moein98/heimdall/MACH3_SIMPLE/README.md

# MACH3-SIMPLE (revision A1)

A Mach3 parallel-port breakout board: six buffered step/dir axes, six 24 V
sensor inputs, a handwheel switched between jog and THC, six relays driven
over RS232 by an ATmega328P, and an isolated 0-10 V spindle-speed output with
FWD / REV for a VFD. It reproduces a board already in service and matches its
connector positions. It takes one supply, 24 V; the 5 V rail is made on the
board. Apart from the VFD port there is no galvanic isolation.

| Folder | What is in it |
|---|---|
| `fab/` | **What goes to the board house.** `MACH3SIMPLE-gerbers.zip` (2 layers, 1.6 mm FR4, 1 oz, 150.5 x 137.9 mm), BOM, pick-and-place, PDFs |
| `hardware/` | The KiCad 10 project: `MACH3SIMPLE.kicad_pro` |
| `firmware/` | AVR C source; `build/mach3simple.hex` is the built firmware |
| `docs/` | `SPEC.md` - what the board is and why; `COMMISSIONING.md` - bring-up and test, step by step (Persian) |
| `tools/` | The scripts that generate, check and route the design |
| `review/` | ERC/DRC reports, netlist, schematic PDF, board renders |

## What changed from A0

| | A0 | A1 |
|---|---|---|
| Supplies | 5 V and 24 V, each on its own terminal | **24 V only.** An LM2596S-5.0 buck (`U4`) makes +5V, in the top-right corner beside the 24 V input |
| Relay drivers | 2N7002 drain and source swapped - every relay **stuck on** | Fixed. `check_design.py` now checks every MOSFET's source is on ground |
| Top-edge terminal legends | Printed in reverse: `+24` over 0V, `+5` over the handwheel's B, `EMG` over X home | Fixed: the signals follow the legends, which follow the board in service |
| Input optocouplers | PC847 on a SOIC-16 footprint, which no PC847 fits | SMD DIP-16 (2.54 mm), the package PC847 comes in |
| Opto LED protection | Promised in the notes, missing from the circuit | A reverse diode across every input LED (`D20`-`D25`) |
| Spindle | - | **New:** isolated 0-10 V (`AVI`/`ACM`) and FWD/REV/AUX (`FWD`/`REV`/`AUX`/`DCM`) on `J5`, from port 2 pins 7, 8, 9, 6 |

A1 then had a design review of its own, which added:

| | |
|---|---|
| Relay terminals | legends printed on the back (`RELAY A`, `NO COM NC` under each screw) and `RELAY A`-`F` on the front; A0/A1 had them on F.Fab only, which is not printed |
| Relay LED resistors | 10k instead of 4k7 - 4k7 on 24 V was 103 mW in a 100 mW 0603 |
| Axis buffers | 74AC245 (same pads): 24 mA per output for opto-input drivers |
| Sensor supply | `J4` is four screws: `+24 0V` for the sensors (fused) and `+24 0V` in |
| C2 | 47 uF 50 V - a 100 uF 50 V part does not come in a 6.3 x 7.7 can |
| Labels | `5V`, `24V`, `SERIAL`, relay letters, `10V ADJ` instead of bare designators; a dashed line round the isolated VFD side |
| Test points | `GND` `5V` `24V`, and on the VFD side `ACM` `12V` `AVI` |
| Buck switch node | drawn by hand on the top layer, 14 mm and no vias (was 17 mm with two) |
| Handwheel +5 V | through a 200 mA resettable fuse (`F3`) |
| MCU reset | 10 nF against relay noise |
| VFD `AUX` | the spare optocoupler channel as a fourth VFD contact, port 2 pin 6 |

## Regenerating

The schematic and board are generated by scripts, not drawn by hand. To change
the design, edit `tools/build_project.py` or `tools/build_pcb.py` and
regenerate; an edit made in KiCad is lost at the next regeneration.

    python tools/build_project.py                  # schematic
    D:/KiCad/bin/python.exe tools/build_pcb.py --force   # placement (discards routing)
    D:/KiCad/bin/python.exe tools/autoroute.py export    # then Freerouting, then:
    D:/KiCad/bin/python.exe tools/autoroute.py import
    D:/KiCad/bin/python.exe tools/autoroute.py vfd-export  # then Freerouting on the _vfd DSN
    D:/KiCad/bin/python.exe tools/autoroute.py vfd-import
    D:/KiCad/bin/python.exe tools/autoroute.py stitch
    KICAD_CLI=D:/KiCad/bin/kicad-cli.exe sh tools/validate.sh
    KICAD_CLI=D:/KiCad/bin/kicad-cli.exe sh tools/fab.sh

`build_pcb.py` needs the netlist that `validate.sh` exports (`review/net.net`),
so after a schematic change run `validate.sh` once before placing. It prints
which signal lands under each word of every top-edge legend - read those lines.

## Firmware

`sh firmware/build.sh` runs the tests and builds the hex;
`sh firmware/build.sh flash` also sets the fuses and programs the chip through
the ICSP header `J60` with a USBasp. Serial is 9600 8N1. Commands, sent with
Mach3's `SendSerial`: `A`-`F` relay on, `a`-`f` off, `T` handwheel to THC,
`t` handwheel to jog, `?` status. A1 needs no firmware change.

## Spindle, in Mach3

Port 2 pin 7 is the spindle PWM pin (PWMBase Freq 100 Hz), pin 8 is Output #1
(M3, FWD) and pin 9 Output #2 (M4, REV), all active high. Trim `RV1` for
10.0 V at full PWM. Pin 6 can be Output #3, for `AUX`. `docs/COMMISSIONING.md`,
steps 6 to 8, has the settings.

`mach3 rs232 inputs 6 outputs 6 - pulse 5v - pnp sens.pdf` is the assembly
drawing of the board in service that the layout was copied from.
