moein98/heimdall/MACH3_SIMPLE_ETH/docs/SPEC.md

# MACH3-SIMPLE-ETH - specification (draft 0)

MACH3-SIMPLE with the parallel ports replaced by Ethernet. The PC no longer
makes step pulses: an RP2350B on the board runs grblHAL, plans the motion and
makes the pulses itself, and the PC (or a tablet, or nothing, from SD card)
only sends G-code and shows status.

This draft fixes the architecture and the pin map, proves the pin map with a
real grblHAL build (`firmware/grblHAL/build.sh`), and has a schematic
(`hardware/`, generated by `tools/build_project.py`) that passes ERC and is
checked against the board map GPIO by GPIO. There is no board layout yet.

## What it keeps from A1

- 24 V single supply, 5 V made on board (LM2596S-5.0), same input terminal.
- Opto-isolated 24 V sensor inputs (PC847, reverse diode across each LED).
- Buffered 5 V step/dir outputs on 3-way terminals, PUL / 0V / DIR.
- Six relays with their terminal legends.
- The isolated VFD port: 0-10 V (`AVI`/`ACM`), `FWD`, `REV`, `AUX`, `DCM`,
  B2412S isolated supply, PC847 across the barrier, LM358 output, `RV1` trim.
- Handwheel, switchable between jog and THC.

## What changes

| | A1 | ETH |
|---|---|---|
| Link to the PC | two LPT ports + RS232 | **Ethernet** (W5500, 10/100), plus USB-C for setup |
| Motion | Mach3 on the PC | **grblHAL on the board**; PC runs any sender, or none |
| Axes | 6 | **8 independent, coordinated**: X Y Z A B C U V |
| Relays | ATmega328P over RS232, `SendSerial` | MCP23017 over I2C, G-code `M62`-`M65` |
| Spindle | 0-10 V from LPT PWM | same 0-10 V, **plus RS485 Modbus** for VFDs that take it |
| THC | handwheel lines to Mach3 | grblHAL plasma plugin: Arc OK, THC up, THC down |
| Handwheel | A/B lines to Mach3 | a small MCU reads it and jogs grblHAL over UART (MPG mode 2) |
| Stand-alone | no | SD card: run a job with no PC |
| UI | Mach3 | any grblHAL sender, the built-in web UI, or our own |

The ATmega328P and MAX232 go. So do the LPT connectors and the pull-ups on
their lines.

## Firmware

grblHAL, RP2040/RP2350 driver, board map `firmware/grblHAL/boards/my_machine_map.h`.
Built with `N_AXIS=8` and:

| Option | Setting | For |
|---|---|---|
| `ADD_ETHERNET` + `_WIZCHIP_ 5500` | on | Telnet (23), WebSocket, FTP |
| `WEBUI_ENABLE 3` | on | ESP3D-WebUI served from the board's flash |
| `SDCARD_ENABLE 1` | on | jobs from SD |
| `SPINDLE0` / `SPINDLE1` | `PWM0` / `MODVFD` | 0-10 V spindle, Modbus spindle; picked with `$395` |
| `MODBUS_ENABLE 2` | stream 0, DE/RE on aux out 0 | RS485 |
| `MPG_ENABLE 2`, `MPG_STREAM 1` | UART1 | handwheel MCU; `0x8B` toggles MPG mode |
| `PLASMA_ENABLE 1` | on | THC |
| `MCP23017_ENABLE 1` | port A out, port B in | relays, spare inputs |

Checked in the build, not only in the source: `N_MOTORS == 8`,
`MPG_STREAM == 1`, `MODBUS_RTU_STREAM == 0`, V axis on GP9 / GP17 / GP33, and
the plasma, MCP23017, WebUI, SD, W5500, Telnet, WebSocket, FTP and Modbus
code all linked in. Flash 527 KB, RAM 110 KB static, of 520 KB.

`N_AXIS` must come from CMake (`-DN_AXIS=8`, `cmake-n-axis.patch`), not from
`my_machine.h`. Some driver files include `grbl.h` before `my_machine.h` and
were built for 3 axes when it was set there - the image was 25 KB smaller and
would have mixed 3-axis and 8-axis structures.

## RP2350B pin map

All 48 GPIO are used. Pins that grblHAL needs consecutive are marked.

| GPIO | Signal | Notes |
|---|---|---|
| 0, 1 | UART0 TX, RX | RS485 transceiver, Modbus VFD |
| 2-9 | STEP X Y Z A B C U V | PIO, **consecutive** |
| 10-17 | DIR X Y Z A B C U V | **consecutive** (`GPIO_SHIFT10`) |
| 18 | ENABLE | all drivers |
| 19 | SD CS | |
| 20-23 | SPI0 MISO, W5500 CS, SCK, MOSI | W5500 and SD share SPI0 |
| 24 | W5500 INT | |
| 25 | RS485 DE/RE | aux output 0 |
| 26-33 | LIMIT X Y Z A B C U V | |
| 34 | E-STOP | grblHAL reset input |
| 35 | FEED HOLD | |
| 36 | CYCLE START | |
| 37 | PROBE | |
| 38 | ARC OK | plasma plugin |
| 39 | THC UP | plasma plugin |
| 40 | THC DOWN | plasma plugin |
| 41 | SPINDLE PWM | to the isolated 0-10 V stage |
| 42, 43 | UART1 TX, RX | handwheel MCU |
| 44 | SPINDLE ENABLE | VFD `FWD` |
| 45 | SPINDLE DIR | VFD `REV` |
| 46, 47 | I2C1 SDA, SCL | MCP23017, optional FRAM |

W5500 reset is on the board reset, so it needs no GPIO. Every alternate
function above was checked against the SDK's pin-function table
(`io_bank0.h`): UART0 on 0/1, UART1 on 42/43, SPI0 on 20-23, I2C1 on 46/47.
GP44/45 look like UART1 by the RP2040 pattern but are UART0 on the
RP2350B - the first draft had that wrong.

MCP23017 port A: relays A-F, spindle `AUX`, status LED. Port B: 8 spare
inputs (door, tool setter, ...).

## Circuit notes for the schematic

- **3.3 V logic.** The RP2350 is a 3.3 V part. A1's 74AC245 and 74HC14 see
  3.3 V as low-ish (V<sub>IH</sub> 3.5 V at 5 V supply). Use **74ACT245**
  (TTL thresholds, 24 mA) for step/dir, three of them for 17 lines, and
  **74HCT14** in the spindle channel.
- **Inputs.** 15 opto inputs (8 limits, E-stop, hold, start, probe, Arc OK,
  THC up, THC down) = four PC847, one channel spare. Pull-ups to **3.3 V**,
  not 5 V.
- **Relays.** MCP23017 on 3.3 V gives a 3.3 V gate: use a logic-level FET
  (AO3400A class) instead of 2N7002.
- **Power.** 24 V -> LM2596S-5.0 (as A1) -> 3.3 V LDO, 800 mA class. W5500
  alone is about 130 mA. The RP2350's core supply is its internal switcher:
  3.3 uH inductor and the layout from the RP2350 hardware design guide.
- **Clock and flash.** 12 MHz crystal, W25Q128 (16 MB) QSPI flash, matching
  the `pimoroni_pga2350` board file the firmware is built with.
- **Ethernet.** W5500, 25 MHz crystal, a magjack with integrated magnetics
  (HR911105A class), the W5500 reference layout for the differential pairs.
- **Handwheel.** A small MCU (an RP2040, or an ATmega328P as on A1) reads the
  quadrature wheel and axis/step switches and sends jog commands on UART1.
  grblHAL's RP driver has no quadrature input of its own for this.
- **ESD / EMC.** TVS on the Ethernet and RS485 lines; the RS485 port gets a
  termination jumper.

## LinuxCNC

Remora (LinuxCNC firmware for microcontrollers) has no RP2350 port. Its
RP2040 + W5500 port builds for RP2350A and RP2350B after renaming three
interrupt constants (`firmware/remora/remora-rp2350.patch`). It is untested on
hardware, its pins would need remapping to this board, and its step
generator tops out near 20 kHz per axis (40 kHz base thread) against grblHAL's
hundreds of kHz from PIO. It is an option for later, not a design goal.

## Licences

grblHAL is GPLv3: firmware shipped on a board must come with its source. A
UI that talks to the board over the network is a separate program and is not
bound by that. Reference designs looked at: PicoCNC (MIT), PicoBOB-DLX and
Flexi-HAL (CERN-OHL-S, copying circuits from them makes this board
CERN-OHL-S too). Nothing has been copied from them. The RP2350 and W5500
circuits follow WIZnet's published W5500-EVB-Pico2 reference schematic and
Raspberry Pi's minimal design - vendor reference circuits, drawn anew here.
RP23CNC (licence unstated) was read for approach only.

## Schematic (ETH-0)

Eight sheets, 337 parts, 291 nets, generated by `tools/build_project.py` in the
style of A1 (every pin to a global label; symbols from KiCad's own library).

| Sheet | Contents | Reference |
|---|---|---|
| 1 Power | 24 V in, fuse, reverse diode, TVS (A1); LM2596S-5.0 (A1); AP7361C 3.3 V LDO; USB VBUS into +5V through a Schottky; rail LEDs; chassis 1 nF 2 kV | A1, W5500-EVB-Pico2 |
| 2 MCU | RP2350B, internal core regulator (3.3 uH), 12 MHz crystal, W25Q128 16 MB flash, RESET/BOOTSEL, USB-C with USBLC6, SWD, microSD | Raspberry Pi minimal design as W5500-EVB-Pico2 applies it |
| 3 Ethernet | W5500, 25 MHz crystal, ferrite-fed +3V3A, 49.9R/3.3R terminations, HR911105A magjack | W5500-EVB-Pico2 |
| 4 Outputs | three 74ACT245 on 5 V, 8 x STEP/GND/DIR terminals, ENABLE terminal, 10k pull-downs | A1; RP23CNC for 3.3 V into ACT/AHCT |
| 5 Inputs | 15 PC847 channels (4k7, anti-parallel diode, 4k7 to +3V3, 10 nF); LIMITS 8-way, EST HLD RUN PRB, THC AOK UP DN | A1 |
| 6 Relays | MCP23017 (0x20): relays A-F, spindle AUX, status LED, 8 spare inputs on a 2x5 header; AO3400A drivers; six A1 relay channels | A1 |
| 7 Spindle | the A1 isolated VFD block, 74HCT14 in front | A1 |
| 8 Comms | MAX3485 RS485 with 120R solder jumper and NUP2105L; ATmega328P at 3.3 V / 8 MHz for the MPG pendant (A/B, 8 axis selects, x1/x10/x100) on a 2x8 IDC | - |

`tools/validate.sh` (in the KiCad 10 container) runs:

- **ERC:** 0 errors. "Multiple net names" is treated as an error: it is KiCad's
  only report of two labelled nets joined by a stray wire. The first draft had
  two - power flags drawn with a bare wire had joined +1V1 to +3V3 and +3V3A to
  GND - and they are why the flags now go through the same collision-checked
  stub as every other pin. One accepted warning: MAX3485 is a derived symbol
  (`extends LTC2850xS8`) and is embedded flattened.
- **`check_pinmap.py`:** reads the netlist and the grblHAL board map and
  compares all 48 GPIO. It then follows 62 signals to the pins they must reach
  (SPI to the W5500 and the SD card, UART1 to the handwheel MCU's RXD/TXD, each
  STEP/DIR through a buffer to its terminal, each input to its opto, pull-up
  and filter, the relays to GPA0-5, ...) and fails on any net with one node.
  Tested by breaking it: swapping GP42/43 in the netlist and moving
  `AUXINPUT4_PIN` in the board map both fail it.

Every power pin of the RP2350B, W5500, MCP23017, flash and ATmega was also
checked in the netlist to land on its own rail.

### Open points for the layout and the first build

- **W5500 RSVD pins** (23, 38-42) go to GND. KiCad types them as inputs and
  the datasheet asks for GND; WIZnet's own W5500-EVB-Pico2 leaves them open.
  Safe either way for an input - worth a look at the datasheet before layout.
- **USB-only power** back-feeds the LM2596's output at about 4.7 V. Fine for
  flashing; the buck's datasheet should be checked for reverse current into
  VIN, or a second Schottky added in the buck output.
- **Probe input** is a 24 V opto channel like the others. A 5 V touch plate
  needs its own supply or a separate low-voltage input.
- **RP2350 layout** goes by the hardware design guide: the regulator loop
  (pins 62-65, L201, C201, C202) and the crystal are the parts that bite.

## Next

1. Board layout: same 24 V corner and VFD corner as A1; Ethernet and USB
   where the LPT ports were.
2. Handwheel MCU firmware (ATmega328P, UART1 to grblHAL, MPG mode 2).
3. Our own UI: can start now against the grblHAL simulator, before hardware.
