moein98/heimdall/MACH3_SIMPLE/review/layout_bottom.png

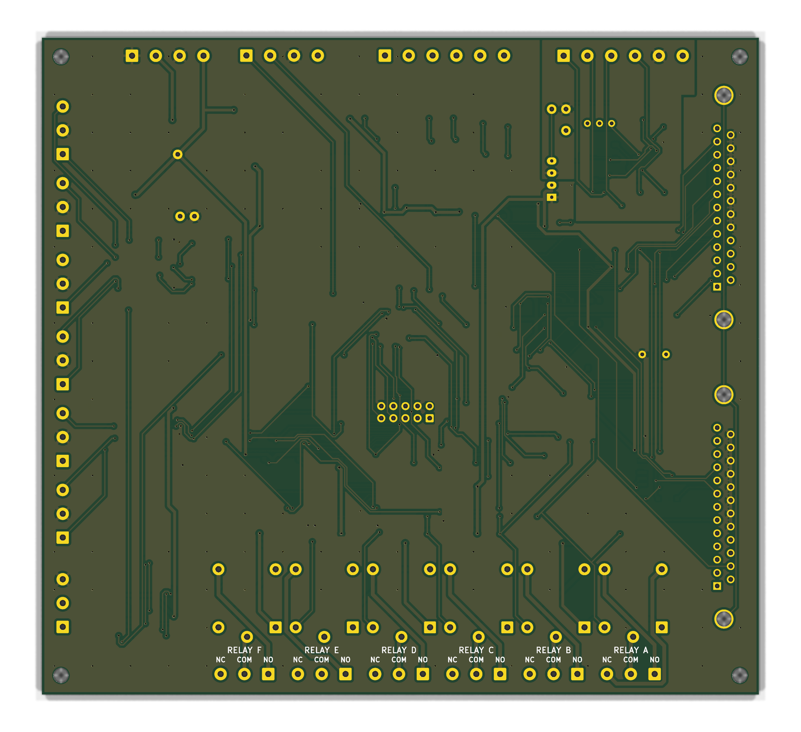
MACH3_SIMPLE/review/layout_bottom.png
