moein98/heimdall/MACH3_SIMPLE/review/layout_top.png

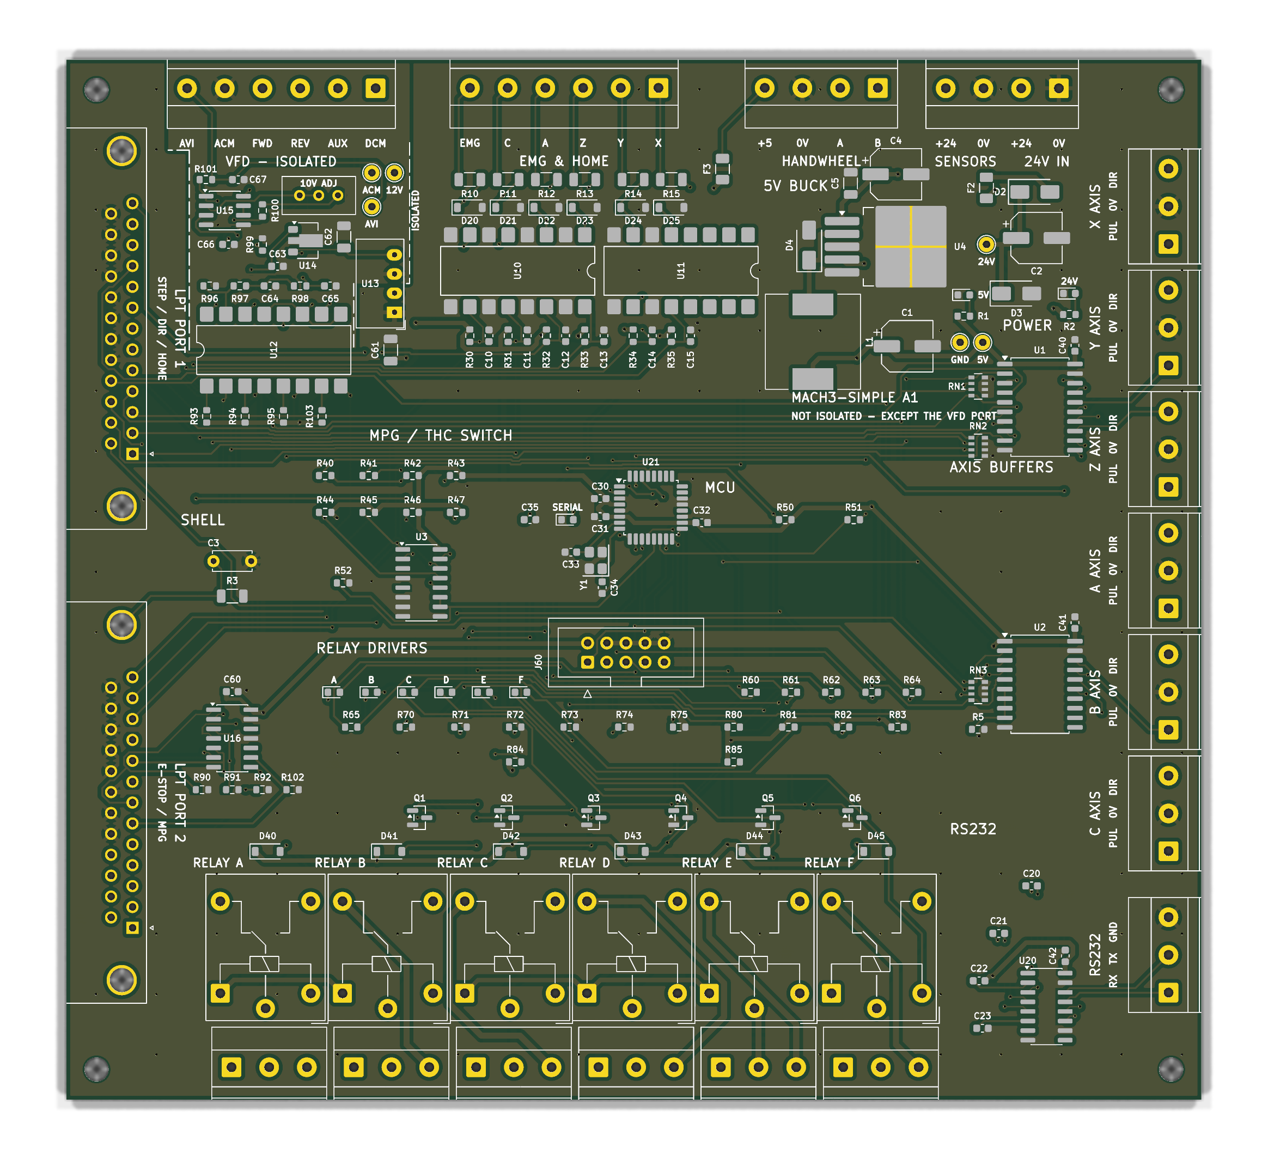
MACH3_SIMPLE/review/layout_top.png
