moein98/heimdall/MACH3_SIMPLE/docs/COMMISSIONING.md

# MACH3-SIMPLE A1 — راه‌اندازی و تست

این برد هنوز ساخته نشده. ترتیب زیر برای این است که اگر چیزی خراب بود، **در هر مرحله فقط یک چیز بتواند خراب باشد**. همه را با هم وصل و روشن نکنید.

برد دو نیمه دارد که جدا تست می‌شوند:

- **نیمهٔ الف — بدون فرم‌ور.** تغذیه (۲۴ ولت و باک ۵ ولت)، شش ورودی، شش خروجی محور، مسیر دسته‌فرمان، لایهٔ فیزیکی RS232، و خروجی اسپیندل (۰ تا ۱۰ ولت و FWD/REV). همهٔ این‌ها مدار خالص‌اند و **به محض مونتاژ قابل تست‌اند**، حتی با MCU خالی.
- **نیمهٔ ب — با فرم‌ور.** شش رله و سوییچ دسته‌فرمان بین jog و THC. فرم‌ور در `firmware/` است و از هدر `J60` با USBasp روی MCU ریخته می‌شود.

> **در این سند ترمینال‌ها با نوشتهٔ روی برد (سیلک) نام برده می‌شوند، نه با شمارهٔ پین.** روی ترمینال‌های لبهٔ بالا شمارهٔ پین از راست به چپ است؛ نوشتهٔ زیر هر پیچ ملاک است.

---

## وسایل لازم

| | |
|---|---|
| مولتی‌متر | ولت DC، اهم، تست دیود، و بوق اتصال |
| منبع تغذیه با محدودکنندهٔ جریان | **فقط ۲۴ ولت**. **محدودکننده ضروری است** |
| یک سیم جامپر و یک مقاومت 1k | برای شبیه‌سازی سیگنال‌ها بدون PC |
| PC با پورت موازی و Mach3 | برای مرحلهٔ ۸ |
| مبدل USB به RS232 | برای نیمهٔ ب |
| USBasp و کابل ۱۰ پایه | برای ریختن فرم‌ور، مرحلهٔ ۹ |
| اسیلوسکوپ | اختیاری؛ برای دیدن پالس‌های PUL و گره SW باک |

---

## یک نکته دربارهٔ ولتاژها

برد فقط **یک** تغذیه می‌گیرد: ۲۴ ولت روی ترمینال `J4`. ترمینال ۵ ولت نسخهٔ قبل حذف شده؛ ۵ ولت را باک `U4` (LM2596S-5.0) روی خود برد می‌سازد.

`J4` چهار پیچ دارد، چپ به راست: `+24` `0V` زیر نوشتهٔ **SENSORS**، و `+24` `0V` زیر نوشتهٔ **24V IN**.
- **24V IN** (دو پیچ راست): سیم منبع تغذیه. همان جای ترمینال ۲۴ ولت برد قبلی.
- **SENSORS** (دو پیچ چپ): تغذیهٔ سنسورهای PNP. این ۲۴ ولت از فیوز `F2` و دیود `D2` رد شده، پس اتصال کوتاه در کابل سنسور فیوز را می‌سوزاند، نه منبع را.

**نقطه‌های تست** (حلقه‌های مسی با نوشته): `GND`، `5V` و `24V` در گوشهٔ تغذیه؛ `ACM`، `12V` و `AVI` در بخش ایزولهٔ VFD.

| ریل | روی برد | کجا اندازه بگیرید |
|---|---|---|
| ۲۴.۰ V روی `24V IN` | **حدود ۲۳.۶ V** (افت دیود سری `D2`) | نقطهٔ تست `24V` نسبت به `GND` |
| +5V | **۴.۸ تا ۵.۲ V** | نقطهٔ تست `5V` نسبت به `GND` |
| سمت VFD (ایزوله) | **۱۲ تا ۱۴ V** | نقطهٔ تست `12V` نسبت به نقطهٔ تست `ACM` — **نه** GND برد |

> بخش اسپیندل از بقیهٔ برد **ایزوله** است. زمین آن (`ACM` و `DCM` روی `J5`) به GND برد وصل نیست. برای اندازه‌گیری در این بخش، سیم منفی مولتی‌متر را روی `ACM` بگذارید.

---

## مرحلهٔ ۰ — بدون برق

**بازرسی چشمی:**
- جهت خازن‌های الکترولیتی `C1`، `C2` و `C4` (علامت + روی سیلک)
- جهت دیودهای `D2`، `D3` و **`D4`** (نوار روی بدنه). `D4` دیود باک است؛ اگر برعکس باشد، با اولین روشن شدن ۲۴ ولت را اتصال کوتاه می‌کند
- پین ۱ همهٔ آی‌سی‌ها: `U1`، `U2`، `U3`، `U10`، `U11`، `U12`، `U14`، `U15`، `U16`، `U20`، `U21`
- `U13` (ماژول ایزوله B2412S): پین ۱ روی پد مربعی
- لحیم پین‌های ریز `U21` (MCU، گام ۰.۸ میلی‌متر) — زیر ذره‌بین، دنبال پل لحیم

**اهم‌متر:**

| بین | باید | اگر نبود |
|---|---|---|
| دو سر `C2` (V24 و GND) | اول کم، بعد بالا می‌رود (خازن شارژ می‌شود)؛ آخرش بالای ۱ کیلواهم | اتصال کوتاه روی ۲۴ ولت |
| دو سر `C1` (+5V و GND) | همان | اتصال کوتاه روی +5V — معمولاً پل لحیم روی یک آی‌سی |
| +5V و V24 | اتصال کوتاه نباشد | خیلی جدی — روشن نکنید |
| نقطهٔ تست `ACM` و نقطهٔ تست `GND` | **باز** (چند مگااهم یا بیشتر) | ایزولاسیون بخش اسپیندل شکسته؛ دنبال پل لحیم دور `U12`/`U13` بگردید |
| پیچ `DCM` روی `J5` و نقطهٔ تست `GND` | **باز** | همان |

---

## مرحلهٔ ۱ — روشن کردن با ۲۴ ولت

منبع را روی **۲۴ V با محدودیت ۲۰۰ mA** بگذارید و به دو پیچ راست `J4` (زیر **24V IN**) وصل کنید.

| انتظار | اگر نبود |
|---|---|
| جریان **۲۰ تا ۶۰ mA** | اگر بلافاصله به سقف ۲۰۰ رسید: فوراً قطع کنید. اول جهت `D4`، بعد `C1`/`C4`، بعد پل لحیم |
| LED با نوشتهٔ `24V` و LED با نوشتهٔ `5V` روشن | `D11` خاموش: `F2`/`D2`. `D10` خاموش: باک — `U4`، `L1`، `D4` |
| دو سر `C2`: حدود **۲۳.۶ V** | خیلی کمتر: `D2` برعکس |
| نقطهٔ تست `5V`: **۴.۸ تا ۵.۲ V** | صفر: `U4` کار نمی‌کند (پین ۵ باید به زمین لحیم باشد) یا `L1` لحیم نیست |
| **هیچ رله‌ای صدا نمی‌دهد**، `D50` تا `D55` خاموش | با MCU خالی، `R70` تا `R75` گیت ماسفت‌ها را پایین نگه می‌دارند. اگر رله‌ای روشن شد، جهت `Q` یا مقاومت گیتِ همان کانال را ببینید |
| سمت VFD: نقطهٔ تست `12V` نسبت به `ACM` حدود **۱۲ تا ۱۴ V**؛ دو سر `C63` **۵.۰ V** | صفر: `U13` (ماژول ایزوله) یا `U14` |
| نقطهٔ تست `AVI` نسبت به `ACM`: **۰ V** | اگر ولتاژ دارد: کانال PWM بی‌جهت روشن است — `R90`، `U16` |

> در نسخهٔ A0 روی این مرحله هر شش رله روشن می‌شدند و خاموش نمی‌شدند (ماسفت‌ها برعکس بودند). در A1 اصلاح شده و `tools/check_design.py` جلوی تکرارش را می‌گیرد.

---

## مرحلهٔ ۲ — ورودی‌ها، بدون PC

هر ورودی وقتی ۲۴ ولت رویش باشد، پینِ متناظر روی پورت موازی را **پایین** می‌کشد.

مولتی‌متر را بین پینِ DB25 و GND بگذارید (منفی روی نقطهٔ تست `GND`). در حالت عادی باید حدود **۵.۰ V** ببینید. حالا با سیم جامپر، ۲۴ ولت (پیچ `+24` زیر **SENSORS**) را به پیچ مربوط روی `EMG & HOME` وصل کنید — ولتاژ باید به **زیر ۰.۳ V** بیفتد.

| پیچ روی `EMG & HOME` (چپ به راست) | پورت | پین DB25 |
|---|---|---|
| `EMG` | پورت ۲ (`J2`) | 15 |
| `C` | پورت ۱ (`J1`) | 15 |
| `A` | پورت ۱ (`J1`) | 13 |
| `Z` | پورت ۱ (`J1`) | 12 |
| `Y` | پورت ۱ (`J1`) | 11 |
| `X` | پورت ۱ (`J1`) | 10 |

هر ورودی فعال حدود **۴.۸ mA** از ۲۴ ولت می‌کشد. سنسور PNP شما باید این جریان را بدهد.

> **این برد برای ورودی‌ها LED ندارد.** وضعیت ورودی‌ها را با مولتی‌متر یا صفحهٔ Diagnostics در Mach3 ببینید.

---

## مرحلهٔ ۳ — خروجی محورها، بدون PC

**اول، بدون هیچ چیزی روی پورت ۱:** همهٔ پیچ‌های PUL و DIR روی ترمینال‌های محور باید **۰ V** باشند. این مقاومت‌های pull-down (`RN1` تا `RN3`) را تست می‌کند — همان‌هایی که جلوی پالس ساختگی را وقتی PC خاموش است می‌گیرند.

**بعد، هر کانال:** یک سیم با **مقاومت ۱ کیلواهم سری** از نقطهٔ تست `5V` به پینِ DB25 بزنید. پیچ متناظر روی ترمینال محور باید به **حدود ۵.۰ V** برود.

| محور | ترمینال | DB25 (`J1`) پین PUL | DB25 پین DIR |
|---|---|---|---|
| X | `J10` | 1 | 2 |
| Y | `J11` | 3 | 4 |
| Z | `J12` | 5 | 6 |
| A | `J13` | 7 | 8 |
| B | `J14` | 9 | 14 |
| C | `J15` | 17 | 16 |

روی هر ترمینال محور، نوشتهٔ کنار پیچ‌ها: `PUL`، `0V`، `DIR`.

> **بافرها `74AC245` هستند، نه `74HC245`.** ورودی اپتوی درایورهای استپر ۱۰ تا ۱۵ mA می‌کشد و 74HC245 برای هر خروجی حدود ۶ mA و برای کل تراشه ۷۰ mA طراحی شده؛ هشت خروجی از آن بیشتر است. 74AC245 همان پایه‌ها را دارد و هر خروجی ۲۴ mA می‌دهد. اگر فقط 74HC245 پیدا کردید، درایورهایی را که کمتر از ۶ mA می‌کشند می‌توانید با آن راه بیندازید.

---

## مرحلهٔ ۴ — دسته‌فرمان، بدون فرم‌ور

با MCU خالی، `R52` خط انتخاب (`MPG_SEL`) را پایین نگه می‌دارد، پس دسته‌فرمان در **حالت jog** است: A به پورت ۲ پین ۱۲ می‌رود و B به پین ۱۳.

- `J2` پین ۱۲ و ۱۳ در حالت عادی: **۵.۰ V**
- پیچ `A` روی `HANDWHEEL` را به زمین وصل کنید → `J2` پین ۱۲ به **حدود ۰.۲ V** می‌افتد
- پیچ `B` را به زمین وصل کنید → `J2` پین ۱۳ همین‌طور
- `J2` پین ۱۰ و ۱۱ (THC) باید در تمام این مدت **۵.۰ V بمانند**

اگر به‌جای ۱۲/۱۳، پین‌های ۱۰/۱۱ تکان خوردند، خط انتخاب بالاست: `R52` لحیم نشده، یا `MPG_SEL` به +5V اتصال دارد.

> در A0 نوشته‌های این ترمینال برعکس چاپ شده بود (`+5` روی پیچ B). اگر انکودر را از روی یک بورد A0 سیم‌کشی کرده‌اید، دوباره نگاه کنید.

---

## مرحلهٔ ۵ — RS232، فقط لایهٔ فیزیکی

بدون فرم‌ور هم می‌شود دید که MAX3232 زنده است:

| کجا | انتظار | معنی |
|---|---|---|
| `U20` پین ۲ (V+) | حدود **+۵.۵ V** | پمپ بار کار می‌کند |
| `U20` پین ۶ (V−) | حدود **−۵.۵ V** | همان |
| پیچ `TX` روی `J50` نسبت به `GND` | حدود **−۵.۵ V** | خط در حالت بیکار (mark) است |

اگر V+ یا V− صفر بود، یکی از خازن‌های پمپ (`C20` تا `C23`) لحیم نشده یا برعکس است.

---

## مرحلهٔ ۶ — خروجی اسپیندل، بدون PC

ترمینال `J5` با نوشتهٔ `VFD - ISOLATED`، چپ به راست: `AVI`، `ACM`، `FWD`، `REV`، `AUX`، `DCM`. روی برد، یک خط‌چین با نوشتهٔ `ISOLATED` دور این بخش کشیده شده.

| پیچ | به کجای VFD | چیست |
|---|---|---|
| `AVI` | ورودی آنالوگ ولتاژ (AVI / VI / AI1) | ۰ تا ۱۰ ولت، سرعت |
| `ACM` | زمین آنالوگ VFD (ACM / GND) | زمینِ بخش ایزوله |
| `FWD` | ورودی FWD | کنتاکت به `DCM` = چرخش مستقیم |
| `REV` | ورودی REV | کنتاکت به `DCM` = چرخش معکوس |
| `AUX` | یک ورودی چندکاره (X1، MI1، …) | کنتاکت به `DCM`؛ مثلاً ریست خطا یا سرعت ثابت — در VFD تعریفش کنید |
| `DCM` | زمین دیجیتال VFD (DCM / COM) | |

**همهٔ اندازه‌گیری‌ها با منفی مولتی‌متر روی `ACM` (برای ولتاژ) یا `DCM` (برای FWD/REV).**

1. **بدون هیچ چیز روی پورت ۲:** `AVI` = **۰ V**. بین `FWD` و `DCM` با تست دیود (قرمز روی `FWD`): **OL** (باز). همین برای `REV`.
2. **کالیبره کردن ۱۰ ولت:** یک سیم با **مقاومت ۱ کیلواهم** از +5V به **`J2` پین ۷** بزنید (یعنی PWM صددرصد). در کمتر از یک ثانیه `AVI` بالا می‌رود و بین **۸.۹ و ۱۱.۴ V** می‌ایستد. حالا `RV1` را بچرخانید تا **دقیقاً ۱۰.۰ V** شود. سیم را بردارید؛ `AVI` به صفر برمی‌گردد.
3. **جهت:** همان سیم را به **`J2` پین ۸** بزنید → بین `FWD` و `DCM` در حالت تست دیود حدود **۰.۱ تا ۰.۳ V** (بسته). به **پین ۹** → همین برای `REV`. به **پین ۶** → همین برای `AUX`.

---

## مرحلهٔ ۷ — تنظیم VFD

هر VFD پارامترهای خودش را دارد؛ از دفترچهٔ آن این سه را پیدا کنید:

- **منبع فرکانس** = ورودی آنالوگ ولتاژ (۰ تا ۱۰ ولت روی AVI/VI)
- **منبع فرمان چرخش** = ترمینال‌های خارجی (FWD/REV، دوسیمه)
- **ورودی‌های دیجیتال** در حالت **NPN / sink** (تنظیم کارخانه در بیشتر VFDها). خروجی‌های `FWD`/`REV` این برد اپتوکوپلرند که ورودی را به `DCM` وصل می‌کنند، مثل یک کلید.

> **هرگز `ACM` یا `DCM` را به GND برد یا به زمین PC وصل نکنید.** کل فایدهٔ ایزولاسیون همین است که نویز VFD از این مسیر به پورت موازی نرسد.

---

## مرحلهٔ ۸ — با PC و Mach3

حالا کابل پورت‌های موازی را وصل کنید.

اگر پروفایل Mach3 شما با برد قبلی کار می‌کند، **دست نزنید** — پین‌های محورها، ورودی‌ها و دسته‌فرمان همان‌اند. فقط اسپیندل اضافه می‌شود.

- **ورودی‌ها:** ۲۴ ولت روی ترمینال → پین پورت **پایین**.
  - سوییچ home از نوع PNP که عادی باز است: وقتی فعال می‌شود پین پایین می‌رود → در Mach3 تیک **Active Low** بخورد.
  - دکمهٔ E-stop که عادی بسته است: در حالت عادی ۲۴ ولت هست و پین پایین است؛ فشرده که شود پین بالا می‌رود → برای EStop تیک Active Low **نخورد**.
- **خروجی‌ها:** مستقیم و بدون معکوس — هر چه Mach3 روی پین پورت بگذارد، روی ترمینال محور می‌آید.

### تنظیمات اسپیندل در Mach3

| کجا | چه |
|---|---|
| Config → Ports and Pins → **Motor Outputs** → Spindle | Enabled ✓، Step Port = **2**، Step Pin = **7**، Dir Pin = 0 |
| Ports and Pins → **Spindle Setup** → Relay Control | Disable Spindle Relays ✗، M3 → Output # **1**، M4 → Output # **2** |
| Spindle Setup → Motor Control | Use Spindle Motor Output ✓، **PWM Control** ✓، PWMBase Freq = **100**، Minimum PWM = 0 % |
| Ports and Pins → **Output Signals** | Output #1: Enabled، Port **2**، Pin **8**، Active Low ✗. Output #2: Port **2**، Pin **9**، Active Low ✗. (اختیاری) Output #3: Port **2**، Pin **6** برای `AUX` |
| Config → **Spindle Pulleys** | Max Speed = دور اسپیندل در ۱۰ ولت (حداکثر فرکانس VFD) |

**PWMBase Freq را بالای حدود ۵۰۰ نبرید.** فیلتر روی برد برای ۱۰۰ هرتز طراحی شده؛ اپتوکوپلر در فرکانس بالا لبه‌ها را گرد می‌کند و سرعت در دورهای خیلی کم و خیلی زیاد دقیق نمی‌ماند.

آزمایش: `M3 S` (نصف حداکثر) → `FWD` بسته، `AVI` حدود ۵ ولت. `M4` → `REV`. `M5` → هر دو باز و `AVI` صفر. E-stop هم همه را خاموش می‌کند.

در صفحهٔ **Diagnostics** مرحلهٔ ۲ را تکرار کنید؛ این بار LED ورودی باید در Mach3 روشن شود. بعد هر محور را jog کنید:
- **DIR:** با عوض شدن جهت، بین ۰ و ۵ ولت عوض می‌شود و ثابت می‌ماند
- **PUL:** موقع حرکت، مولتی‌متر DC عددی بین ۰ و ۵ نشان می‌دهد (میانگین پالس‌ها)؛ موقع توقف ۰.

---

## نیمهٔ ب — رله‌ها و سوییچ دسته‌فرمان: با فرم‌ور

این‌ها را MCU (`U21`، ATmega328P) انجام می‌دهد، با یک حرف که Mach3 از طریق `SendSerial` روی RS232 می‌فرستد. سرعت پورت: **`9600 8N1`**.

| فرمان | کار |
|---|---|
| `A` تا `F` | رلهٔ A تا F روشن |
| `a` تا `f` | رلهٔ A تا F خاموش |
| `T` | دسته‌فرمان به پین‌های THC (پورت ۲، پین ۱۰ و ۱۱) |
| `t` | دسته‌فرمان به پین‌های jog (پورت ۲، پین ۱۲ و ۱۳) |
| `?` | فقط گزارش وضعیت |

جواب هر فرمان یک خط وضعیت است، مثلاً `R:AbcdEf M:thc` — حرف بزرگ یعنی رلهٔ روشن. هر فرمان `D30` را یک لحظه خاموش می‌کند. هر حرف دیگری نادیده گرفته می‌شود و جوابی ندارد.

### مرحلهٔ ۹ — ریختن فرم‌ور

وسیله: **USBasp** با کابل ۱۰ پایه، روی `J60` (هدر استاندارد AVR ISP؛ فلش کابل روی پین ۱).

1. برد را با **۲۴ ولت** روشن کنید (USBasp را روی حالت «بدون تغذیه» بگذارید، یا جامپر تغذیه‌اش را بردارید).
2. روی PC:

       sh firmware/build.sh flash

   اسکریپت اول سه تست روی خود PC اجرا می‌کند؛ اگر یکی رد شود، چیزی روی تراشه نمی‌رود.
3. همین دستور فیوزها را هم برای کریستال ۱۶ مگاهرتز (`Y1`) می‌نویسد: low `FF`، high `D9`، extended `FD`.

> **قبل از برنامه‌ریزی، `Y1` و `C33`/`C34` باید لحیم و سالم باشند.** وقتی فیوز low روی کریستال رفت، تراشه بدون کریستال اصلاً کار نمی‌کند — حتی ICSP هم دیگر جواب نمی‌دهد.

| ببینید | انتظار |
|---|---|
| LED با نوشتهٔ `SERIAL` (`D30`) | بلافاصله بعد از برنامه‌ریزی **روشن و ثابت** |
| `avrdude` | `flash verified` |

اگر `avrdude` تراشه را نمی‌شناسد (`target doesn't answer`): جهت کابل و ۵ ولت برد را ببینید. اسکریپت خودش با سرعت کند (`-B 32`) کار می‌کند.

### مرحلهٔ ۱۰ — تست رله‌ها و سوییچ

برنامهٔ ترمینال (PuTTY یا RealTerm) روی مبدل USB-RS232، `9600 8N1`، به `J50`. برد را خاموش و روشن کنید:

| بفرستید | انتظار |
|---|---|
| — (روشن شدن) | ترمینال می‌نویسد `R:abcdef M:jog` |
| `A` | رلهٔ A صدا می‌دهد، LED با نوشتهٔ `A` روشن، روی ترمینال زیر `RELAY A` پیچ‌های `NO`–`COM` **اتصال**، `NC`–`COM` **قطع** (نوشته‌های NO/COM/NC پشت برد چاپ شده‌اند). جواب `R:Abcdef M:jog` |
| `a` | برعکس |
| `B`…`F` / `b`…`f` | همین برای `J41` تا `J45` و `D51` تا `D55` |
| `T` | در مرحلهٔ ۴، حالا پین‌های ۱۰/۱۱ تکان می‌خورند به‌جای ۱۲/۱۳. جواب `M:thc` |
| `t` | برمی‌گردد. جواب `M:jog` |
| `ABCDEF` یک‌جا | هر شش رله روشن، شش خط جواب |
| `x` | هیچ اتفاقی، هیچ جوابی |

آخر سر در Mach3 یک ماکرو با `SendSerial "A"` اجرا کنید؛ پورت سریال Mach3 هم باید `9600` باشد.

اگر برد جواب نمی‌دهد یا جوابش حروف درهم است: اول سرعت پورت (`9600`)، بعد فیوزها (`avrdude -c usbasp -p m328p -U lfuse:r:-:h` باید `0xff` بدهد)، بعد کریستال `Y1`.

### نقشهٔ پین MCU

| سیگنال | پین MCU | پورت |
|---|---|---|
| رلهٔ A | 1 | PD3 |
| رلهٔ B | 2 | PD4 |
| رلهٔ C | 9 | PD5 |
| رلهٔ D | 10 | PD6 |
| رلهٔ E | 11 | PD7 |
| رلهٔ F | 12 | PB0 |
| `MPG_SEL` (بالا = THC) | 13 | PB1 |
| LED سریال (`D30`) | 14 | PB2 |
| ICSP MOSI / MISO / SCK | 15 / 16 / 17 | PB3 / PB4 / PB5 |
| RESET | 29 | PC6 |
| کریستال (`Y1`) | 7 / 8 | XTAL1 / XTAL2 |
| UART RX | 30 | PD0 |
| UART TX | 31 | PD1 |

رله با **بالا** بردن پین روشن می‌شود. اگر برنامه گیر کند، watchdog بعد از ۱ ثانیه تراشه را ریست می‌کند؛ همهٔ رله‌ها خاموش و دسته‌فرمان روی jog.

هر رلهٔ روشن حدود **۱۷ mA** از ۲۴ ولت می‌کشد (سیم‌پیچ حدود ۱۵، LED حدود ۲). شش تا با هم: حدود ۱۰۰ mA.

> **جریان کنتاکت‌ها:** خود رله ۱۰ آمپر است، ولی تراک‌های برد حدود **۲.۴ آمپر**. باری که بیش از دو سه آمپر می‌کشد باید سیمش مستقیم به پایهٔ رله برود.

---

## عیب‌یابی

| نشانه | علت محتمل | کجا را ببینید |
|---|---|---|
| جریان ۲۴ ولت بلافاصله به سقف می‌رسد | دیود باک برعکس، خازن برعکس، اتصال کوتاه | `D4`، `C1`، `C4`، پل لحیم روی `U21` |
| `D11` خاموش | فیوز یا دیود سری | `F2`، `D2` |
| `D11` روشن، `D10` خاموش | باک ۵ ولت | `U4` (پین ۵ به زمین)، `L1`، `D4`، `C1` |
| +5V پایین‌تر از ۴.۷ ولت زیر بار | سلف اشباع شده یا خازن خروجی ضعیف | `L1` (جریان اشباع ≥ ۱.۵ A)، `C1` (low ESR) |
| یک ورودی اصلاً عوض نمی‌شود | مقاومت سری یا اپتو | `R10`–`R15`، `U10`/`U11` |
| یک ورودی همیشه پایین است | اپتو اتصال کوتاه، یا ۲۴ ولت همیشه رویش است | همان کانال |
| خروجی محور بدون PC شناور است | آرایهٔ pull-down | `RN1`–`RN3` |
| خروجی محور همیشه صفر | بافر یا پین DB25 | `U1`/`U2` |
| دسته‌فرمان روی پین‌های THC می‌آید | خط انتخاب بالاست | `R52`، `MPG_SEL` |
| TX روی RS232 صفر ولت | پمپ بار | `C20`–`C23` |
| رله با MCU خالی صدا می‌دهد | جهت ماسفت یا مقاومت گیت | `Q1`–`Q6`، `R70`–`R75` |
| `AVI` همیشه صفر | منبع ایزوله یا کانال PWM | `U13`، `U14`، `U12` کانال ۱، `R93`، `U16` |
| `AVI` با `RV1` به ۱۰ ولت نمی‌رسد | SP_12V پایین است | `U13`، `C62` |
| سرعت اسپیندل می‌لرزد | PWMBase Freq خیلی پایین | Mach3 → Spindle Setup، حدود ۱۰۰ |
| VFD به FWD/REV جواب نمی‌دهد | VFD در حالت PNP، یا منبع فرمان روی کی‌پد | پارامترهای VFD، سیم `DCM` |
| `avrdude`: `target doesn't answer` | کابل برعکس، برد بی‌برق، USBasp تند | `J60`، مرحلهٔ ۹ |
| دسته‌فرمان کار نمی‌کند و +5 روی `HANDWHEEL` صفر است | فیوز PTC `F3` قطع کرده (اتصال کوتاه در کابل دسته‌فرمان) | کابل را جدا کنید؛ `F3` بعد از چند ثانیه خودش وصل می‌شود |
| سنسورها برق ندارند ولی بقیهٔ برد کار می‌کند | سیم‌کشی سنسورها به پیچ‌های اشتباه | سنسورها به دو پیچ **SENSORS**، منبع به دو پیچ **24V IN** |
| `D30` بعد از برنامه‌ریزی خاموش | فرم‌ور اجرا نمی‌شود، یا LED برعکس | `D30`، مقاومت ریست `R50` |
| بدون جواب یا حروف درهم در ترمینال | سرعت پورت ≠ ۹۶۰۰، فیوز low ≠ `FF`، یا کریستال | `Y1`، `C33`، `C34`، مرحلهٔ ۱۰ |
| بعد از برنامه‌ریزی، ISP دیگر جواب نمی‌دهد | فیوز روی کریستال رفته، ولی کریستال کار نمی‌کند | لحیم `Y1` و `C33`/`C34` |
| رله صدا می‌دهد ولی `D5x` روشن نمی‌شود | LED یا مقاومتش | `D50`–`D55`، `R80`–`R85` |
| رله روشن است ولی کنتاکت وصل نمی‌کند | سیم‌کشی ترمینال رله | نوشته‌های `NO`/`COM`/`NC` |
