moein98/heimdall/MACH3_SIMPLE_ETH/review/MACH3SIMPLEETH_schematic.pdf

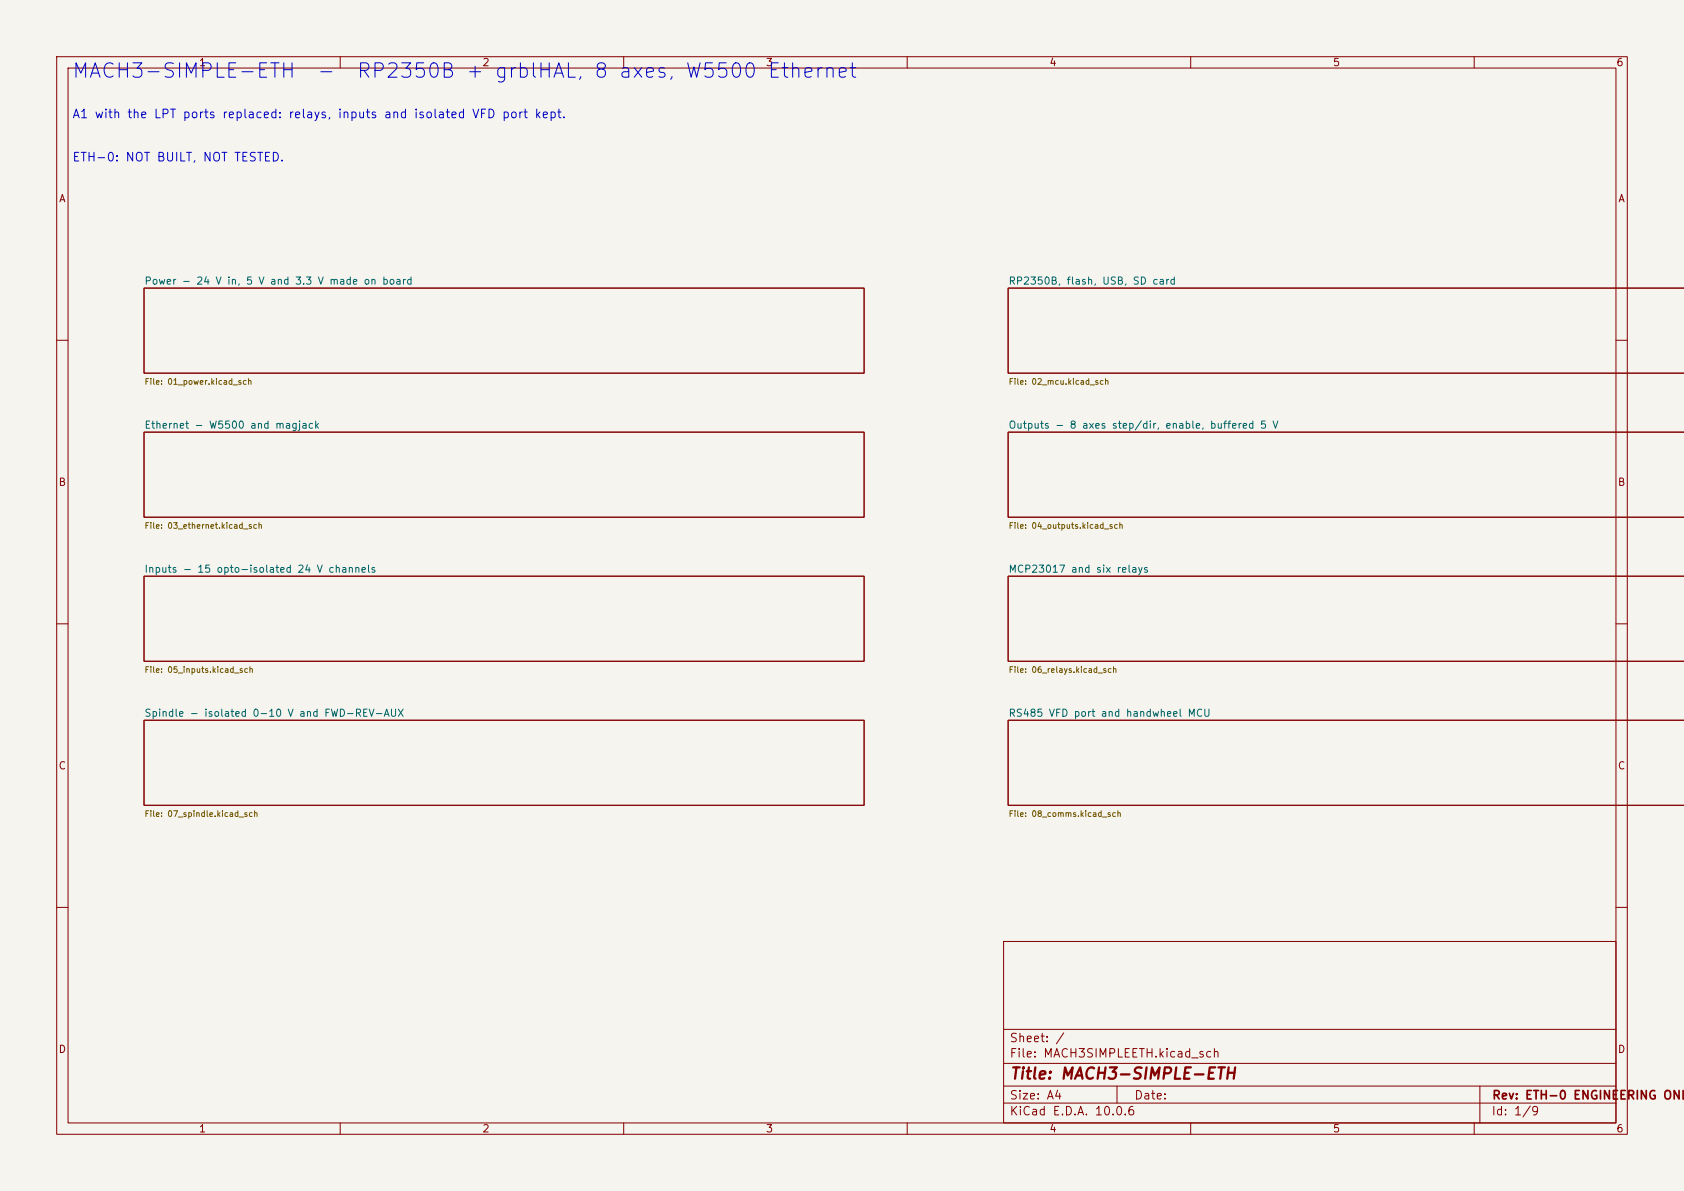
[picture p3: page 1]

File: 08_comms.kicad_sch MACH3-SIMPLE-ETH - RP2350B + grblHAL, 8 axes, W5500 Ethernet

A1 with the LPT ports replaced: relays, inputs and isolated VFD port kept.

ETH-0: NOT BUILT, NOT TESTED.

Power - 24 V in, 5 V and 3.3 V made on board

File: 01_power.kicad_sch Ethernet - W5500 and magjack

File: 02_mcu.kicad_sch Outputs - 8 axes step/dir, enable, buffered 5 V

Inputs - 15 opto-isolated 24 V channels

File: 06_relays.kicad_sch Spindle - isolated 0-10 V and FWD-REV-AUX

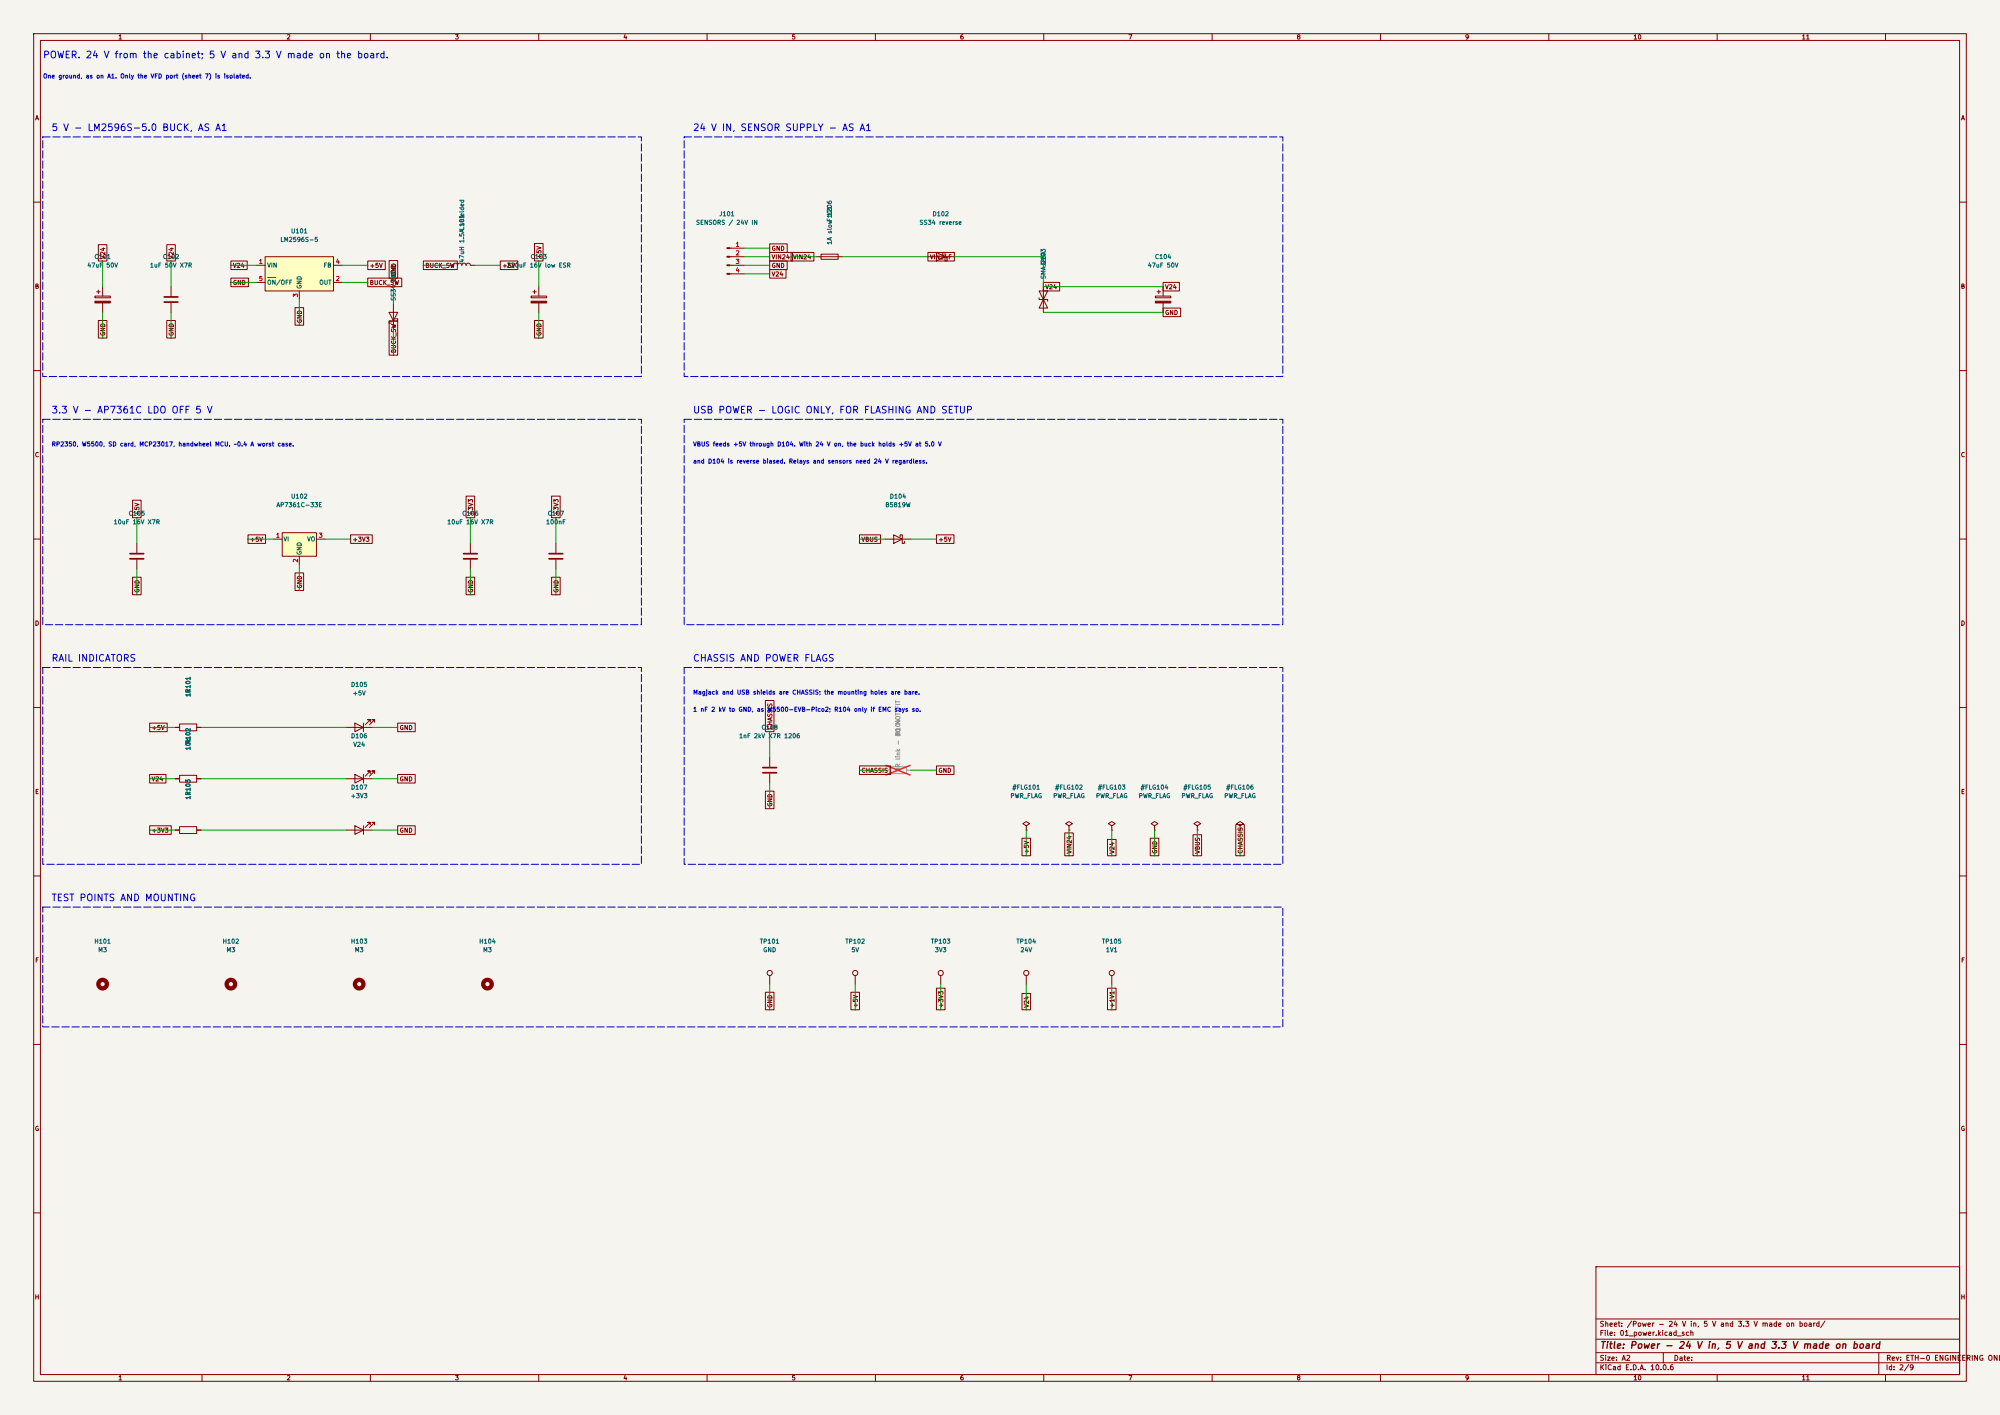
[picture p4: page 2]

POWER. 24 V from the cabinet; 5 V and 3.3 V made on the board.

One ground, as on A1. Only the VFD port (sheet 7) is isolated. 3.3 V - AP7361C LDO OFF 5 V

24 V IN, SENSOR SUPPLY - AS A1

and D104 is reverse biased. Relays and sensors need 24 V regardless. VBUS feeds +5V through D104. With 24 V on, the buck holds +5V at 5.0 V USB POWER - LOGIC ONLY, FOR FLASHING AND SETUP R102 10k R103 1k R101 1k

TEST POINTS AND MOUNTING

Sheet: /Power - 24 V in, 5 V and 3.3 V made on board/
File: 01_power.kicad_sch
Title: Power - 24 V in, 5 V and 3.3 V made on board

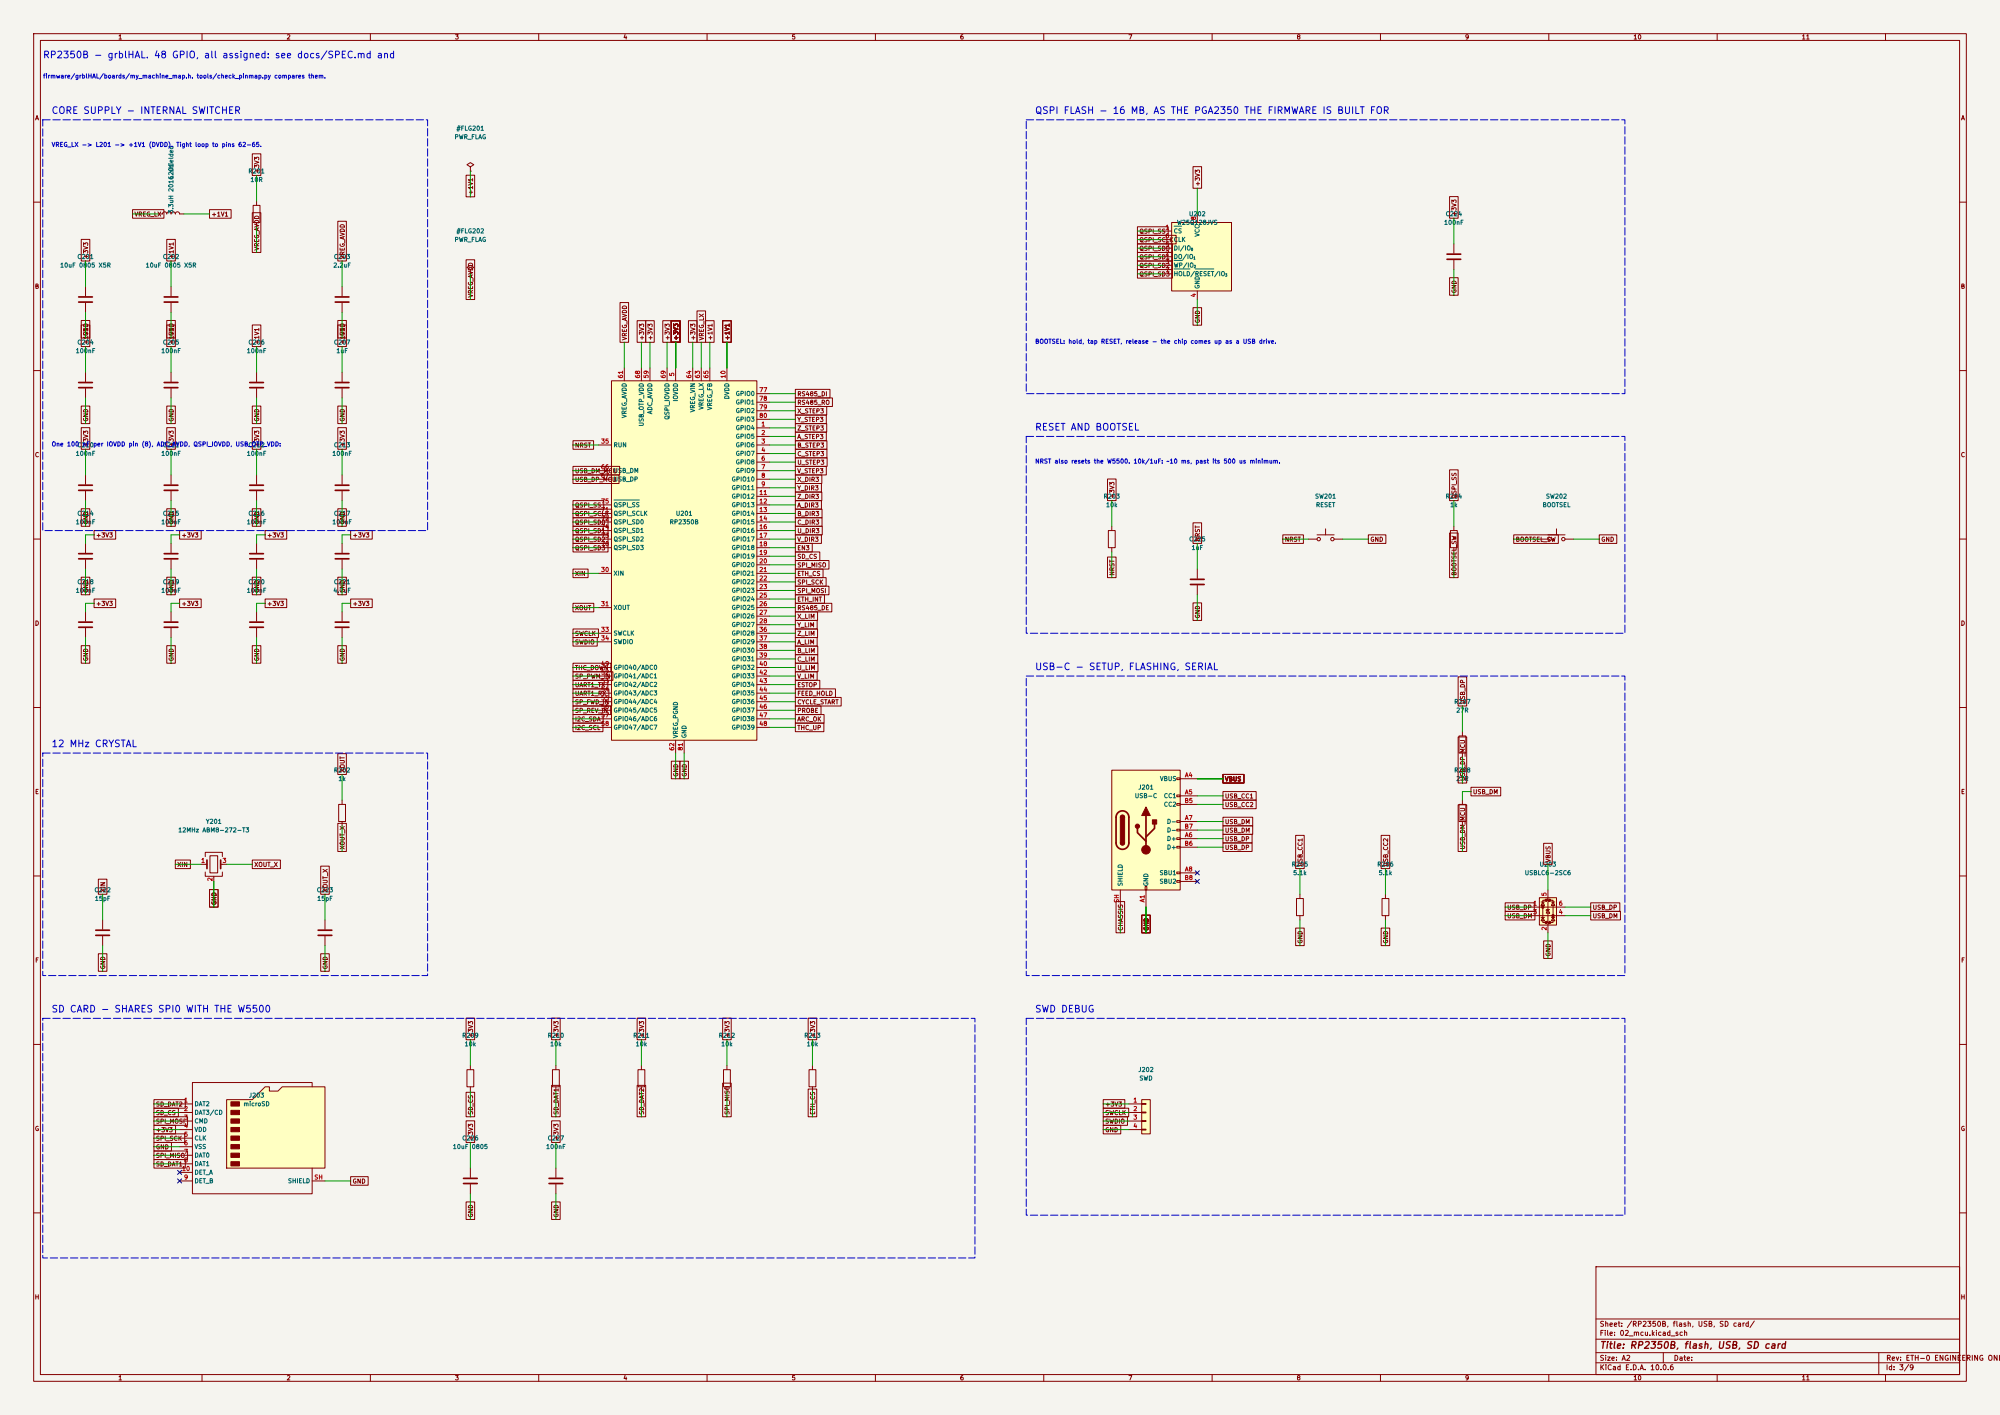
[picture p5: page 3]

firmware/grblHAL/boards/my_machine_map.h. tools/check_pinmap.py compares them. RP2350B - grblHAL. 48 GPIO, all assigned: see docs/SPEC.md and

CORE SUPPLY - INTERNAL SWITCHER

BOOTSEL: hold, tap RESET, release - the chip comes up as a USB drive. QSPI FLASH - 16 MB, AS THE PGA2350 THE FIRMWARE IS BUILT FOR

NRST also resets the W5500. 10k/1uF: ~10 ms, past its 500 us minimum. RESET AND BOOTSEL

USB-C - SETUP, FLASHING, SERIAL

SD CARD - SHARES SPI0 WITH THE W5500

Sheet: /RP2350B, flash, USB, SD card/
File: 02_mcu.kicad_sch
Title: RP2350B, flash, USB, SD card

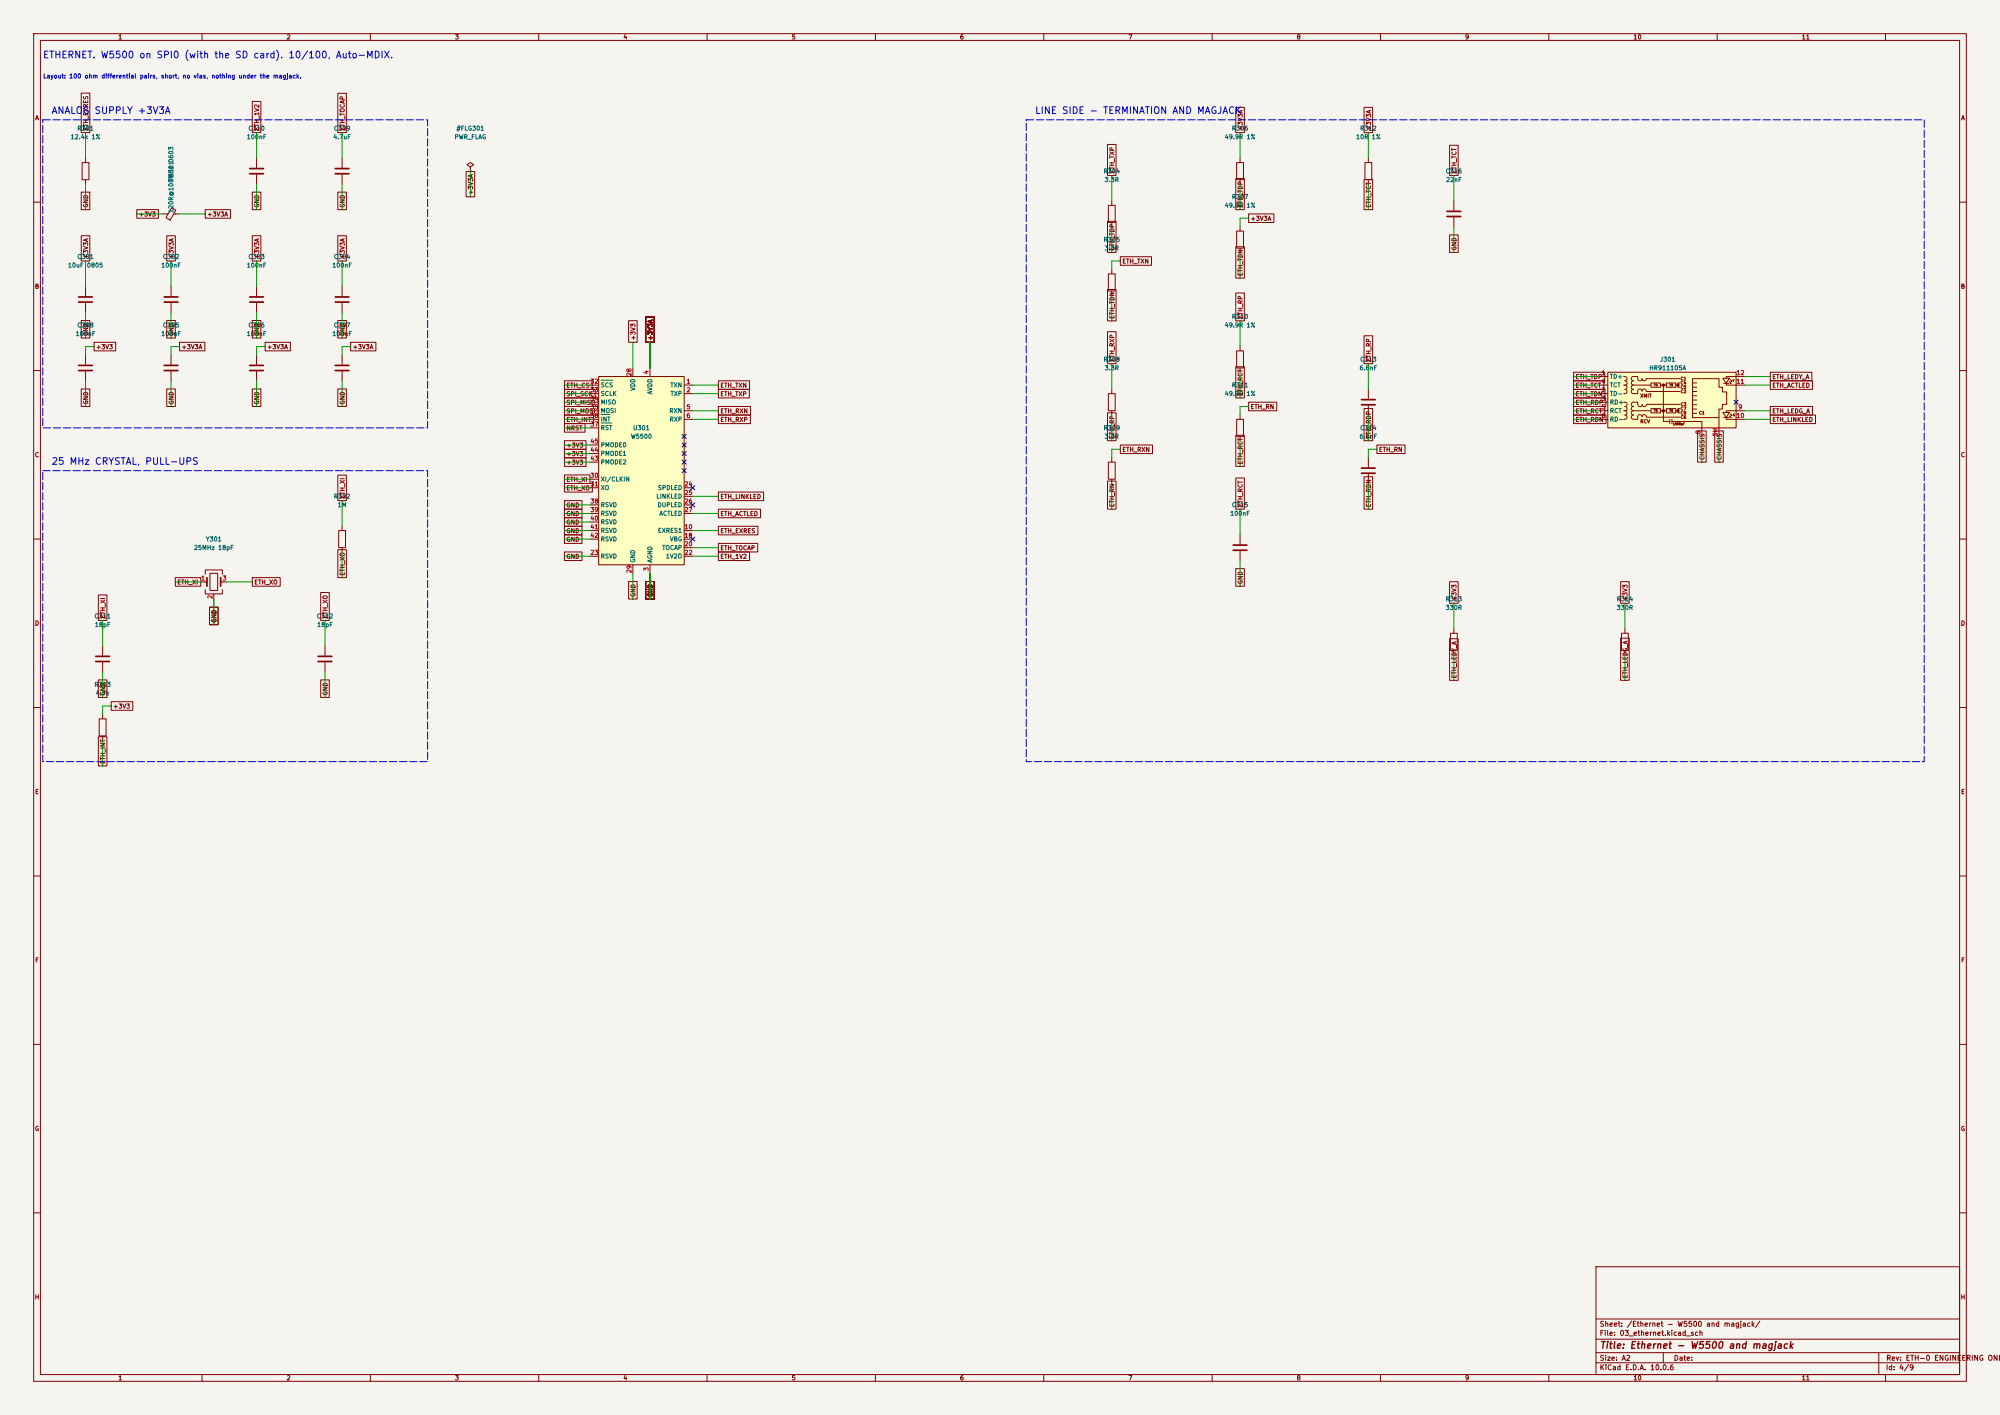
[picture p6: page 4]

ETHERNET. W5500 on SPI0 (with the SD card). 10/100, Auto-MDIX.

Layout: 100 ohm differential pairs, short, no vias, nothing under the magjack.

LINE SIDE - TERMINATION AND MAGJACK

Sheet: /Ethernet - W5500 and magjack/
File: 03_ethernet.kicad_sch
Title: Ethernet - W5500 and magjack

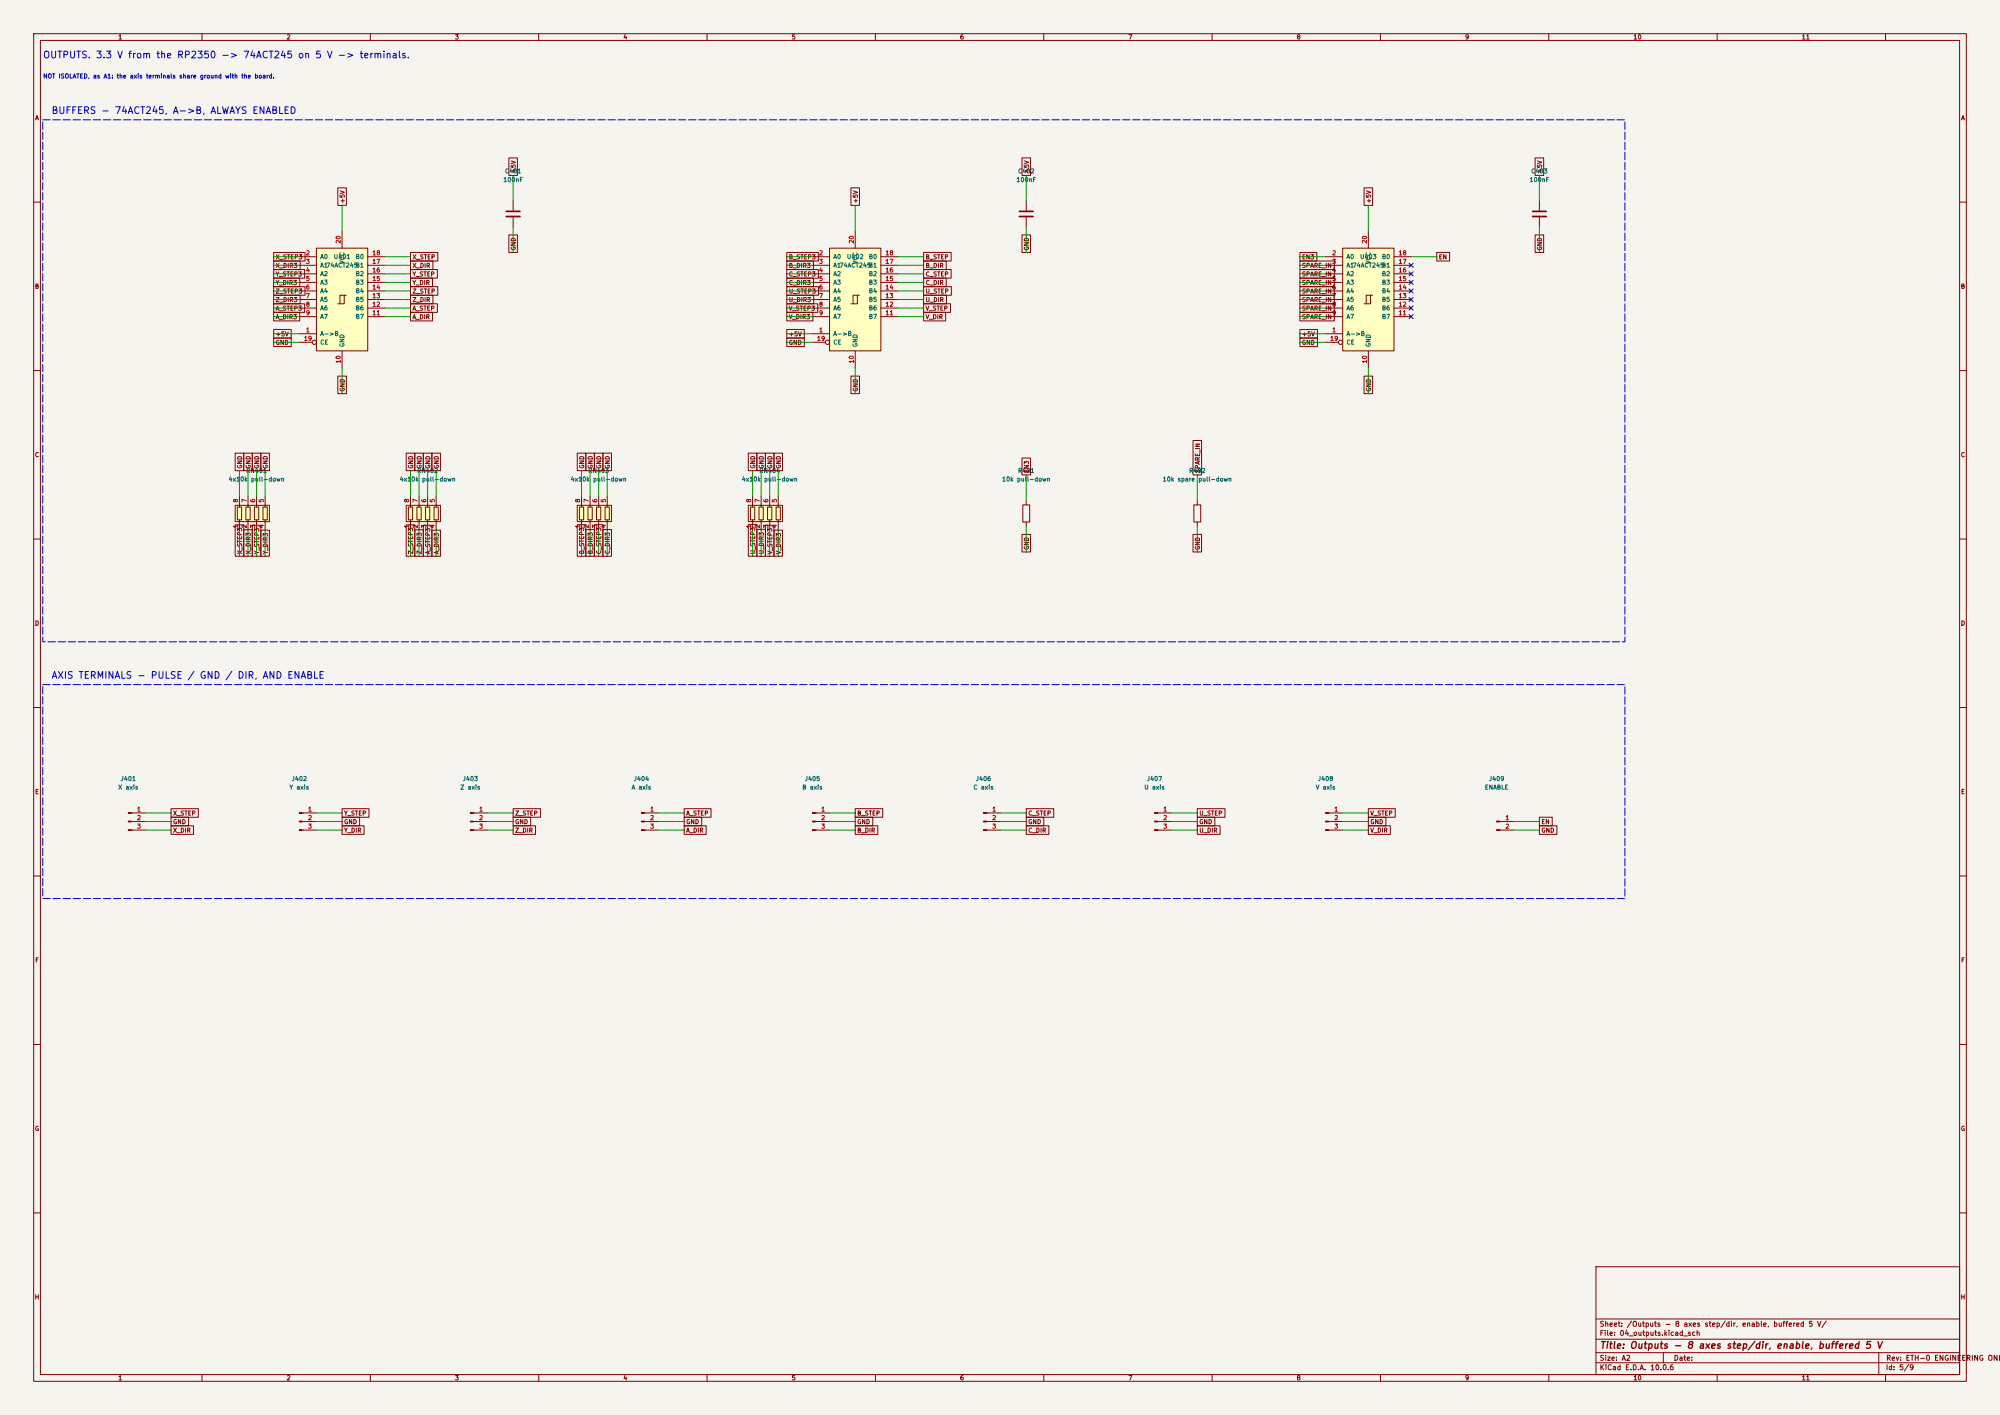
[picture p7: page 5]

NOT ISOLATED, as A1: the axis terminals share ground with the board. OUTPUTS. 3.3 V from the RP2350 -> 74ACT245 on 5 V -> terminals.

AXIS TERMINALS - PULSE / GND / DIR, AND ENABLE

Sheet: /Outputs - 8 axes step/dir, enable, buffered 5 V/
File: 04_outputs.kicad_sch
Title: Outputs - 8 axes step/dir, enable, buffered 5 V

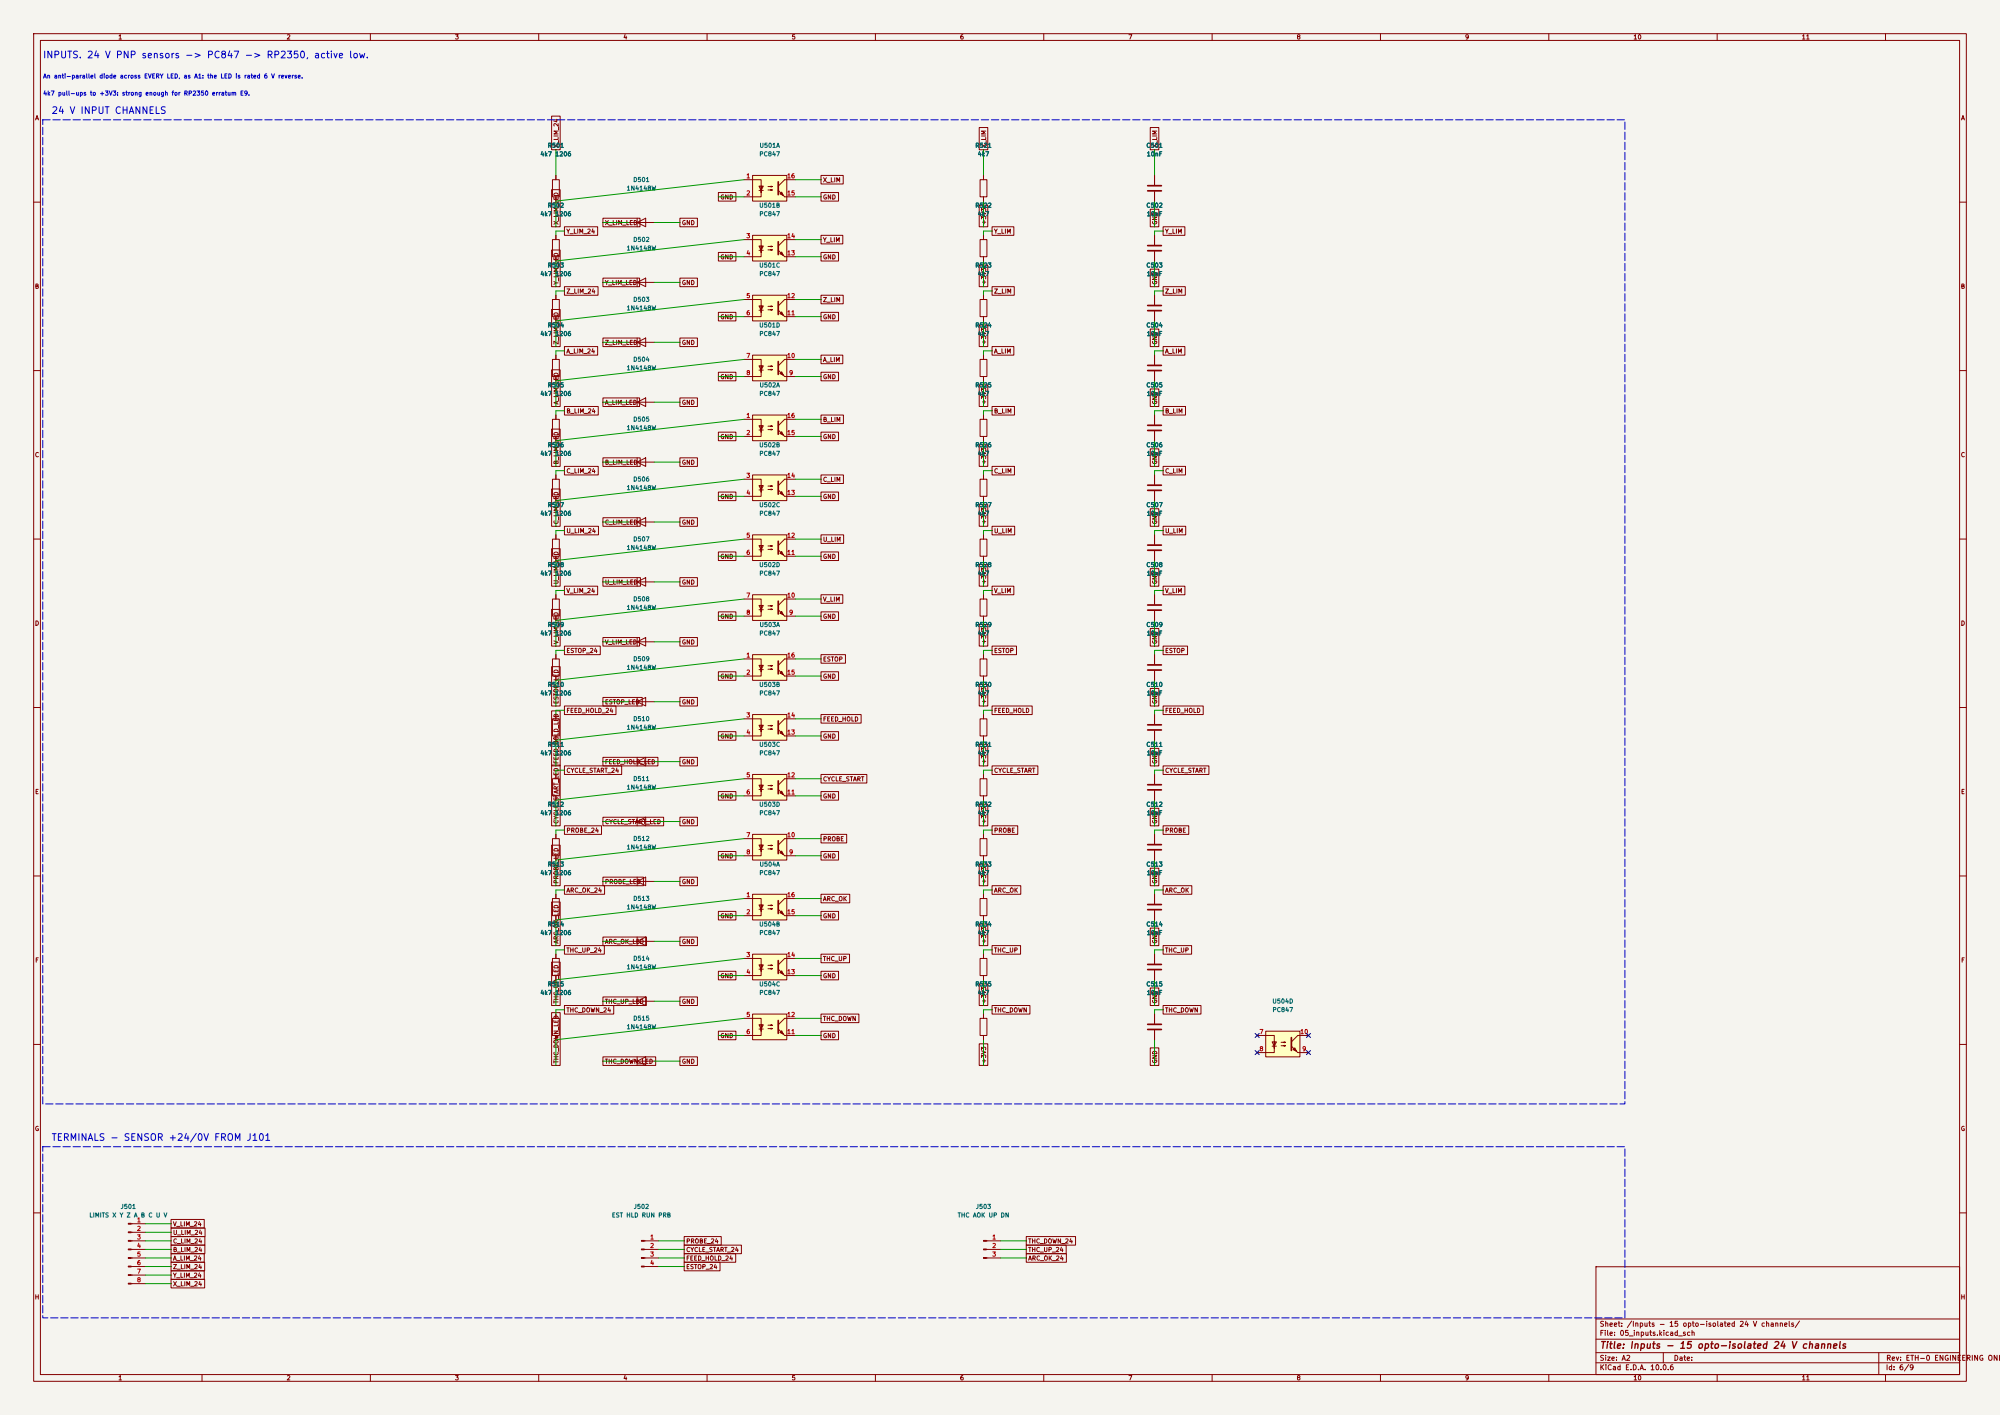
[picture p8: page 6]

INPUTS. 24 V PNP sensors -> PC847 -> RP2350, active low.

THC AOK UP DN

Sheet: /Inputs - 15 opto-isolated 24 V channels/
File: 05_inputs.kicad_sch
Title: Inputs - 15 opto-isolated 24 V channels

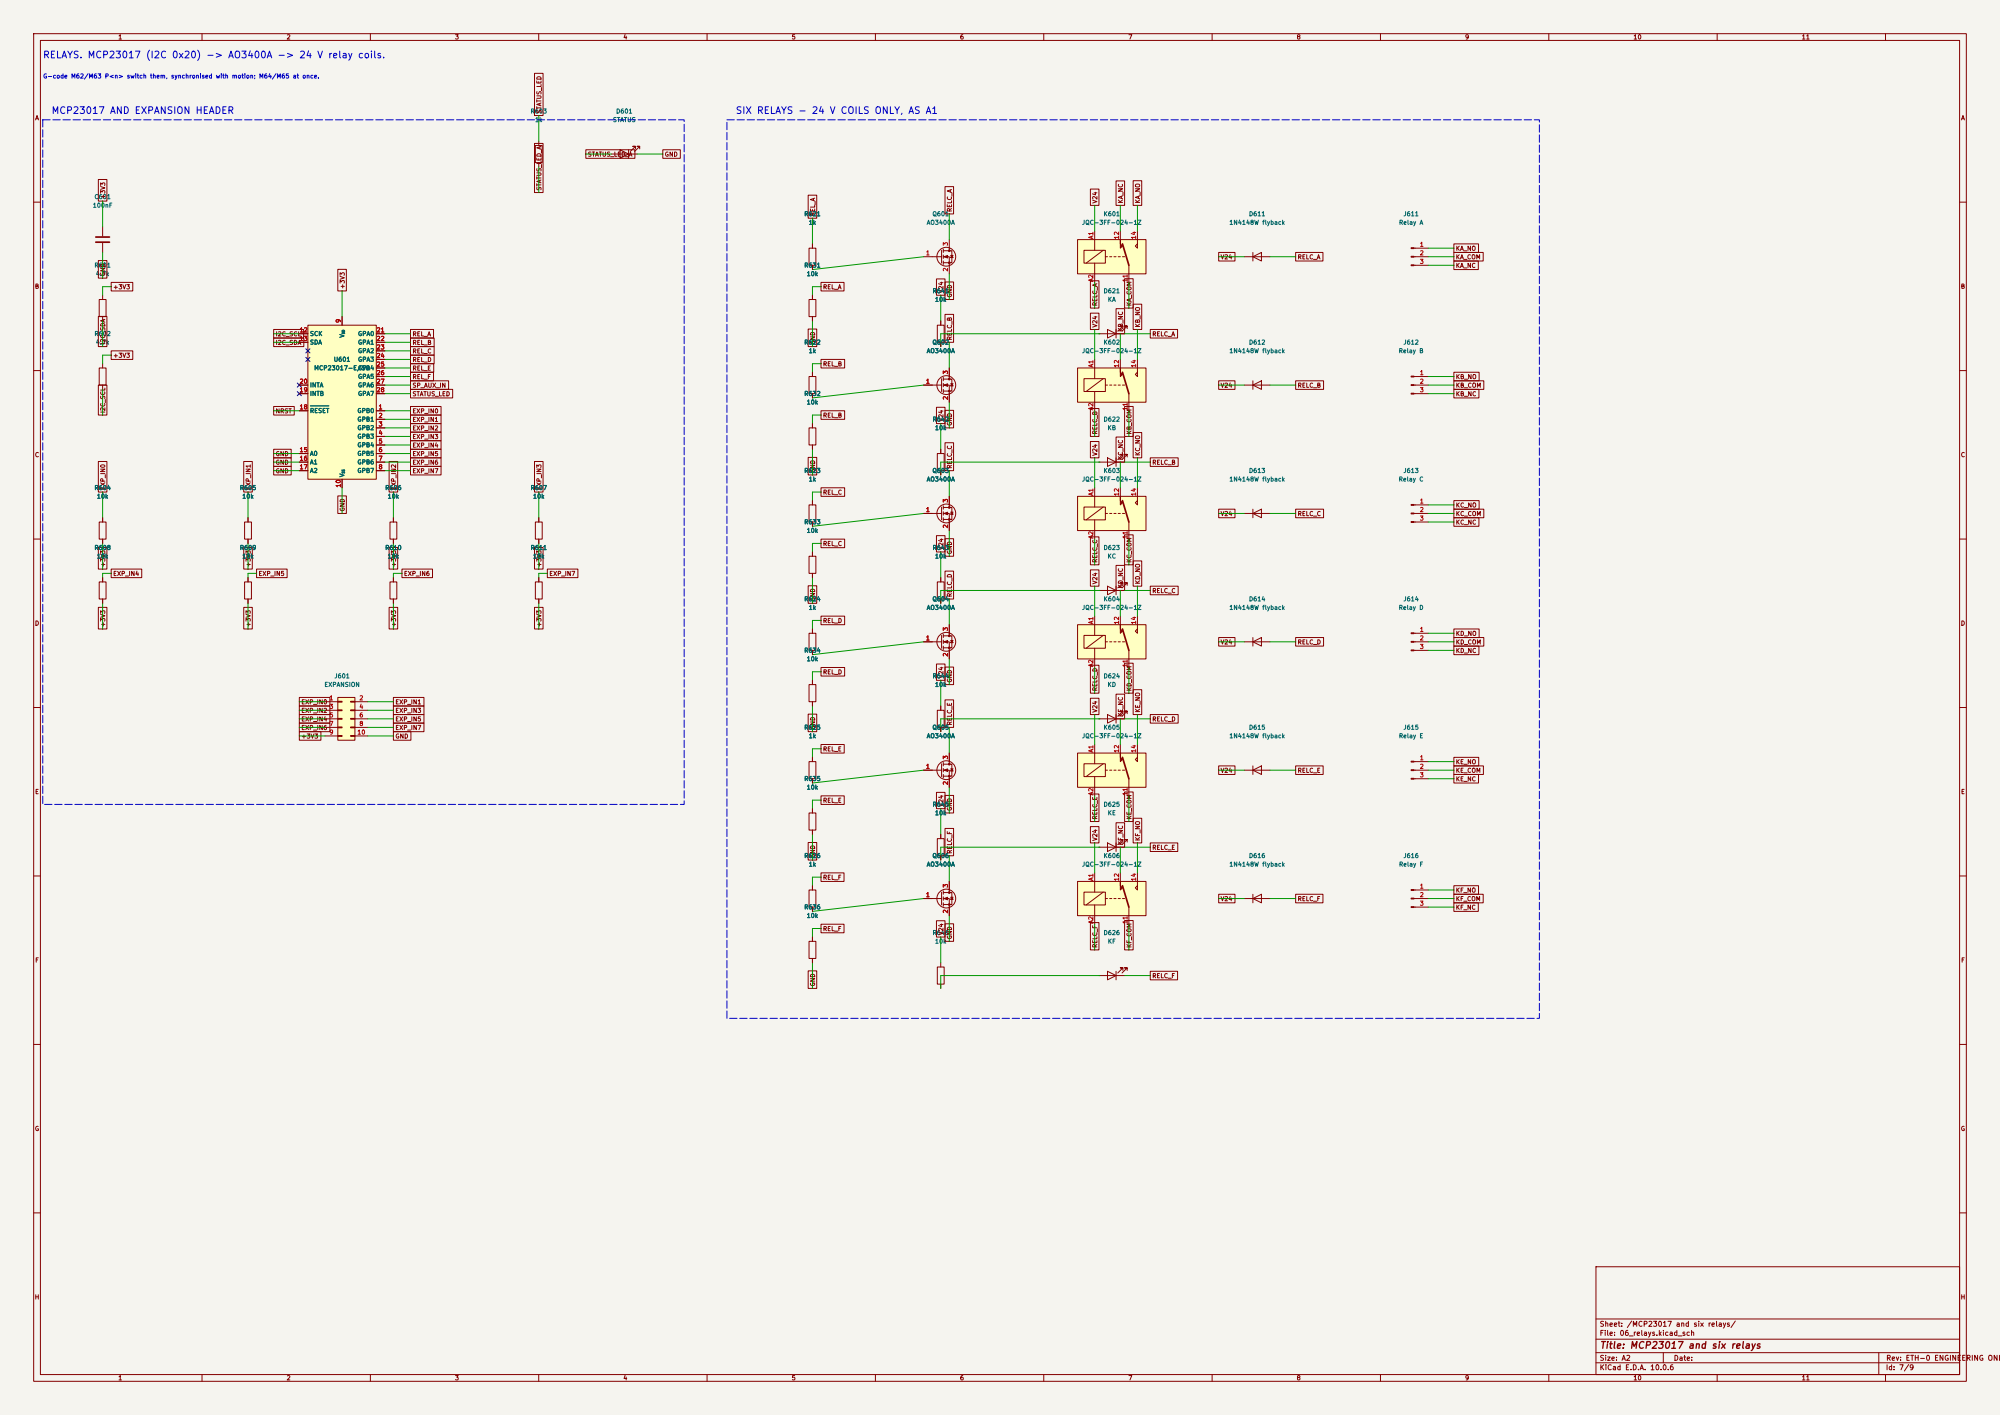
[picture p9: page 7]

G-code M62/M63 P<n> switch them, synchronised with motion; M64/M65 at once. RELAYS. MCP23017 (I2C 0x20) -> AO3400A -> 24 V relay coils.

SIX RELAYS - 24 V COILS ONLY, AS A1

Sheet: /MCP23017 and six relays/
File: 06_relays.kicad_sch
Title: MCP23017 and six relays

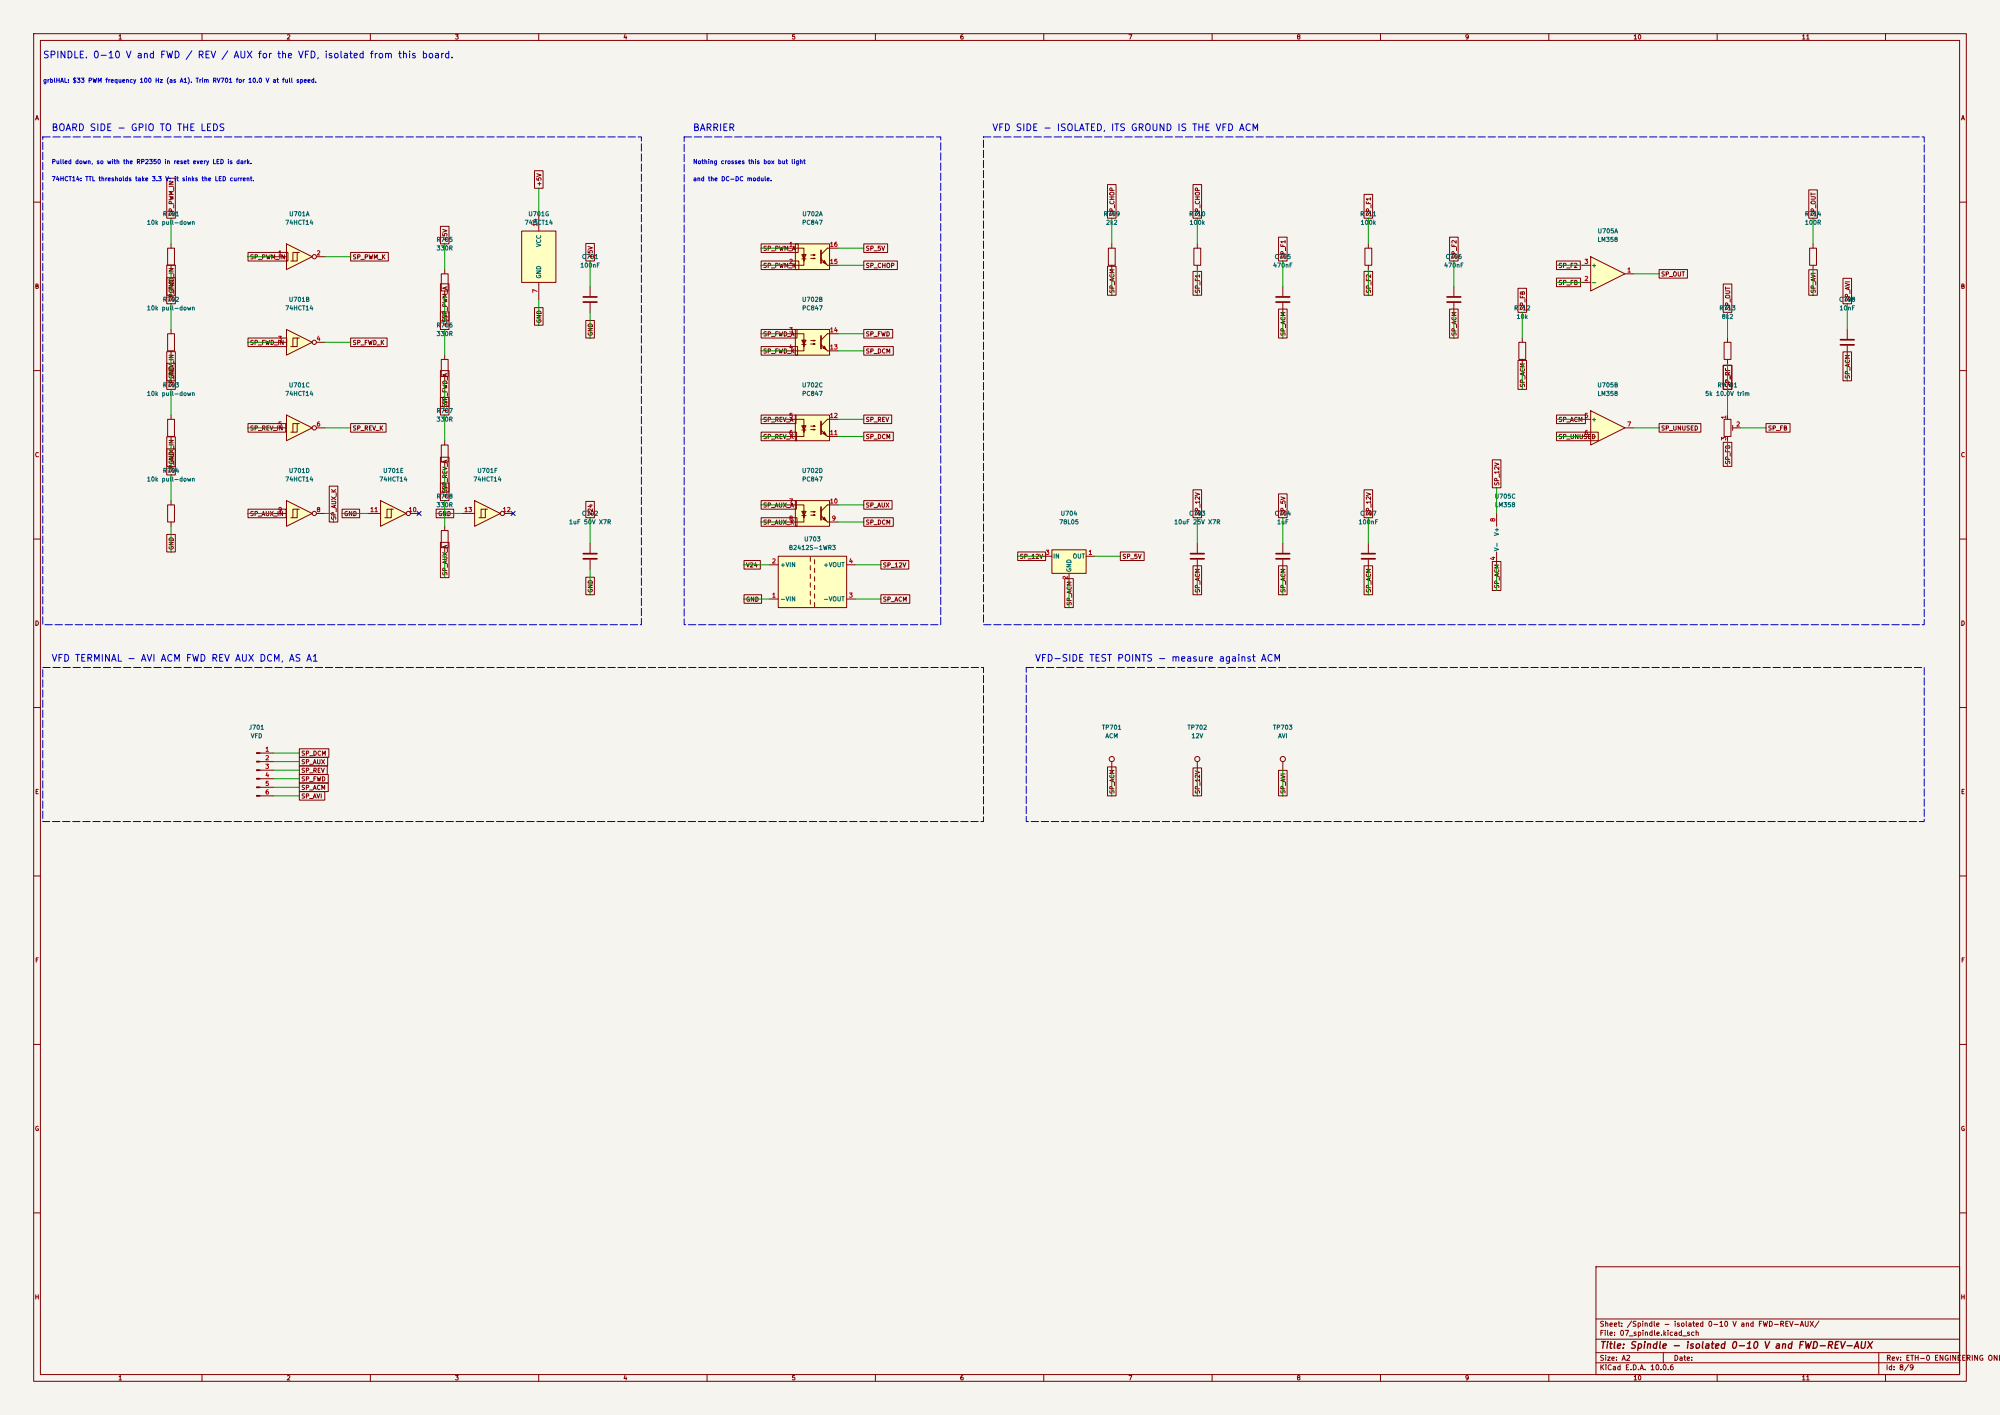
[picture p10: page 8]

grblHAL: $33 PWM frequency 100 Hz (as A1). Trim RV701 for 10.0 V at full speed.

BOARD SIDE - GPIO TO THE LEDS

VFD TERMINAL - AVI ACM FWD REV AUX DCM, AS A1

VFD-SIDE TEST POINTS - measure against ACM

Sheet: /Spindle - isolated 0-10 V and FWD-REV-AUX/
File: 07_spindle.kicad_sch
Title: Spindle - isolated 0-10 V and FWD-REV-AUX

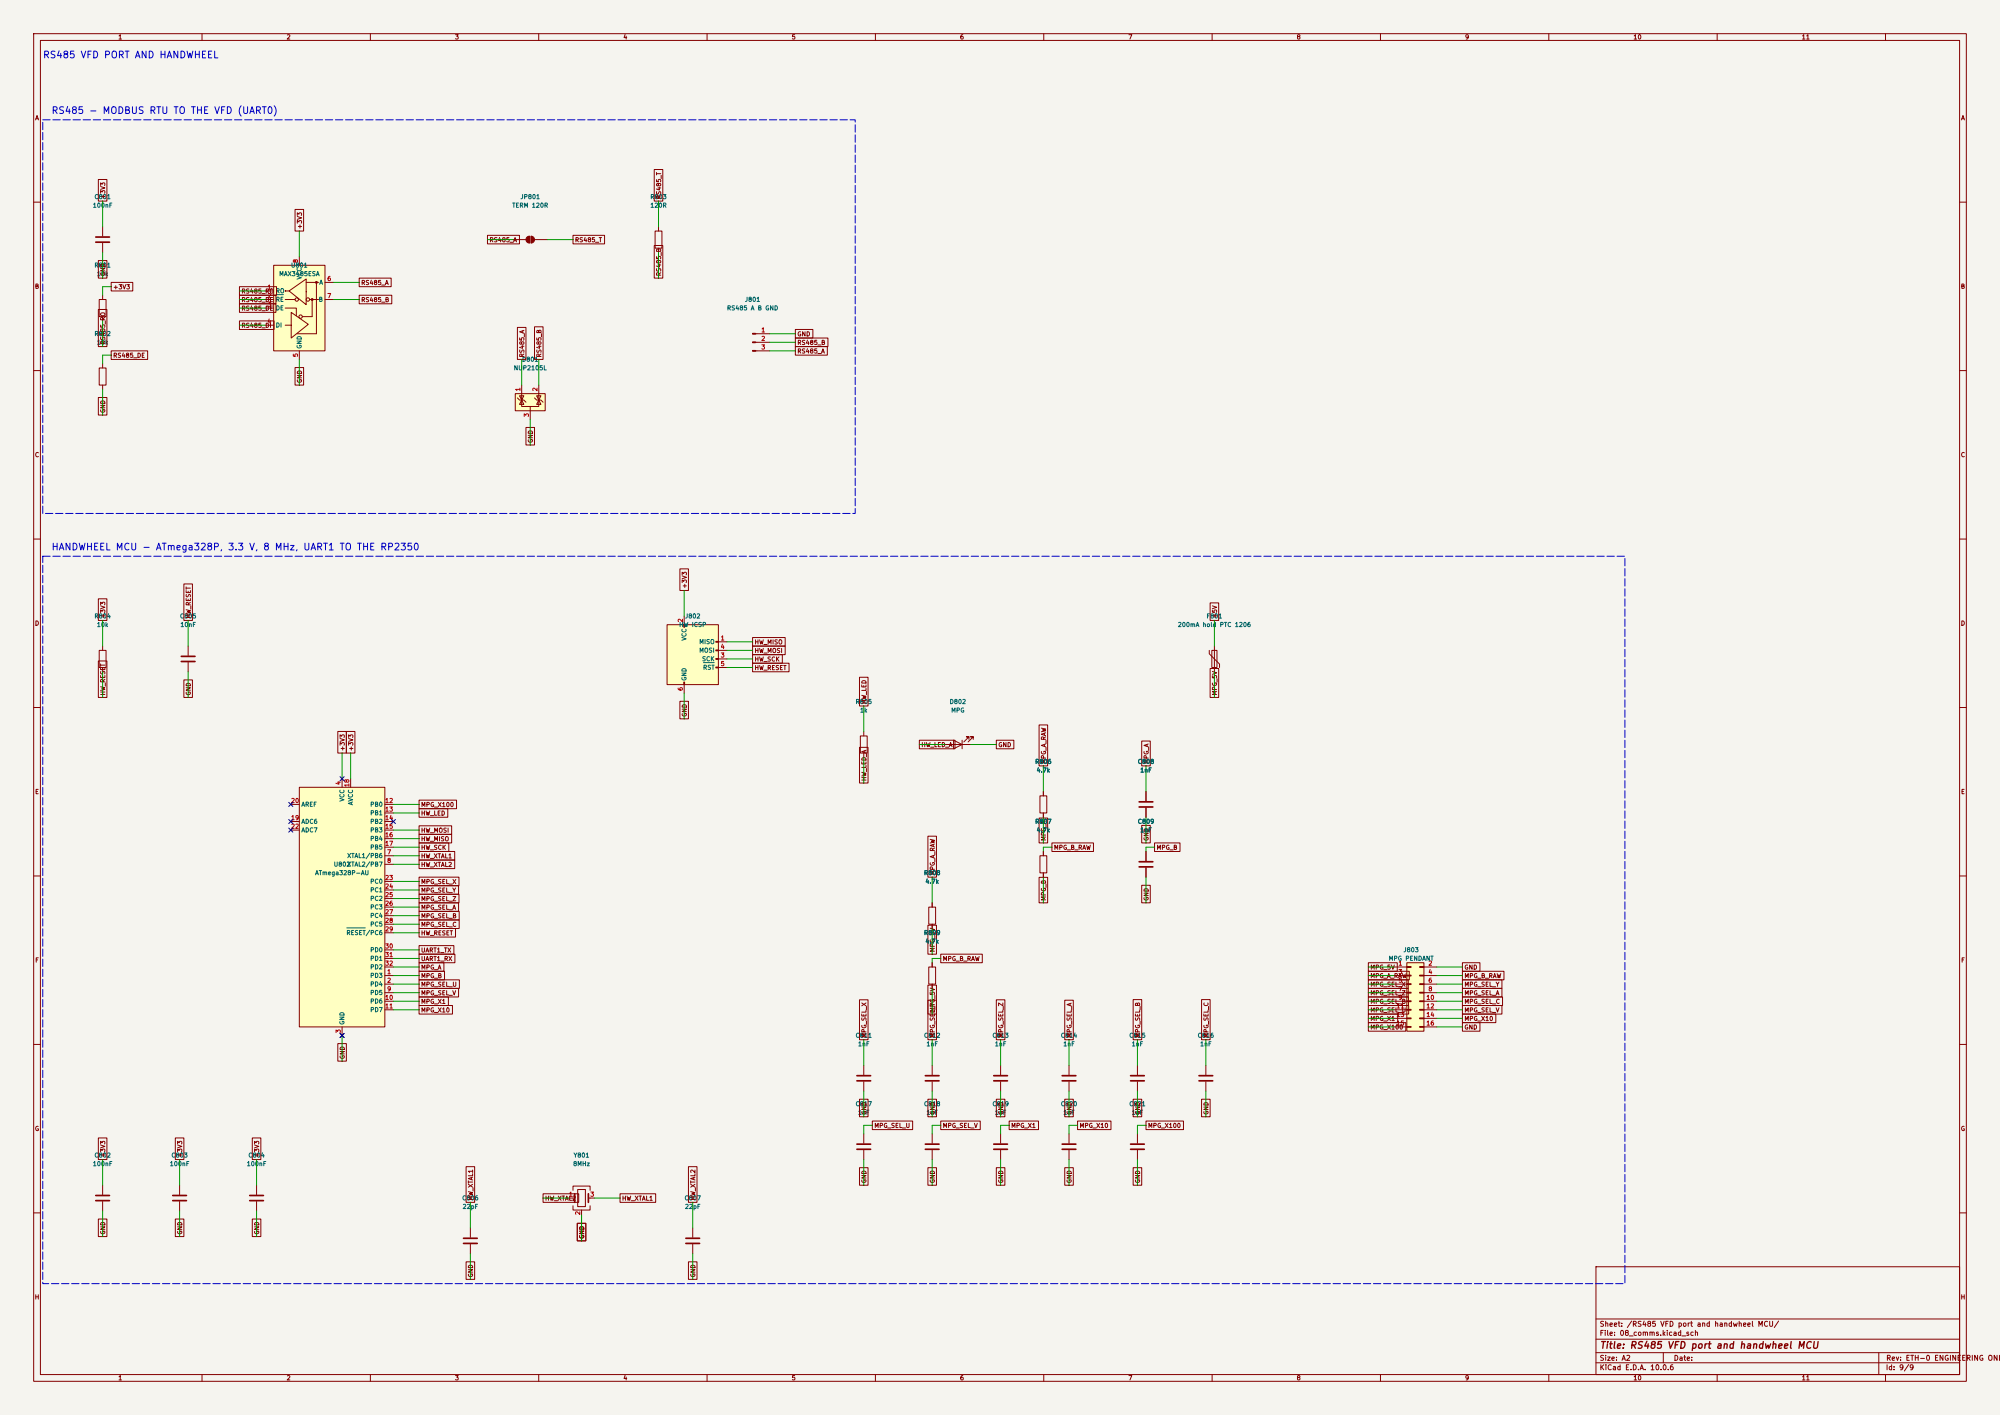
[picture p11: page 9]

RS485 VFD PORT AND HANDWHEEL

RS485 - MODBUS RTU TO THE VFD (UART0)

MPG_X100 HANDWHEEL MCU - ATmega328P, 3.3 V, 8 MHz, UART1 TO THE RP2350

Sheet: /RS485 VFD port and handwheel MCU/
File: 08_comms.kicad_sch
Title: RS485 VFD port and handwheel MCU
