moein98/heimdall/MACH3_SIMPLE/review/MACH3SIMPLE_schematic.pdf

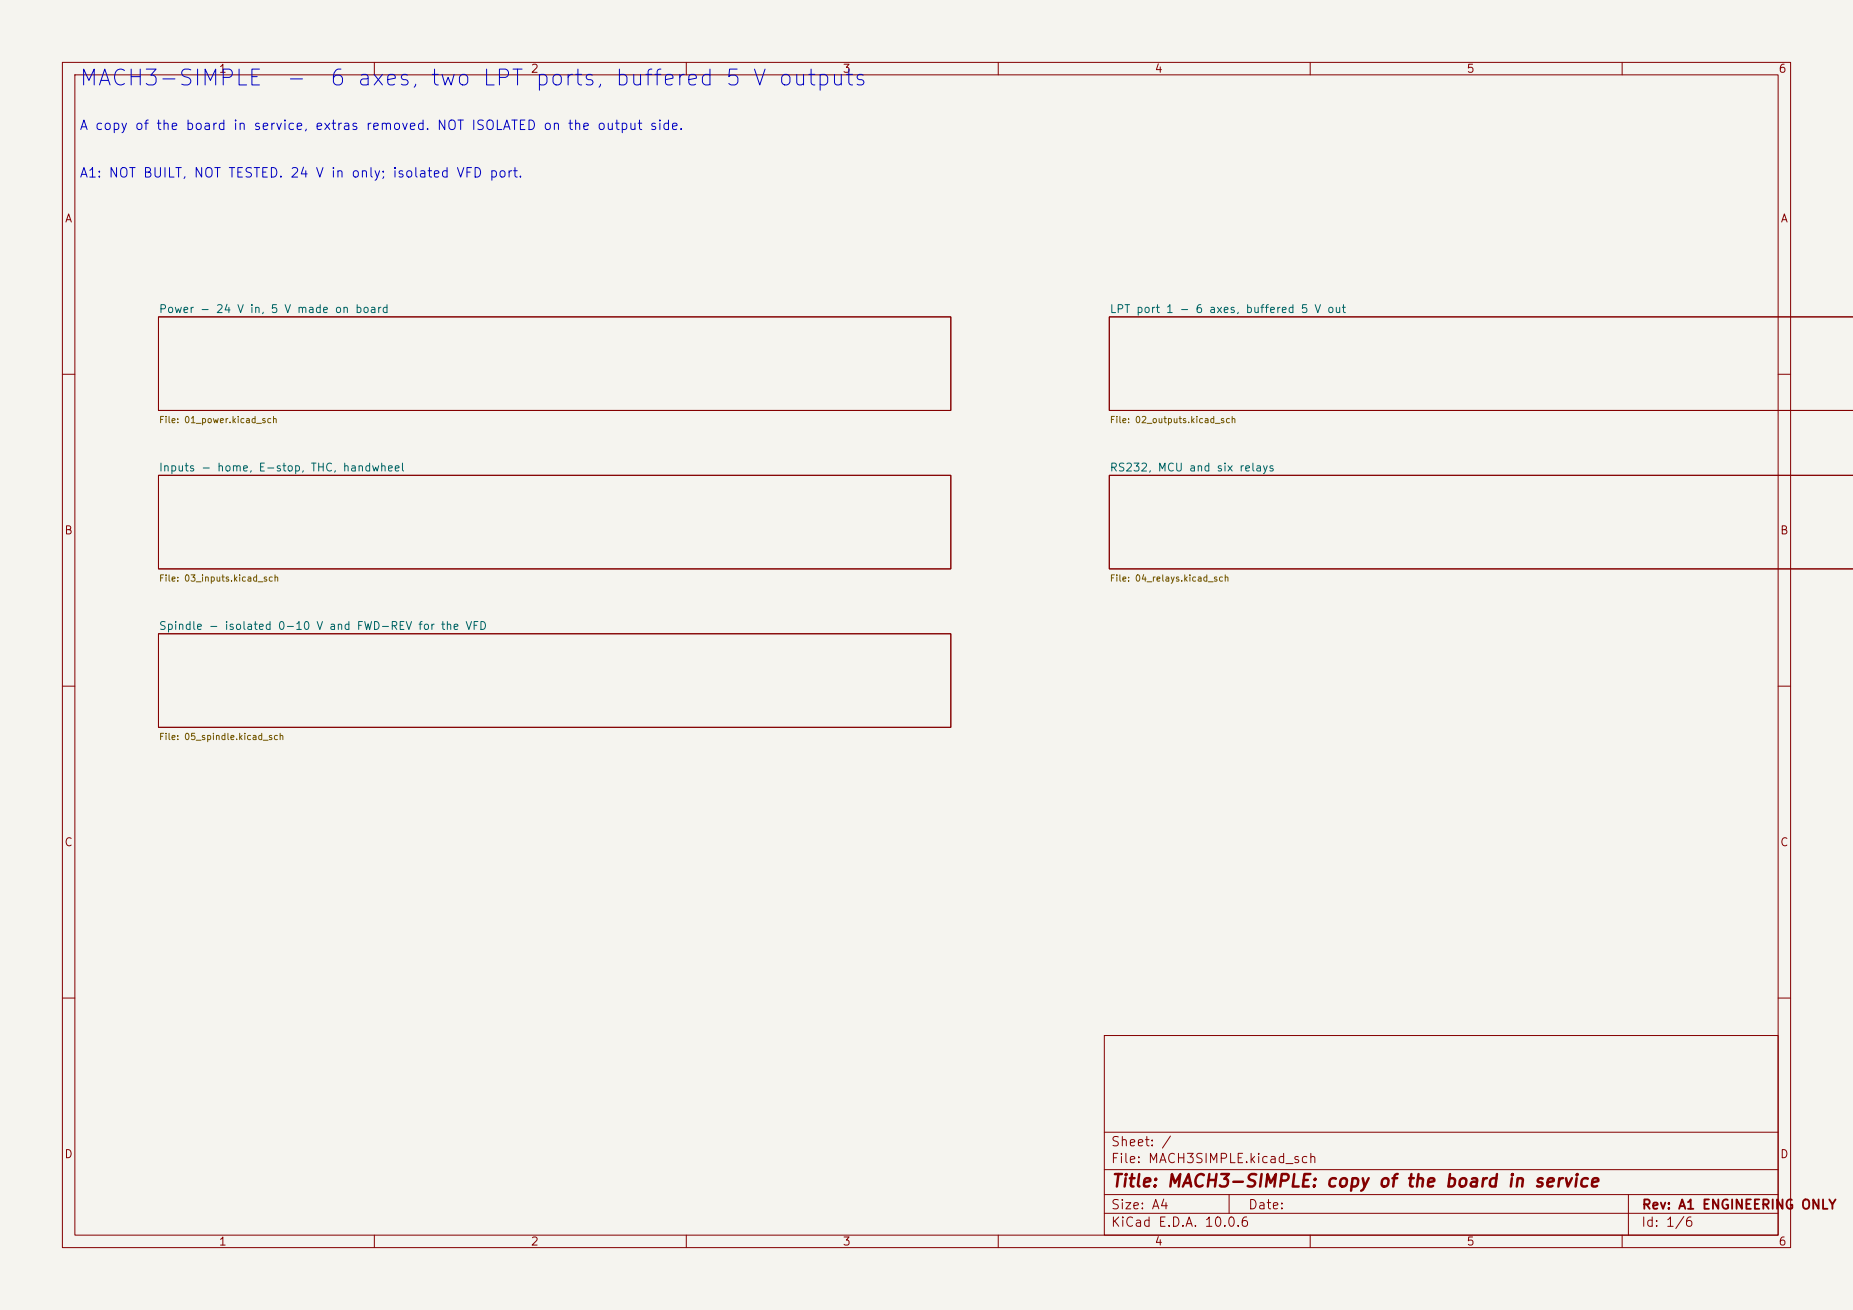
[picture p12: page 1]

File: 05_spindle.kicad_sch MACH3-SIMPLE - 6 axes, two LPT ports, buffered 5 V outputs

A copy of the board in service, extras removed. NOT ISOLATED on the output side.

A1: NOT BUILT, NOT TESTED. 24 V in only; isolated VFD port.

Power - 24 V in, 5 V made on board

File: 04_relays.kicad_sch Spindle - isolated 0-10 V and FWD-REV for the VFD

Sheet: /
File: MACH3SIMPLE.kicad_sch
Title: MACH3-SIMPLE: copy of the board in service

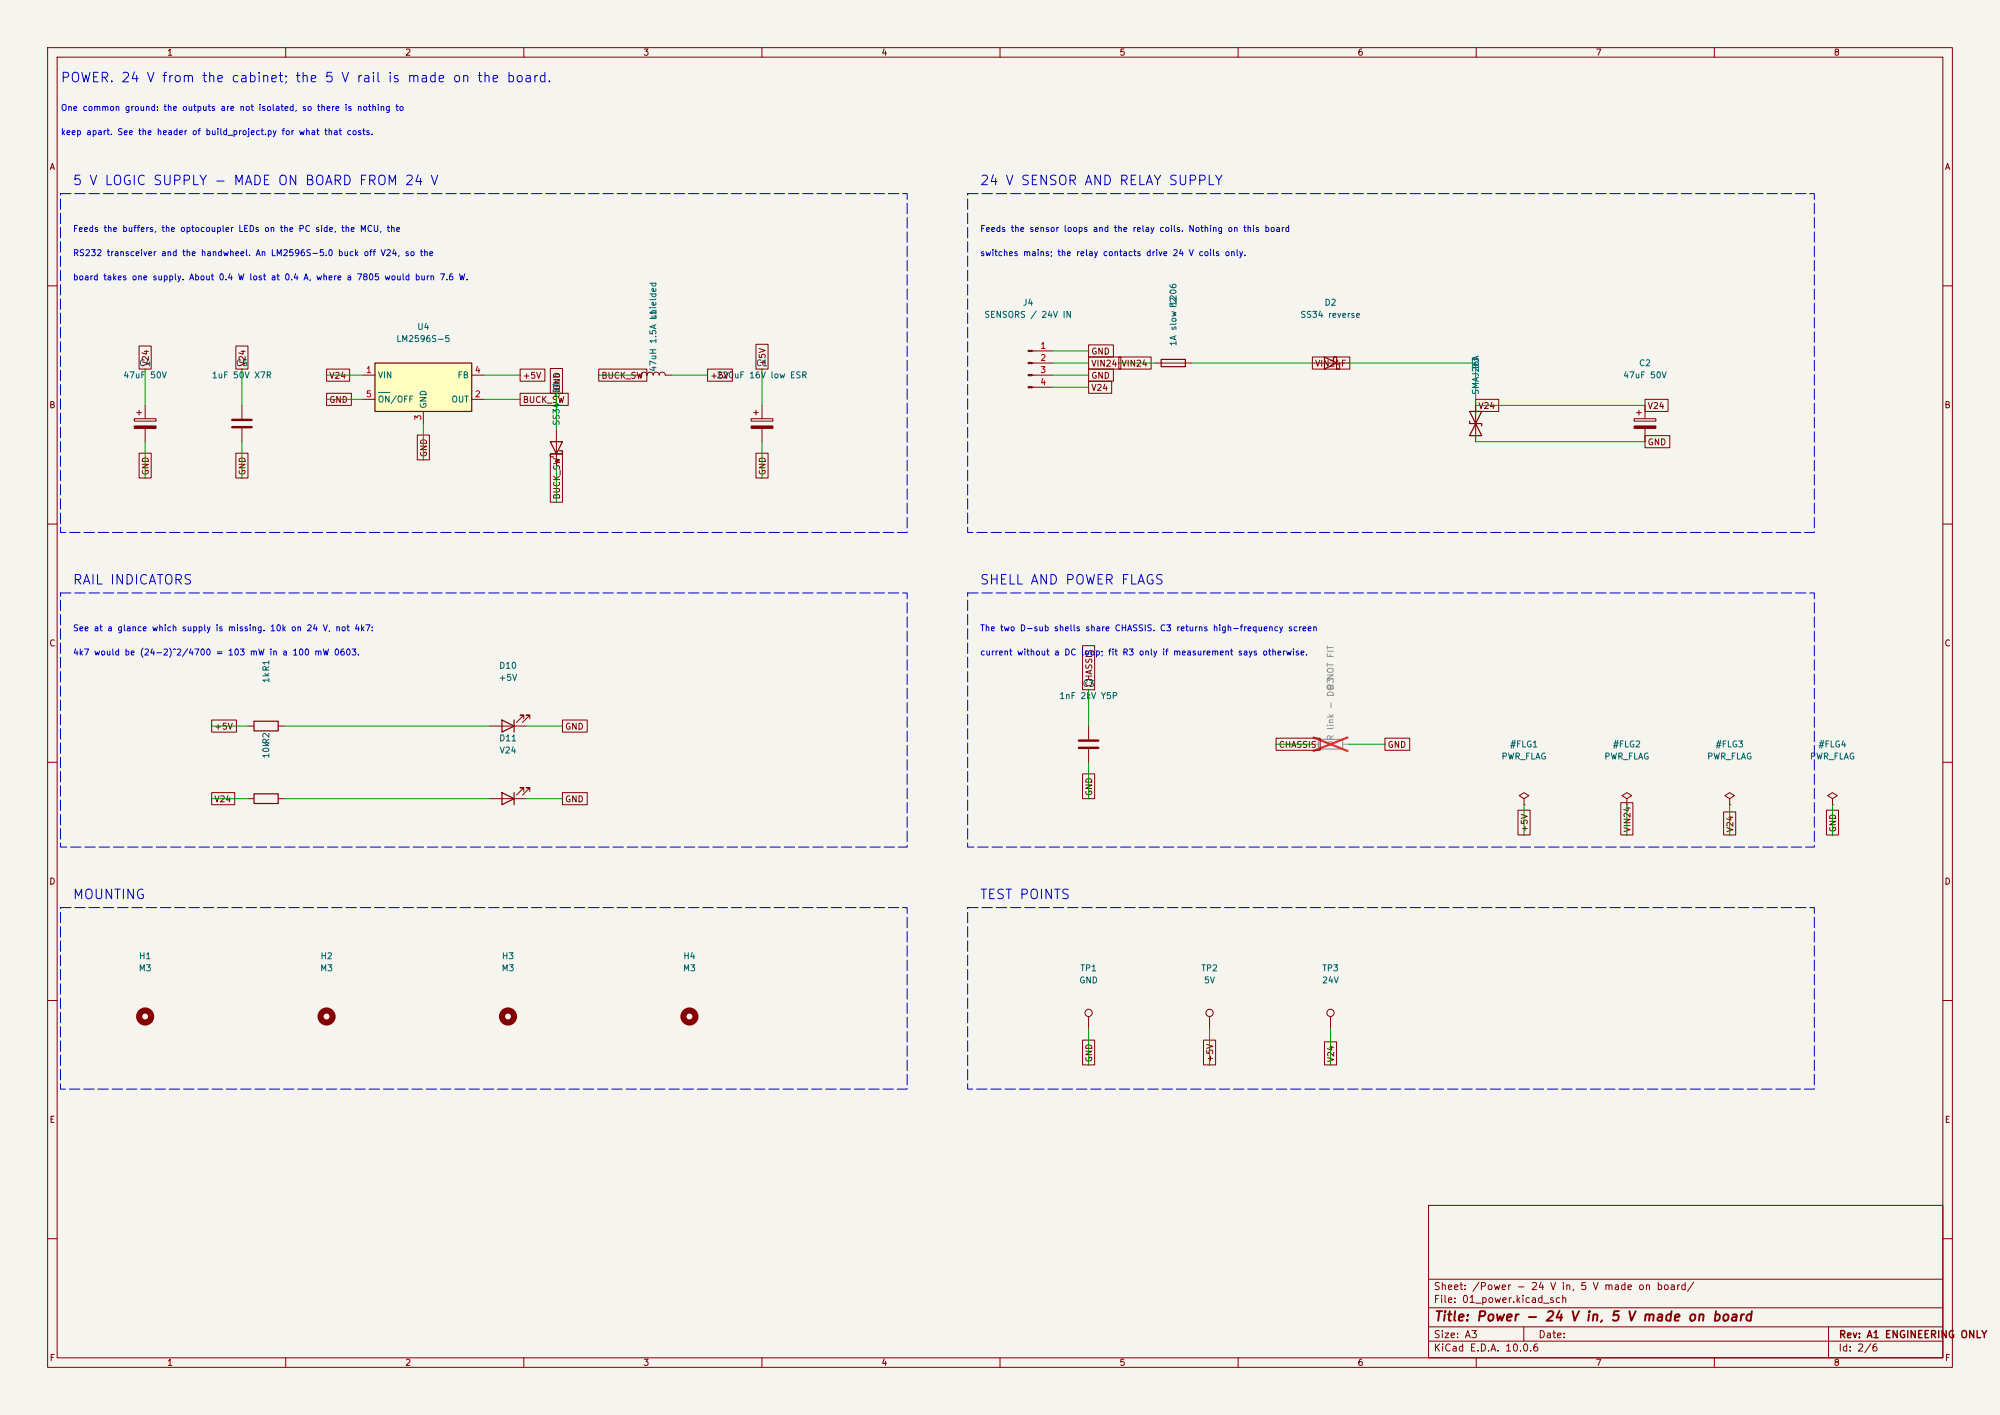
[picture p13: page 2]

keep apart. See the header of build_project.py for what that costs. MOUNTING
GND V24

VIN24 GND GND One common ground: the outputs are not isolated, so there is nothing to RAIL INDICATORS

5 V LOGIC SUPPLY - MADE ON BOARD FROM 24 V

Feeds the sensor loops and the relay coils. Nothing on this board

switches mains; the relay contacts drive 24 V coils only.

SHELL AND POWER FLAGS

The two D-sub shells share CHASSIS. C3 returns high-frequency screen

#FLG3 PWR_FLAG R3 0R link - DO NOT FIT

Sheet: /Power - 24 V in, 5 V made on board/
File: 01_power.kicad_sch
Title: Power - 24 V in, 5 V made on board

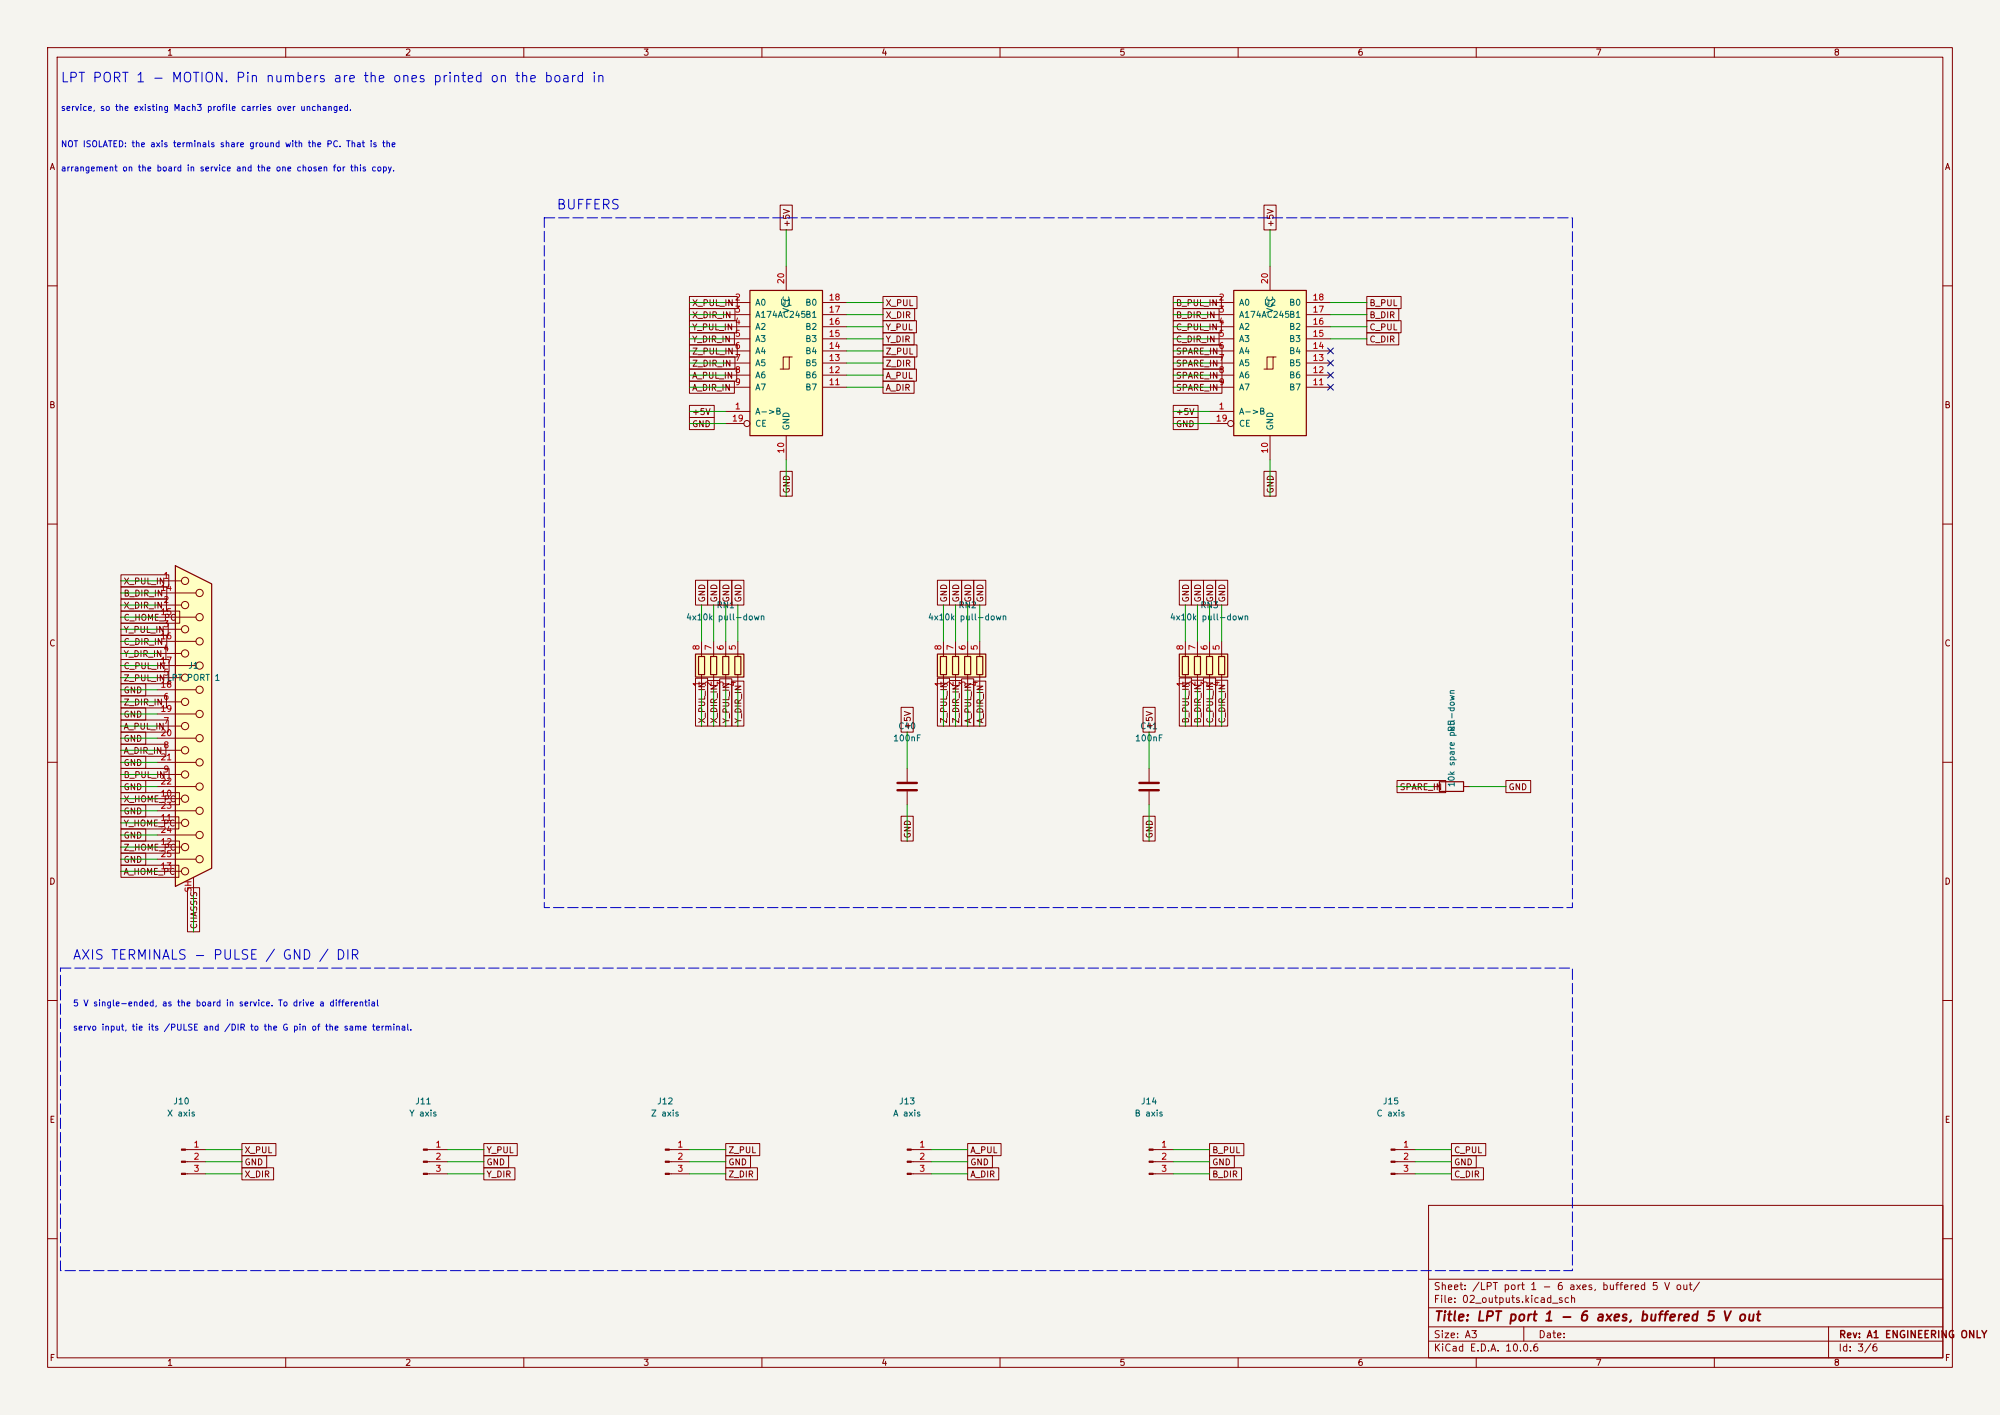
[picture p14: page 3]

LPT PORT 1 - MOTION. Pin numbers are the ones printed on the board in

service, so the existing Mach3 profile carries over unchanged.

arrangement on the board in service and the one chosen for this copy. NOT ISOLATED: the axis terminals share ground with the PC. That is the

A_PUL AXIS TERMINALS - PULSE / GND / DIR

servo input, tie its /PULSE and /DIR to the G pin of the same terminal. 5 V single-ended, as the board in service. To drive a differential

Sheet: /LPT port 1 - 6 axes, buffered 5 V out/
File: 02_outputs.kicad_sch
Title: LPT port 1 - 6 axes, buffered 5 V out

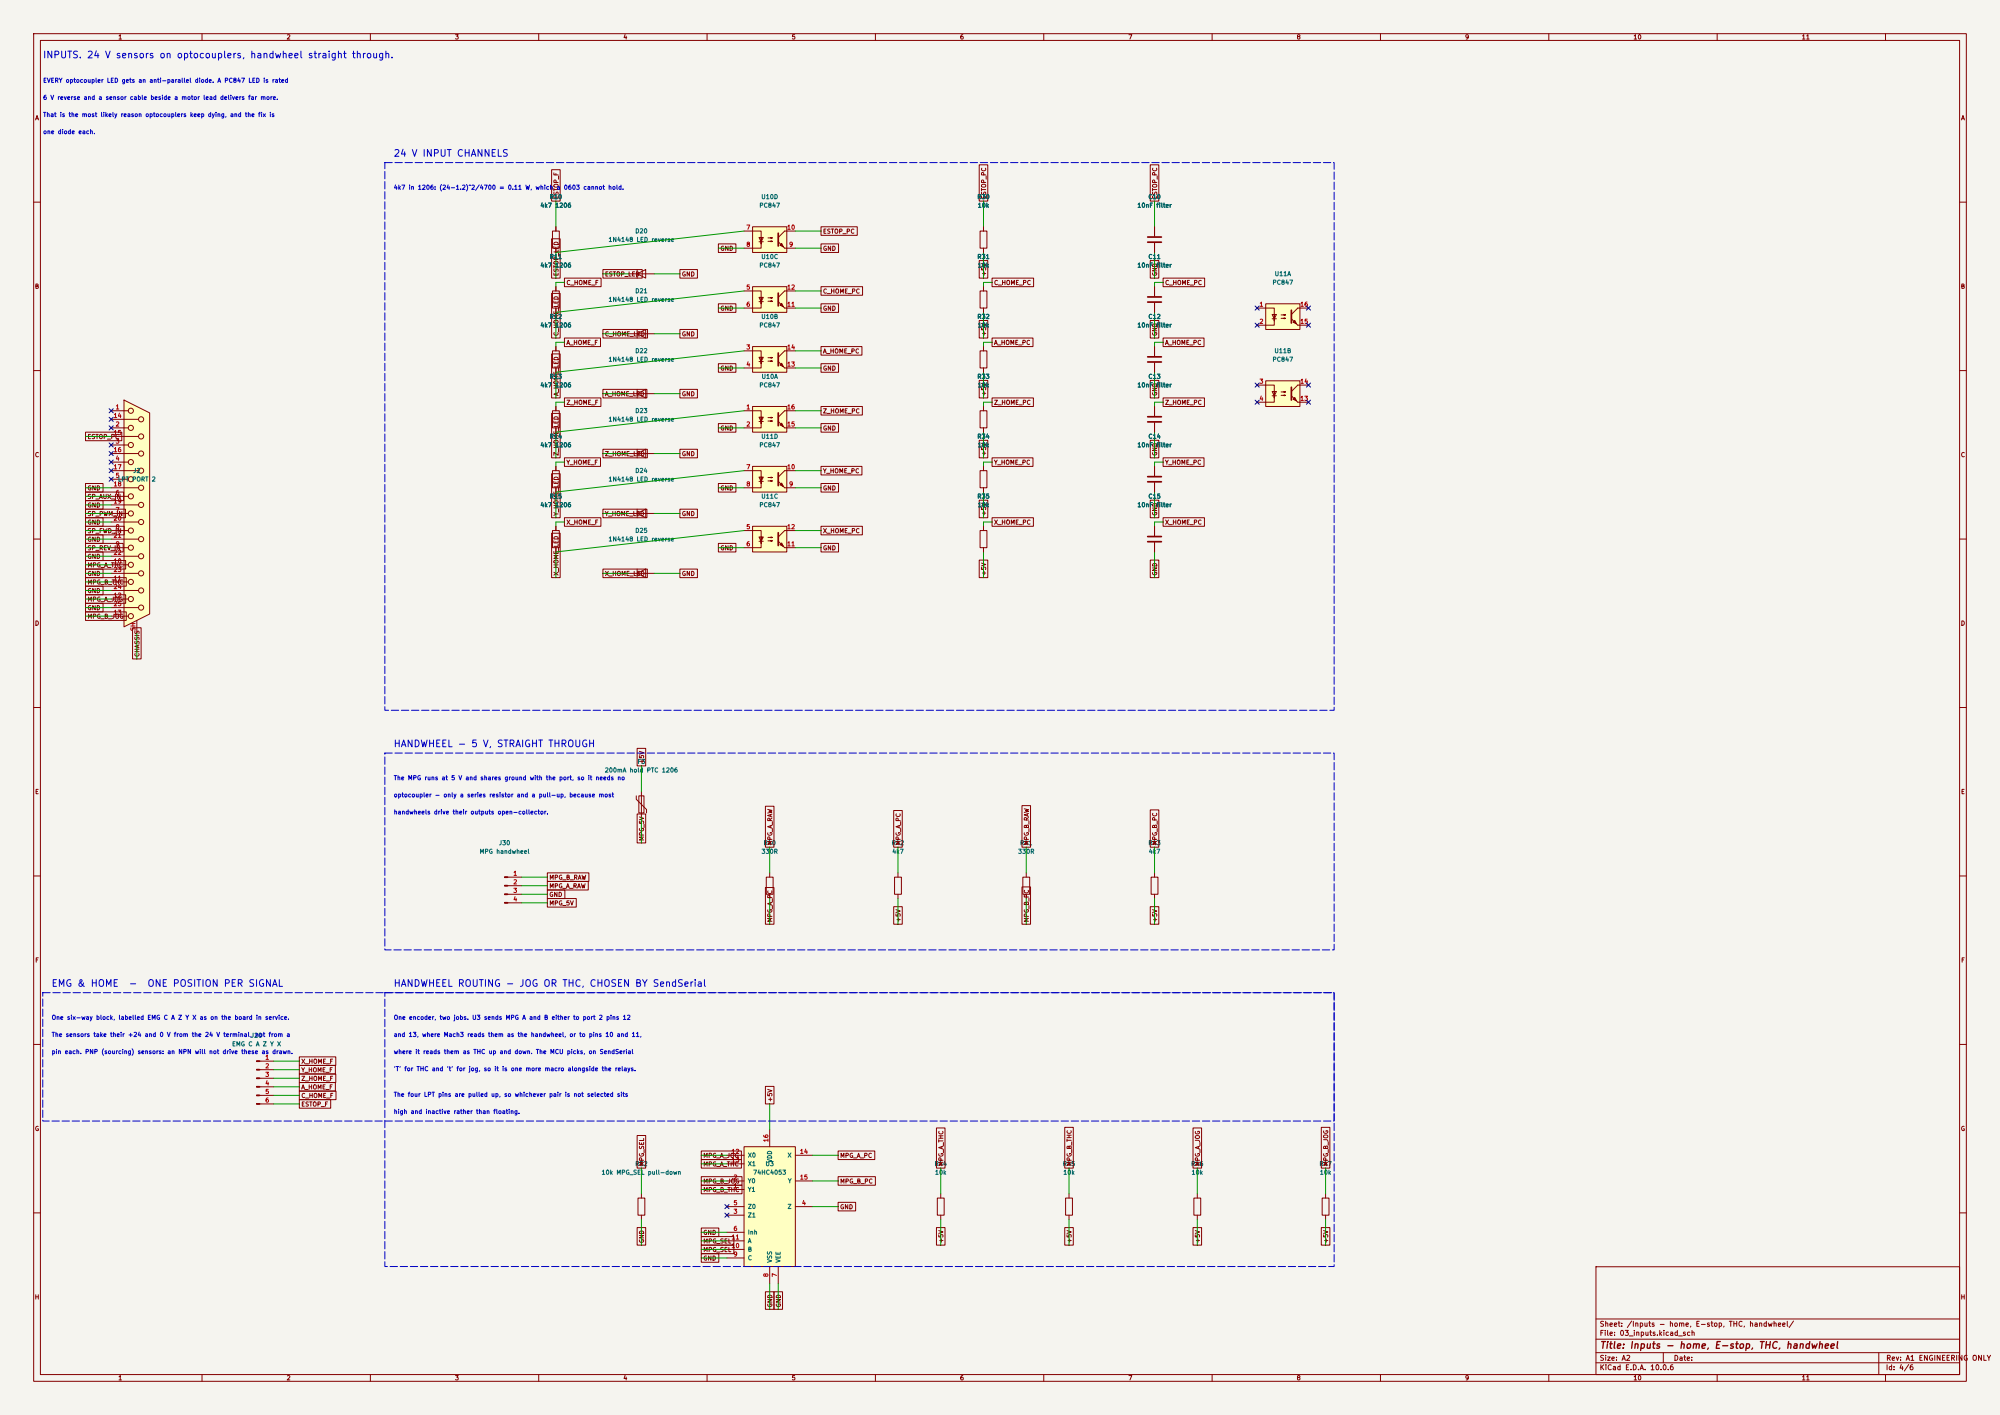
[picture p15: page 4]

one diode each. That is the most likely reason optocouplers keep dying, and the fix is 6 V reverse and a sensor cable beside a motor lead delivers far more. EVERY optocoupler LED gets an anti-parallel diode. A PC847 LED is rated

where it reads them as THC up and down. The MCU picks, on SendSerial HANDWHEEL - 5 V, STRAIGHT THROUGH

handwheels drive their outputs open-collector.

EMG & HOME - ONE POSITION PER SIGNAL

HANDWHEEL ROUTING - JOG OR THC, CHOSEN BY SendSerial and 13, where Mach3 reads them as the handwheel, or to pins 10 and 11,

One encoder, two jobs. U3 sends MPG A and B either to port 2 pins 12

'T' for THC and 't' for jog, so it is one more macro alongside the relays.

The four LPT pins are pulled up, so whichever pair is not selected sits

Sheet: /Inputs - home, E-stop, THC, handwheel/
File: 03_inputs.kicad_sch
Title: Inputs - home, E-stop, THC, handwheel

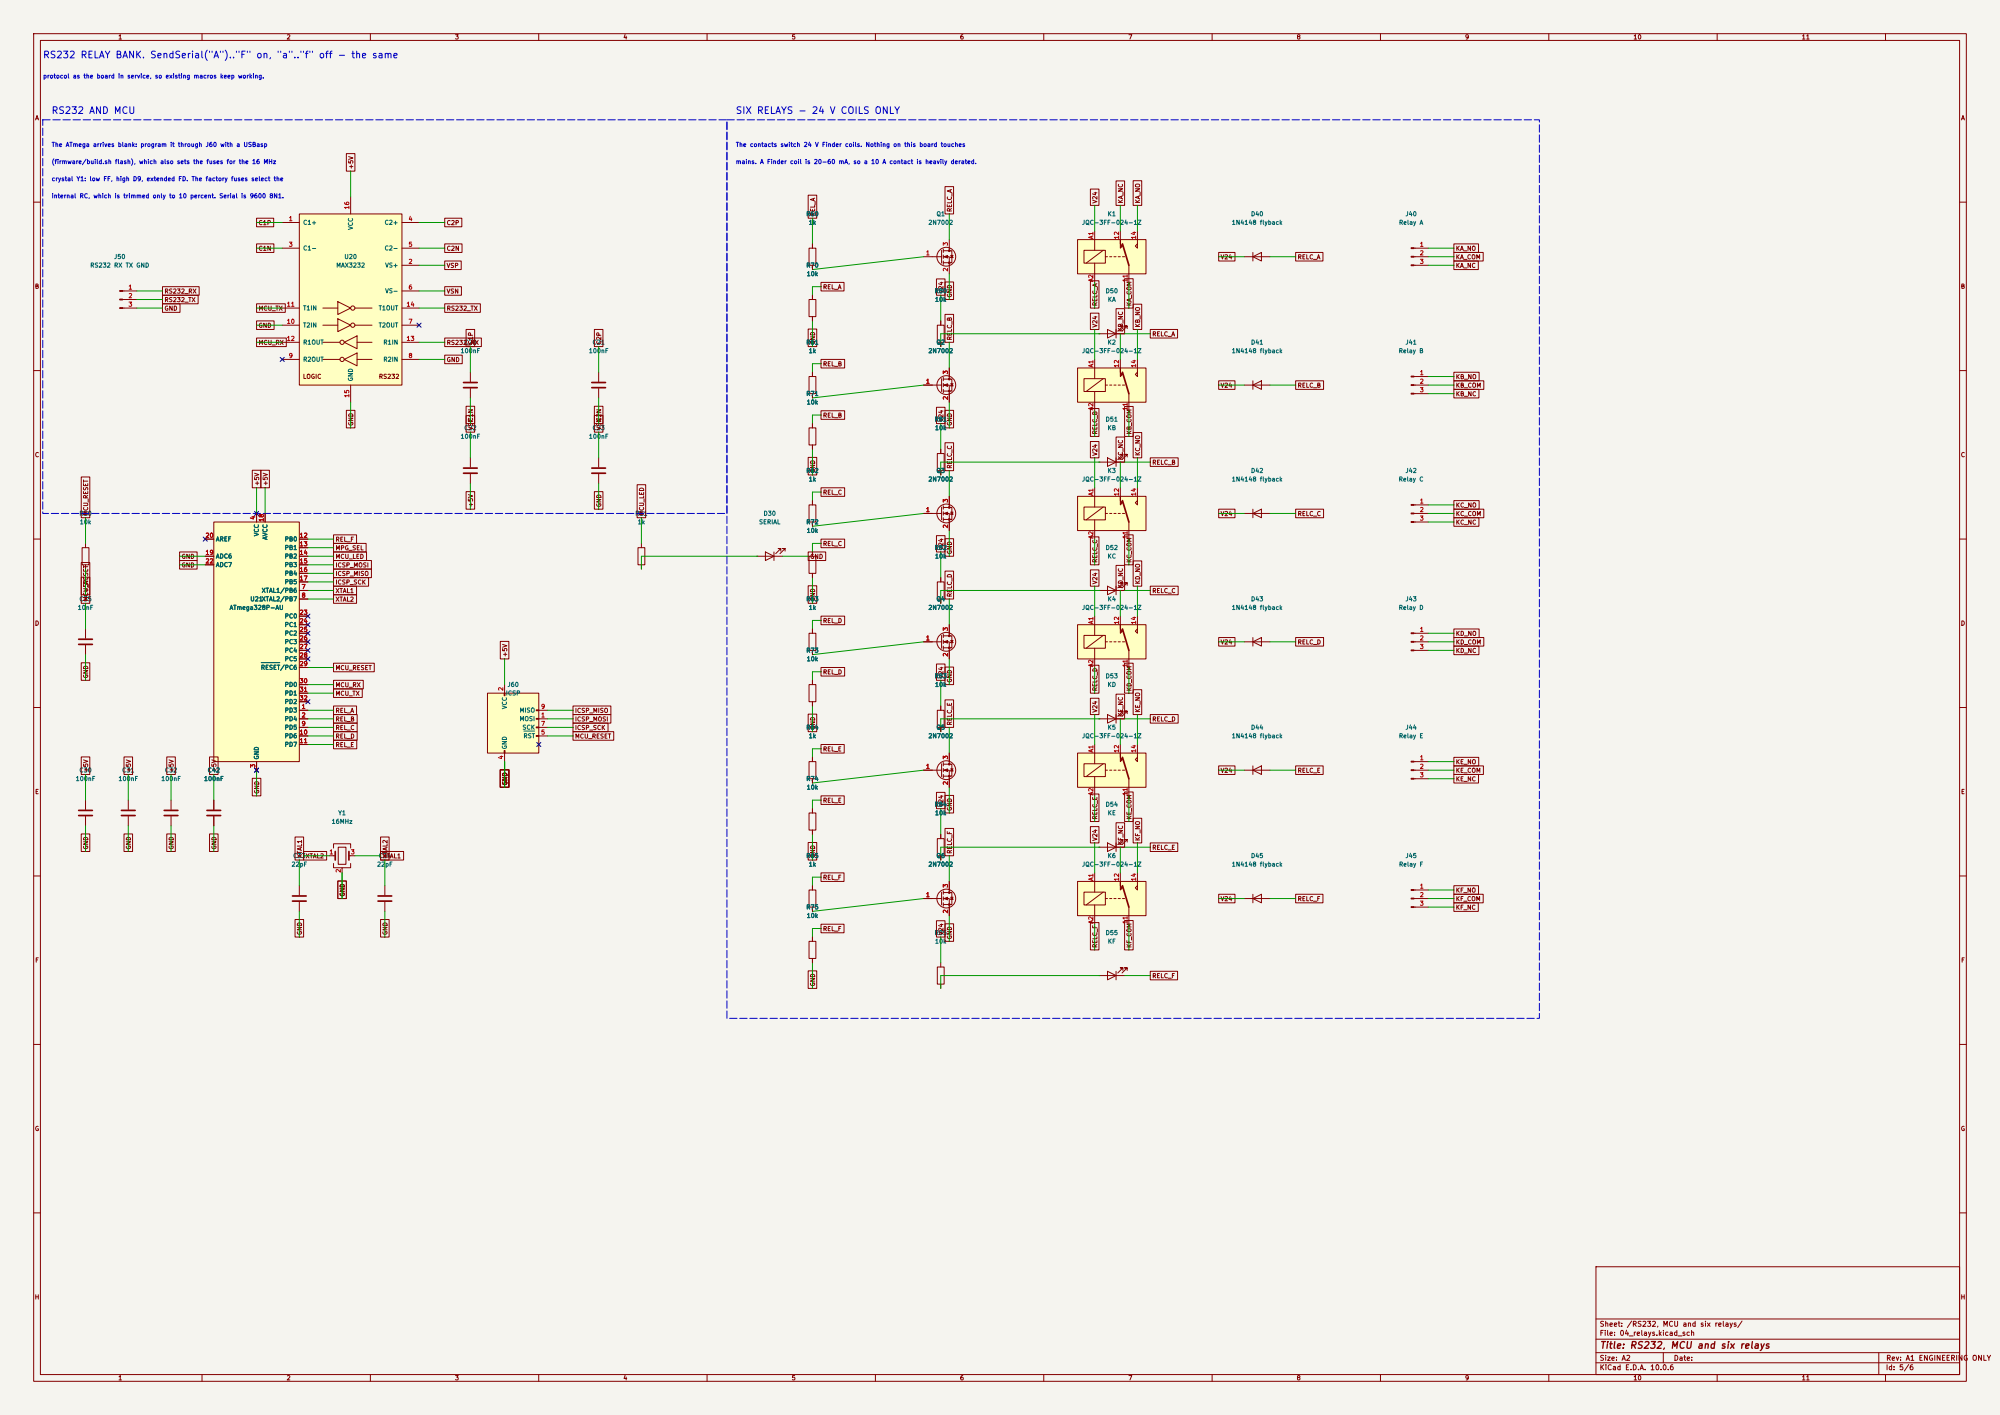
[picture p16: page 5]

The contacts switch 24 V Finder coils. Nothing on this board touches mains. A Finder coil is 20-60 mA, so a 10 A contact is heavily derated. RS232 RELAY BANK. SendSerial("A").."F" on, "a".."f" off - the same

protocol as the board in service, so existing macros keep working.

The ATmega arrives blank: program it through J60 with a USBasp

(firmware/build.sh flash), which also sets the fuses for the 16 MHz crystal Y1: low FF, high D9, extended FD. The factory fuses select the

Sheet: /RS232, MCU and six relays/
File: 04_relays.kicad_sch
Title: RS232, MCU and six relays

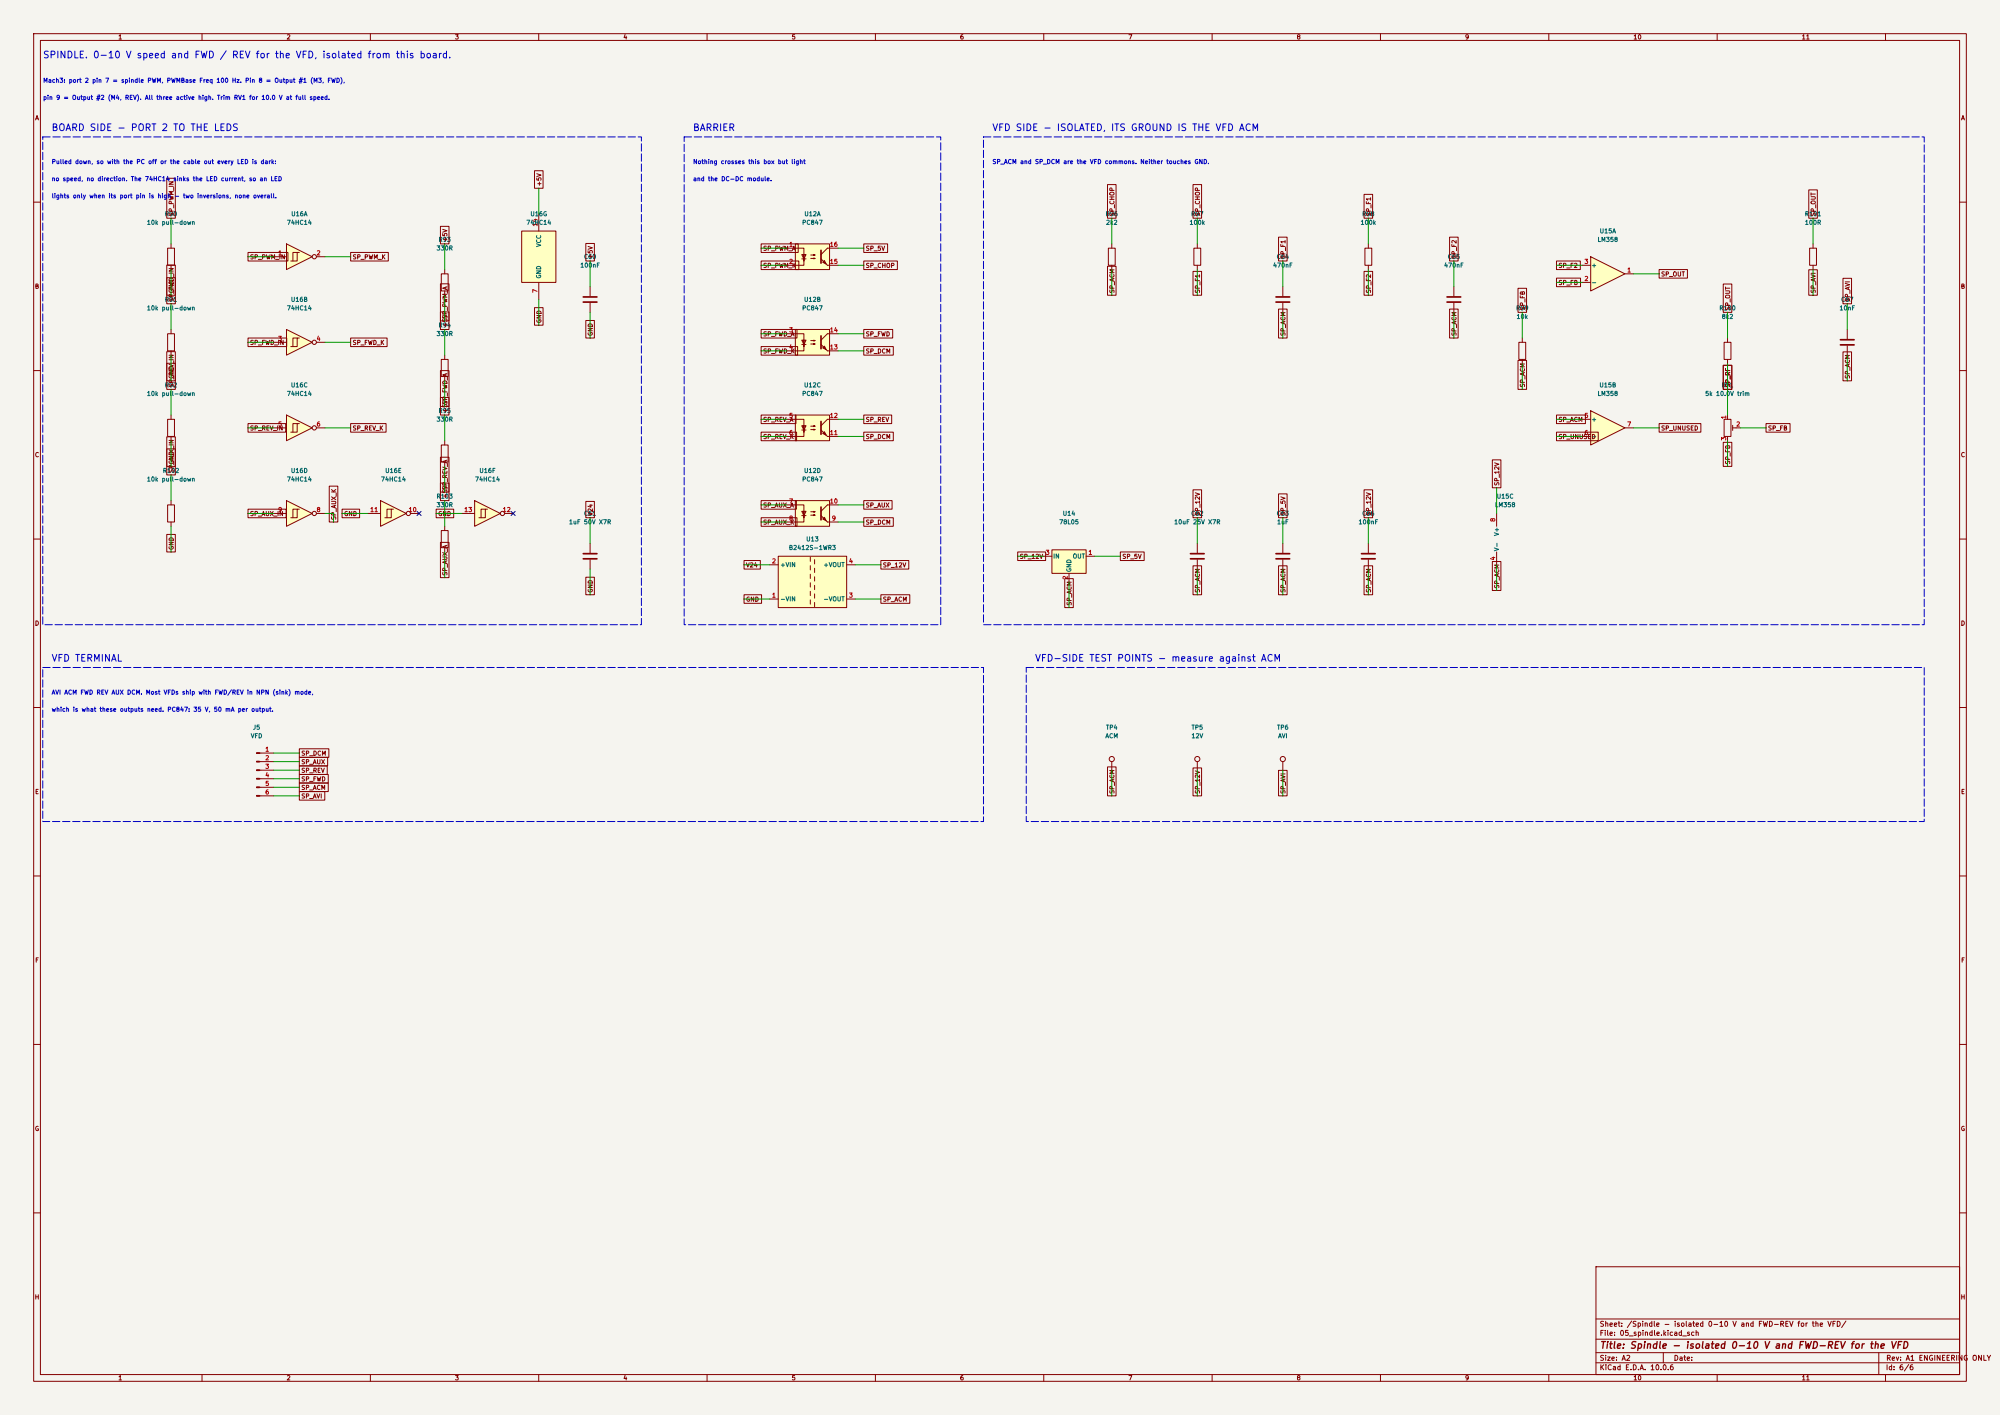
[picture p17: page 6]

lights only when its port pin is high - two inversions, none overall. SPINDLE. 0-10 V speed and FWD / REV for the VFD, isolated from this board. no speed, no direction. The 74HC14 sinks the LED current, so an LED

Nothing crosses this box but light and the DC-DC module. Mach3: port 2 pin 7 = spindle PWM, PWMBase Freq 100 Hz. Pin 8 = Output #1 (M3, FWD),

Pulled down, so with the PC off or the cable out every LED is dark: pin 9 = Output #2 (M4, REV). All three active high. Trim RV1 for 10.0 V at full speed.

BOARD SIDE - PORT 2 TO THE LEDS
10k pull-down R90

SP_ACM and SP_DCM are the VFD commons. Neither touches GND. VFD SIDE - ISOLATED, ITS GROUND IS THE VFD ACM

AVI ACM FWD REV AUX DCM. Most VFDs ship with FWD/REV in NPN (sink) mode, which is what these outputs need. PC847: 35 V, 50 mA per output.

Sheet: /Spindle - isolated 0-10 V and FWD-REV for the VFD/
File: 05_spindle.kicad_sch
Title: Spindle - isolated 0-10 V and FWD-REV for the VFD
