moein98/heimdall/MACH3_SIMPLE/fab/MACH3SIMPLE-assembly.pdf

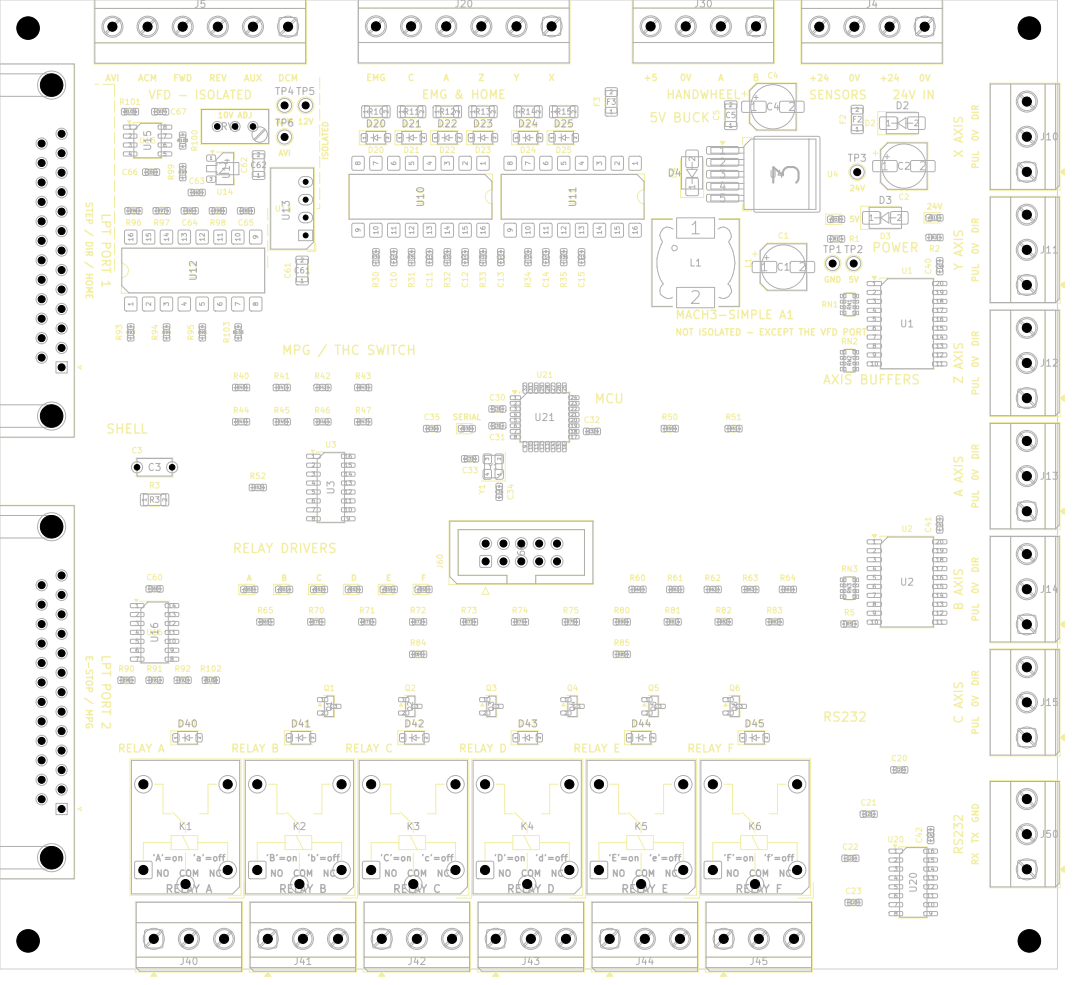
[picture p18: page 1]
