moein98/heimdall/MACH3_SIMPLE/mach3 rs232 inputs 6 outputs 6 - pulse 5v - pnp sens.pdf

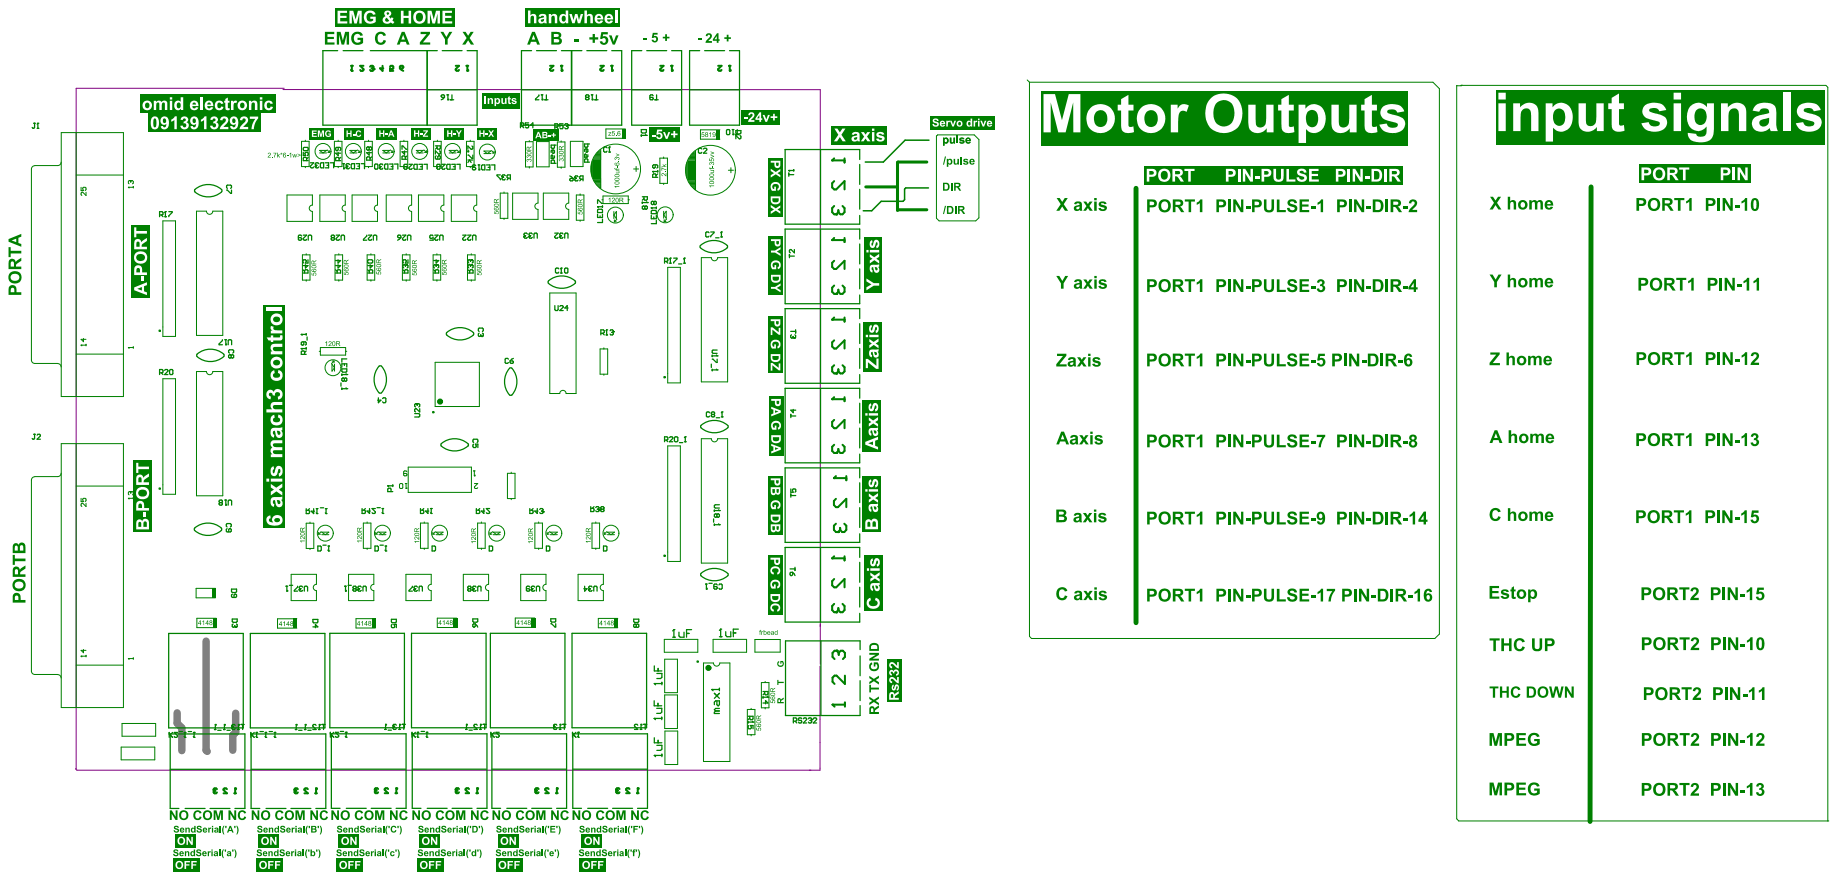
[picture p19: page 1]
