moein98/heimdall/MACH3_SIMPLE/fab/MACH3SIMPLE-copper.pdf

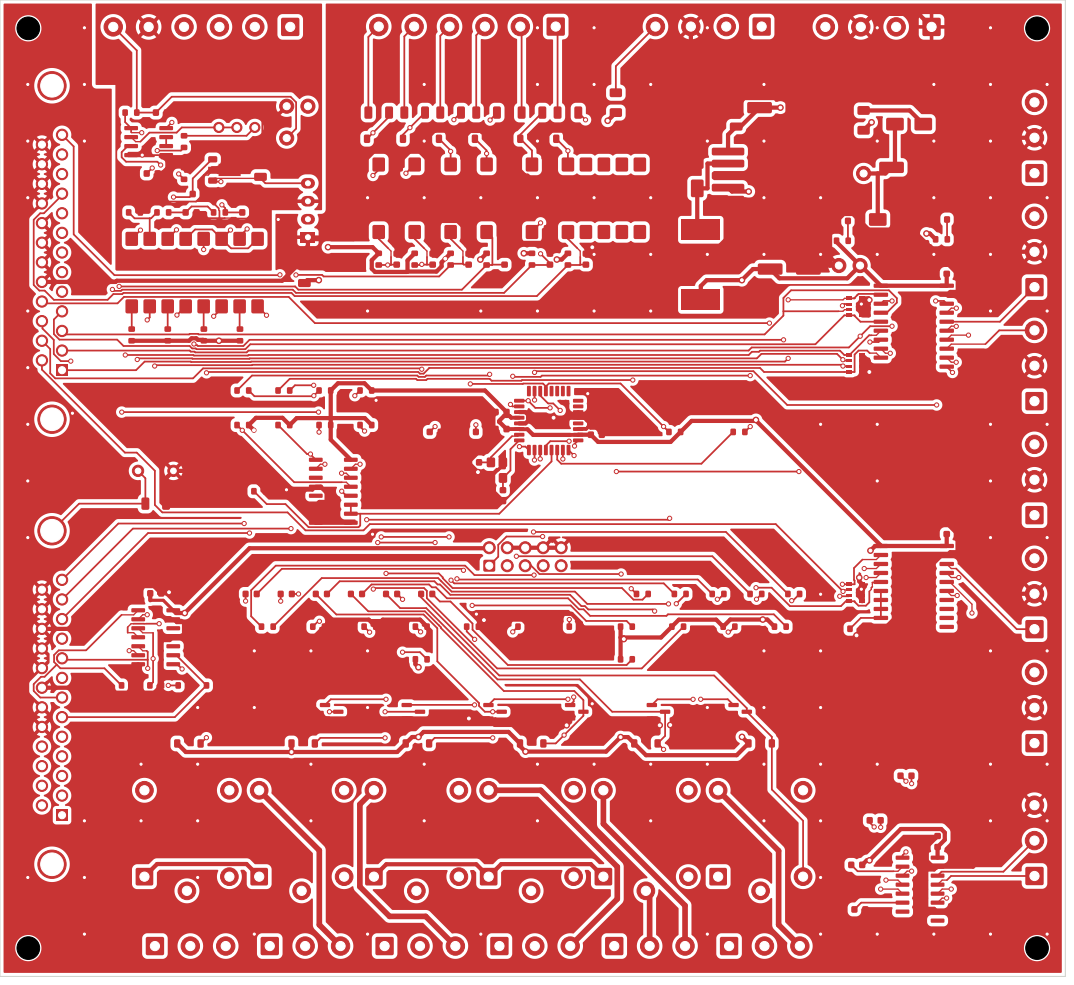
[picture p20: page 1]

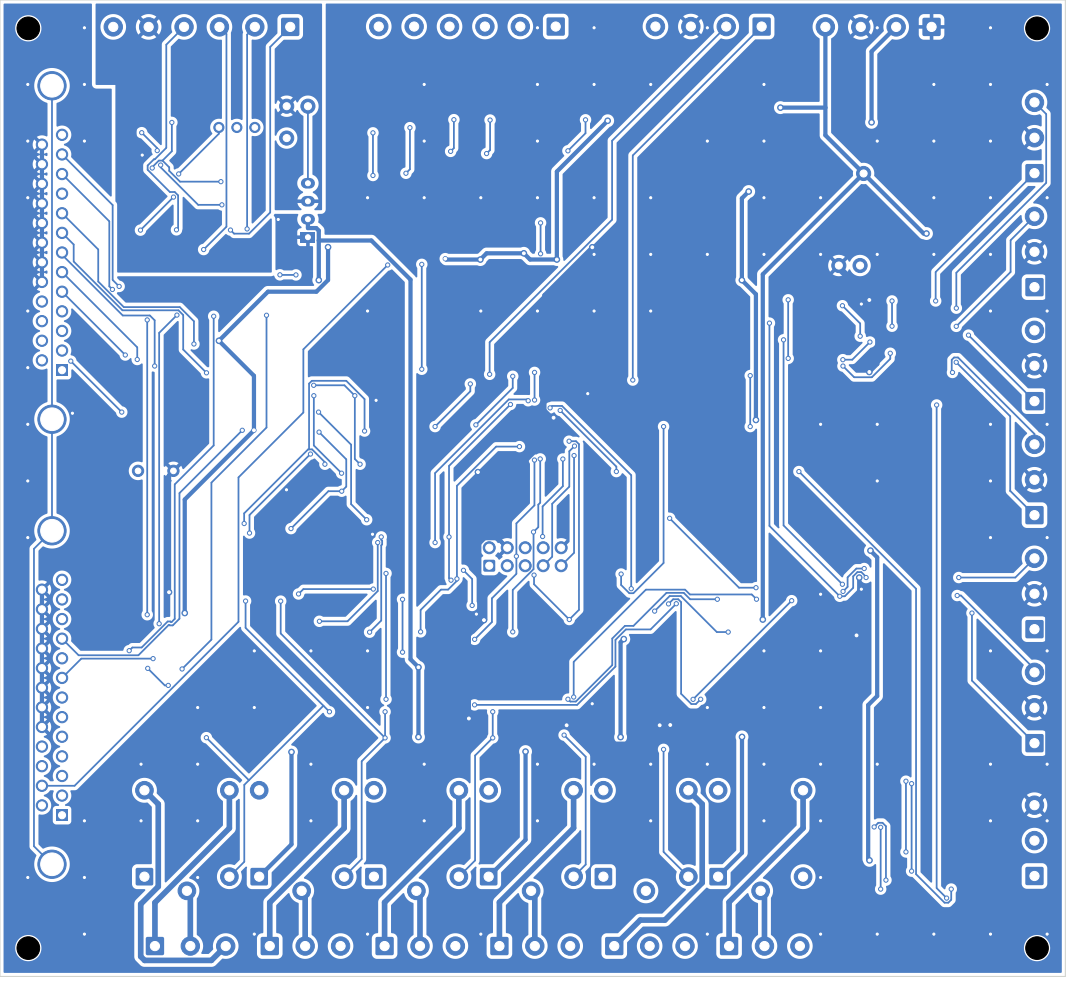
[picture p21: page 2]
