moein98/heimdall/MACH3_SIMPLE_ETH/hardware/MACH3SIMPLEETH.kicad_pcb

## KiCad design MACH3_SIMPLE_ETH/hardware/MACH3SIMPLEETH.kicad_pcb (2026-09-25)

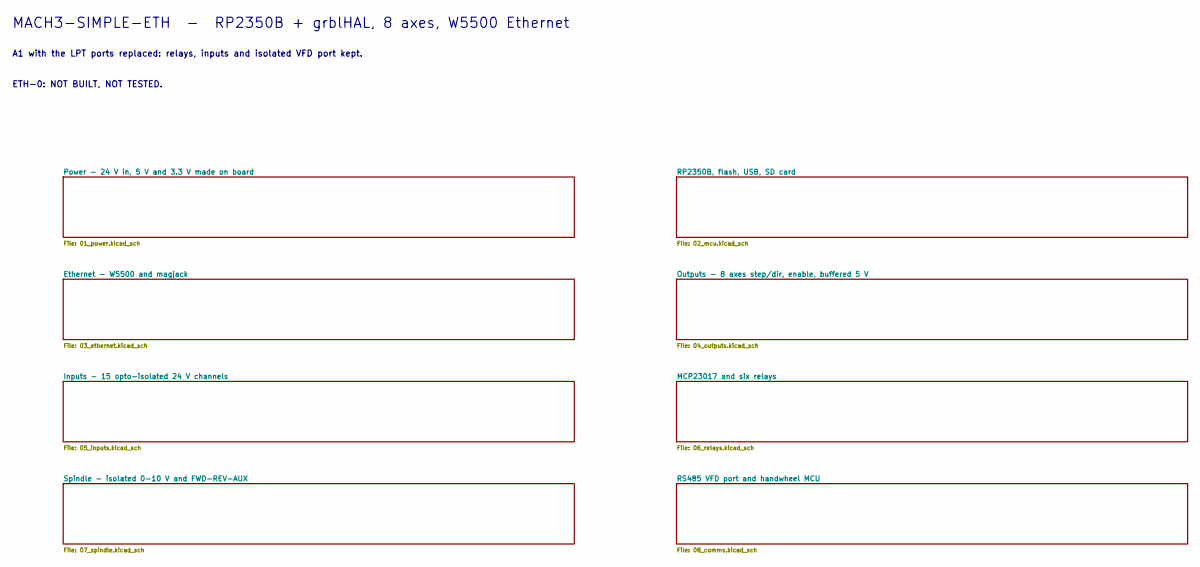
[picture p22: schematic MACH3SIMPLEETH.kicad_sch, MACH3-SIMPLE-ETH]

Notes on the sheet:
MACH3-SIMPLE-ETH - RP2350B + grblHAL, 8 axes, W5500 Ethernet
A1 with the LPT ports replaced: relays, inputs and isolated VFD port kept.
ETH-0: NOT BUILT, NOT TESTED.

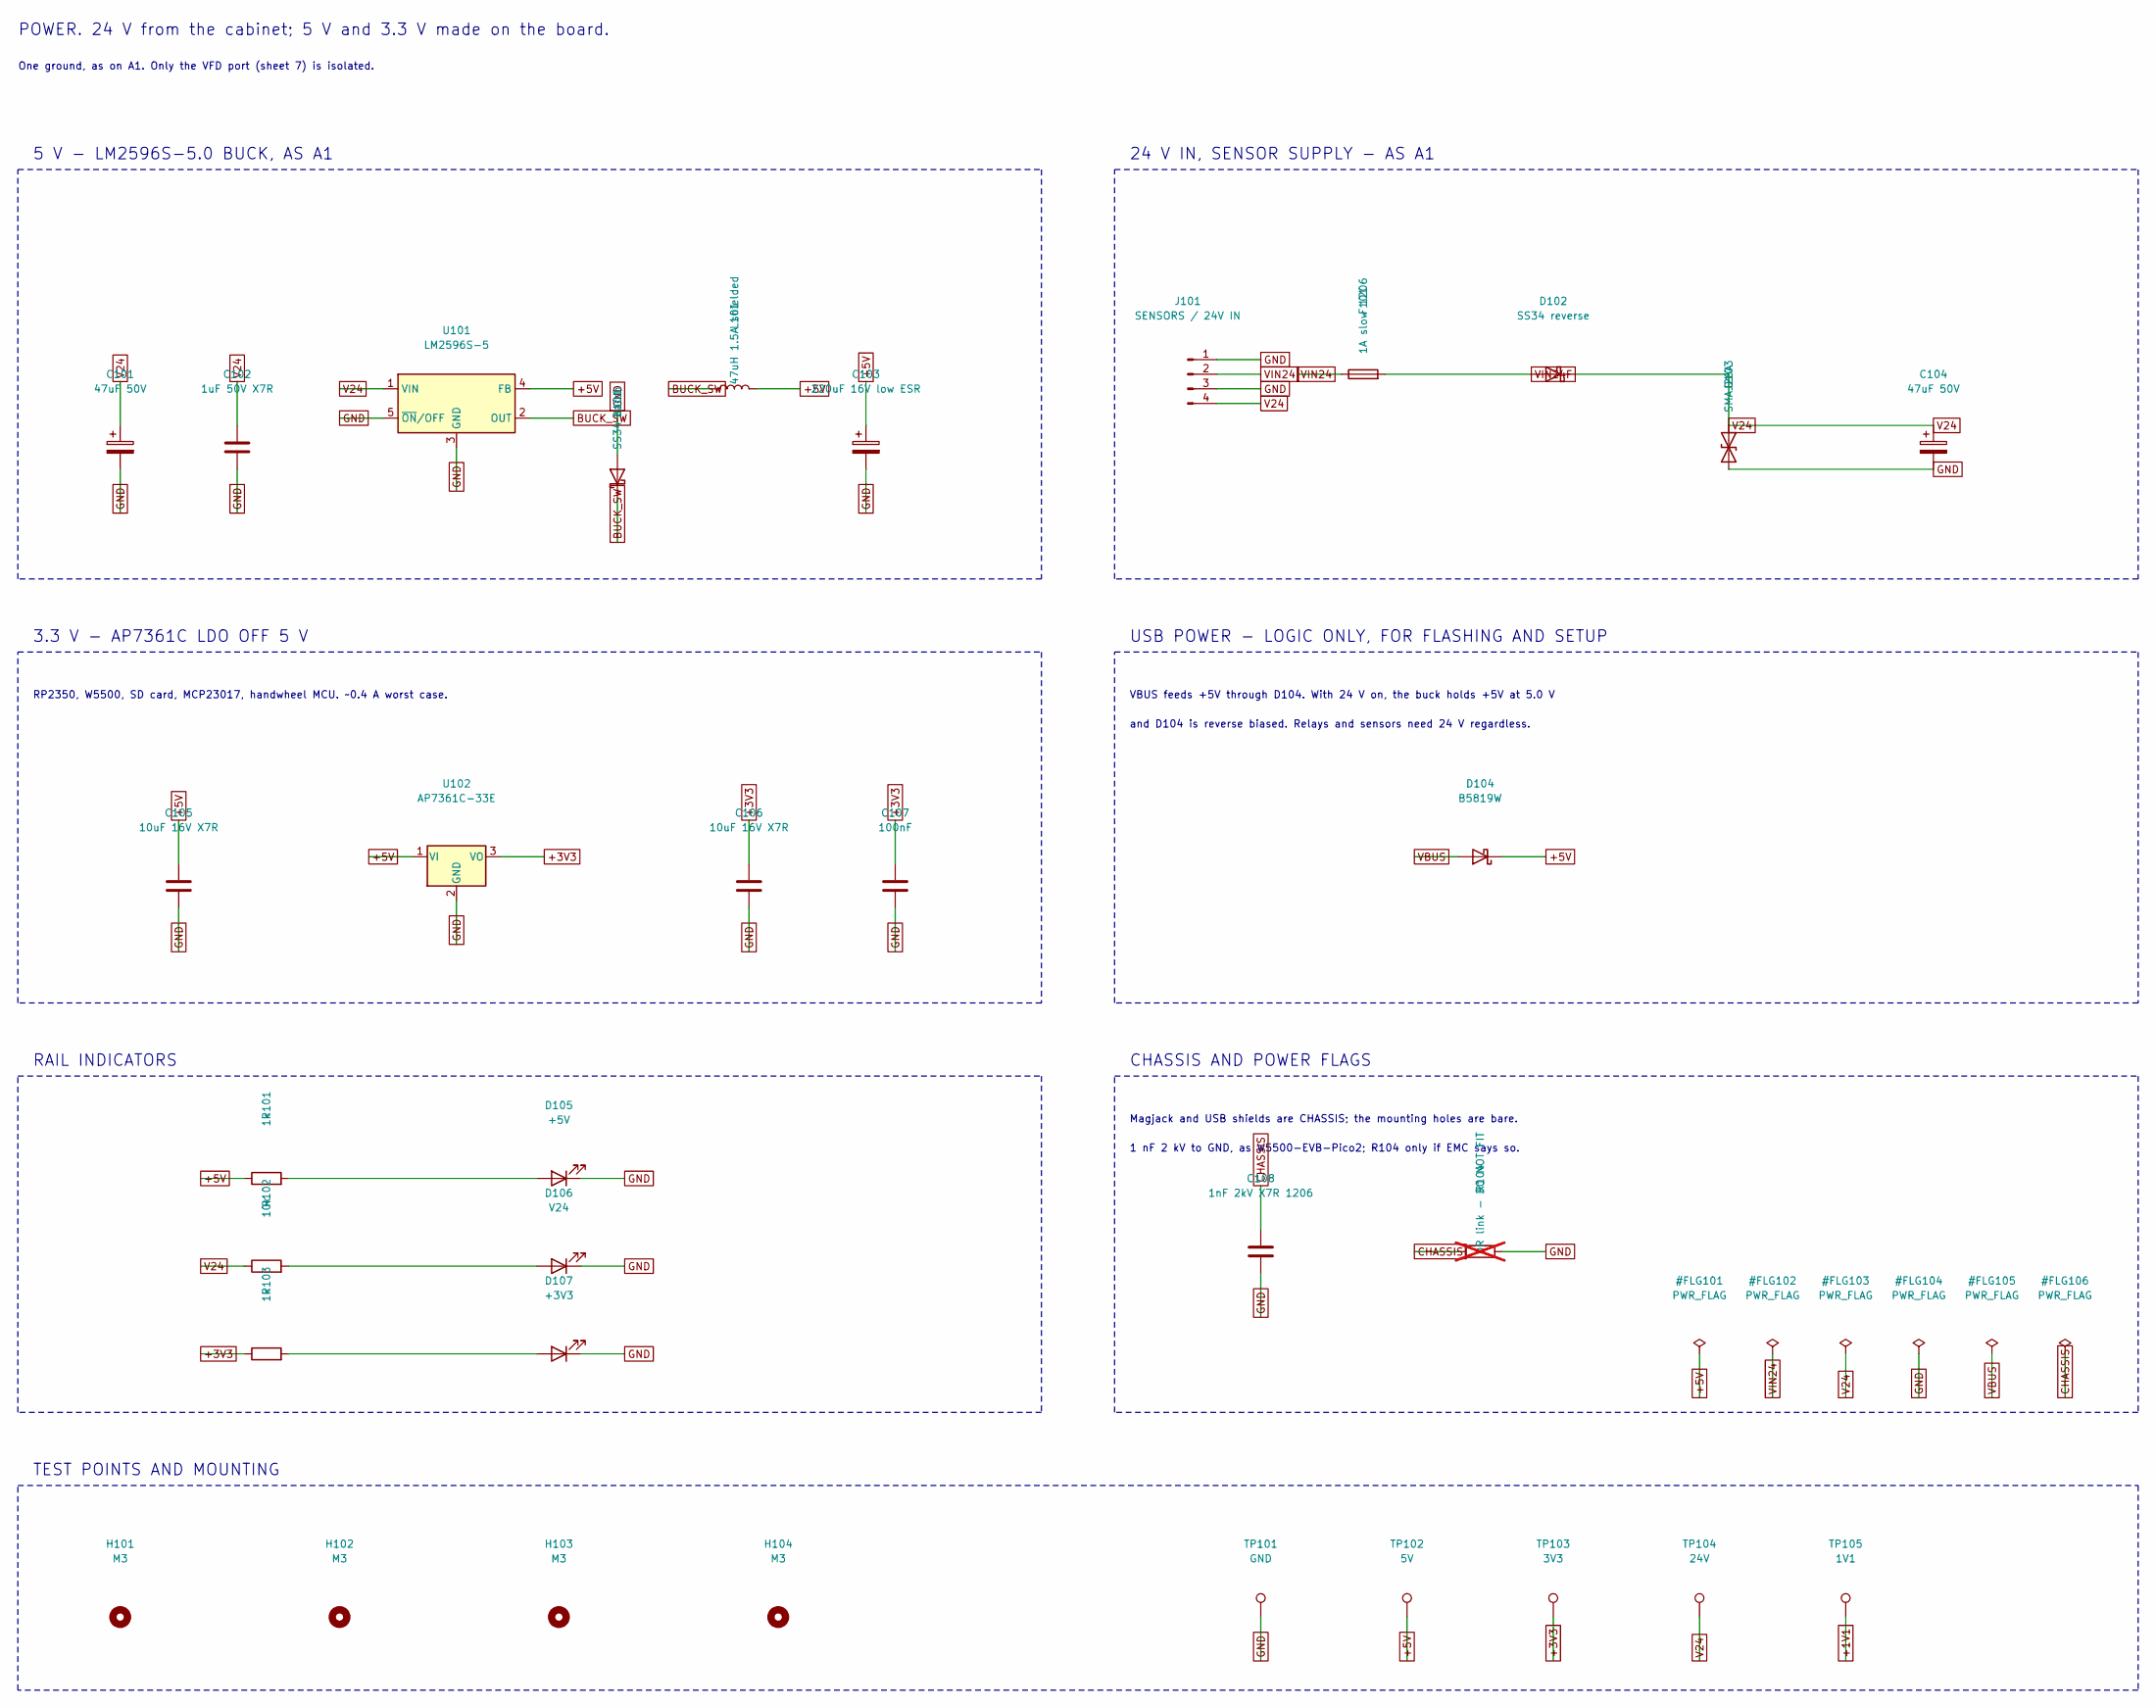
[picture p23: schematic 01_power.kicad_sch, Power - 24 V in, 5 V and 3.3 V made on board]

Parts:
C101, C104: 47uF 50V; CP_Elec_6.3x7.7
C102: 1uF 50V X7R; C_1206_3216Metric
C103: 220uF 16V low ESR; CP_Elec_6.3x7.7
C105, C106: 10uF 16V X7R; C_0805_2012Metric
C107: 100nF; C_0603_1608Metric
C108: 1nF 2kV X7R 1206; C_1206_3216Metric
D101: SS34 catch; D_SMA
D102: SS34 reverse; D_SMA
D103: SMAJ26A; D_SMA
D104: B5819W; D_SOD-123
D105: +5V; LED_0603_1608Metric
D106: V24; LED_0603_1608Metric
D107: +3V3; LED_0603_1608Metric
F101: 1A slow 1206; Fuse_1206_3216Metric
H101, H102, H103, H104: M3; MountingHole_3.2mm_M3
J101: SENSORS / 24V IN; TerminalBlock_Phoenix_MKDS-1,5-4_1x04_P5.00mm_Horizontal
L101: 47uH 1.5A shielded; L_12x12mm_H8mm
R101, R103: 1k; R_0603_1608Metric
R102: 10k; R_0603_1608Metric
R104: 0R link - DO NOT FIT; R_1206_3216Metric; not fitted
TP101: GND; TestPoint_THTPad_D2.0mm_Drill1.0mm
TP102: 5V; TestPoint_THTPad_D2.0mm_Drill1.0mm
TP103: 3V3; TestPoint_THTPad_D2.0mm_Drill1.0mm
TP104: 24V; TestPoint_THTPad_D2.0mm_Drill1.0mm
TP105: 1V1; TestPoint_THTPad_D2.0mm_Drill1.0mm
U101: LM2596S-5; TO-263-5_TabPin3
U102: AP7361C-33E; SOT-223-3_TabPin2

Connections:
+1V1: TP105.1; also elsewhere on the board
+3V3: C106.1, C107.1, R103.1, TP103.1, U102.3 (VO); also elsewhere on the board
+5V: C103.1, C105.1, D104.1 (K), L101.2, R101.1, TP102.1, U101.4 (FB), U102.1 (VI); also elsewhere on the board
BUCK_SW: D101.1 (K), L101.1, U101.2 (OUT)
CHASSIS: C108.1, R104.1; also elsewhere on the board
GND: C101.2, C102.2, C103.2, C104.2, C105.2, C106.2, C107.2, C108.2, D101.2 (A), D103.2 (A2), D105.1 (K), D106.1 (K), D107.1 (K), J101.1, J101.3, R104.2, TP101.1, U101.3 (GND), U101.5 (~ON/OFF), U102.2 (GND); also elsewhere on the board
unnamed: D105.2 (A), R101.2
unnamed: D106.2 (A), R102.2
unnamed: D107.2 (A), R103.2
V24: C101.1, C102.1, C104.1, D102.1 (K), D103.1 (A1), J101.4, R102.1, TP104.1, U101.1 (VIN); also elsewhere on the board
VBUS: D104.2 (A); also elsewhere on the board
VIN24: F101.1, J101.2
VIN24F: D102.2 (A), F101.2

Notes on the sheet:
POWER. 24 V from the cabinet; 5 V and 3.3 V made on the board.
One ground, as on A1. Only the VFD port (sheet 7) is isolated.
5 V - LM2596S-5.0 BUCK, AS A1
24 V IN, SENSOR SUPPLY - AS A1
3.3 V - AP7361C LDO OFF 5 V
RP2350, W5500, SD card, MCP23017, handwheel MCU. ~0.4 A worst case.
USB POWER - LOGIC ONLY, FOR FLASHING AND SETUP
VBUS feeds +5V through D104. With 24 V on, the buck holds +5V at 5.0 V
and D104 is reverse biased. Relays and sensors need 24 V regardless.
RAIL INDICATORS
CHASSIS AND POWER FLAGS
Magjack and USB shields are CHASSIS; the mounting holes are bare.
1 nF 2 kV to GND, as W5500-EVB-Pico2; R104 only if EMC says so.
TEST POINTS AND MOUNTING

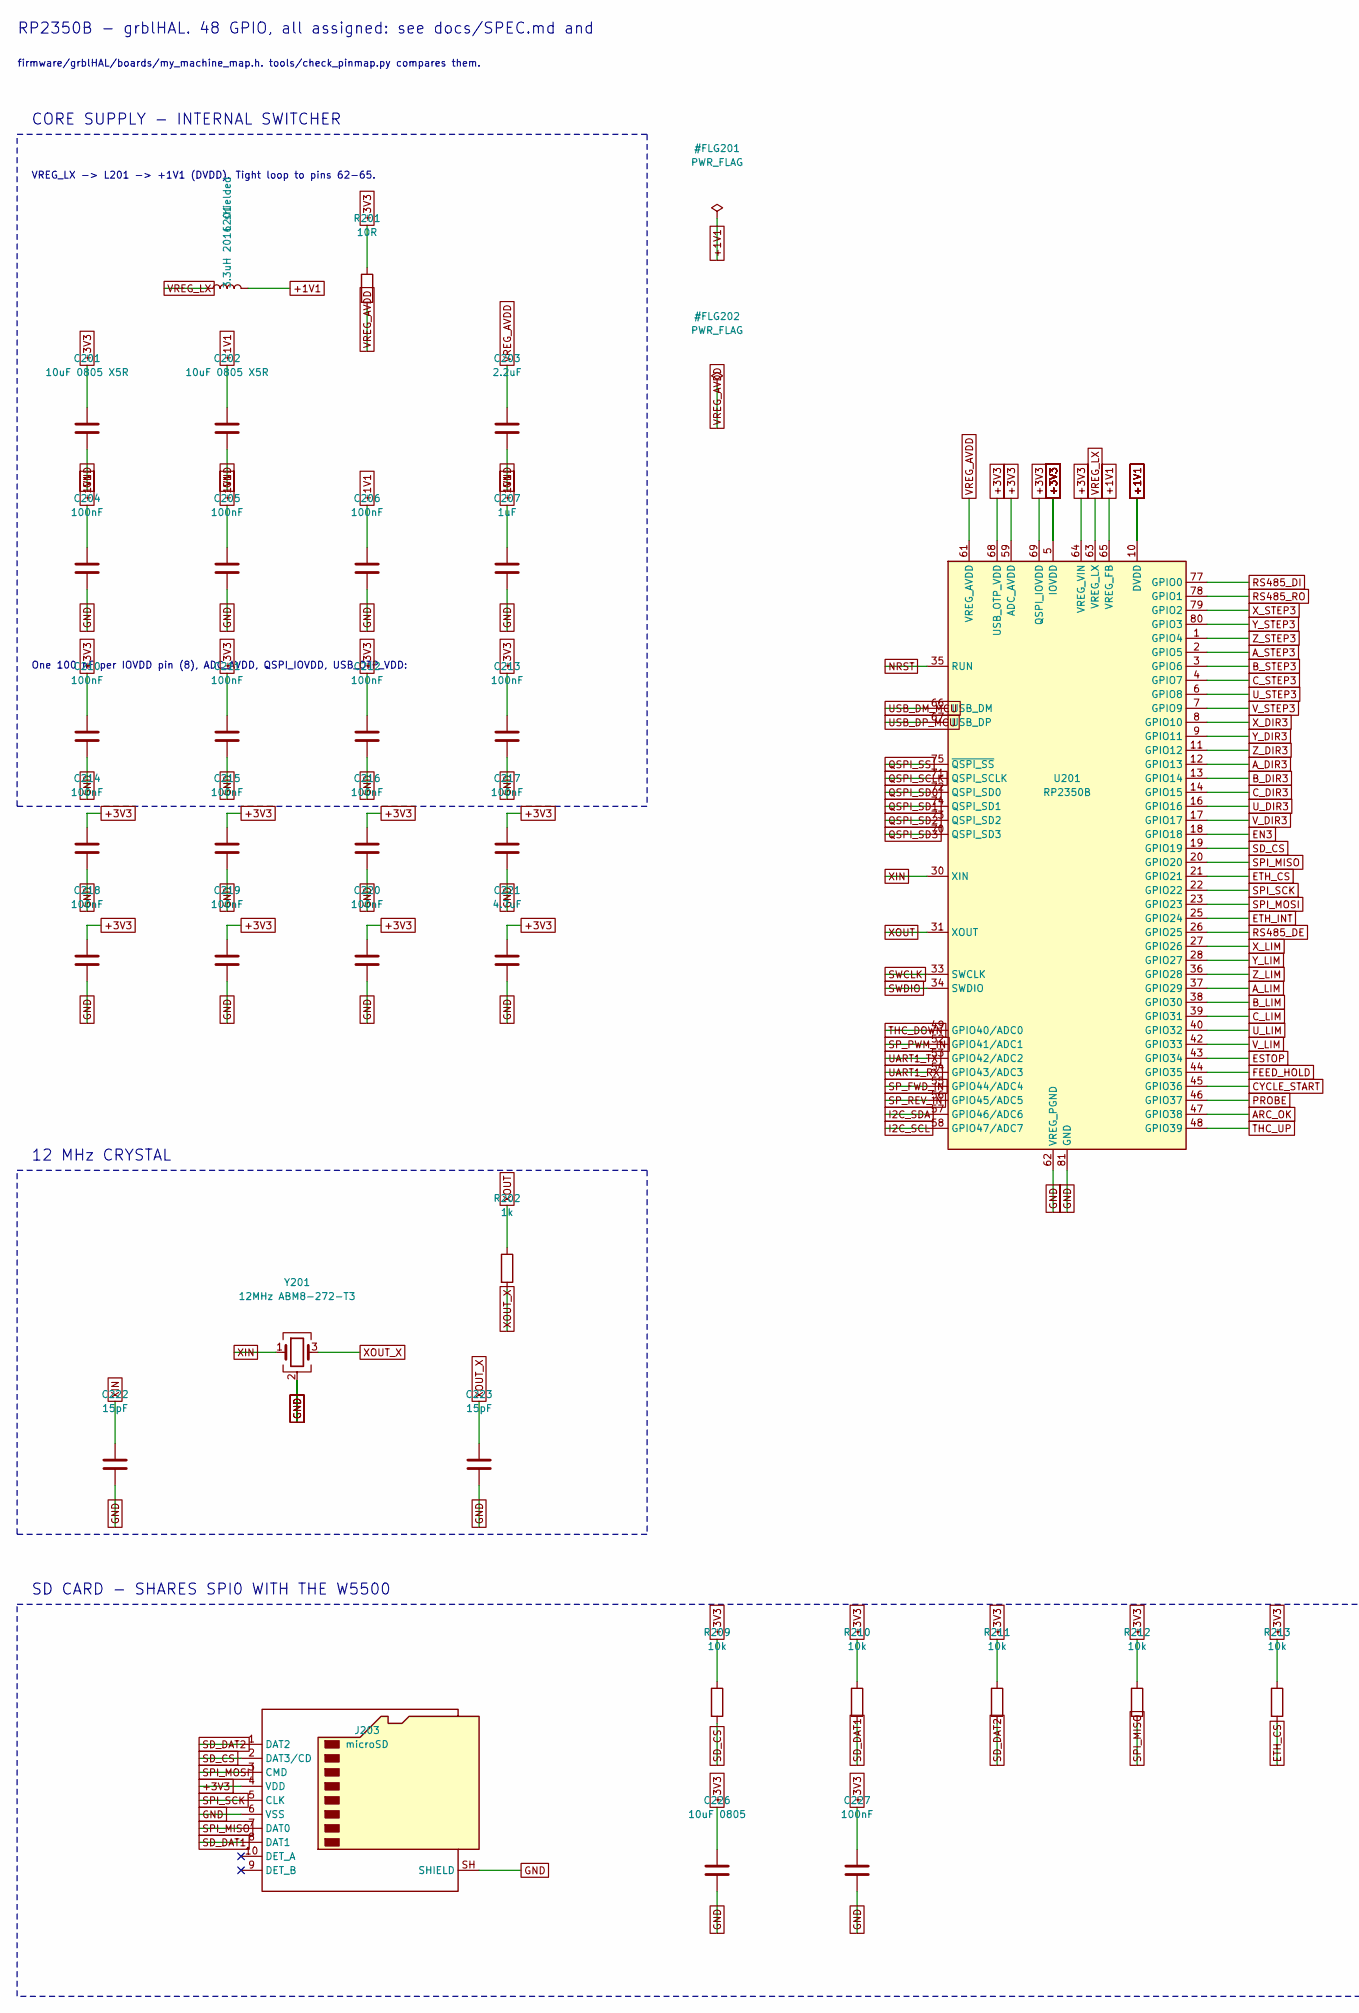
[picture p24: schematic 02_mcu.kicad_sch, RP2350B, flash, USB, SD card, part in row 1, column 1]

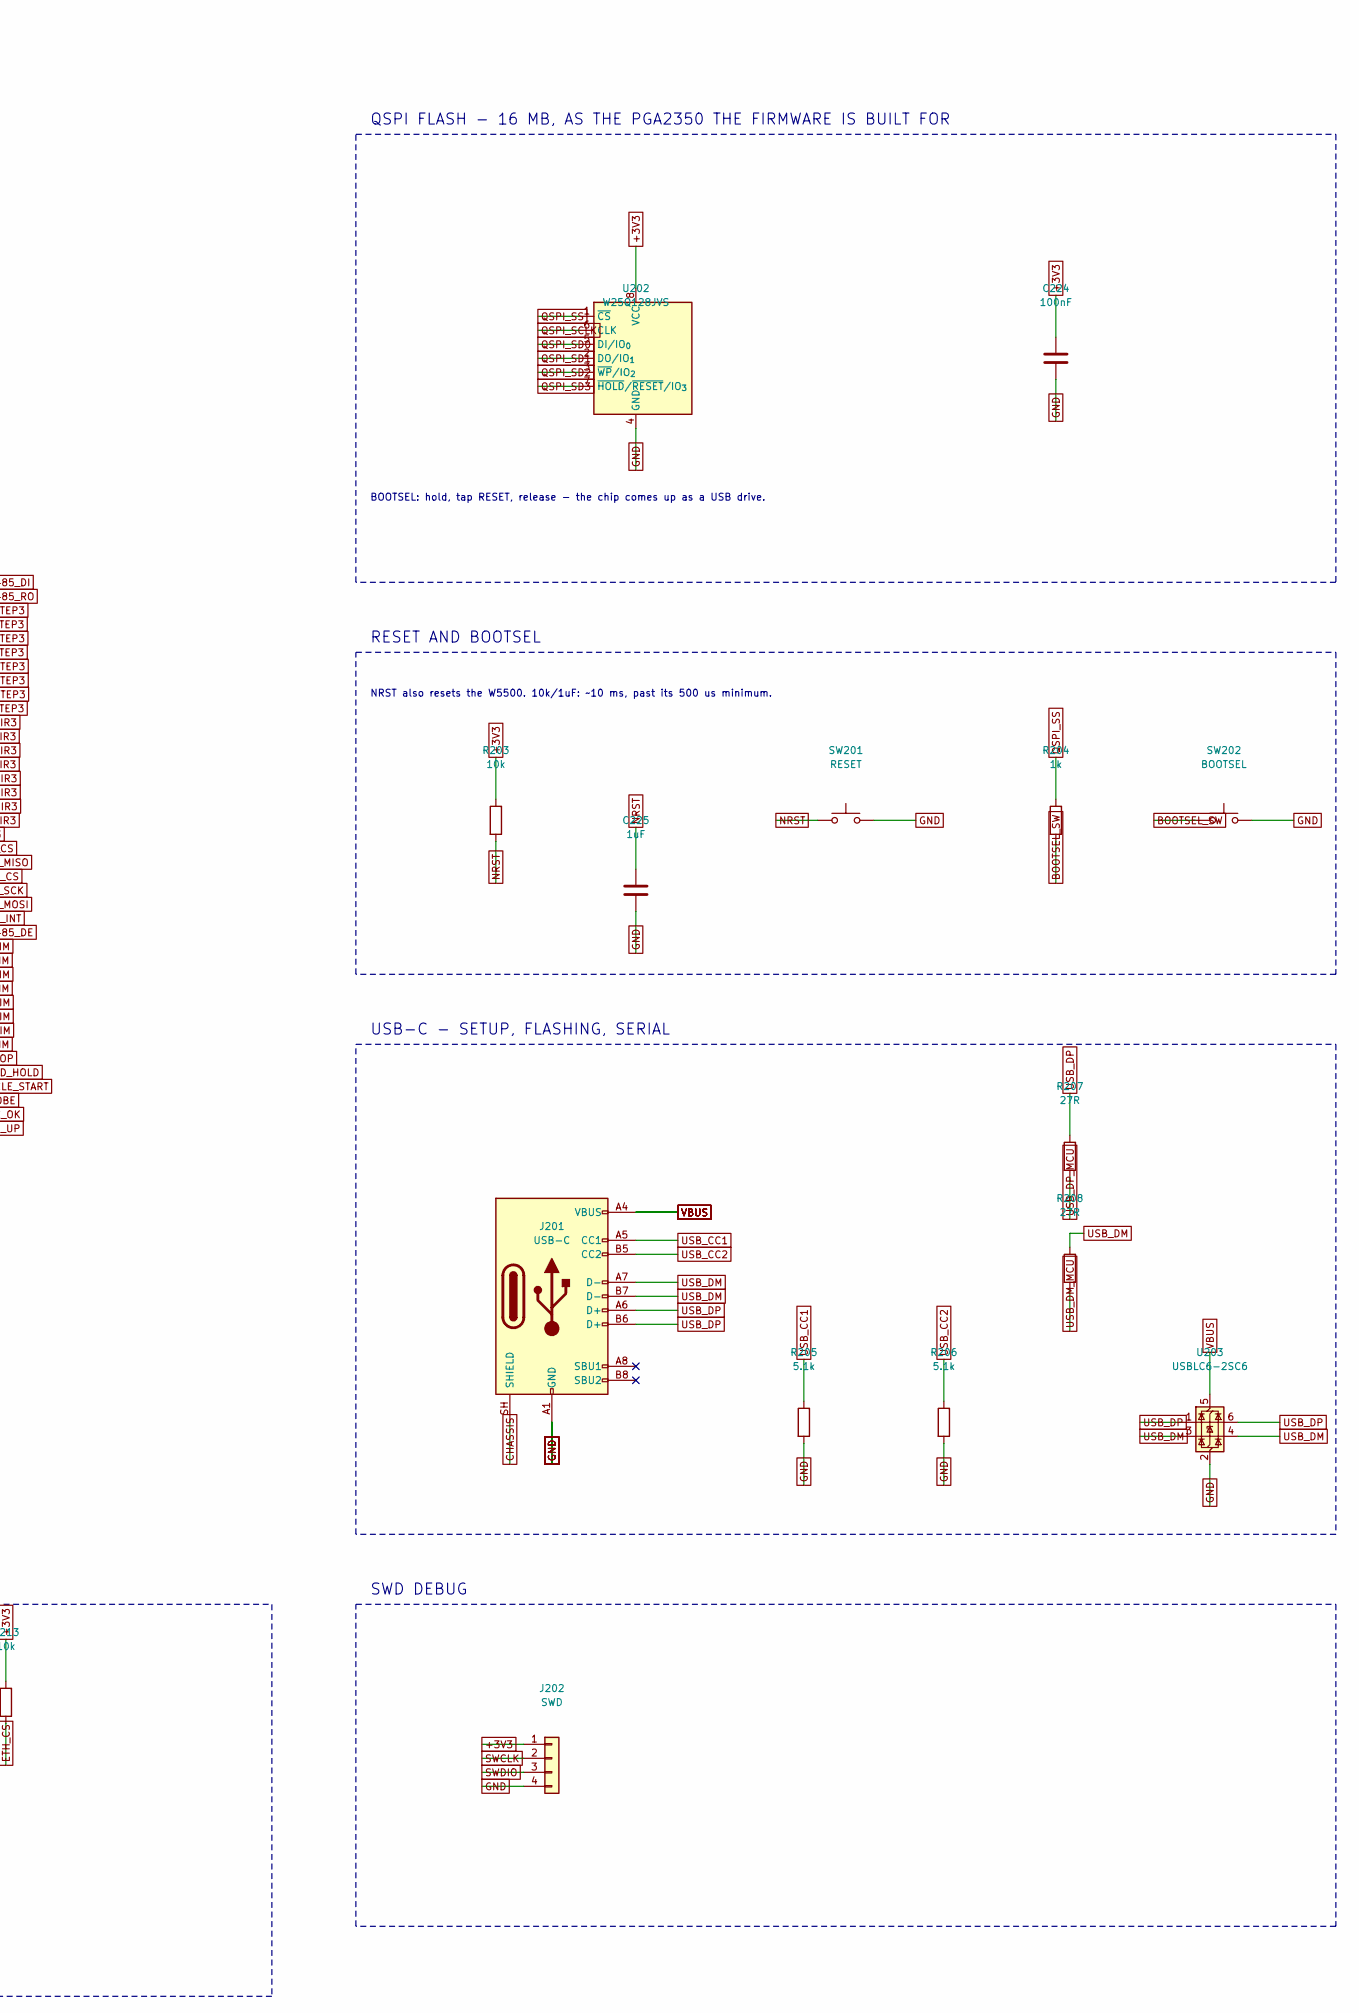
[picture p25: schematic 02_mcu.kicad_sch, RP2350B, flash, USB, SD card, part in row 1, column 2]

Parts:
C201, C202: 10uF 0805 X5R; C_0805_2012Metric
C203: 2.2uF; C_0603_1608Metric
C204, C205, C206, C210, C211, C212, C213, C214, C215, C216, C217, C218, C219, C220, C224, C227: 100nF; C_0603_1608Metric
C207, C225: 1uF; C_0603_1608Metric
C221: 4.7uF; C_0603_1608Metric
C222, C223: 15pF; C_0603_1608Metric
C226: 10uF 0805; C_0805_2012Metric
J201: USB-C; USB_C_Receptacle_HRO_TYPE-C-31-M-12
J202: SWD; PinHeader_1x04_P2.54mm_Vertical
J203: microSD; microSD_HC_Hirose_DM3AT-SF-PEJM5
L201: 3.3uH 2016 shielded; L_Murata_DFE201610P
R201: 10R; R_0603_1608Metric
R202, R204: 1k; R_0603_1608Metric
R203, R209, R210, R211, R212, R213: 10k; R_0603_1608Metric
R205, R206: 5.1k; R_0603_1608Metric
R207, R208: 27R; R_0603_1608Metric
SW201: RESET; SW_SPST_PTS810
SW202: BOOTSEL; SW_SPST_PTS810
U201: RP2350B; QFN-80-1EP_10x10mm_P0.4mm_EP3.4x3.4mm
U202: W25Q128JVS; SOIC-8_5.3x5.3mm_P1.27mm
U203: USBLC6-2SC6; SOT-23-6
Y201: 12MHz ABM8-272-T3; Crystal_SMD_3225-4Pin_3.2x2.5mm

Connections:
+1V1: C202.1, C204.1, C205.1, C206.1, C207.1, L201.2, U201.10 (DVDD), U201.32 (DVDD), U201.51 (DVDD), U201.65 (VREG_FB); also elsewhere on the board
+3V3: C201.1, C210.1, C211.1, C212.1, C213.1, C214.1, C215.1, C216.1, C217.1, C218.1, C219.1, C220.1, C221.1, C224.1, C226.1, C227.1, J202.1, J203.4 (VDD), R201.1, R203.1, R209.1, R210.1, R211.1, R212.1, R213.1, U201.5 (IOVDD), U201.15 (IOVDD), U201.24 (IOVDD), U201.29 (IOVDD), U201.41 (IOVDD), U201.50 (IOVDD), U201.59 (ADC_AVDD), U201.60 (IOVDD), U201.64 (VREG_VIN), U201.68 (USB_OTP_VDD), U201.69 (QSPI_IOVDD), U201.76 (IOVDD), U202.8 (VCC); also elsewhere on the board
ARC_OK: U201.47 (GPIO38); also elsewhere on the board
A_DIR3: U201.12 (GPIO13); also elsewhere on the board
A_LIM: U201.37 (GPIO29); also elsewhere on the board
A_STEP3: U201.2 (GPIO5); also elsewhere on the board
BOOTSEL_SW: R204.2, SW202.1
B_DIR3: U201.13 (GPIO14); also elsewhere on the board
B_LIM: U201.38 (GPIO30); also elsewhere on the board
B_STEP3: U201.3 (GPIO6); also elsewhere on the board
CHASSIS: J201.SH (SHIELD); also elsewhere on the board
CYCLE_START: U201.45 (GPIO36); also elsewhere on the board
C_DIR3: U201.14 (GPIO15); also elsewhere on the board
C_LIM: U201.39 (GPIO31); also elsewhere on the board
C_STEP3: U201.4 (GPIO7); also elsewhere on the board
EN3: U201.18 (GPIO18); also elsewhere on the board
ESTOP: U201.43 (GPIO34); also elsewhere on the board
ETH_CS: R213.2, U201.21 (GPIO21); also elsewhere on the board
ETH_INT: U201.25 (GPIO24); also elsewhere on the board
FEED_HOLD: U201.44 (GPIO35); also elsewhere on the board
GND: C201.2, C202.2, C203.2, C204.2, C205.2, C206.2, C207.2, C210.2, C211.2, C212.2, C213.2, C214.2, C215.2, C216.2, C217.2, C218.2, C219.2, C220.2, C221.2, C222.2, C223.2, C224.2, C225.2, C226.2, C227.2, J201.A1 (GND), J201.A12 (GND), J201.B1 (GND), J201.B12 (GND), J202.4, J203.6 (VSS), J203.SH (SHIELD), R205.2, R206.2, SW201.2, SW202.2, U201.62 (VREG_PGND), U201.81 (GND), U202.4 (GND), U203.2 (GND), Y201.2 (G), Y201.4 (G); also elsewhere on the board
I2C_SCL: U201.58 (GPIO47/ADC7); also elsewhere on the board
I2C_SDA: U201.57 (GPIO46/ADC6); also elsewhere on the board
NRST: C225.1, R203.2, SW201.1, U201.35 (RUN); also elsewhere on the board
PROBE: U201.46 (GPIO37); also elsewhere on the board
QSPI_SCLK: U201.71 (QSPI_SCLK), U202.6 (CLK)
QSPI_SD0: U201.72 (QSPI_SD0), U202.5 (DI/IO_{0})
QSPI_SD1: U201.74 (QSPI_SD1), U202.2 (DO/IO_{1})
QSPI_SD2: U201.73 (QSPI_SD2), U202.3 (~WP/IO_{2})
QSPI_SD3: U201.70 (QSPI_SD3), U202.7 (~HOLD/~RESET/IO_{3})
QSPI_SS: R204.1, U201.75 (~QSPI_SS), U202.1 (~CS)
RS485_DE: U201.26 (GPIO25); also elsewhere on the board
RS485_DI: U201.77 (GPIO0); also elsewhere on the board
RS485_RO: U201.78 (GPIO1); also elsewhere on the board
SD_CS: J203.2 (DAT3/CD), R209.2, U201.19 (GPIO19)
SD_DAT1: J203.8 (DAT1), R210.2
SD_DAT2: J203.1 (DAT2), R211.2
SPI_MISO: J203.7 (DAT0), R212.2, U201.20 (GPIO20); also elsewhere on the board
SPI_MOSI: J203.3 (CMD), U201.23 (GPIO23); also elsewhere on the board
SPI_SCK: J203.5 (CLK), U201.22 (GPIO22); also elsewhere on the board
SP_FWD_IN: U201.55 (GPIO44/ADC4); also elsewhere on the board
SP_PWM_IN: U201.52 (GPIO41/ADC1); also elsewhere on the board
SP_REV_IN: U201.56 (GPIO45/ADC5); also elsewhere on the board
SWCLK: J202.2, U201.33 (SWCLK)
SWDIO: J202.3, U201.34 (SWDIO)
THC_DOWN: U201.49 (GPIO40/ADC0); also elsewhere on the board
THC_UP: U201.48 (GPIO39); also elsewhere on the board
UART1_RX: U201.54 (GPIO43/ADC3); also elsewhere on the board
UART1_TX: U201.53 (GPIO42/ADC2); also elsewhere on the board
USB_CC1: J201.A5 (CC1), R205.1
USB_CC2: J201.B5 (CC2), R206.1
USB_DM: J201.A7 (D-), J201.B7 (D-), R208.1, U203.3 (I/O2), U203.4 (I/O2)
USB_DM_MCU: R208.2, U201.66 (USB_DM)
USB_DP: J201.A6 (D+), J201.B6 (D+), R207.1, U203.1 (I/O1), U203.6 (I/O1)
USB_DP_MCU: R207.2, U201.67 (USB_DP)
U_DIR3: U201.16 (GPIO16); also elsewhere on the board
U_LIM: U201.40 (GPIO32); also elsewhere on the board
U_STEP3: U201.6 (GPIO8); also elsewhere on the board
VBUS: J201.A4 (VBUS), J201.A9 (VBUS), J201.B4 (VBUS), J201.B9 (VBUS), U203.5 (VBUS); also elsewhere on the board
VREG_AVDD: C203.1, R201.2, U201.61 (VREG_AVDD)
VREG_LX: L201.1, U201.63 (VREG_LX)
V_DIR3: U201.17 (GPIO17); also elsewhere on the board
V_LIM: U201.42 (GPIO33); also elsewhere on the board
V_STEP3: U201.7 (GPIO9); also elsewhere on the board
XIN: C222.1, U201.30 (XIN), Y201.1
XOUT: R202.1, U201.31 (XOUT)
XOUT_X: C223.1, R202.2, Y201.3
X_DIR3: U201.8 (GPIO10); also elsewhere on the board
X_LIM: U201.27 (GPIO26); also elsewhere on the board
X_STEP3: U201.79 (GPIO2); also elsewhere on the board
Y_DIR3: U201.9 (GPIO11); also elsewhere on the board
Y_LIM: U201.28 (GPIO27); also elsewhere on the board
Y_STEP3: U201.80 (GPIO3); also elsewhere on the board
Z_DIR3: U201.11 (GPIO12); also elsewhere on the board
Z_LIM: U201.36 (GPIO28); also elsewhere on the board
Z_STEP3: U201.1 (GPIO4); also elsewhere on the board

Notes on the sheet:
RP2350B - grblHAL. 48 GPIO, all assigned: see docs/SPEC.md and
firmware/grblHAL/boards/my_machine_map.h. tools/check_pinmap.py compares them.
CORE SUPPLY - INTERNAL SWITCHER
VREG_LX -> L201 -> +1V1 (DVDD). Tight loop to pins 62-65.
One 100 nF per IOVDD pin (8), ADC_AVDD, QSPI_IOVDD, USB_OTP_VDD:
12 MHz CRYSTAL
QSPI FLASH - 16 MB, AS THE PGA2350 THE FIRMWARE IS BUILT FOR
BOOTSEL: hold, tap RESET, release - the chip comes up as a USB drive.
RESET AND BOOTSEL
NRST also resets the W5500. 10k/1uF: ~10 ms, past its 500 us minimum.
USB-C - SETUP, FLASHING, SERIAL
SWD DEBUG
SD CARD - SHARES SPI0 WITH THE W5500

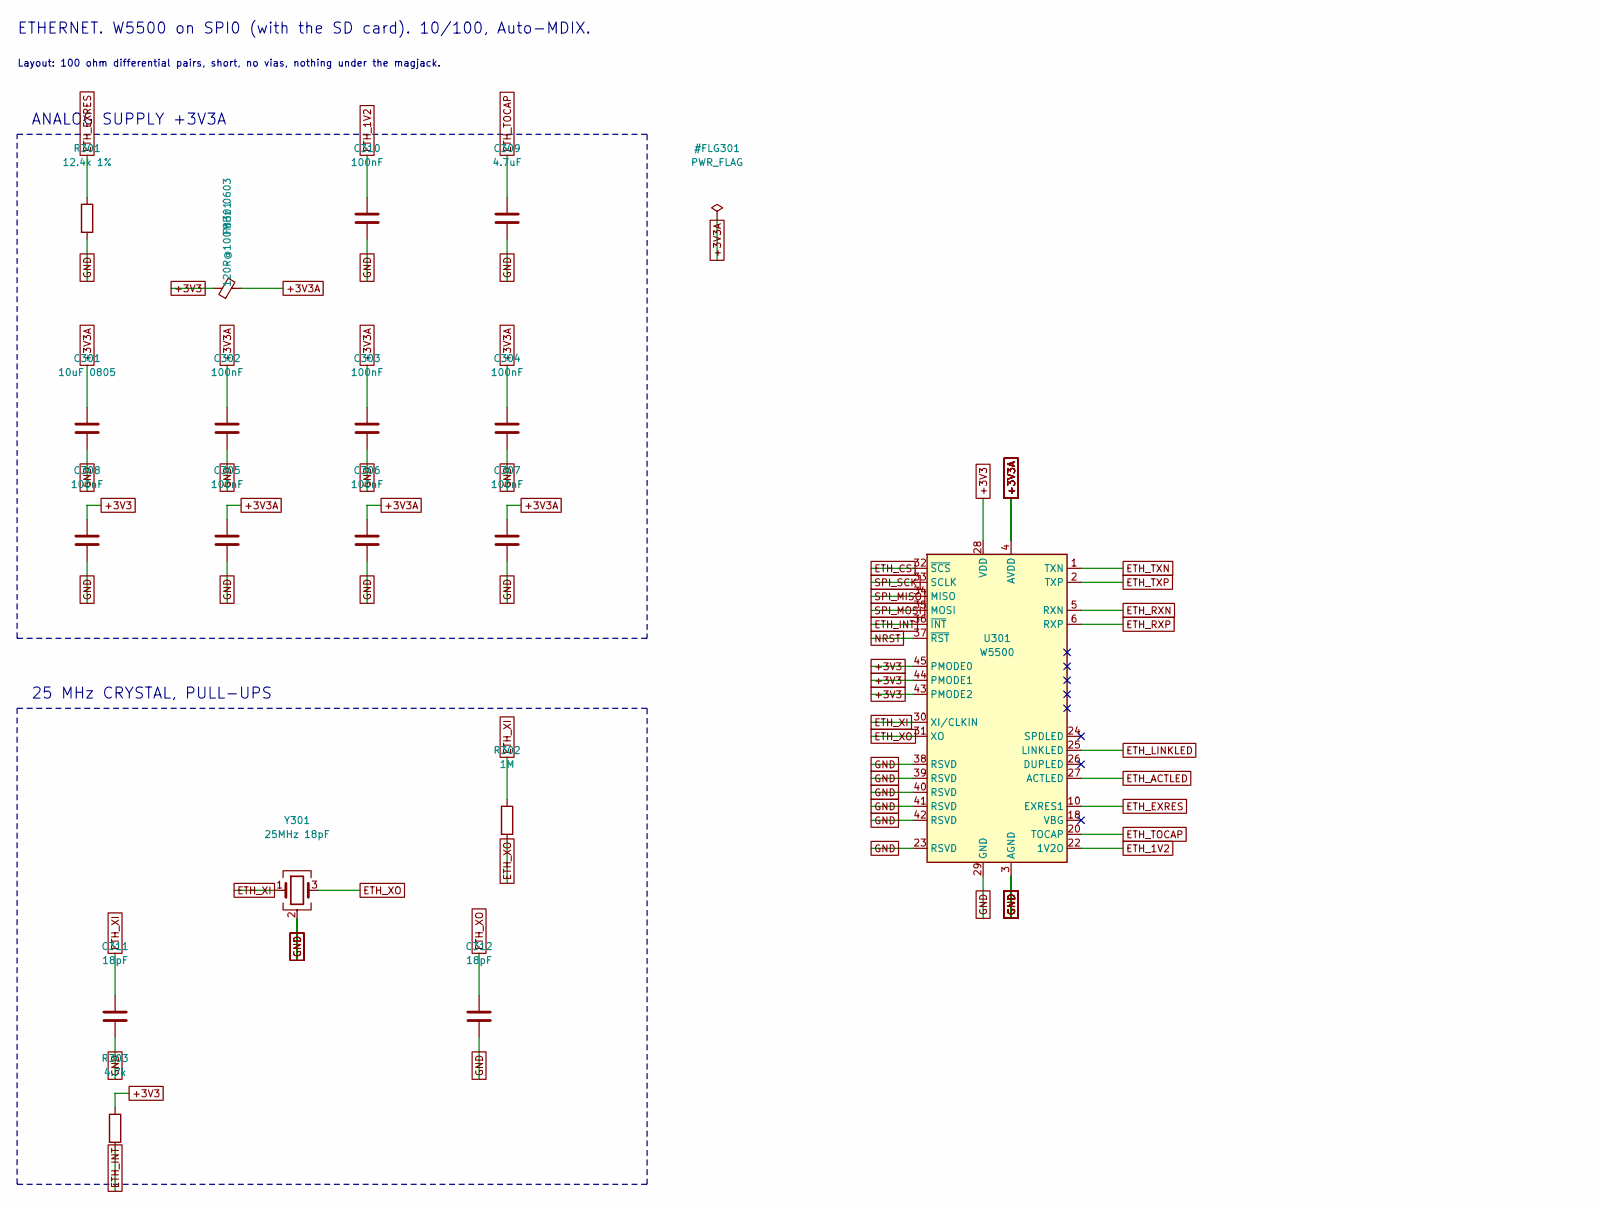
[picture p26: schematic 03_ethernet.kicad_sch, Ethernet - W5500 and magjack, part in row 1, column 1]

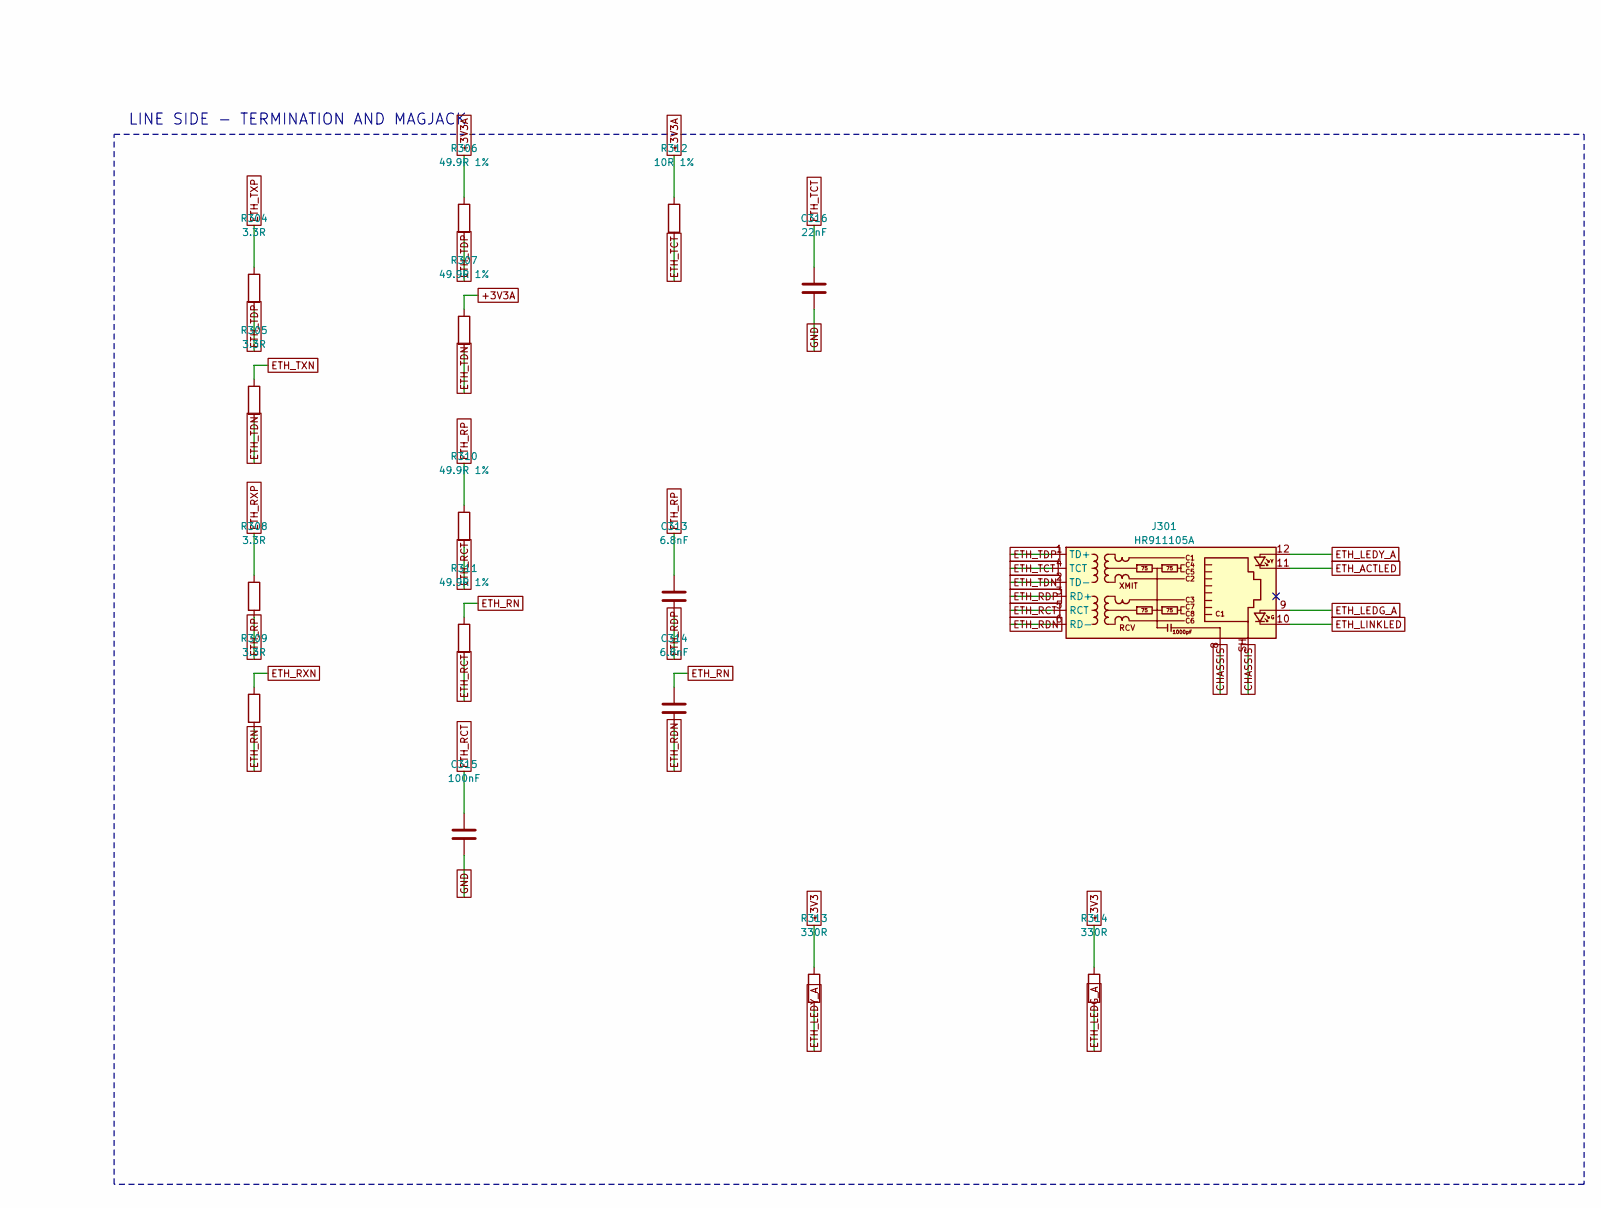
[picture p27: schematic 03_ethernet.kicad_sch, Ethernet - W5500 and magjack, part in row 1, column 2]

Parts:
C301: 10uF 0805; C_0805_2012Metric
C302, C303, C304, C305, C306, C307, C308, C310, C315: 100nF; C_0603_1608Metric
C309: 4.7uF; C_0603_1608Metric
C311, C312: 18pF; C_0603_1608Metric
C313, C314: 6.8nF; C_0603_1608Metric
C316: 22nF; C_0603_1608Metric
FB301: 120R@100MHz 0603; L_0603_1608Metric
J301: HR911105A; RJ45_Hanrun_HR911105A_Horizontal
R301: 12.4k 1%; R_0603_1608Metric
R302: 1M; R_0603_1608Metric
R303: 4.7k; R_0603_1608Metric
R304, R305, R308, R309: 3.3R; R_0603_1608Metric
R306, R307, R310, R311: 49.9R 1%; R_0603_1608Metric
R312: 10R 1%; R_0603_1608Metric
R313, R314: 330R; R_0603_1608Metric
U301: W5500; LQFP-48_7x7mm_P0.5mm
Y301: 25MHz 18pF; Crystal_SMD_3225-4Pin_3.2x2.5mm

Connections:
+3V3: C308.1, FB301.1, R303.1, R313.1, R314.1, U301.28 (VDD), U301.43 (PMODE2), U301.44 (PMODE1), U301.45 (PMODE0); also elsewhere on the board
+3V3A: C301.1, C302.1, C303.1, C304.1, C305.1, C306.1, C307.1, FB301.2, R306.1, R307.1, R312.1, U301.4 (AVDD), U301.8 (AVDD), U301.11 (AVDD), U301.15 (AVDD), U301.17 (AVDD), U301.21 (AVDD)
CHASSIS: J301.8, J301.SH; also elsewhere on the board
ETH_1V2: C310.1, U301.22 (1V2O)
ETH_ACTLED: J301.11, U301.27 (ACTLED)
ETH_CS: U301.32 (~SCS); also elsewhere on the board
ETH_EXRES: R301.1, U301.10 (EXRES1)
ETH_INT: R303.2, U301.36 (~INT); also elsewhere on the board
ETH_LEDG_A: J301.9, R314.2
ETH_LEDY_A: J301.12, R313.2
ETH_LINKLED: J301.10, U301.25 (LINKLED)
ETH_RCT: C315.1, J301.5 (RCT), R310.2, R311.2
ETH_RDN: C314.2, J301.6 (RD-)
ETH_RDP: C313.2, J301.3 (RD+)
ETH_RN: C314.1, R309.2, R311.1
ETH_RP: C313.1, R308.2, R310.1
ETH_RXN: R309.1, U301.5 (RXN)
ETH_RXP: R308.1, U301.6 (RXP)
ETH_TCT: C316.1, J301.4 (TCT), R312.2
ETH_TDN: J301.2 (TD-), R305.2, R307.2
ETH_TDP: J301.1 (TD+), R304.2, R306.2
ETH_TOCAP: C309.1, U301.20 (TOCAP)
ETH_TXN: R305.1, U301.1 (TXN)
ETH_TXP: R304.1, U301.2 (TXP)
ETH_XI: C311.1, R302.1, U301.30 (XI/CLKIN), Y301.1
ETH_XO: C312.1, R302.2, U301.31 (XO), Y301.3
GND: C301.2, C302.2, C303.2, C304.2, C305.2, C306.2, C307.2, C308.2, C309.2, C310.2, C311.2, C312.2, C315.2, C316.2, R301.2, U301.3 (AGND), U301.9 (AGND), U301.14 (AGND), U301.16 (AGND), U301.19 (AGND), U301.23 (RSVD), U301.29 (GND), U301.38 (RSVD), U301.39 (RSVD), U301.40 (RSVD), U301.41 (RSVD), U301.42 (RSVD), U301.48 (AGND), Y301.2 (G), Y301.4 (G); also elsewhere on the board
NRST: U301.37 (~RST); also elsewhere on the board
SPI_MISO: U301.34 (MISO); also elsewhere on the board
SPI_MOSI: U301.35 (MOSI); also elsewhere on the board
SPI_SCK: U301.33 (SCLK); also elsewhere on the board

Notes on the sheet:
ETHERNET. W5500 on SPI0 (with the SD card). 10/100, Auto-MDIX.
Layout: 100 ohm differential pairs, short, no vias, nothing under the magjack.
ANALOG SUPPLY +3V3A
25 MHz CRYSTAL, PULL-UPS
LINE SIDE - TERMINATION AND MAGJACK
