moein98/heimdall/MACH3_SIMPLE_ETH/hardware/MACH3SIMPLEETH.kicad_pcb

## KiCad design MACH3_SIMPLE_ETH/hardware/MACH3SIMPLEETH.kicad_pcb (continued)

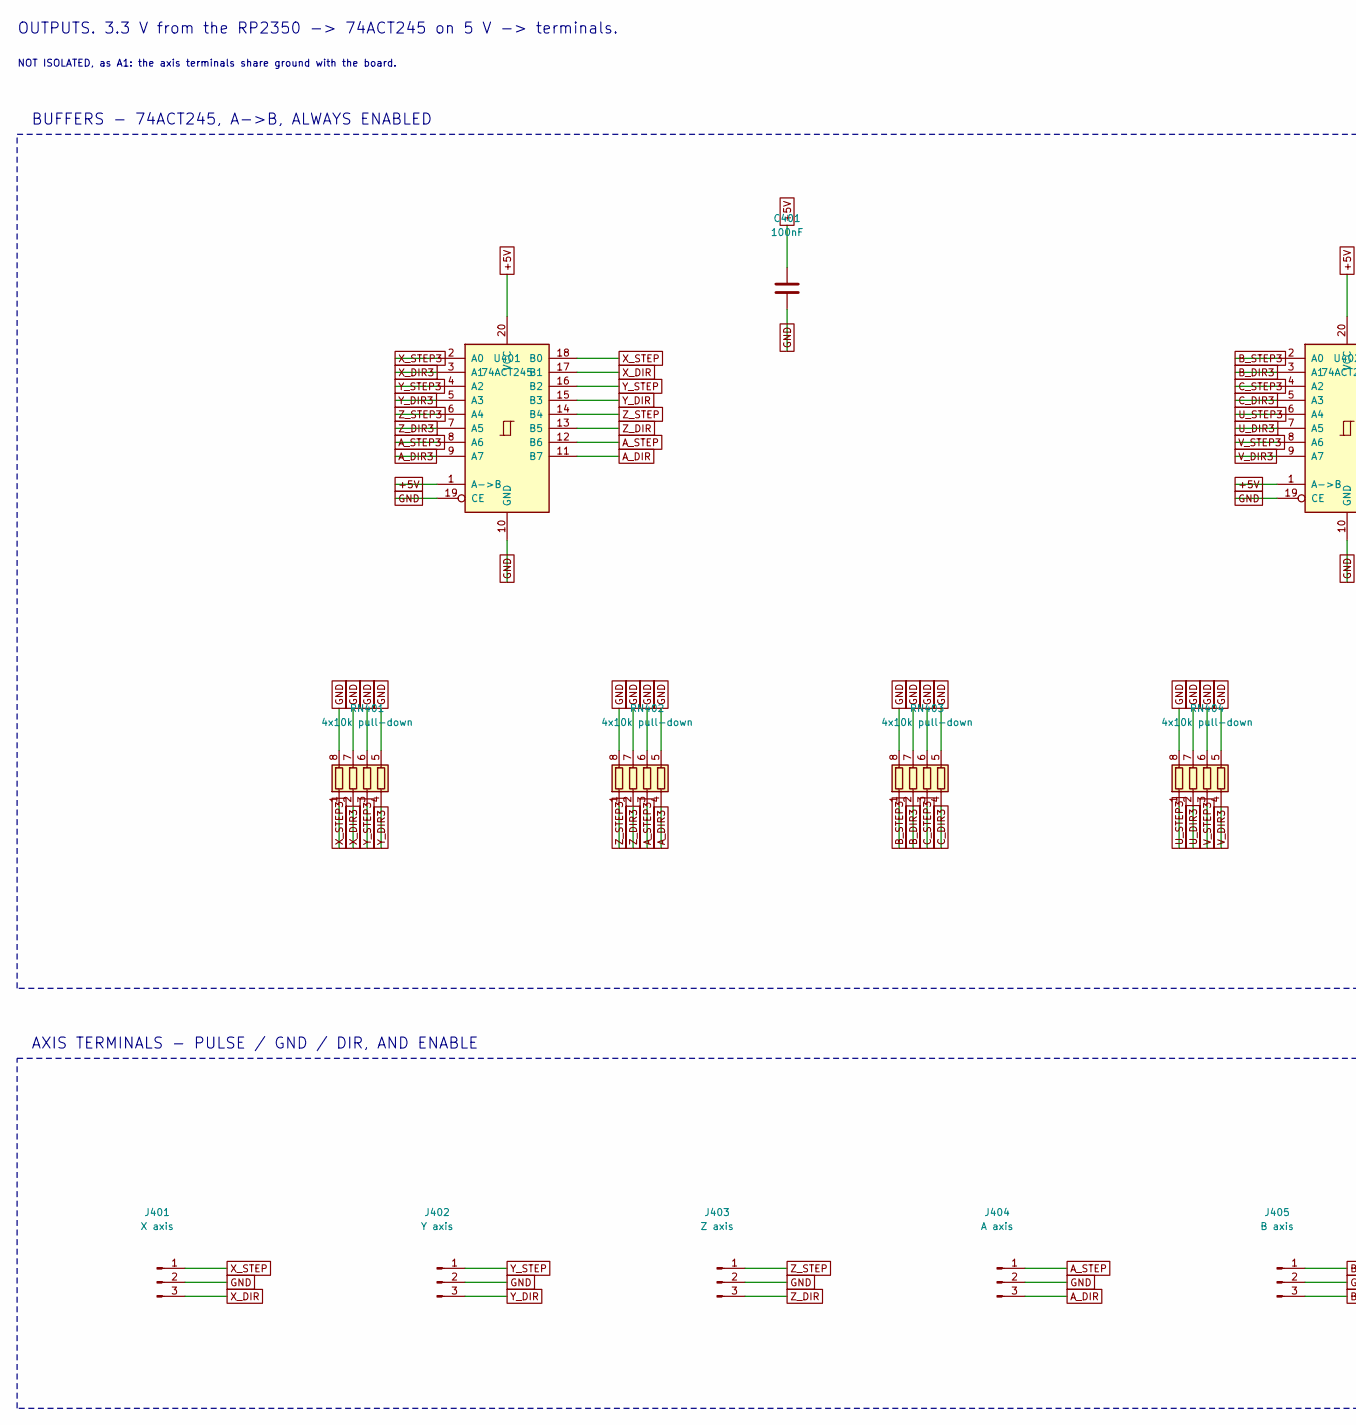
[picture p28: schematic 04_outputs.kicad_sch, Outputs - 8 axes step/dir, enable, buffered 5 V, part in row 1, column 1]

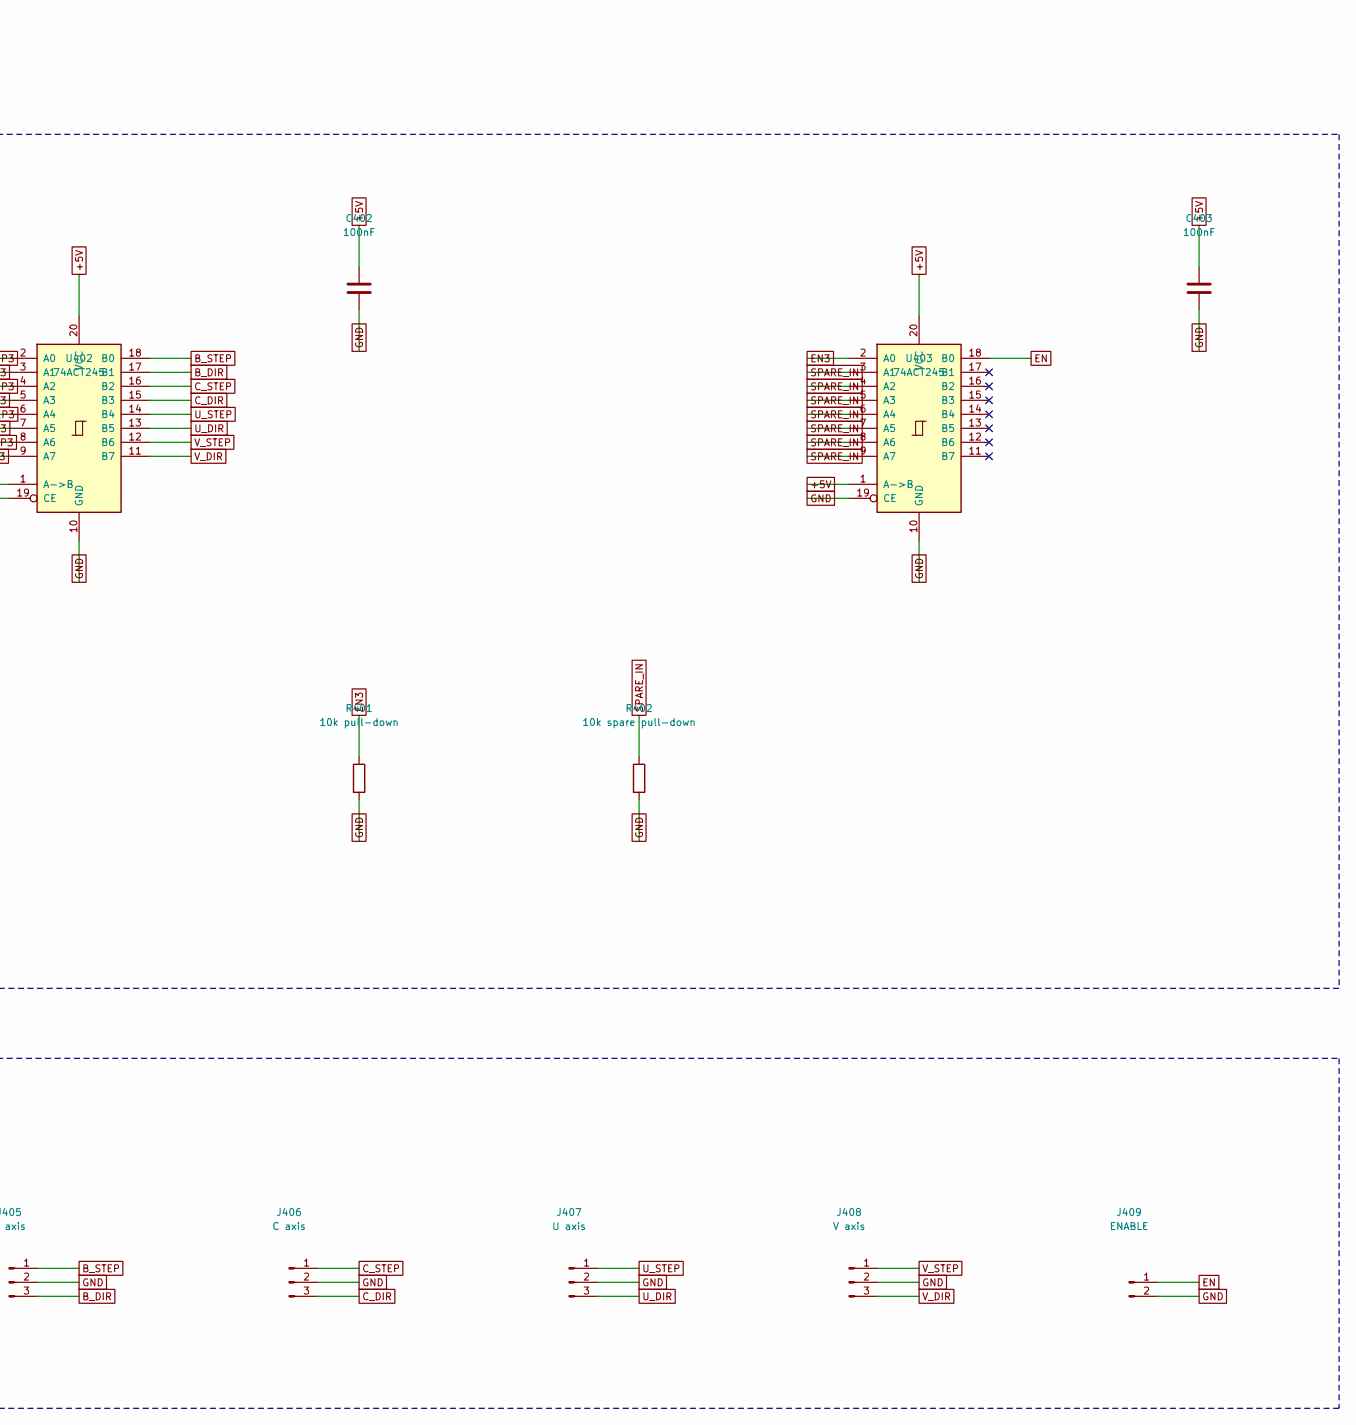
[picture p29: schematic 04_outputs.kicad_sch, Outputs - 8 axes step/dir, enable, buffered 5 V, part in row 1, column 2]

Parts:
C401, C402, C403: 100nF; C_0603_1608Metric
J401: X axis; TerminalBlock_Phoenix_MKDS-1,5-3_1x03_P5.00mm_Horizontal
J402: Y axis; TerminalBlock_Phoenix_MKDS-1,5-3_1x03_P5.00mm_Horizontal
J403: Z axis; TerminalBlock_Phoenix_MKDS-1,5-3_1x03_P5.00mm_Horizontal
J404: A axis; TerminalBlock_Phoenix_MKDS-1,5-3_1x03_P5.00mm_Horizontal
J405: B axis; TerminalBlock_Phoenix_MKDS-1,5-3_1x03_P5.00mm_Horizontal
J406: C axis; TerminalBlock_Phoenix_MKDS-1,5-3_1x03_P5.00mm_Horizontal
J407: U axis; TerminalBlock_Phoenix_MKDS-1,5-3_1x03_P5.00mm_Horizontal
J408: V axis; TerminalBlock_Phoenix_MKDS-1,5-3_1x03_P5.00mm_Horizontal
J409: ENABLE; TerminalBlock_Phoenix_MKDS-1,5-2_1x02_P5.00mm_Horizontal
R401: 10k pull-down; R_0603_1608Metric
R402: 10k spare pull-down; R_0603_1608Metric
RN401, RN402, RN403, RN404: 4x10k pull-down; R_Array_Convex_4x0603
U401, U402, U403: 74ACT245; SOIC-20W_7.5x12.8mm_P1.27mm

Connections:
+5V: C401.1, C402.1, C403.1, U401.1 (A->B), U401.20 (VCC), U402.1 (A->B), U402.20 (VCC), U403.1 (A->B), U403.20 (VCC); also elsewhere on the board
A_DIR: J404.3, U401.11 (B7)
A_DIR3: RN402.4 (R4.1), U401.9 (A7); also elsewhere on the board
A_STEP: J404.1, U401.12 (B6)
A_STEP3: RN402.3 (R3.1), U401.8 (A6); also elsewhere on the board
B_DIR: J405.3, U402.17 (B1)
B_DIR3: RN403.2 (R2.1), U402.3 (A1); also elsewhere on the board
B_STEP: J405.1, U402.18 (B0)
B_STEP3: RN403.1 (R1.1), U402.2 (A0); also elsewhere on the board
C_DIR: J406.3, U402.15 (B3)
C_DIR3: RN403.4 (R4.1), U402.5 (A3); also elsewhere on the board
C_STEP: J406.1, U402.16 (B2)
C_STEP3: RN403.3 (R3.1), U402.4 (A2); also elsewhere on the board
EN: J409.1, U403.18 (B0)
EN3: R401.1, U403.2 (A0); also elsewhere on the board
GND: C401.2, C402.2, C403.2, J401.2, J402.2, J403.2, J404.2, J405.2, J406.2, J407.2, J408.2, J409.2, R401.2, R402.2, RN401.5 (R4.2), RN401.6 (R3.2), RN401.7 (R2.2), RN401.8 (R1.2), RN402.5 (R4.2), RN402.6 (R3.2), RN402.7 (R2.2), RN402.8 (R1.2), RN403.5 (R4.2), RN403.6 (R3.2), RN403.7 (R2.2), RN403.8 (R1.2), RN404.5 (R4.2), RN404.6 (R3.2), RN404.7 (R2.2), RN404.8 (R1.2), U401.10 (GND), U401.19 (CE), U402.10 (GND), U402.19 (CE), U403.10 (GND), U403.19 (CE); also elsewhere on the board
SPARE_IN: R402.1, U403.3 (A1), U403.4 (A2), U403.5 (A3), U403.6 (A4), U403.7 (A5), U403.8 (A6), U403.9 (A7)
U_DIR: J407.3, U402.13 (B5)
U_DIR3: RN404.2 (R2.1), U402.7 (A5); also elsewhere on the board
U_STEP: J407.1, U402.14 (B4)
U_STEP3: RN404.1 (R1.1), U402.6 (A4); also elsewhere on the board
V_DIR: J408.3, U402.11 (B7)
V_DIR3: RN404.4 (R4.1), U402.9 (A7); also elsewhere on the board
V_STEP: J408.1, U402.12 (B6)
V_STEP3: RN404.3 (R3.1), U402.8 (A6); also elsewhere on the board
X_DIR: J401.3, U401.17 (B1)
X_DIR3: RN401.2 (R2.1), U401.3 (A1); also elsewhere on the board
X_STEP: J401.1, U401.18 (B0)
X_STEP3: RN401.1 (R1.1), U401.2 (A0); also elsewhere on the board
Y_DIR: J402.3, U401.15 (B3)
Y_DIR3: RN401.4 (R4.1), U401.5 (A3); also elsewhere on the board
Y_STEP: J402.1, U401.16 (B2)
Y_STEP3: RN401.3 (R3.1), U401.4 (A2); also elsewhere on the board
Z_DIR: J403.3, U401.13 (B5)
Z_DIR3: RN402.2 (R2.1), U401.7 (A5); also elsewhere on the board
Z_STEP: J403.1, U401.14 (B4)
Z_STEP3: RN402.1 (R1.1), U401.6 (A4); also elsewhere on the board

Notes on the sheet:
OUTPUTS. 3.3 V from the RP2350 -> 74ACT245 on 5 V -> terminals.
NOT ISOLATED, as A1: the axis terminals share ground with the board.
BUFFERS - 74ACT245, A->B, ALWAYS ENABLED
AXIS TERMINALS - PULSE / GND / DIR, AND ENABLE

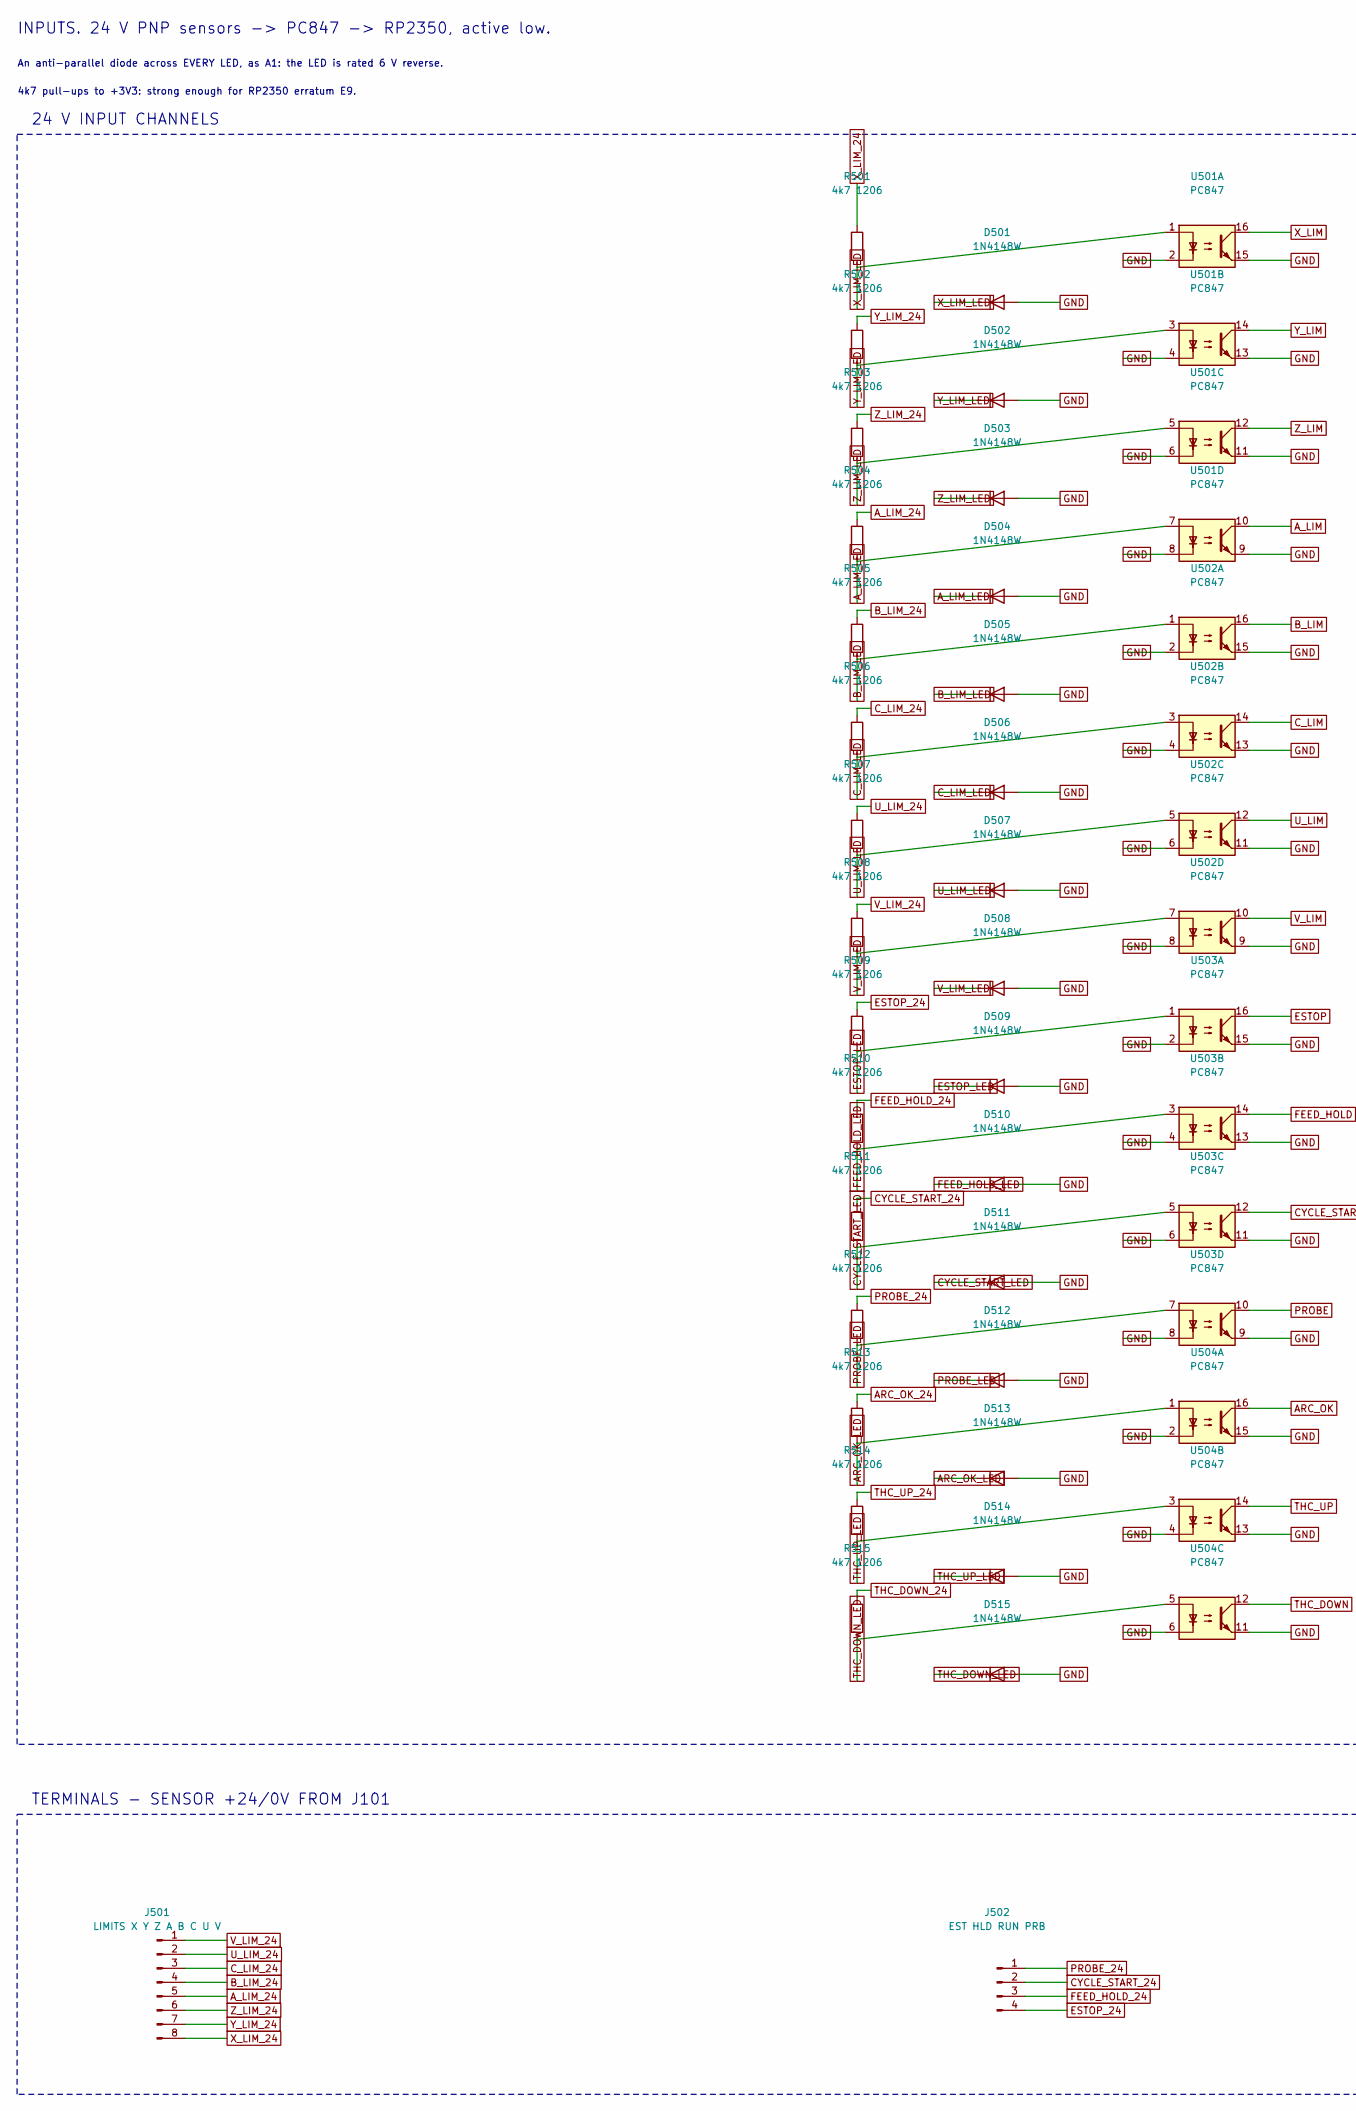
[picture p30: schematic 05_inputs.kicad_sch, Inputs - 15 opto-isolated 24 V channels, part in row 1, column 1]

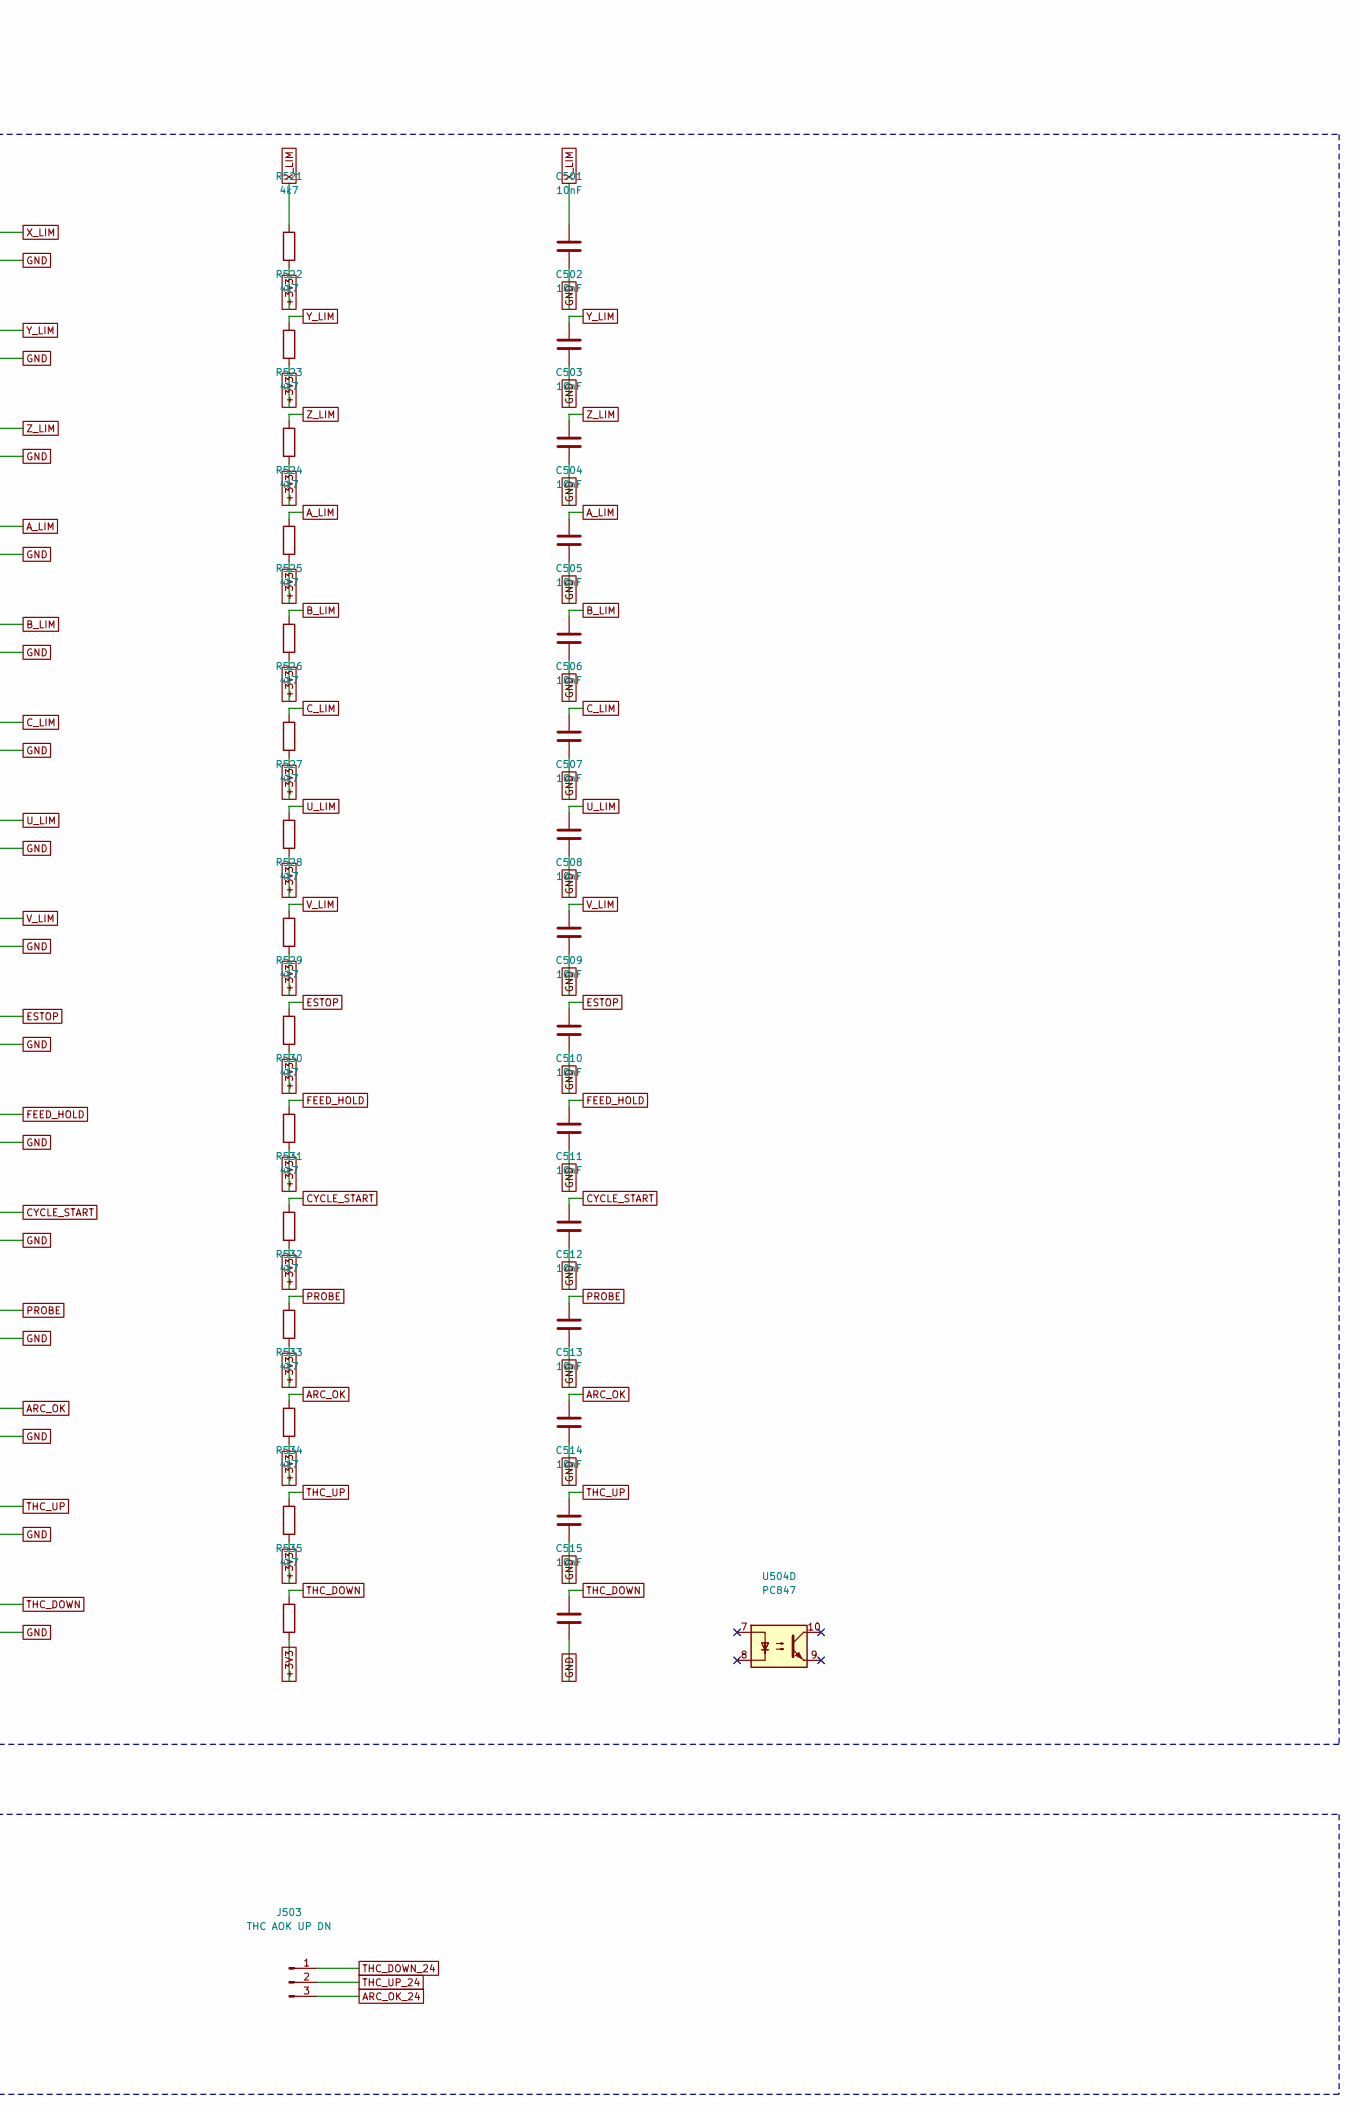
[picture p31: schematic 05_inputs.kicad_sch, Inputs - 15 opto-isolated 24 V channels, part in row 1, column 2]

Parts:
C501, C502, C503, C504, C505, C506, C507, C508, C509, C510, C511, C512, C513, C514, C515: 10nF; C_0603_1608Metric
D501, D502, D503, D504, D505, D506, D507, D508, D509, D510, D511, D512, D513, D514, D515: 1N4148W; D_SOD-123
J501: LIMITS X Y Z A B C U V; TerminalBlock_Phoenix_MKDS-1,5-8_1x08_P5.00mm_Horizontal
J502: EST HLD RUN PRB; TerminalBlock_Phoenix_MKDS-1,5-4_1x04_P5.00mm_Horizontal
J503: THC AOK UP DN; TerminalBlock_Phoenix_MKDS-1,5-3_1x03_P5.00mm_Horizontal
R501, R502, R503, R504, R505, R506, R507, R508, R509, R510, R511, R512, R513, R514, R515: 4k7 1206; R_1206_3216Metric
R521, R522, R523, R524, R525, R526, R527, R528, R529, R530, R531, R532, R533, R534, R535: 4k7; R_0603_1608Metric
U501, U502, U503, U504: PC847; SMDIP-16_W9.53mm

Connections:
+3V3: R521.2, R522.2, R523.2, R524.2, R525.2, R526.2, R527.2, R528.2, R529.2, R530.2, R531.2, R532.2, R533.2, R534.2, R535.2; also elsewhere on the board
ARC_OK: C513.1, R533.1, U504.16; also elsewhere on the board
ARC_OK_24: J503.3, R513.1
ARC_OK_LED: D513.1 (K), R513.2, U504.1
A_LIM: C504.1, R524.1, U501.10; also elsewhere on the board
A_LIM_24: J501.5, R504.1
A_LIM_LED: D504.1 (K), R504.2, U501.7
B_LIM: C505.1, R525.1, U502.16; also elsewhere on the board
B_LIM_24: J501.4, R505.1
B_LIM_LED: D505.1 (K), R505.2, U502.1
CYCLE_START: C511.1, R531.1, U503.12; also elsewhere on the board
CYCLE_START_24: J502.2, R511.1
CYCLE_START_LED: D511.1 (K), R511.2, U503.5
C_LIM: C506.1, R526.1, U502.14; also elsewhere on the board
C_LIM_24: J501.3, R506.1
C_LIM_LED: D506.1 (K), R506.2, U502.3
ESTOP: C509.1, R529.1, U503.16; also elsewhere on the board
ESTOP_24: J502.4, R509.1
ESTOP_LED: D509.1 (K), R509.2, U503.1
FEED_HOLD: C510.1, R530.1, U503.14; also elsewhere on the board
FEED_HOLD_24: J502.3, R510.1
FEED_HOLD_LED: D510.1 (K), R510.2, U503.3
GND: C501.2, C502.2, C503.2, C504.2, C505.2, C506.2, C507.2, C508.2, C509.2, C510.2, C511.2, C512.2, C513.2, C514.2, C515.2, D501.2 (A), D502.2 (A), D503.2 (A), D504.2 (A), D505.2 (A), D506.2 (A), D507.2 (A), D508.2 (A), D509.2 (A), D510.2 (A), D511.2 (A), D512.2 (A), D513.2 (A), D514.2 (A), D515.2 (A), U501.2, U501.4, U501.6, U501.8, U501.9, U501.11, U501.13, U501.15, U502.2, U502.4, U502.6, U502.8, U502.9, U502.11, U502.13, U502.15, U503.2, U503.4, U503.6, U503.8, U503.9, U503.11, U503.13, U503.15, U504.2, U504.4, U504.6, U504.11, U504.13, U504.15; also elsewhere on the board
PROBE: C512.1, R532.1, U503.10; also elsewhere on the board
PROBE_24: J502.1, R512.1
PROBE_LED: D512.1 (K), R512.2, U503.7
THC_DOWN: C515.1, R535.1, U504.12; also elsewhere on the board
THC_DOWN_24: J503.1, R515.1
THC_DOWN_LED: D515.1 (K), R515.2, U504.5
THC_UP: C514.1, R534.1, U504.14; also elsewhere on the board
THC_UP_24: J503.2, R514.1
THC_UP_LED: D514.1 (K), R514.2, U504.3
U_LIM: C507.1, R527.1, U502.12; also elsewhere on the board
U_LIM_24: J501.2, R507.1
U_LIM_LED: D507.1 (K), R507.2, U502.5
V_LIM: C508.1, R528.1, U502.10; also elsewhere on the board
V_LIM_24: J501.1, R508.1
V_LIM_LED: D508.1 (K), R508.2, U502.7
X_LIM: C501.1, R521.1, U501.16; also elsewhere on the board
X_LIM_24: J501.8, R501.1
X_LIM_LED: D501.1 (K), R501.2, U501.1
Y_LIM: C502.1, R522.1, U501.14; also elsewhere on the board
Y_LIM_24: J501.7, R502.1
Y_LIM_LED: D502.1 (K), R502.2, U501.3
Z_LIM: C503.1, R523.1, U501.12; also elsewhere on the board
Z_LIM_24: J501.6, R503.1
Z_LIM_LED: D503.1 (K), R503.2, U501.5

Notes on the sheet:
INPUTS. 24 V PNP sensors -> PC847 -> RP2350, active low.
An anti-parallel diode across EVERY LED, as A1: the LED is rated 6 V reverse.
4k7 pull-ups to +3V3: strong enough for RP2350 erratum E9.
24 V INPUT CHANNELS
TERMINALS - SENSOR +24/0V FROM J101

Schematic: 06_relays.kicad_sch, MCP23017 and six relays

Parts:
C601: 100nF; C_0603_1608Metric
D601: STATUS; LED_0603_1608Metric
D611, D612, D613, D614, D615, D616: 1N4148W flyback; D_SOD-123
D621: KA; LED_0603_1608Metric
D622: KB; LED_0603_1608Metric
D623: KC; LED_0603_1608Metric
D624: KD; LED_0603_1608Metric
D625: KE; LED_0603_1608Metric
D626: KF; LED_0603_1608Metric
J601: EXPANSION; IDC-Header_2x05_P2.54mm_Vertical
J611: Relay A; TerminalBlock_Phoenix_MKDS-1,5-3_1x03_P5.00mm_Horizontal
J612: Relay B; TerminalBlock_Phoenix_MKDS-1,5-3_1x03_P5.00mm_Horizontal
J613: Relay C; TerminalBlock_Phoenix_MKDS-1,5-3_1x03_P5.00mm_Horizontal
J614: Relay D; TerminalBlock_Phoenix_MKDS-1,5-3_1x03_P5.00mm_Horizontal
J615: Relay E; TerminalBlock_Phoenix_MKDS-1,5-3_1x03_P5.00mm_Horizontal
J616: Relay F; TerminalBlock_Phoenix_MKDS-1,5-3_1x03_P5.00mm_Horizontal
K601, K602, K603, K604, K605, K606: JQC-3FF-024-1Z; Relay_SPDT_Hongfa_JQC-3FF_0XX-1Z
Q601, Q602, Q603, Q604, Q605, Q606: AO3400A; SOT-23
R601, R602: 4.7k; R_0603_1608Metric
R603, R621, R622, R623, R624, R625, R626: 1k; R_0603_1608Metric
R604, R605, R606, R607, R608, R609, R610, R611, R631, R632, R633, R634, R635, R636, R641, R642, R643, R644, R645, R646: 10k; R_0603_1608Metric
U601: MCP23017-E/SO; SOIC-28W_7.5x17.9mm_P1.27mm

Connections:
+3V3: C601.1, J601.9, R601.1, R602.1, R604.2, R605.2, R606.2, R607.2, R608.2, R609.2, R610.2, R611.2, U601.9 (V_{DD}); also elsewhere on the board
EXP_IN0: J601.1, R604.1, U601.1 (GPB0)
EXP_IN1: J601.2, R605.1, U601.2 (GPB1)
EXP_IN2: J601.3, R606.1, U601.3 (GPB2)
EXP_IN3: J601.4, R607.1, U601.4 (GPB3)
EXP_IN4: J601.5, R608.1, U601.5 (GPB4)
EXP_IN5: J601.6, R609.1, U601.6 (GPB5)
EXP_IN6: J601.7, R610.1, U601.7 (GPB6)
EXP_IN7: J601.8, R611.1, U601.8 (GPB7)
GND: C601.2, D601.1 (K), J601.10, Q601.2 (S), Q602.2 (S), Q603.2 (S), Q604.2 (S), Q605.2 (S), Q606.2 (S), R631.2, R632.2, R633.2, R634.2, R635.2, R636.2, U601.10 (V_{SS}), U601.15 (A0), U601.16 (A1), U601.17 (A2); also elsewhere on the board
I2C_SCL: R602.2, U601.12 (SCK); also elsewhere on the board
I2C_SDA: R601.2, U601.13 (SDA); also elsewhere on the board
KA_COM: J611.2, K601.11
KA_NC: J611.3, K601.12
KA_NO: J611.1, K601.14
KB_COM: J612.2, K602.11
KB_NC: J612.3, K602.12
KB_NO: J612.1, K602.14
KC_COM: J613.2, K603.11
KC_NC: J613.3, K603.12
KC_NO: J613.1, K603.14
KD_COM: J614.2, K604.11
KD_NC: J614.3, K604.12
KD_NO: J614.1, K604.14
KE_COM: J615.2, K605.11
KE_NC: J615.3, K605.12
KE_NO: J615.1, K605.14
KF_COM: J616.2, K606.11
KF_NC: J616.3, K606.12
KF_NO: J616.1, K606.14
NRST: U601.18 (~RESET); also elsewhere on the board
unnamed: D621.2 (A), R641.2
unnamed: D622.2 (A), R642.2
unnamed: D623.2 (A), R643.2
unnamed: D624.2 (A), R644.2
unnamed: D625.2 (A), R645.2
unnamed: D626.2 (A), R646.2
unnamed: Q601.1 (G), R621.2
unnamed: Q602.1 (G), R622.2
unnamed: Q603.1 (G), R623.2
unnamed: Q604.1 (G), R624.2
unnamed: Q605.1 (G), R625.2
unnamed: Q606.1 (G), R626.2
RELC_A: D611.2 (A), D621.1 (K), K601.A2, Q601.3 (D)
RELC_B: D612.2 (A), D622.1 (K), K602.A2, Q602.3 (D)
RELC_C: D613.2 (A), D623.1 (K), K603.A2, Q603.3 (D)
RELC_D: D614.2 (A), D624.1 (K), K604.A2, Q604.3 (D)
RELC_E: D615.2 (A), D625.1 (K), K605.A2, Q605.3 (D)
RELC_F: D616.2 (A), D626.1 (K), K606.A2, Q606.3 (D)
REL_A: R621.1, R631.1, U601.21 (GPA0)
REL_B: R622.1, R632.1, U601.22 (GPA1)
REL_C: R623.1, R633.1, U601.23 (GPA2)
REL_D: R624.1, R634.1, U601.24 (GPA3)
REL_E: R625.1, R635.1, U601.25 (GPA4)
REL_F: R626.1, R636.1, U601.26 (GPA5)
SP_AUX_IN: U601.27 (GPA6); also elsewhere on the board
STATUS_LED: R603.1, U601.28 (GPA7)
STATUS_LED_A: D601.2 (A), R603.2
V24: D611.1 (K), D612.1 (K), D613.1 (K), D614.1 (K), D615.1 (K), D616.1 (K), K601.A1, K602.A1, K603.A1, K604.A1, K605.A1, K606.A1, R641.1, R642.1, R643.1, R644.1, R645.1, R646.1; also elsewhere on the board

Notes on the sheet:
RELAYS. MCP23017 (I2C 0x20) -> AO3400A -> 24 V relay coils.
G-code M62/M63 P<n> switch them, synchronised with motion; M64/M65 at once.
MCP23017 AND EXPANSION HEADER
SIX RELAYS - 24 V COILS ONLY, AS A1

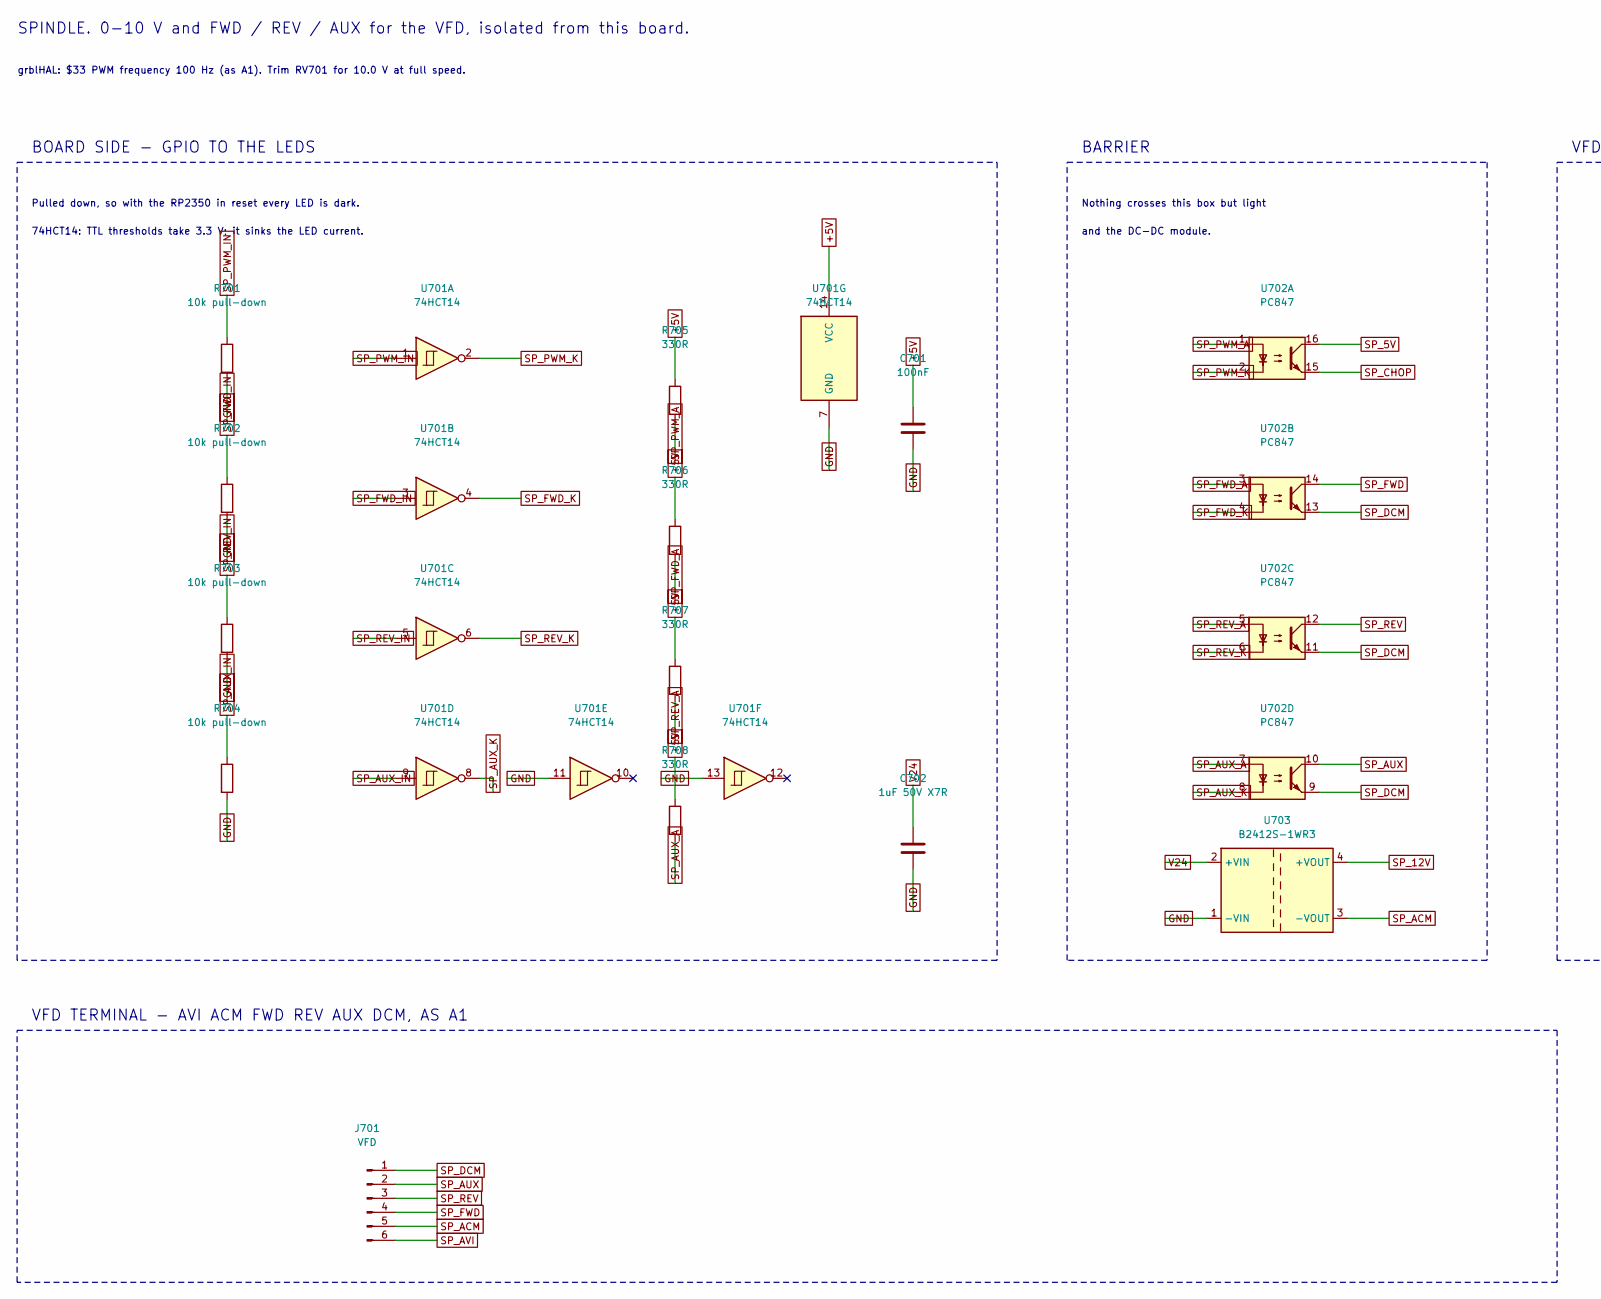
[picture p32: schematic 07_spindle.kicad_sch, Spindle - isolated 0-10 V and FWD-REV-AUX, part in row 1, column 1]

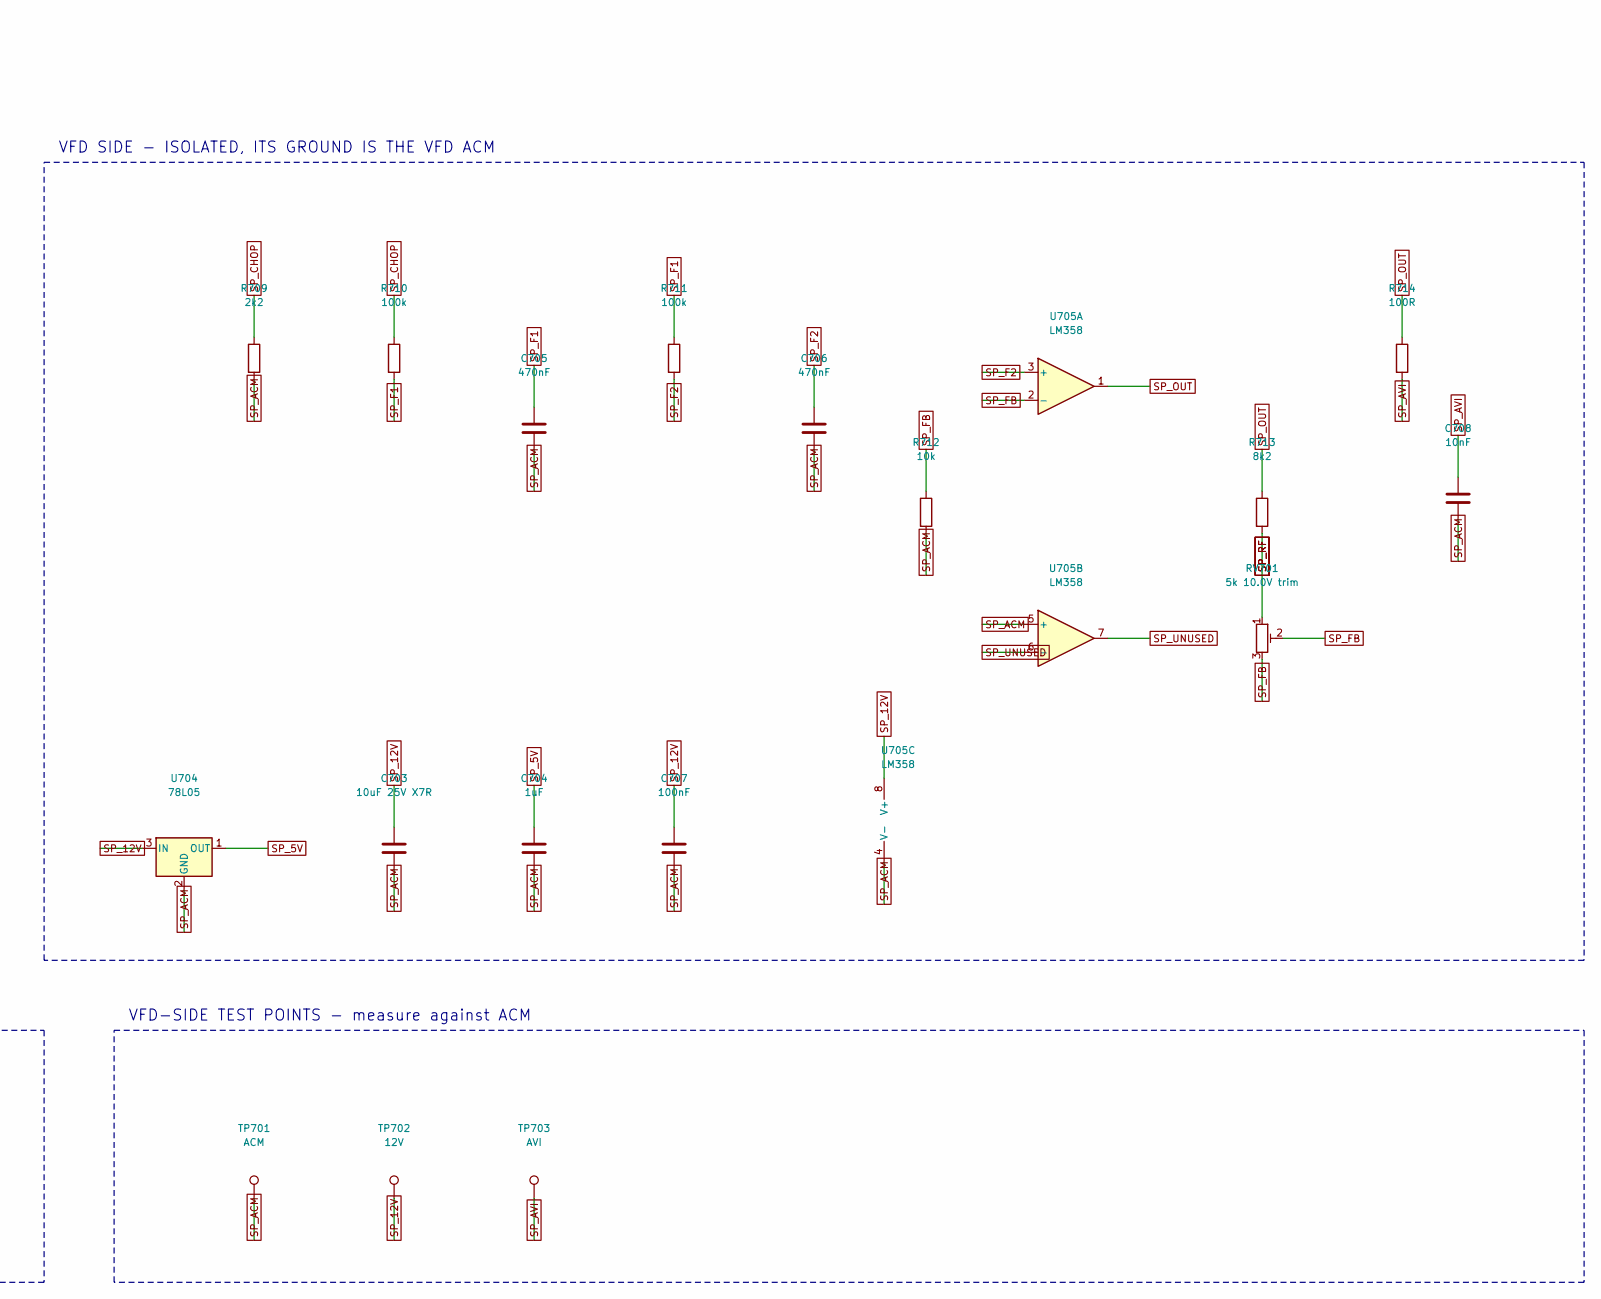
[picture p33: schematic 07_spindle.kicad_sch, Spindle - isolated 0-10 V and FWD-REV-AUX, part in row 1, column 2]

Parts:
C701, C707: 100nF; C_0603_1608Metric
C702: 1uF 50V X7R; C_1206_3216Metric
C703: 10uF 25V X7R; C_1206_3216Metric
C704: 1uF; C_0603_1608Metric
C705, C706: 470nF; C_0603_1608Metric
C708: 10nF; C_0603_1608Metric
J701: VFD; TerminalBlock_Phoenix_MKDS-1,5-6_1x06_P5.00mm_Horizontal
R701, R702, R703, R704: 10k pull-down; R_0603_1608Metric
R705, R706, R707, R708: 330R; R_0603_1608Metric
R709: 2k2; R_0603_1608Metric
R710, R711: 100k; R_0603_1608Metric
R712: 10k; R_0603_1608Metric
R713: 8k2; R_0603_1608Metric
R714: 100R; R_0603_1608Metric
RV701: 5k 10.0V trim; Potentiometer_Bourns_3296W_Vertical
TP701: ACM; TestPoint_THTPad_D2.0mm_Drill1.0mm
TP702: 12V; TestPoint_THTPad_D2.0mm_Drill1.0mm
TP703: AVI; TestPoint_THTPad_D2.0mm_Drill1.0mm
U701: 74HCT14; SOIC-14_3.9x8.7mm_P1.27mm
U702: PC847; SMDIP-16_W9.53mm
U703: B2412S-1WR3; Converter_DCDC_Murata_CRE1xxxxxxSC_THT
U704: 78L05; SOT-89-3
U705: LM358; SOIC-8_3.9x4.9mm_P1.27mm

Connections:
+5V: C701.1, R705.1, R706.1, R707.1, R708.1, U701.14 (VCC); also elsewhere on the board
GND: C701.2, C702.2, R701.2, R702.2, R703.2, R704.2, U701.7 (GND), U701.11, U701.13, U703.1 (-VIN); also elsewhere on the board
SP_5V: C704.1, U702.16, U704.1 (OUT)
SP_12V: C703.1, C707.1, TP702.1, U703.4 (+VOUT), U704.3 (IN), U705.8 (V+)
SP_ACM: C703.2, C704.2, C705.2, C706.2, C707.2, C708.2, J701.5, R709.2, R712.2, TP701.1, U703.3 (-VOUT), U704.2 (GND), U705.4 (V-), U705.5 (+)
SP_AUX: J701.2, U702.10
SP_AUX_A: R708.2, U702.7
SP_AUX_IN: R704.1, U701.9; also elsewhere on the board
SP_AUX_K: U701.8, U702.8
SP_AVI: C708.1, J701.6, R714.2, TP703.1
SP_CHOP: R709.1, R710.1, U702.15
SP_DCM: J701.1, U702.9, U702.11, U702.13
SP_F1: C705.1, R710.2, R711.1
SP_F2: C706.1, R711.2, U705.3 (+)
SP_FB: R712.1, RV701.2, RV701.3, U705.2 (-)
SP_FWD: J701.4, U702.14
SP_FWD_A: R706.2, U702.3
SP_FWD_IN: R702.1, U701.3; also elsewhere on the board
SP_FWD_K: U701.4, U702.4
SP_OUT: R713.1, R714.1, U705.1
SP_PWM_A: R705.2, U702.1
SP_PWM_IN: R701.1, U701.1; also elsewhere on the board
SP_PWM_K: U701.2, U702.2
SP_REV: J701.3, U702.12
SP_REV_A: R707.2, U702.5
SP_REV_IN: R703.1, U701.5; also elsewhere on the board
SP_REV_K: U701.6, U702.6
SP_RF: R713.2, RV701.1
SP_UNUSED: U705.6 (-), U705.7
V24: C702.1, U703.2 (+VIN); also elsewhere on the board

Notes on the sheet:
SPINDLE. 0-10 V and FWD / REV / AUX for the VFD, isolated from this board.
grblHAL: $33 PWM frequency 100 Hz (as A1). Trim RV701 for 10.0 V at full speed.
BOARD SIDE - GPIO TO THE LEDS
Pulled down, so with the RP2350 in reset every LED is dark.
74HCT14: TTL thresholds take 3.3 V; it sinks the LED current.
BARRIER
Nothing crosses this box but light
and the DC-DC module.
VFD SIDE - ISOLATED, ITS GROUND IS THE VFD ACM
VFD-SIDE TEST POINTS - measure against ACM
VFD TERMINAL - AVI ACM FWD REV AUX DCM, AS A1
