moein98/heimdall/MACH3_SIMPLE_ETH/hardware/MACH3SIMPLEETH.kicad_pcb

## KiCad design MACH3_SIMPLE_ETH/hardware/MACH3SIMPLEETH.kicad_pcb (continued)

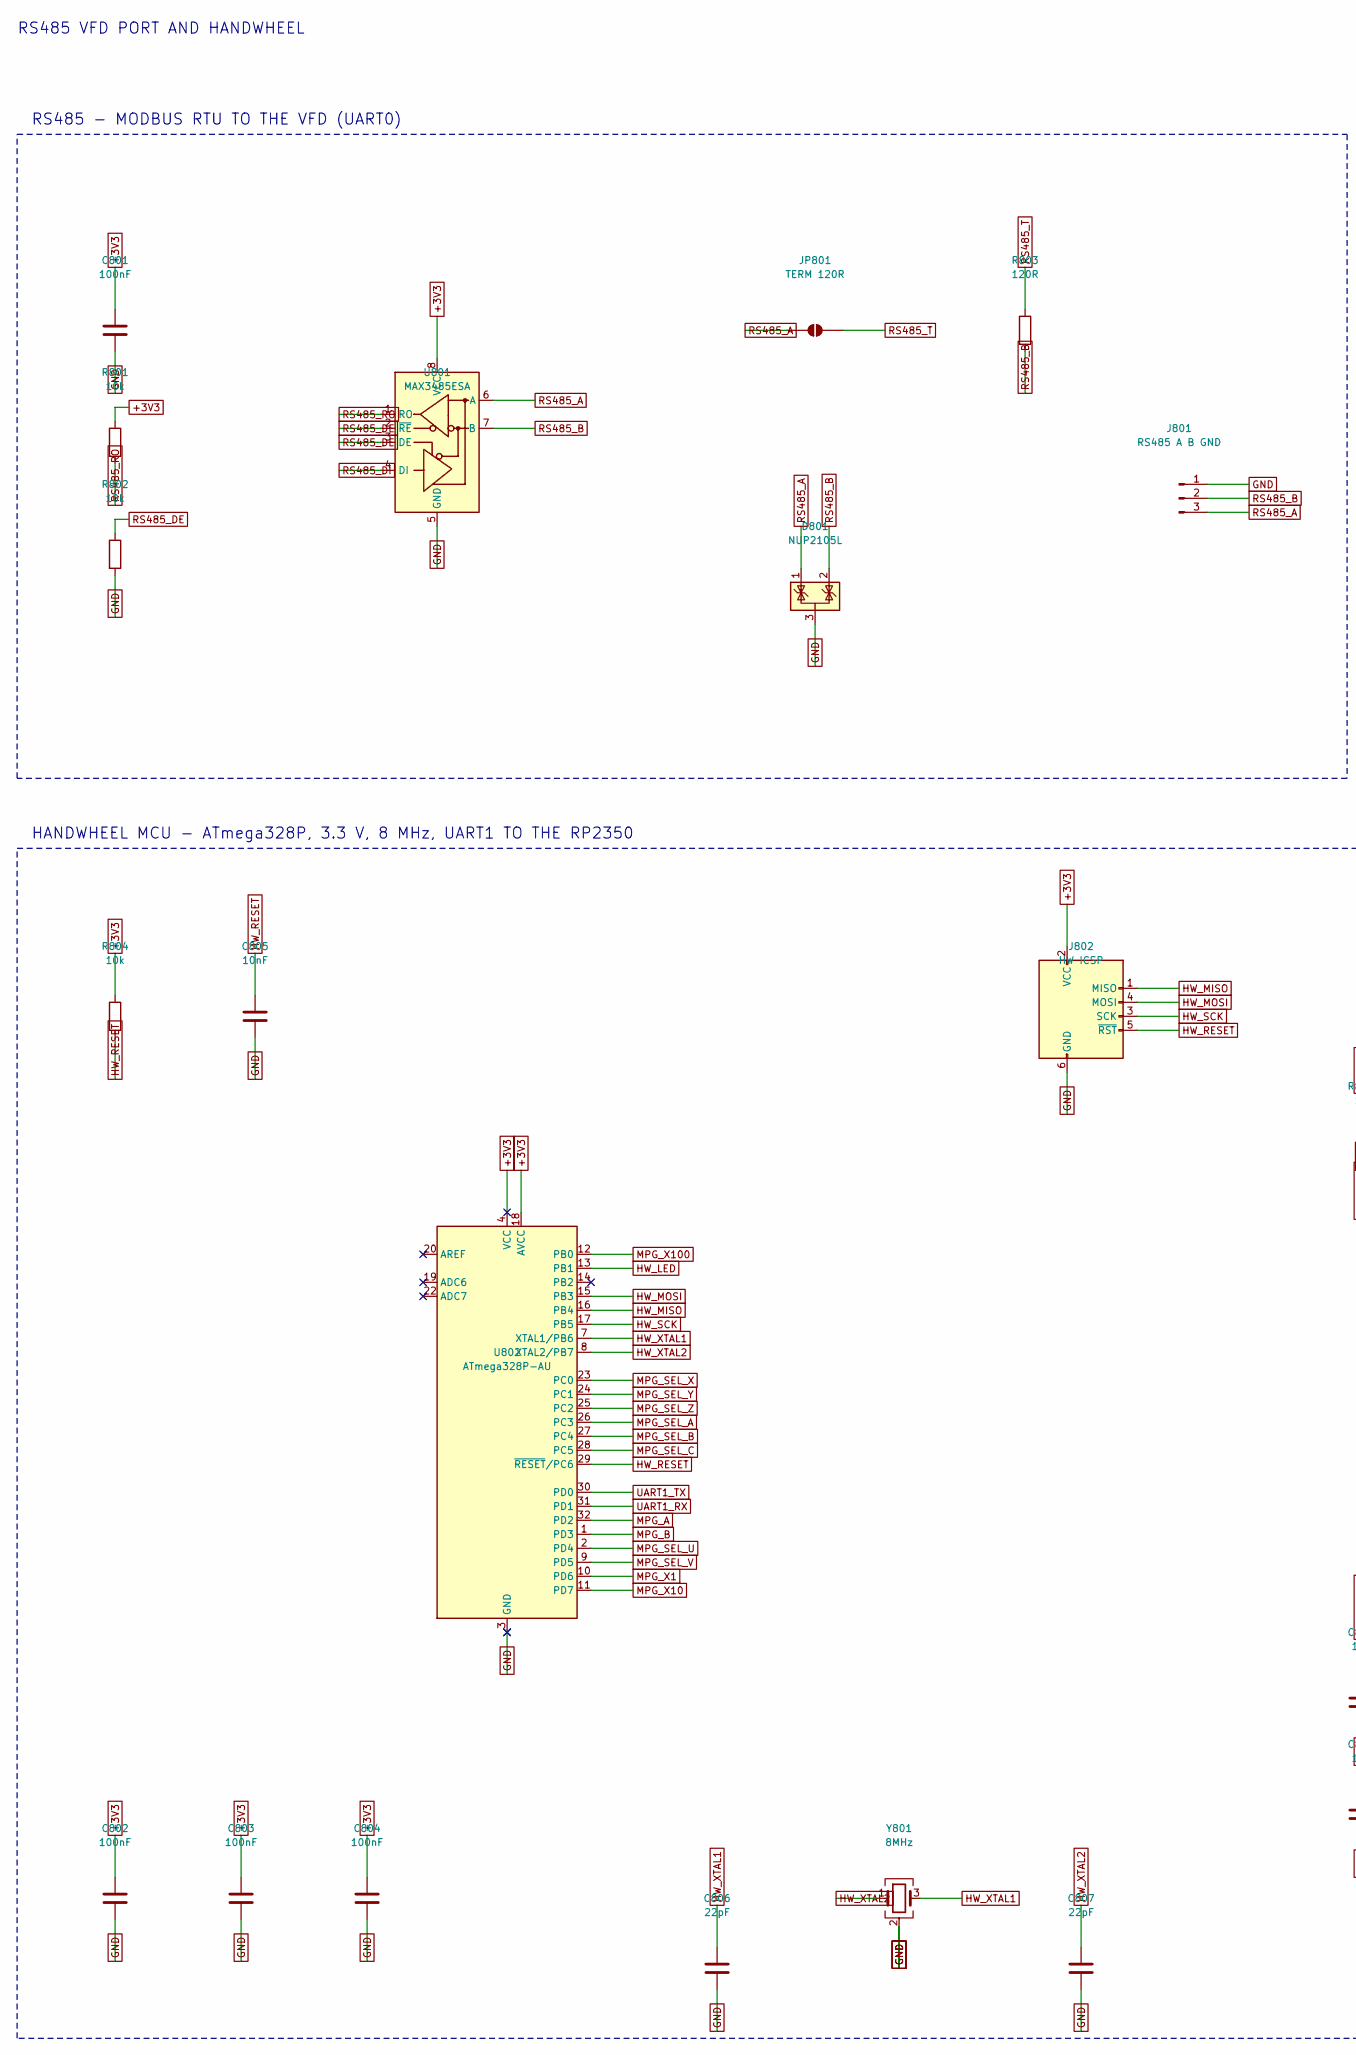
[picture p34: schematic 08_comms.kicad_sch, RS485 VFD port and handwheel MCU, part in row 1, column 1]

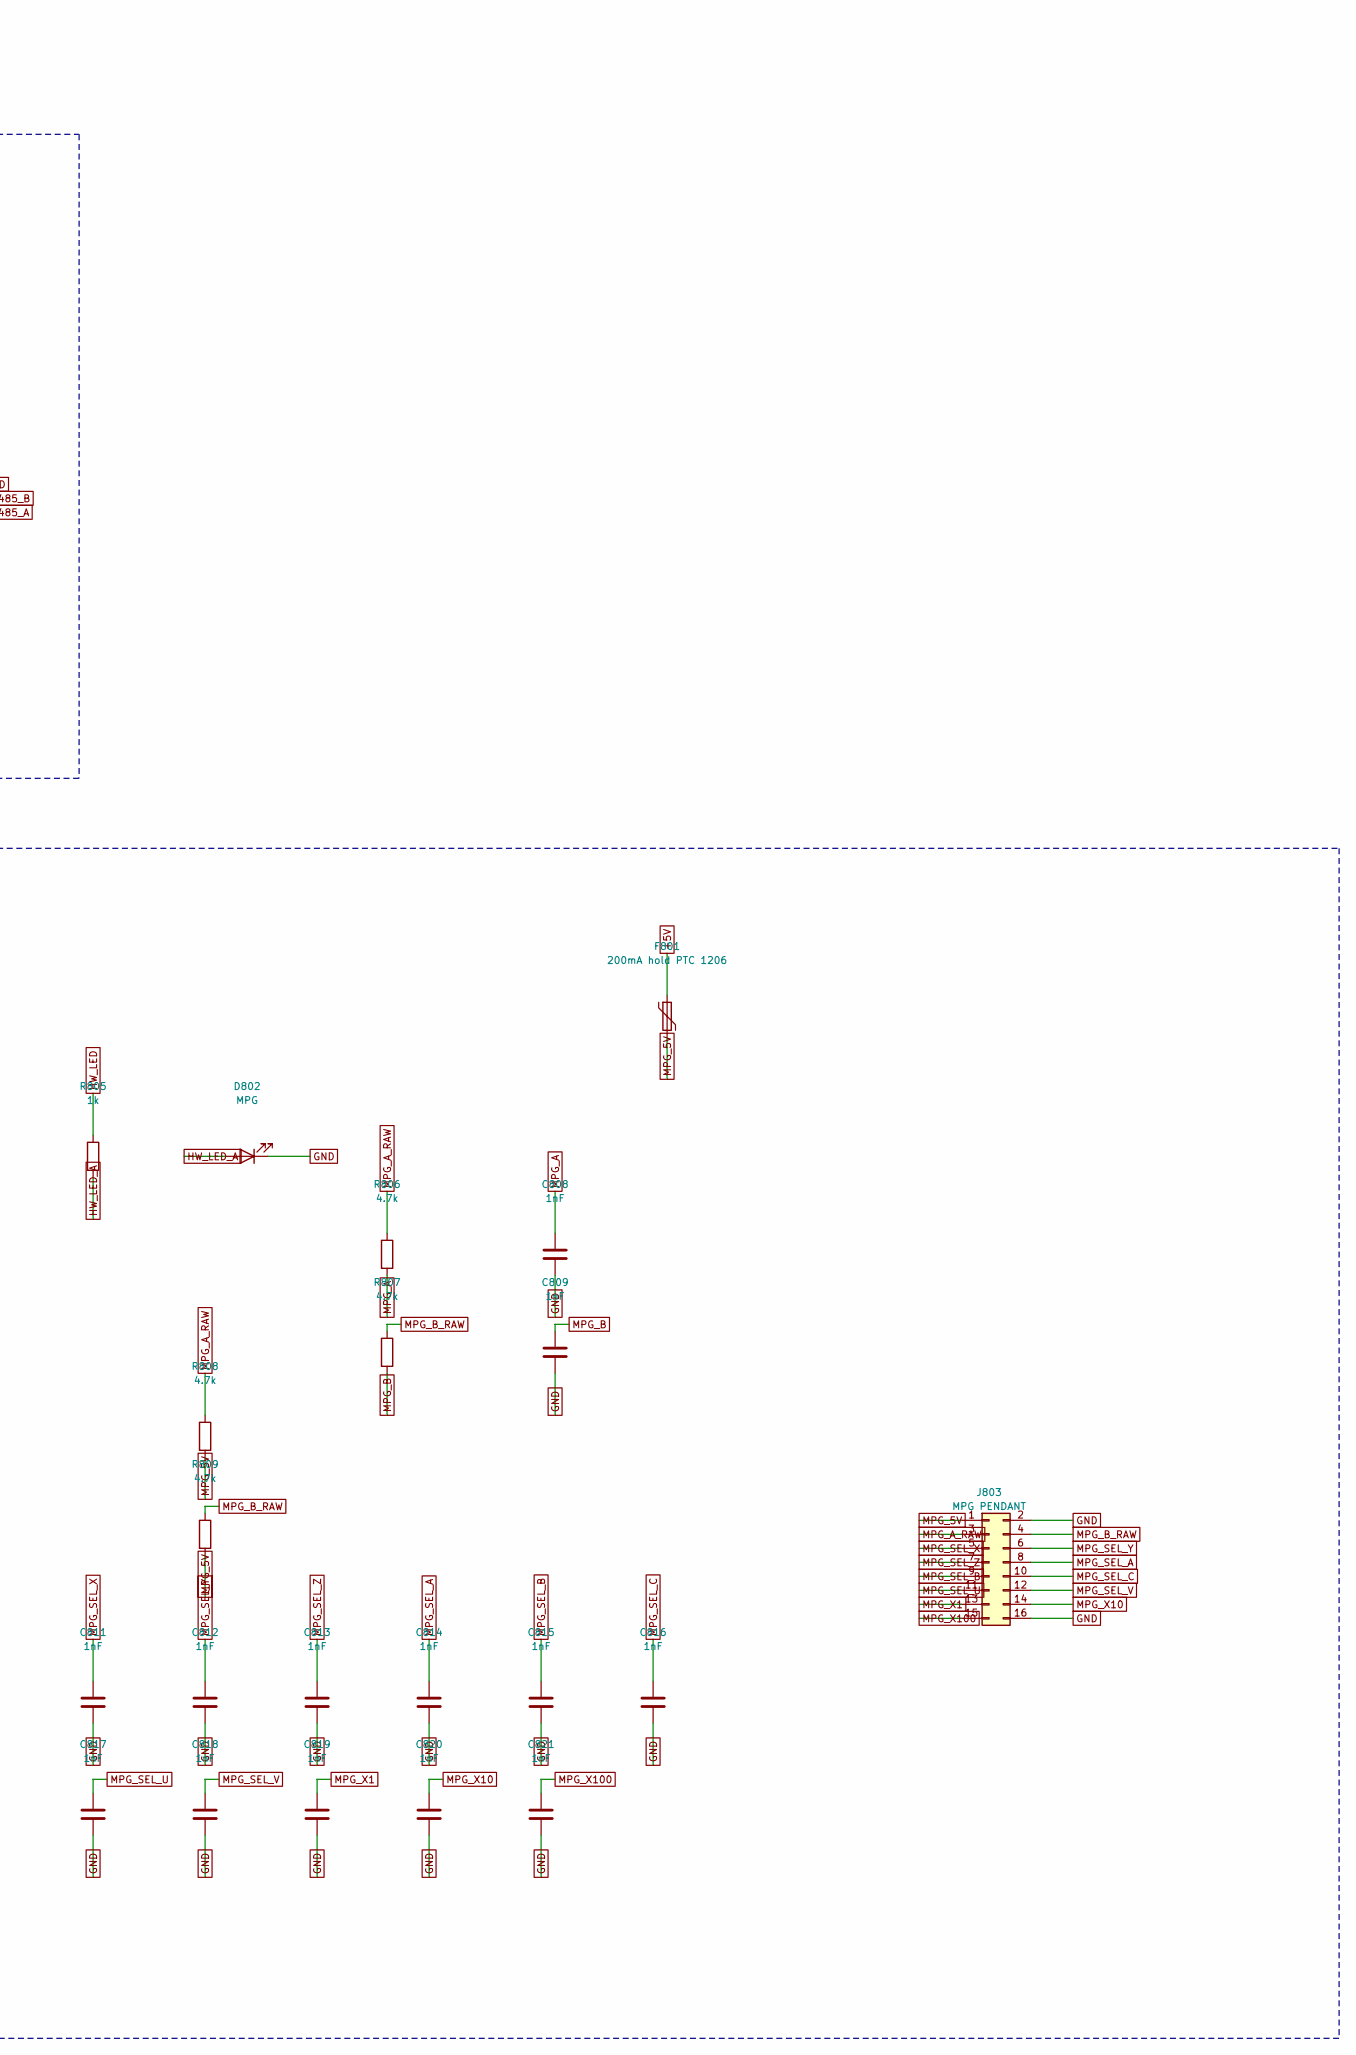
[picture p35: schematic 08_comms.kicad_sch, RS485 VFD port and handwheel MCU, part in row 1, column 2]

Parts:
C801, C802, C803, C804: 100nF; C_0603_1608Metric
C805: 10nF; C_0603_1608Metric
C806, C807: 22pF; C_0603_1608Metric
C808, C809, C811, C812, C813, C814, C815, C816, C817, C818, C819, C820, C821: 1nF; C_0603_1608Metric
D801: NUP2105L; SOT-23
D802: MPG; LED_0603_1608Metric
F801: 200mA hold PTC 1206; Fuse_1206_3216Metric
J801: RS485 A B GND; TerminalBlock_Phoenix_MKDS-1,5-3_1x03_P5.00mm_Horizontal
J802: HW ICSP; PinHeader_2x03_P2.54mm_Vertical
J803: MPG PENDANT; IDC-Header_2x08_P2.54mm_Vertical
JP801: TERM 120R; SolderJumper-2_P1.3mm_Open_RoundedPad1.0x1.5mm
R801, R802, R804: 10k; R_0603_1608Metric
R803: 120R; R_0603_1608Metric
R805: 1k; R_0603_1608Metric
R806, R807, R808, R809: 4.7k; R_0603_1608Metric
U801: MAX3485ESA; SOIC-8_3.9x4.9mm_P1.27mm
U802: ATmega328P-AU; TQFP-32_7x7mm_P0.8mm
Y801: 8MHz; Crystal_SMD_3225-4Pin_3.2x2.5mm

Connections:
+3V3: C801.1, C802.1, C803.1, C804.1, J802.2 (VCC), R801.1, R804.1, U801.8 (VCC), U802.4 (VCC), U802.6 (VCC), U802.18 (AVCC); also elsewhere on the board
+5V: F801.1; also elsewhere on the board
GND: C801.2, C802.2, C803.2, C804.2, C805.2, C806.2, C807.2, C808.2, C809.2, C811.2, C812.2, C813.2, C814.2, C815.2, C816.2, C817.2, C818.2, C819.2, C820.2, C821.2, D801.3 (A), D802.1 (K), J801.1, J802.6 (GND), J803.2, J803.16, R802.2, U801.5 (GND), U802.3 (GND), U802.5 (GND), U802.21 (GND), Y801.2 (G), Y801.4 (G); also elsewhere on the board
HW_LED: R805.1, U802.13 (PB1)
HW_LED_A: D802.2 (A), R805.2
HW_MISO: J802.1 (MISO), U802.16 (PB4)
HW_MOSI: J802.4 (MOSI), U802.15 (PB3)
HW_RESET: C805.1, J802.5 (~RST), R804.2, U802.29 (~RESET/PC6)
HW_SCK: J802.3 (SCK), U802.17 (PB5)
HW_XTAL1: C806.1, U802.7 (XTAL1/PB6), Y801.3
HW_XTAL2: C807.1, U802.8 (XTAL2/PB7), Y801.1
MPG_5V: F801.2, J803.1, R808.2, R809.2
MPG_A: C808.1, R806.2, U802.32 (PD2)
MPG_A_RAW: J803.3, R806.1, R808.1
MPG_B: C809.1, R807.2, U802.1 (PD3)
MPG_B_RAW: J803.4, R807.1, R809.1
MPG_SEL_A: C814.1, J803.8, U802.26 (PC3)
MPG_SEL_B: C815.1, J803.9, U802.27 (PC4)
MPG_SEL_C: C816.1, J803.10, U802.28 (PC5)
MPG_SEL_U: C817.1, J803.11, U802.2 (PD4)
MPG_SEL_V: C818.1, J803.12, U802.9 (PD5)
MPG_SEL_X: C811.1, J803.5, U802.23 (PC0)
MPG_SEL_Y: C812.1, J803.6, U802.24 (PC1)
MPG_SEL_Z: C813.1, J803.7, U802.25 (PC2)
MPG_X1: C819.1, J803.13, U802.10 (PD6)
MPG_X10: C820.1, J803.14, U802.11 (PD7)
MPG_X100: C821.1, J803.15, U802.12 (PB0)
RS485_A: D801.1 (K), J801.3, JP801.1 (A), U801.6 (A)
RS485_B: D801.2 (K), J801.2, R803.2, U801.7 (B)
RS485_DE: R802.1, U801.2 (~RE), U801.3 (DE); also elsewhere on the board
RS485_DI: U801.4 (DI); also elsewhere on the board
RS485_RO: R801.2, U801.1 (RO); also elsewhere on the board
RS485_T: JP801.2 (B), R803.1
UART1_RX: U802.31 (PD1); also elsewhere on the board
UART1_TX: U802.30 (PD0); also elsewhere on the board

Notes on the sheet:
RS485 VFD PORT AND HANDWHEEL
RS485 - MODBUS RTU TO THE VFD (UART0)
HANDWHEEL MCU - ATmega328P, 3.3 V, 8 MHz, UART1 TO THE RP2350

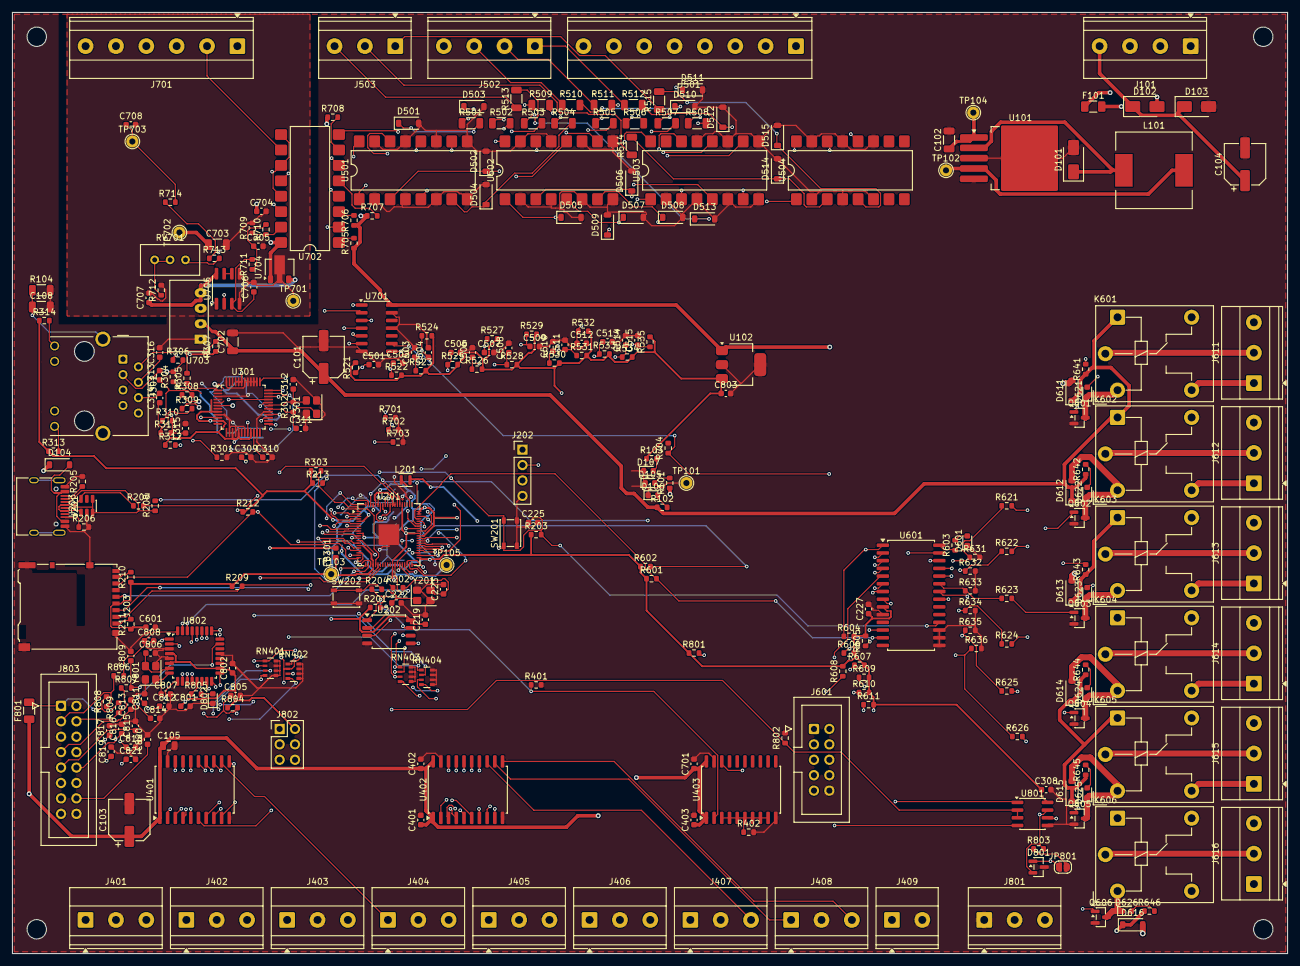
[picture p36: board MACH3SIMPLEETH.kicad_pcb from above]

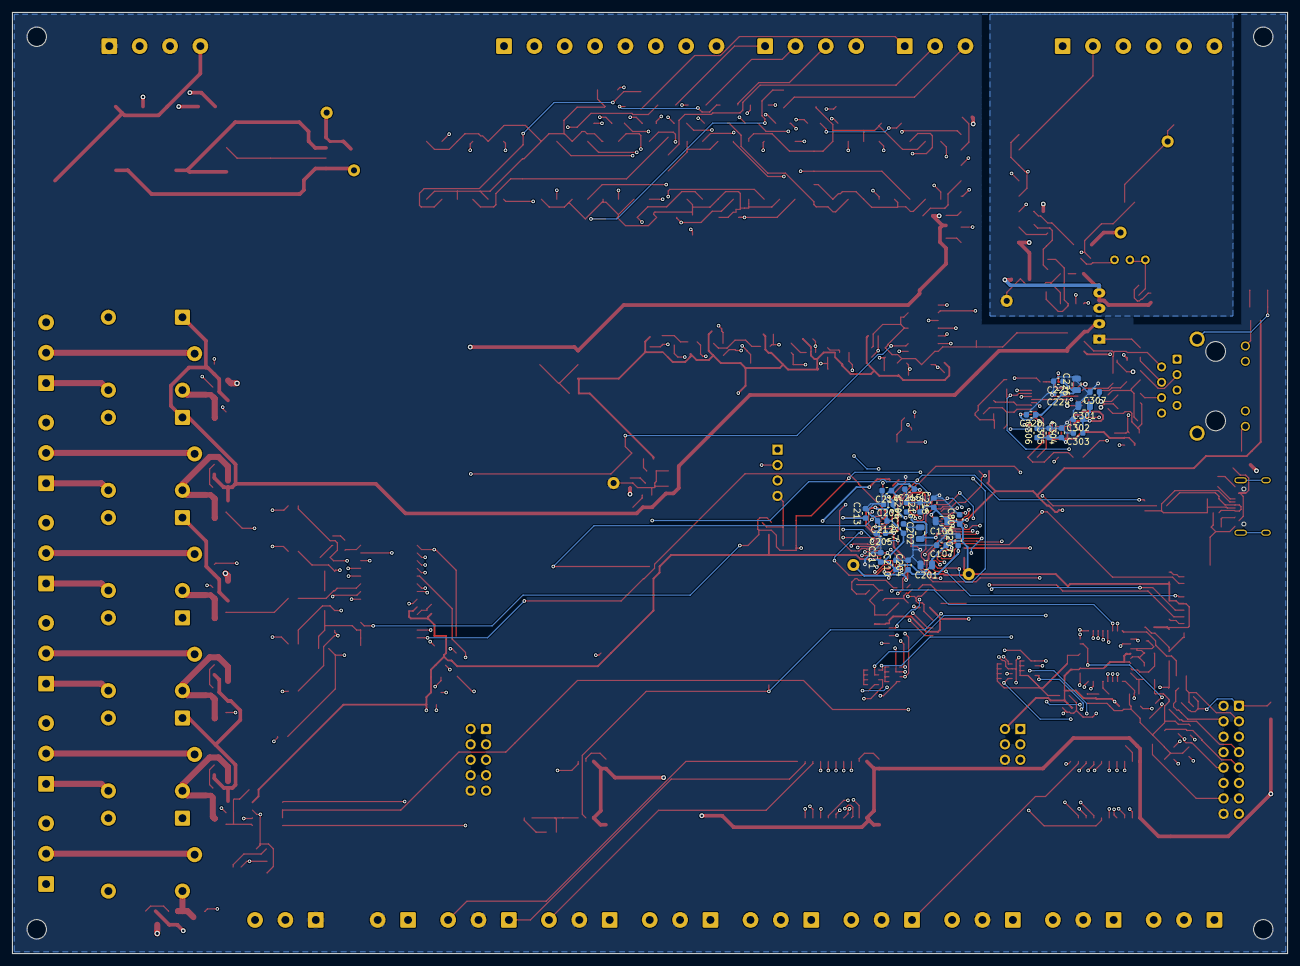
[picture p37: board MACH3SIMPLEETH.kicad_pcb from below]

Board: 4 copper layers, 210.0 x 155.0 mm, 337 parts (30 on the bottom side), 257 nets.
