moein98/heimdall/MACH3_SIMPLE/hardware/MACH3SIMPLE.kicad_pcb

## KiCad design MACH3_SIMPLE/hardware/MACH3SIMPLE.kicad_pcb (2026-09-25)

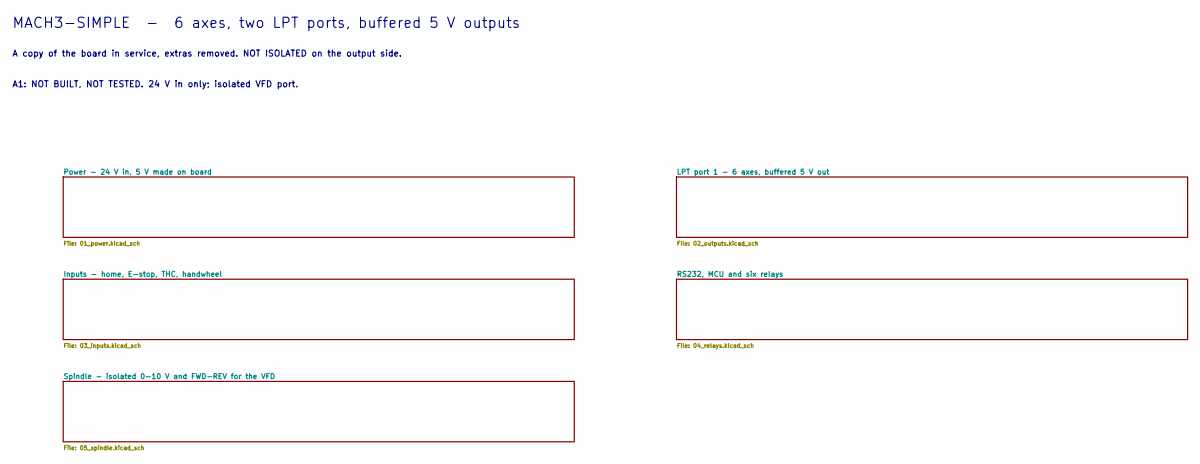
[picture p38: schematic MACH3SIMPLE.kicad_sch, MACH3-SIMPLE: copy of the board in service]

Notes on the sheet:
MACH3-SIMPLE - 6 axes, two LPT ports, buffered 5 V outputs
A copy of the board in service, extras removed. NOT ISOLATED on the output side.
A1: NOT BUILT, NOT TESTED. 24 V in only; isolated VFD port.

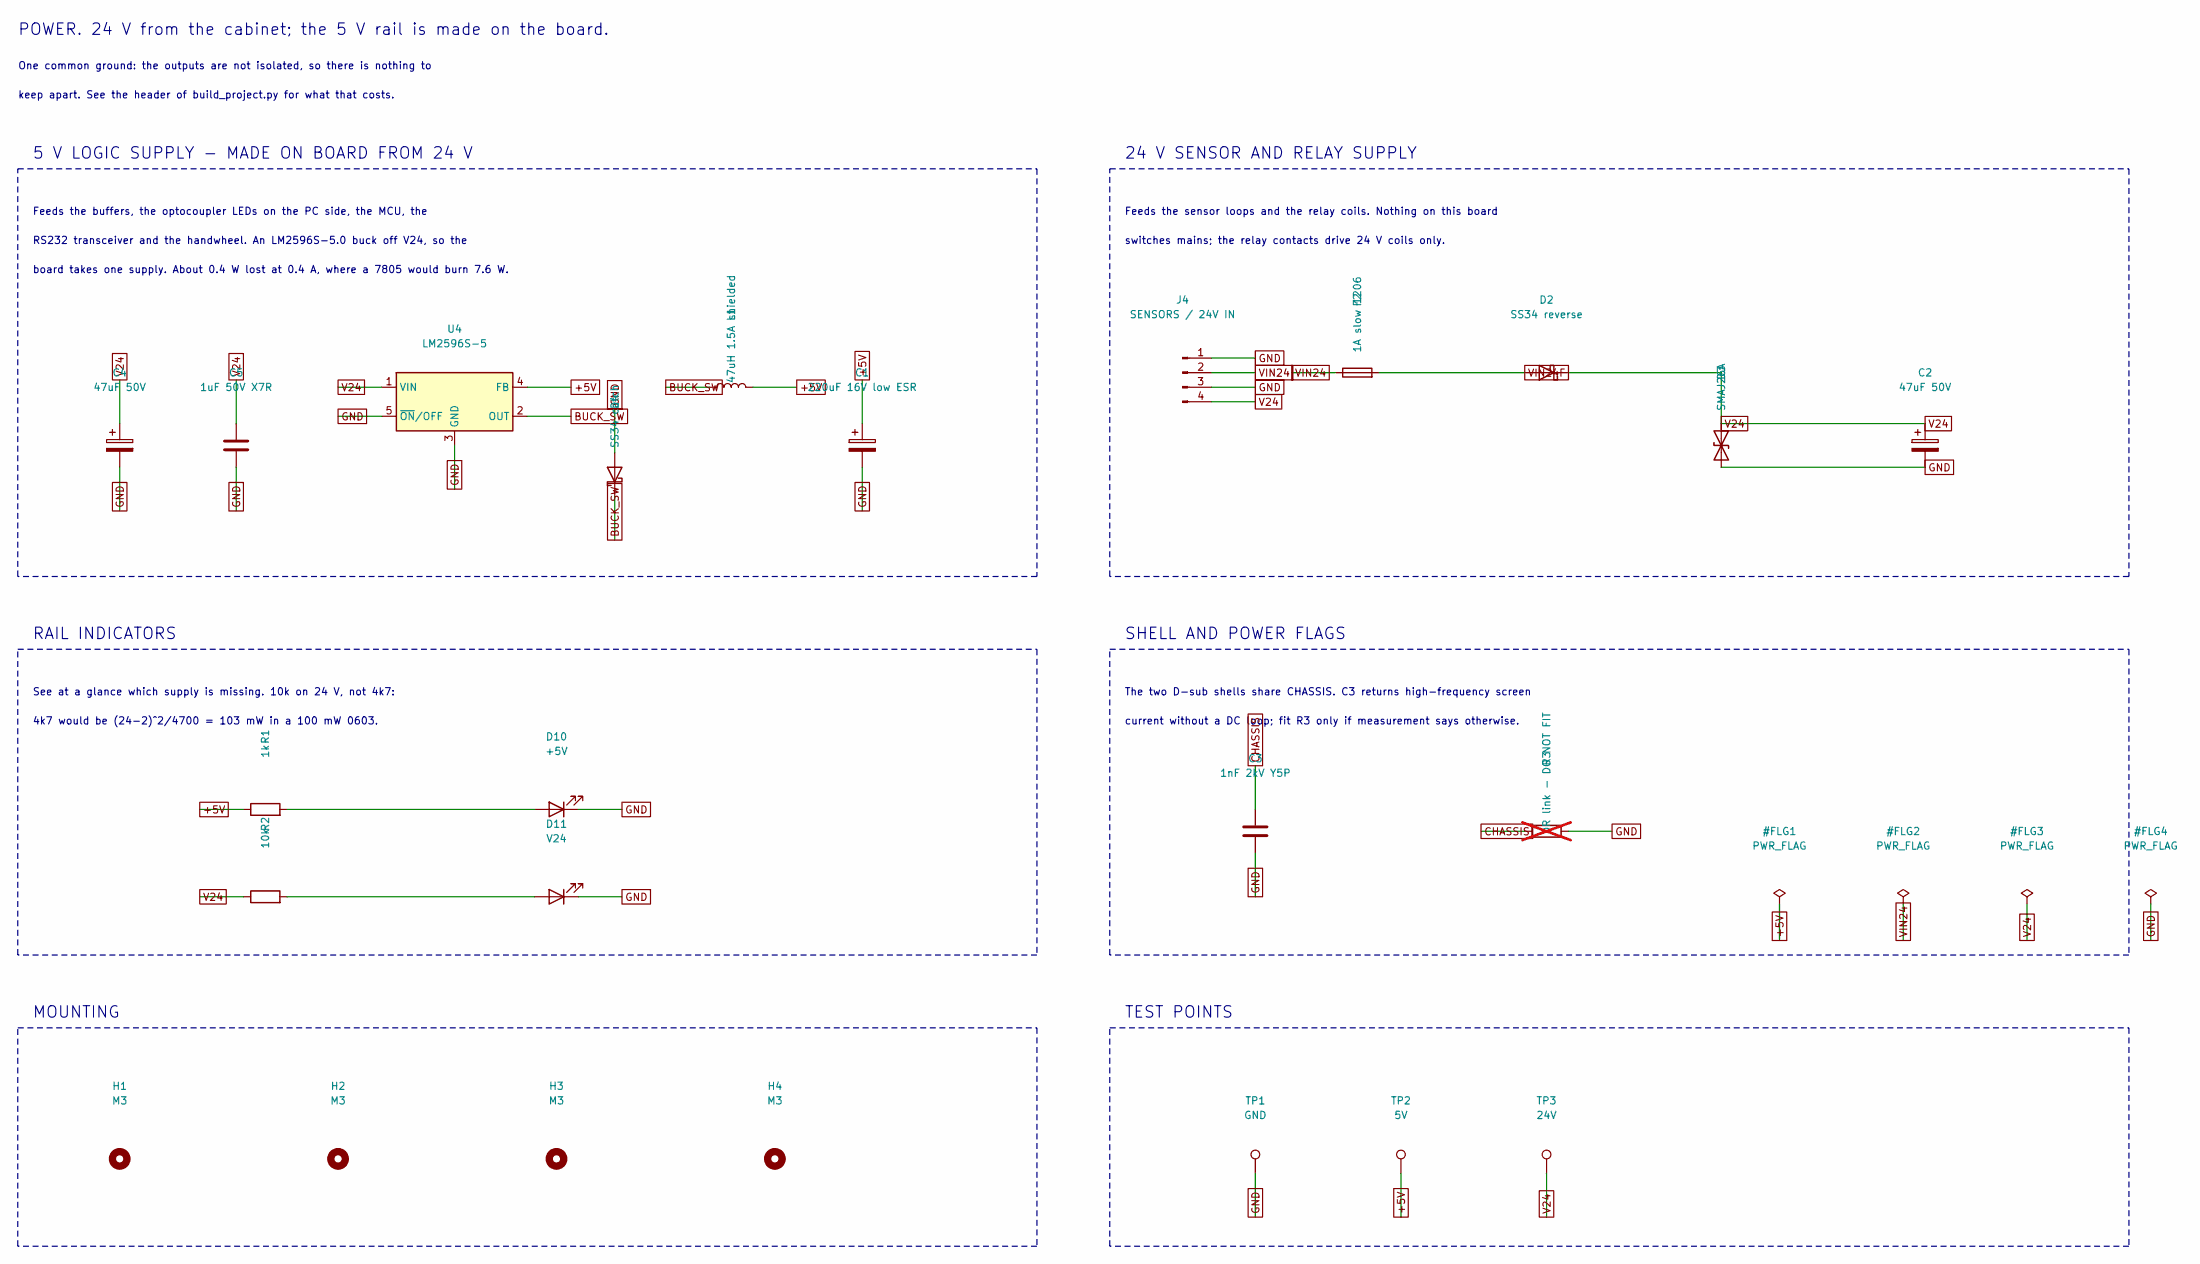
[picture p39: schematic 01_power.kicad_sch, Power - 24 V in, 5 V made on board]

Parts:
C1: 220uF 16V low ESR; CP_Elec_6.3x7.7
C2, C4: 47uF 50V; CP_Elec_6.3x7.7
C3: 1nF 2kV Y5P; C_Disc_D5.0mm_W2.5mm_P5.00mm
C5: 1uF 50V X7R; C_1206_3216Metric
D2: SS34 reverse; D_SMA
D3: SMAJ26A; D_SMA
D4: SS34 catch; D_SMA
D10: +5V; LED_0603_1608Metric
D11: V24; LED_0603_1608Metric
F2: 1A slow 1206; Fuse_1206_3216Metric
H1, H2, H3, H4: M3; MountingHole_3.2mm_M3
J4: SENSORS / 24V IN; TerminalBlock_Phoenix_MKDS-1,5-4_1x04_P5.00mm_Horizontal
L1: 47uH 1.5A shielded; L_12x12mm_H8mm
R1: 1k; R_0603_1608Metric
R2: 10k; R_0603_1608Metric
R3: 0R link - DO NOT FIT; R_1206_3216Metric; not fitted
TP1: GND; TestPoint_THTPad_D2.0mm_Drill1.0mm
TP2: 5V; TestPoint_THTPad_D2.0mm_Drill1.0mm
TP3: 24V; TestPoint_THTPad_D2.0mm_Drill1.0mm
U4: LM2596S-5; TO-263-5_TabPin3

Connections:
+5V: C1.1, L1.2, R1.1, TP2.1, U4.4 (FB); also elsewhere on the board
BUCK_SW: D4.1 (K), L1.1, U4.2 (OUT)
CHASSIS: C3.1, R3.1; also elsewhere on the board
GND: C1.2, C2.2, C3.2, C4.2, C5.2, D3.2 (A2), D4.2 (A), D10.1 (K), D11.1 (K), J4.1, J4.3, R3.2, TP1.1, U4.3 (GND), U4.5 (~ON/OFF); also elsewhere on the board
unnamed: D10.2 (A), R1.2
unnamed: D11.2 (A), R2.2
V24: C2.1, C4.1, C5.1, D2.1 (K), D3.1 (A1), J4.4, R2.1, TP3.1, U4.1 (VIN); also elsewhere on the board
VIN24: F2.1, J4.2
VIN24F: D2.2 (A), F2.2

Notes on the sheet:
POWER. 24 V from the cabinet; the 5 V rail is made on the board.
One common ground: the outputs are not isolated, so there is nothing to
keep apart. See the header of build_project.py for what that costs.
5 V LOGIC SUPPLY - MADE ON BOARD FROM 24 V
Feeds the buffers, the optocoupler LEDs on the PC side, the MCU, the
RS232 transceiver and the handwheel. An LM2596S-5.0 buck off V24, so the
board takes one supply. About 0.4 W lost at 0.4 A, where a 7805 would burn 7.6 W.
24 V SENSOR AND RELAY SUPPLY
Feeds the sensor loops and the relay coils. Nothing on this board
switches mains; the relay contacts drive 24 V coils only.
RAIL INDICATORS
See at a glance which supply is missing. 10k on 24 V, not 4k7:
4k7 would be (24-2)^2/4700 = 103 mW in a 100 mW 0603.
SHELL AND POWER FLAGS
The two D-sub shells share CHASSIS. C3 returns high-frequency screen
current without a DC loop; fit R3 only if measurement says otherwise.
TEST POINTS
MOUNTING

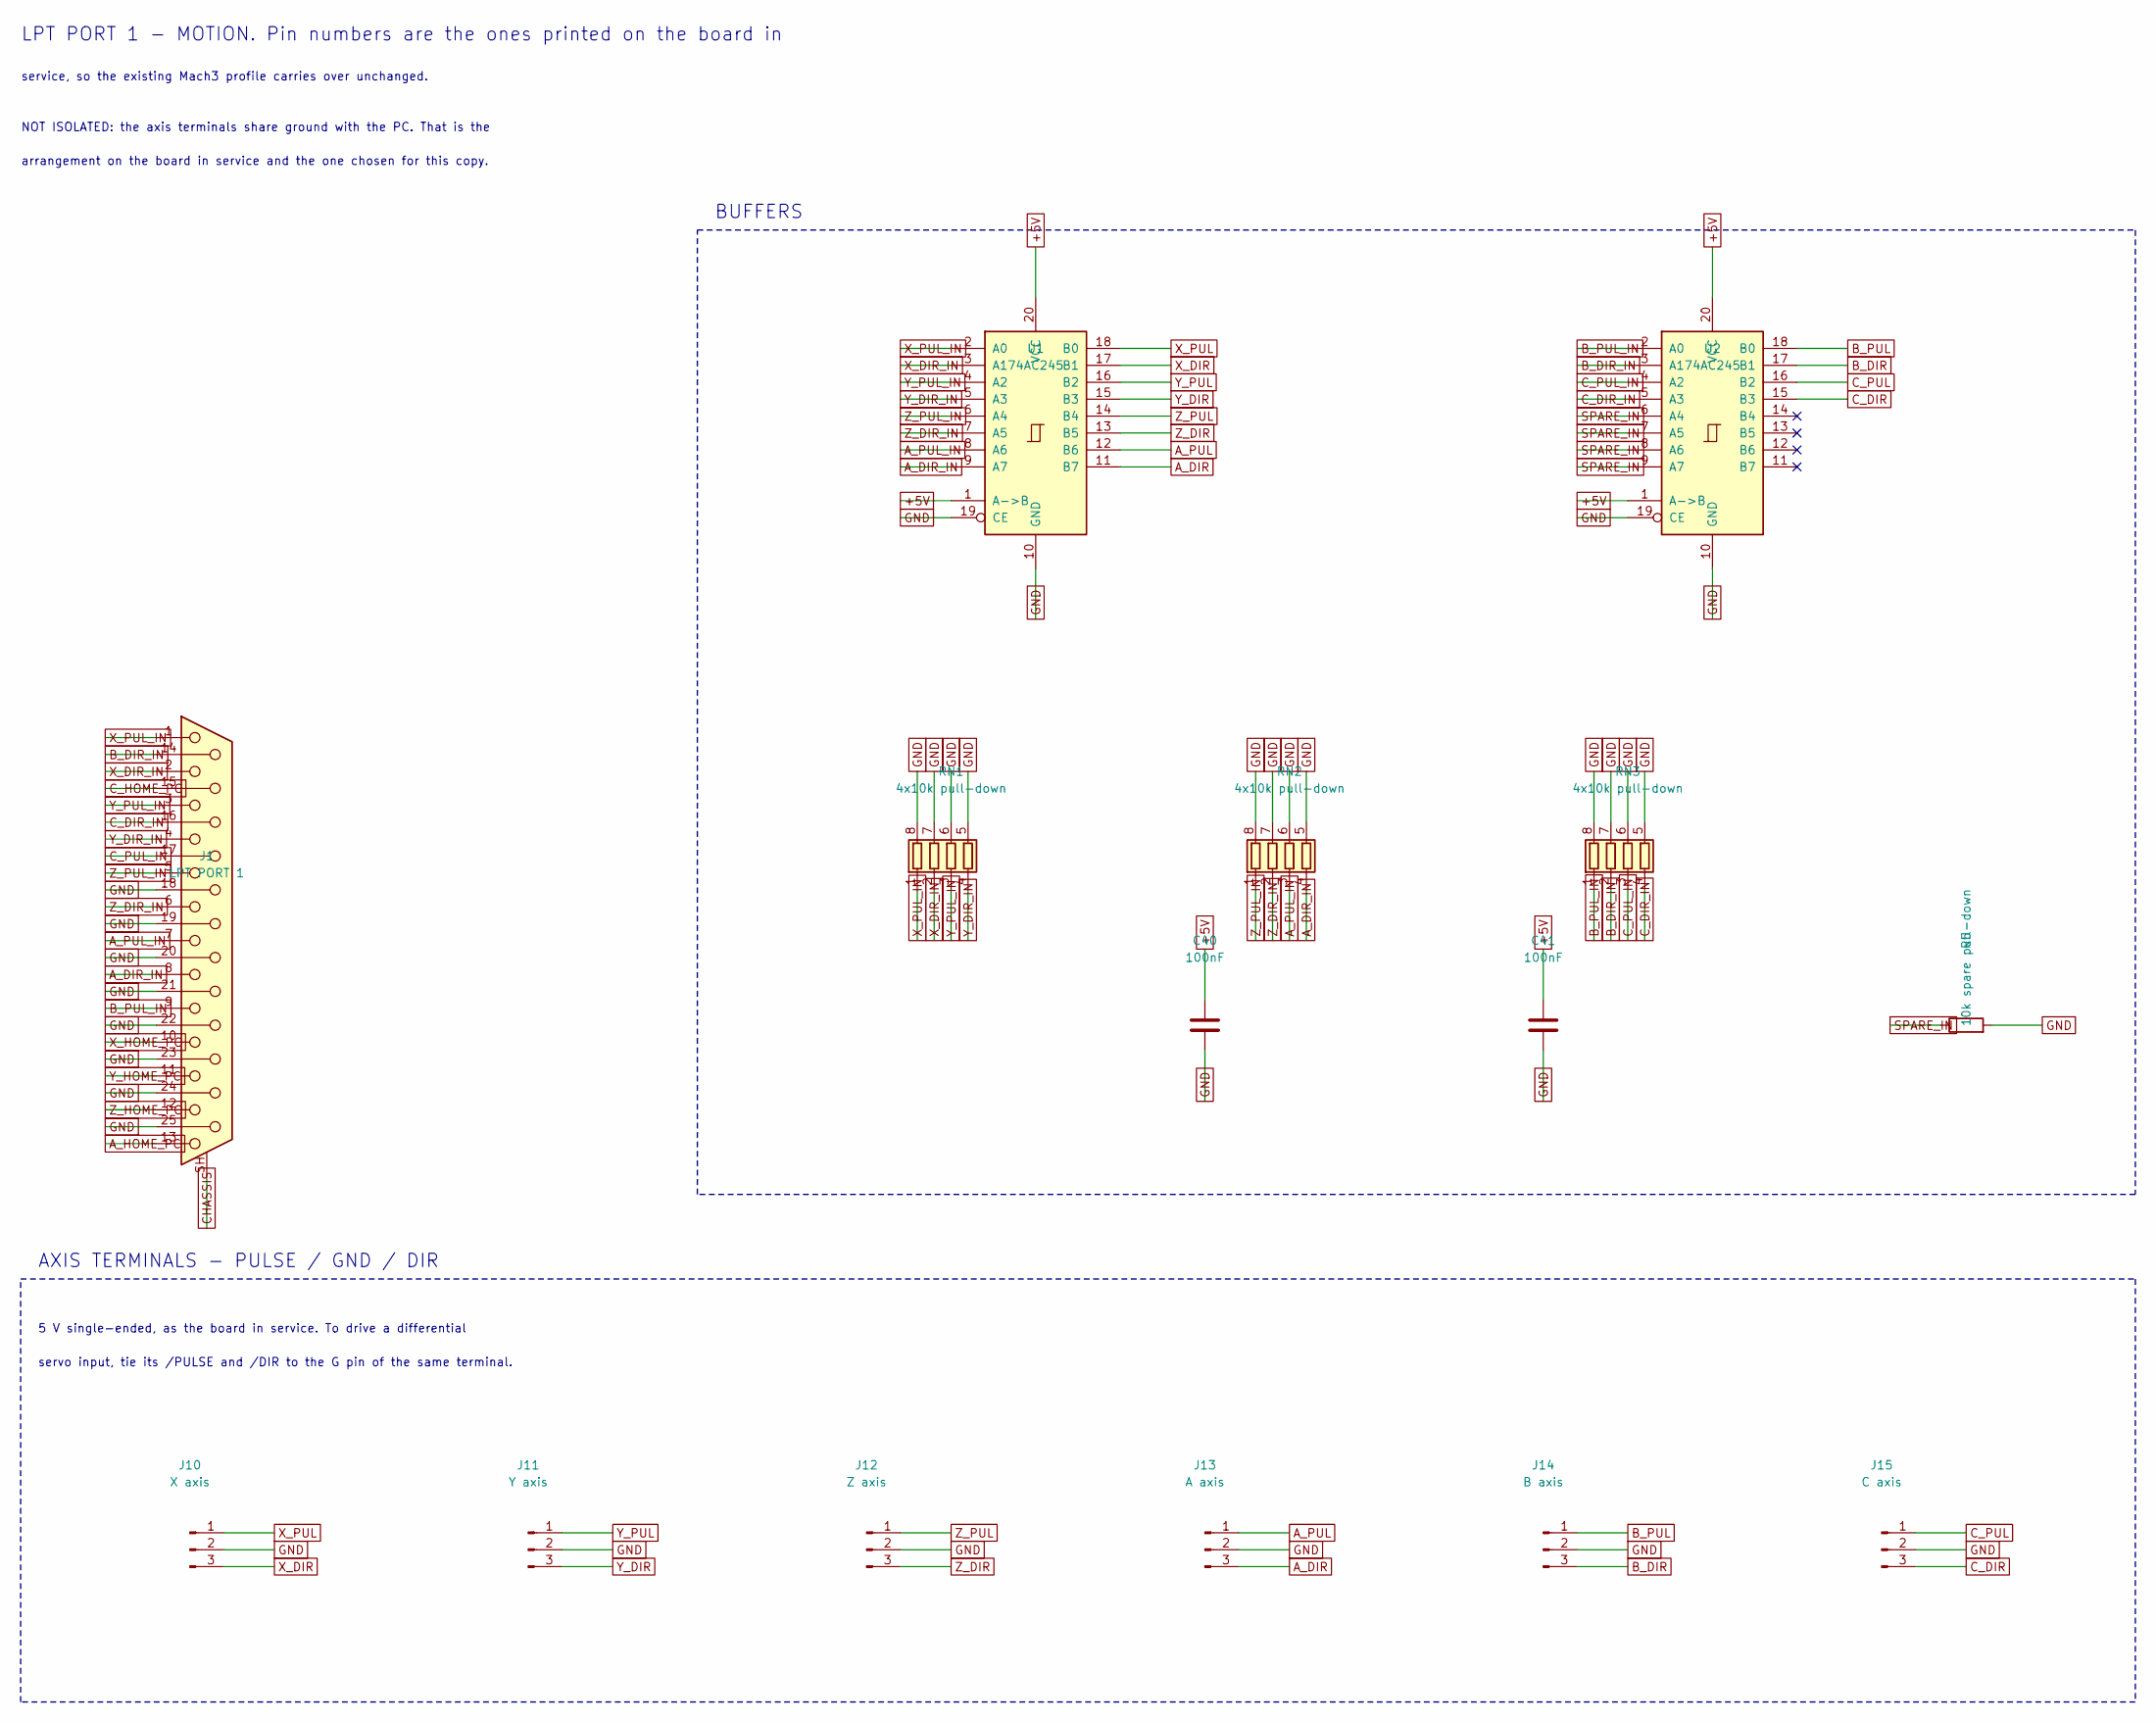
[picture p40: schematic 02_outputs.kicad_sch, LPT port 1 - 6 axes, buffered 5 V out]

Parts:
C40, C41: 100nF; C_0603_1608Metric
J1: LPT PORT 1; DSUB-25_Socket_Horizontal_P2.77x2.84mm_EdgePinOffset7.70mm_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
J10: X axis; TerminalBlock_Phoenix_MKDS-1,5-3_1x03_P5.00mm_Horizontal
J11: Y axis; TerminalBlock_Phoenix_MKDS-1,5-3_1x03_P5.00mm_Horizontal
J12: Z axis; TerminalBlock_Phoenix_MKDS-1,5-3_1x03_P5.00mm_Horizontal
J13: A axis; TerminalBlock_Phoenix_MKDS-1,5-3_1x03_P5.00mm_Horizontal
J14: B axis; TerminalBlock_Phoenix_MKDS-1,5-3_1x03_P5.00mm_Horizontal
J15: C axis; TerminalBlock_Phoenix_MKDS-1,5-3_1x03_P5.00mm_Horizontal
R5: 10k spare pull-down; R_0603_1608Metric
RN1, RN2, RN3: 4x10k pull-down; R_Array_Convex_4x0603
U1, U2: 74AC245; SOIC-20W_7.5x12.8mm_P1.27mm

Connections:
+5V: C40.1, C41.1, U1.1 (A->B), U1.20 (VCC), U2.1 (A->B), U2.20 (VCC); also elsewhere on the board
A_DIR: J13.3, U1.11 (B7)
A_DIR_IN: J1.8, RN2.4 (R4.1), U1.9 (A7)
A_HOME_PC: J1.13; also elsewhere on the board
A_PUL: J13.1, U1.12 (B6)
A_PUL_IN: J1.7, RN2.3 (R3.1), U1.8 (A6)
B_DIR: J14.3, U2.17 (B1)
B_DIR_IN: J1.14, RN3.2 (R2.1), U2.3 (A1)
B_PUL: J14.1, U2.18 (B0)
B_PUL_IN: J1.9, RN3.1 (R1.1), U2.2 (A0)
CHASSIS: J1.SH (PAD); also elsewhere on the board
C_DIR: J15.3, U2.15 (B3)
C_DIR_IN: J1.16, RN3.4 (R4.1), U2.5 (A3)
C_HOME_PC: J1.15; also elsewhere on the board
C_PUL: J15.1, U2.16 (B2)
C_PUL_IN: J1.17, RN3.3 (R3.1), U2.4 (A2)
GND: C40.2, C41.2, J1.18, J1.19, J1.20, J1.21, J1.22, J1.23, J1.24, J1.25, J10.2, J11.2, J12.2, J13.2, J14.2, J15.2, R5.2, RN1.5 (R4.2), RN1.6 (R3.2), RN1.7 (R2.2), RN1.8 (R1.2), RN2.5 (R4.2), RN2.6 (R3.2), RN2.7 (R2.2), RN2.8 (R1.2), RN3.5 (R4.2), RN3.6 (R3.2), RN3.7 (R2.2), RN3.8 (R1.2), U1.10 (GND), U1.19 (CE), U2.10 (GND), U2.19 (CE); also elsewhere on the board
SPARE_IN: R5.1, U2.6 (A4), U2.7 (A5), U2.8 (A6), U2.9 (A7)
X_DIR: J10.3, U1.17 (B1)
X_DIR_IN: J1.2, RN1.2 (R2.1), U1.3 (A1)
X_HOME_PC: J1.10; also elsewhere on the board
X_PUL: J10.1, U1.18 (B0)
X_PUL_IN: J1.1, RN1.1 (R1.1), U1.2 (A0)
Y_DIR: J11.3, U1.15 (B3)
Y_DIR_IN: J1.4, RN1.4 (R4.1), U1.5 (A3)
Y_HOME_PC: J1.11; also elsewhere on the board
Y_PUL: J11.1, U1.16 (B2)
Y_PUL_IN: J1.3, RN1.3 (R3.1), U1.4 (A2)
Z_DIR: J12.3, U1.13 (B5)
Z_DIR_IN: J1.6, RN2.2 (R2.1), U1.7 (A5)
Z_HOME_PC: J1.12; also elsewhere on the board
Z_PUL: J12.1, U1.14 (B4)
Z_PUL_IN: J1.5, RN2.1 (R1.1), U1.6 (A4)

Notes on the sheet:
LPT PORT 1 - MOTION. Pin numbers are the ones printed on the board in
service, so the existing Mach3 profile carries over unchanged.
NOT ISOLATED: the axis terminals share ground with the PC. That is the
arrangement on the board in service and the one chosen for this copy.
BUFFERS
AXIS TERMINALS - PULSE / GND / DIR
5 V single-ended, as the board in service. To drive a differential
servo input, tie its /PULSE and /DIR to the G pin of the same terminal.
