moein98/heimdall/MACH3_SIMPLE/hardware/MACH3SIMPLE.kicad_pcb

## KiCad design MACH3_SIMPLE/hardware/MACH3SIMPLE.kicad_pcb (continued)

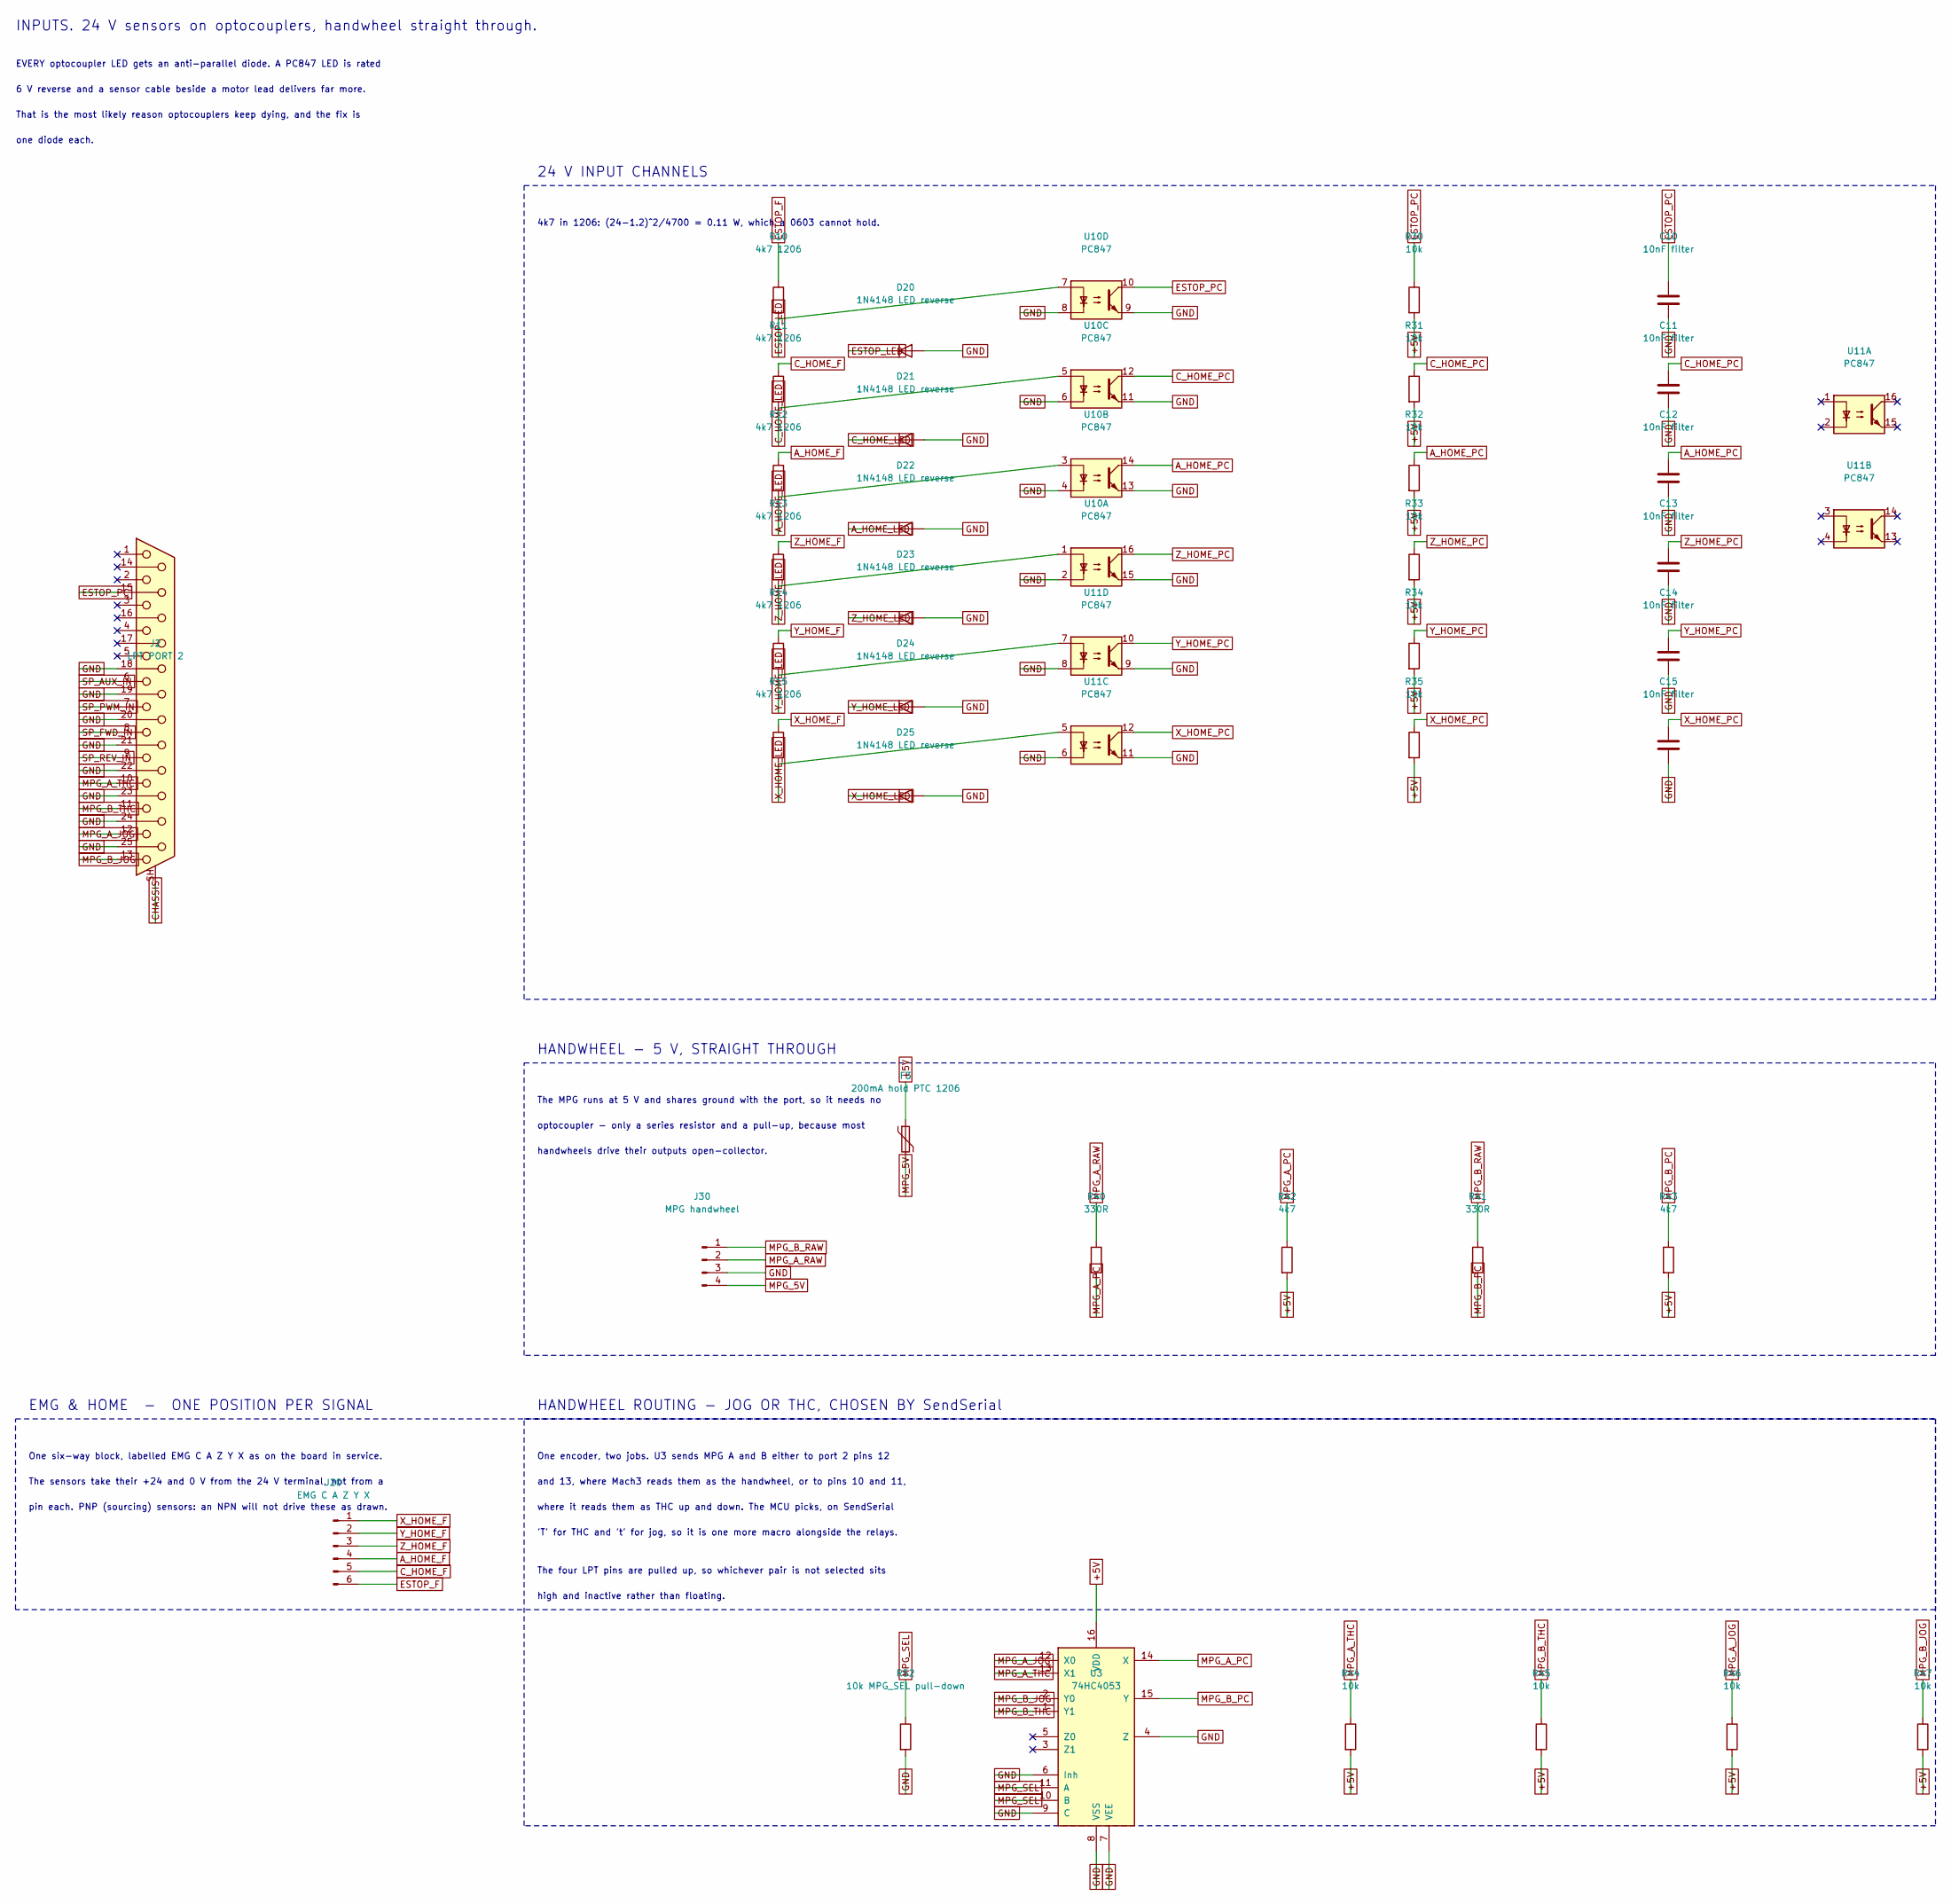
[picture p41: schematic 03_inputs.kicad_sch, Inputs - home, E-stop, THC, handwheel]

Parts:
C10, C11, C12, C13, C14, C15: 10nF filter; C_0603_1608Metric
D20, D21, D22, D23, D24, D25: 1N4148 LED reverse; D_SOD-123
F3: 200mA hold PTC 1206; Fuse_1206_3216Metric
J2: LPT PORT 2; DSUB-25_Socket_Horizontal_P2.77x2.84mm_EdgePinOffset7.70mm_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
J20: EMG C A Z Y X; TerminalBlock_Phoenix_MKDS-1,5-6_1x06_P5.00mm_Horizontal
J30: MPG handwheel; TerminalBlock_Phoenix_MKDS-1,5-4_1x04_P5.00mm_Horizontal
R10, R11, R12, R13, R14, R15: 4k7 1206; R_1206_3216Metric
R30, R31, R32, R33, R34, R35, R44, R45, R46, R47: 10k; R_0603_1608Metric
R40, R41: 330R; R_0603_1608Metric
R42, R43: 4k7; R_0603_1608Metric
R52: 10k MPG_SEL pull-down; R_0603_1608Metric
U3: 74HC4053; SOIC-16_3.9x9.9mm_P1.27mm
U10, U11: PC847; SMDIP-16_W9.53mm

Connections:
+5V: F3.1, R30.2, R31.2, R32.2, R33.2, R34.2, R35.2, R42.2, R43.2, R44.2, R45.2, R46.2, R47.2, U3.16 (VDD); also elsewhere on the board
A_HOME_F: J20.4, R12.1
A_HOME_LED: D22.1 (K), R12.2, U10.3
A_HOME_PC: C12.1, R32.1, U10.14; also elsewhere on the board
CHASSIS: J2.SH (PAD); also elsewhere on the board
C_HOME_F: J20.5, R11.1
C_HOME_LED: D21.1 (K), R11.2, U10.5
C_HOME_PC: C11.1, R31.1, U10.12; also elsewhere on the board
ESTOP_F: J20.6, R10.1
ESTOP_LED: D20.1 (K), R10.2, U10.7
ESTOP_PC: C10.1, J2.15, R30.1, U10.10
GND: C10.2, C11.2, C12.2, C13.2, C14.2, C15.2, D20.2 (A), D21.2 (A), D22.2 (A), D23.2 (A), D24.2 (A), D25.2 (A), J2.18, J2.19, J2.20, J2.21, J2.22, J2.23, J2.24, J2.25, J30.3, R52.2, U3.4 (Z), U3.6 (Inh), U3.7 (VEE), U3.8 (VSS), U3.9 (C), U10.2, U10.4, U10.6, U10.8, U10.9, U10.11, U10.13, U10.15, U11.6, U11.8, U11.9, U11.11; also elsewhere on the board
MPG_5V: F3.2, J30.4
MPG_A_JOG: J2.12, R46.1, U3.12 (X0)
MPG_A_PC: R40.2, R42.1, U3.14 (X)
MPG_A_RAW: J30.2, R40.1
MPG_A_THC: J2.10, R44.1, U3.13 (X1)
MPG_B_JOG: J2.13, R47.1, U3.2 (Y0)
MPG_B_PC: R41.2, R43.1, U3.15 (Y)
MPG_B_RAW: J30.1, R41.1
MPG_B_THC: J2.11, R45.1, U3.1 (Y1)
MPG_SEL: R52.1, U3.10 (B), U3.11 (A); also elsewhere on the board
SP_AUX_IN: J2.6; also elsewhere on the board
SP_FWD_IN: J2.8; also elsewhere on the board
SP_PWM_IN: J2.7; also elsewhere on the board
SP_REV_IN: J2.9; also elsewhere on the board
X_HOME_F: J20.1, R15.1
X_HOME_LED: D25.1 (K), R15.2, U11.5
X_HOME_PC: C15.1, R35.1, U11.12; also elsewhere on the board
Y_HOME_F: J20.2, R14.1
Y_HOME_LED: D24.1 (K), R14.2, U11.7
Y_HOME_PC: C14.1, R34.1, U11.10; also elsewhere on the board
Z_HOME_F: J20.3, R13.1
Z_HOME_LED: D23.1 (K), R13.2, U10.1
Z_HOME_PC: C13.1, R33.1, U10.16; also elsewhere on the board

Notes on the sheet:
INPUTS. 24 V sensors on optocouplers, handwheel straight through.
EVERY optocoupler LED gets an anti-parallel diode. A PC847 LED is rated
6 V reverse and a sensor cable beside a motor lead delivers far more.
That is the most likely reason optocouplers keep dying, and the fix is
one diode each.
24 V INPUT CHANNELS
4k7 in 1206: (24-1.2)^2/4700 = 0.11 W, which a 0603 cannot hold.
HANDWHEEL - 5 V, STRAIGHT THROUGH
The MPG runs at 5 V and shares ground with the port, so it needs no
optocoupler - only a series resistor and a pull-up, because most
handwheels drive their outputs open-collector.
HANDWHEEL ROUTING - JOG OR THC, CHOSEN BY SendSerial
One encoder, two jobs. U3 sends MPG A and B either to port 2 pins 12
and 13, where Mach3 reads them as the handwheel, or to pins 10 and 11,
where it reads them as THC up and down. The MCU picks, on SendSerial
'T' for THC and 't' for jog, so it is one more macro alongside the relays.
The four LPT pins are pulled up, so whichever pair is not selected sits
high and inactive rather than floating.
EMG & HOME - ONE POSITION PER SIGNAL
One six-way block, labelled EMG C A Z Y X as on the board in service.
The sensors take their +24 and 0 V from the 24 V terminal, not from a
pin each. PNP (sourcing) sensors: an NPN will not drive these as drawn.

Schematic: 04_relays.kicad_sch, RS232, MCU and six relays

Parts:
C20, C21, C22, C23, C30, C31, C32, C42: 100nF; C_0603_1608Metric
C33, C34: 22pF; C_0603_1608Metric
C35: 10nF; C_0603_1608Metric
D30: SERIAL; LED_0603_1608Metric
D40, D41, D42, D43, D44, D45: 1N4148 flyback; D_SOD-123
D50: KA; LED_0603_1608Metric
D51: KB; LED_0603_1608Metric
D52: KC; LED_0603_1608Metric
D53: KD; LED_0603_1608Metric
D54: KE; LED_0603_1608Metric
D55: KF; LED_0603_1608Metric
J40: Relay A; TerminalBlock_Phoenix_MKDS-1,5-3_1x03_P5.00mm_Horizontal
J41: Relay B; TerminalBlock_Phoenix_MKDS-1,5-3_1x03_P5.00mm_Horizontal
J42: Relay C; TerminalBlock_Phoenix_MKDS-1,5-3_1x03_P5.00mm_Horizontal
J43: Relay D; TerminalBlock_Phoenix_MKDS-1,5-3_1x03_P5.00mm_Horizontal
J44: Relay E; TerminalBlock_Phoenix_MKDS-1,5-3_1x03_P5.00mm_Horizontal
J45: Relay F; TerminalBlock_Phoenix_MKDS-1,5-3_1x03_P5.00mm_Horizontal
J50: RS232 RX TX GND; TerminalBlock_Phoenix_MKDS-1,5-3_1x03_P5.00mm_Horizontal
J60: ICSP; IDC-Header_2x05_P2.54mm_Vertical
K1, K2, K3, K4, K5, K6: JQC-3FF-024-1Z; Relay_SPDT_Hongfa_JQC-3FF_0XX-1Z
Q1, Q2, Q3, Q4, Q5, Q6: 2N7002; SOT-23
R50, R70, R71, R72, R73, R74, R75, R80, R81, R82, R83, R84, R85: 10k; R_0603_1608Metric
R51, R60, R61, R62, R63, R64, R65: 1k; R_0603_1608Metric
U20: MAX3232; SOIC-16_3.9x9.9mm_P1.27mm
U21: ATmega328P-AU; TQFP-32_7x7mm_P0.8mm
Y1: 16MHz; Crystal_SMD_3225-4Pin_3.2x2.5mm

Connections:
+5V: C22.2, C30.1, C31.1, C32.1, C42.1, J60.2 (VCC), R50.2, U20.16 (VCC), U21.4 (VCC), U21.6 (VCC), U21.18 (AVCC); also elsewhere on the board
C1N: C20.2, U20.3 (C1-)
C1P: C20.1, U20.1 (C1+)
C2N: C21.2, U20.5 (C2-)
C2P: C21.1, U20.4 (C2+)
GND: C23.2, C30.2, C31.2, C32.2, C33.2, C34.2, C35.2, C42.2, D30.1 (K), J50.3, J60.4 (GND), J60.6 (GND), J60.8 (GND), J60.10 (GND), Q1.2 (S), Q2.2 (S), Q3.2 (S), Q4.2 (S), Q5.2 (S), Q6.2 (S), R70.2, R71.2, R72.2, R73.2, R74.2, R75.2, U20.8 (R2IN), U20.10 (T2IN), U20.15 (GND), U21.3 (GND), U21.5 (GND), U21.19 (ADC6), U21.21 (GND), U21.22 (ADC7), Y1.2 (G), Y1.4 (G); also elsewhere on the board
ICSP_MISO: J60.9 (MISO), U21.16 (PB4)
ICSP_MOSI: J60.1 (MOSI), U21.15 (PB3)
ICSP_SCK: J60.7 (SCK), U21.17 (PB5)
KA_COM: J40.2, K1.11
KA_NC: J40.3, K1.12
KA_NO: J40.1, K1.14
KB_COM: J41.2, K2.11
KB_NC: J41.3, K2.12
KB_NO: J41.1, K2.14
KC_COM: J42.2, K3.11
KC_NC: J42.3, K3.12
KC_NO: J42.1, K3.14
KD_COM: J43.2, K4.11
KD_NC: J43.3, K4.12
KD_NO: J43.1, K4.14
KE_COM: J44.2, K5.11
KE_NC: J44.3, K5.12
KE_NO: J44.1, K5.14
KF_COM: J45.2, K6.11
KF_NC: J45.3, K6.12
KF_NO: J45.1, K6.14
MCU_LED: R51.1, U21.14 (PB2)
MCU_RESET: C35.1, J60.5 (~RST), R50.1, U21.29 (~RESET/PC6)
MCU_RX: U20.12 (R1OUT), U21.30 (PD0)
MCU_TX: U20.11 (T1IN), U21.31 (PD1)
MPG_SEL: U21.13 (PB1); also elsewhere on the board
unnamed: D30.2 (A), R51.2
unnamed: D50.2 (A), R80.2
unnamed: D51.2 (A), R81.2
unnamed: D52.2 (A), R82.2
unnamed: D53.2 (A), R83.2
unnamed: D54.2 (A), R84.2
unnamed: D55.2 (A), R85.2
unnamed: Q1.1 (G), R60.2
unnamed: Q2.1 (G), R61.2
unnamed: Q3.1 (G), R62.2
unnamed: Q4.1 (G), R63.2
unnamed: Q5.1 (G), R64.2
unnamed: Q6.1 (G), R65.2
RELC_A: D40.2 (A), D50.1 (K), K1.A2, Q1.3 (D)
RELC_B: D41.2 (A), D51.1 (K), K2.A2, Q2.3 (D)
RELC_C: D42.2 (A), D52.1 (K), K3.A2, Q3.3 (D)
RELC_D: D43.2 (A), D53.1 (K), K4.A2, Q4.3 (D)
RELC_E: D44.2 (A), D54.1 (K), K5.A2, Q5.3 (D)
RELC_F: D45.2 (A), D55.1 (K), K6.A2, Q6.3 (D)
REL_A: R60.1, R70.1, U21.1 (PD3)
REL_B: R61.1, R71.1, U21.2 (PD4)
REL_C: R62.1, R72.1, U21.9 (PD5)
REL_D: R63.1, R73.1, U21.10 (PD6)
REL_E: R64.1, R74.1, U21.11 (PD7)
REL_F: R65.1, R75.1, U21.12 (PB0)
RS232_RX: J50.1, U20.13 (R1IN)
RS232_TX: J50.2, U20.14 (T1OUT)
V24: D40.1 (K), D41.1 (K), D42.1 (K), D43.1 (K), D44.1 (K), D45.1 (K), K1.A1, K2.A1, K3.A1, K4.A1, K5.A1, K6.A1, R80.1, R81.1, R82.1, R83.1, R84.1, R85.1; also elsewhere on the board
VSN: C23.1, U20.6 (VS-)
VSP: C22.1, U20.2 (VS+)
XTAL1: C33.1, U21.7 (XTAL1/PB6), Y1.3
XTAL2: C34.1, U21.8 (XTAL2/PB7), Y1.1

Notes on the sheet:
RS232 RELAY BANK. SendSerial("A").."F" on, "a".."f" off - the same
protocol as the board in service, so existing macros keep working.
RS232 AND MCU
The ATmega arrives blank: program it through J60 with a USBasp
(firmware/build.sh flash), which also sets the fuses for the 16 MHz
crystal Y1: low FF, high D9, extended FD. The factory fuses select the
internal RC, which is trimmed only to 10 percent. Serial is 9600 8N1.
SIX RELAYS - 24 V COILS ONLY
The contacts switch 24 V Finder coils. Nothing on this board touches
mains. A Finder coil is 20-60 mA, so a 10 A contact is heavily derated.

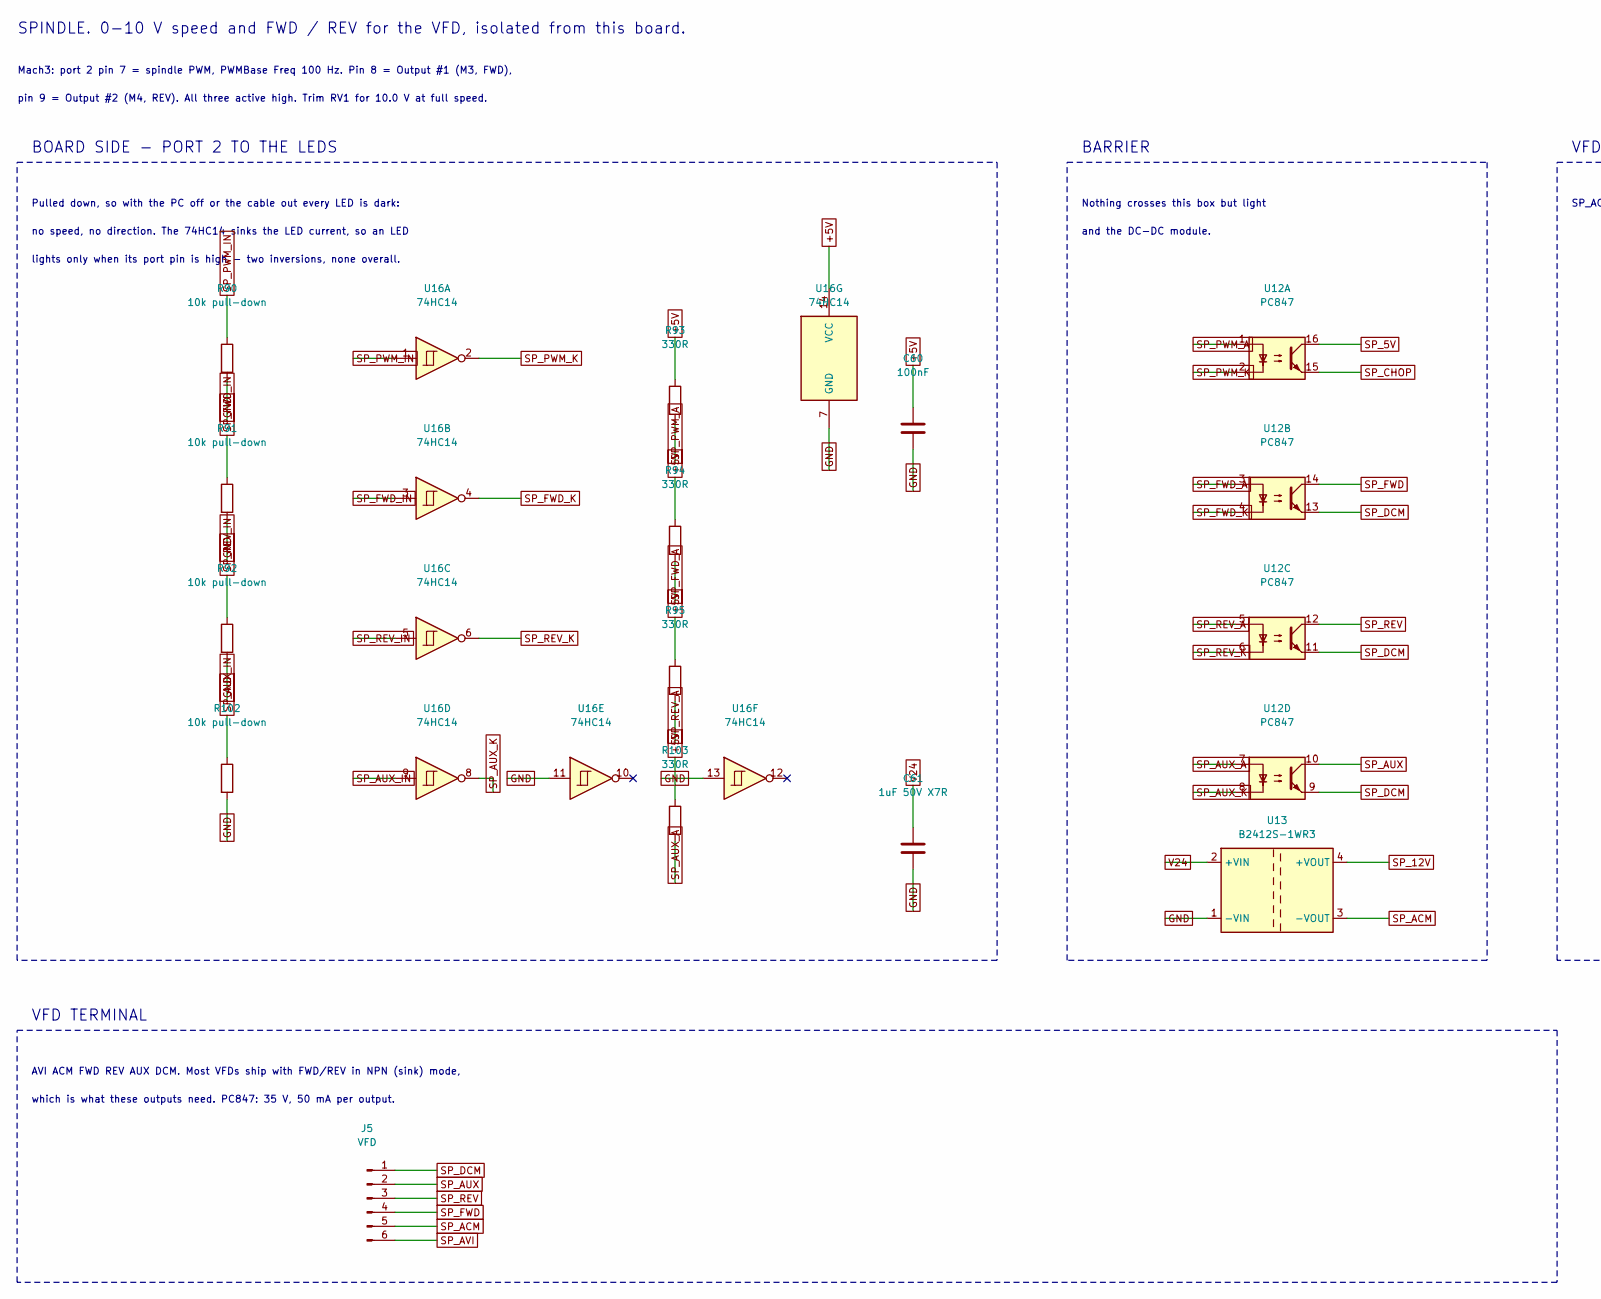
[picture p42: schematic 05_spindle.kicad_sch, Spindle - isolated 0-10 V and FWD-REV for the VFD, part in row 1, column 1]

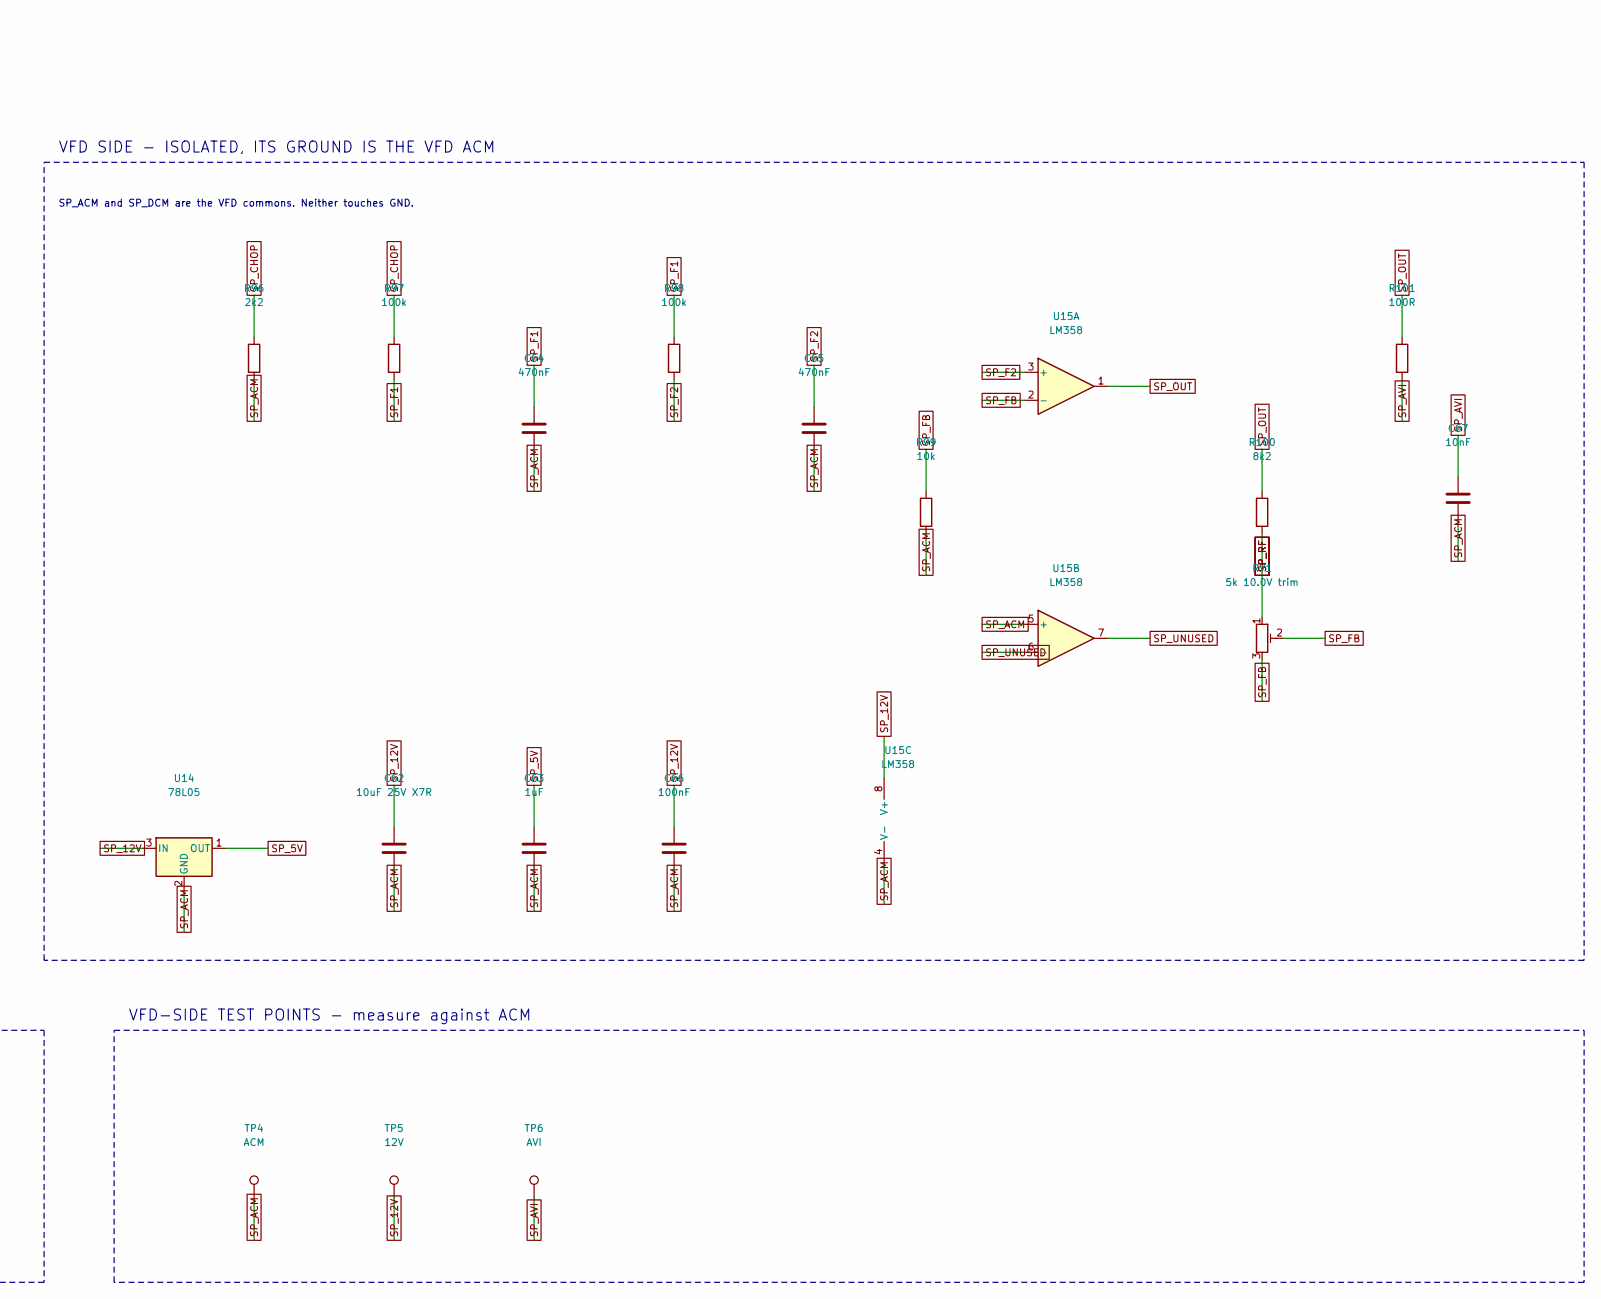
[picture p43: schematic 05_spindle.kicad_sch, Spindle - isolated 0-10 V and FWD-REV for the VFD, part in row 1, column 2]

Parts:
C60, C66: 100nF; C_0603_1608Metric
C61: 1uF 50V X7R; C_1206_3216Metric
C62: 10uF 25V X7R; C_1206_3216Metric
C63: 1uF; C_0603_1608Metric
C64, C65: 470nF; C_0603_1608Metric
C67: 10nF; C_0603_1608Metric
J5: VFD; TerminalBlock_Phoenix_MKDS-1,5-6_1x06_P5.00mm_Horizontal
R90, R91, R92, R102: 10k pull-down; R_0603_1608Metric
R93, R94, R95, R103: 330R; R_0603_1608Metric
R96: 2k2; R_0603_1608Metric
R97, R98: 100k; R_0603_1608Metric
R99: 10k; R_0603_1608Metric
R100: 8k2; R_0603_1608Metric
R101: 100R; R_0603_1608Metric
RV1: 5k 10.0V trim; Potentiometer_Bourns_3296W_Vertical
TP4: ACM; TestPoint_THTPad_D2.0mm_Drill1.0mm
TP5: 12V; TestPoint_THTPad_D2.0mm_Drill1.0mm
TP6: AVI; TestPoint_THTPad_D2.0mm_Drill1.0mm
U12: PC847; SMDIP-16_W9.53mm
U13: B2412S-1WR3; Converter_DCDC_Murata_CRE1xxxxxxSC_THT
U14: 78L05; SOT-89-3
U15: LM358; SOIC-8_3.9x4.9mm_P1.27mm
U16: 74HC14; SOIC-14_3.9x8.7mm_P1.27mm

Connections:
+5V: C60.1, R93.1, R94.1, R95.1, R103.1, U16.14 (VCC); also elsewhere on the board
GND: C60.2, C61.2, R90.2, R91.2, R92.2, R102.2, U13.1 (-VIN), U16.7 (GND), U16.11, U16.13; also elsewhere on the board
SP_5V: C63.1, U12.16, U14.1 (OUT)
SP_12V: C62.1, C66.1, TP5.1, U13.4 (+VOUT), U14.3 (IN), U15.8 (V+)
SP_ACM: C62.2, C63.2, C64.2, C65.2, C66.2, C67.2, J5.5, R96.2, R99.2, TP4.1, U13.3 (-VOUT), U14.2 (GND), U15.4 (V-), U15.5 (+)
SP_AUX: J5.2, U12.10
SP_AUX_A: R103.2, U12.7
SP_AUX_IN: R102.1, U16.9; also elsewhere on the board
SP_AUX_K: U12.8, U16.8
SP_AVI: C67.1, J5.6, R101.2, TP6.1
SP_CHOP: R96.1, R97.1, U12.15
SP_DCM: J5.1, U12.9, U12.11, U12.13
SP_F1: C64.1, R97.2, R98.1
SP_F2: C65.1, R98.2, U15.3 (+)
SP_FB: R99.1, RV1.2, RV1.3, U15.2 (-)
SP_FWD: J5.4, U12.14
SP_FWD_A: R94.2, U12.3
SP_FWD_IN: R91.1, U16.3; also elsewhere on the board
SP_FWD_K: U12.4, U16.4
SP_OUT: R100.1, R101.1, U15.1
SP_PWM_A: R93.2, U12.1
SP_PWM_IN: R90.1, U16.1; also elsewhere on the board
SP_PWM_K: U12.2, U16.2
SP_REV: J5.3, U12.12
SP_REV_A: R95.2, U12.5
SP_REV_IN: R92.1, U16.5; also elsewhere on the board
SP_REV_K: U12.6, U16.6
SP_RF: R100.2, RV1.1
SP_UNUSED: U15.6 (-), U15.7
V24: C61.1, U13.2 (+VIN); also elsewhere on the board

Notes on the sheet:
SPINDLE. 0-10 V speed and FWD / REV for the VFD, isolated from this board.
Mach3: port 2 pin 7 = spindle PWM, PWMBase Freq 100 Hz. Pin 8 = Output #1 (M3, FWD),
pin 9 = Output #2 (M4, REV). All three active high. Trim RV1 for 10.0 V at full speed.
BOARD SIDE - PORT 2 TO THE LEDS
Pulled down, so with the PC off or the cable out every LED is dark:
no speed, no direction. The 74HC14 sinks the LED current, so an LED
lights only when its port pin is high - two inversions, none overall.
BARRIER
Nothing crosses this box but light
and the DC-DC module.
VFD SIDE - ISOLATED, ITS GROUND IS THE VFD ACM
SP_ACM and SP_DCM are the VFD commons. Neither touches GND.
VFD-SIDE TEST POINTS - measure against ACM
VFD TERMINAL
AVI ACM FWD REV AUX DCM. Most VFDs ship with FWD/REV in NPN (sink) mode,
which is what these outputs need. PC847: 35 V, 50 mA per output.

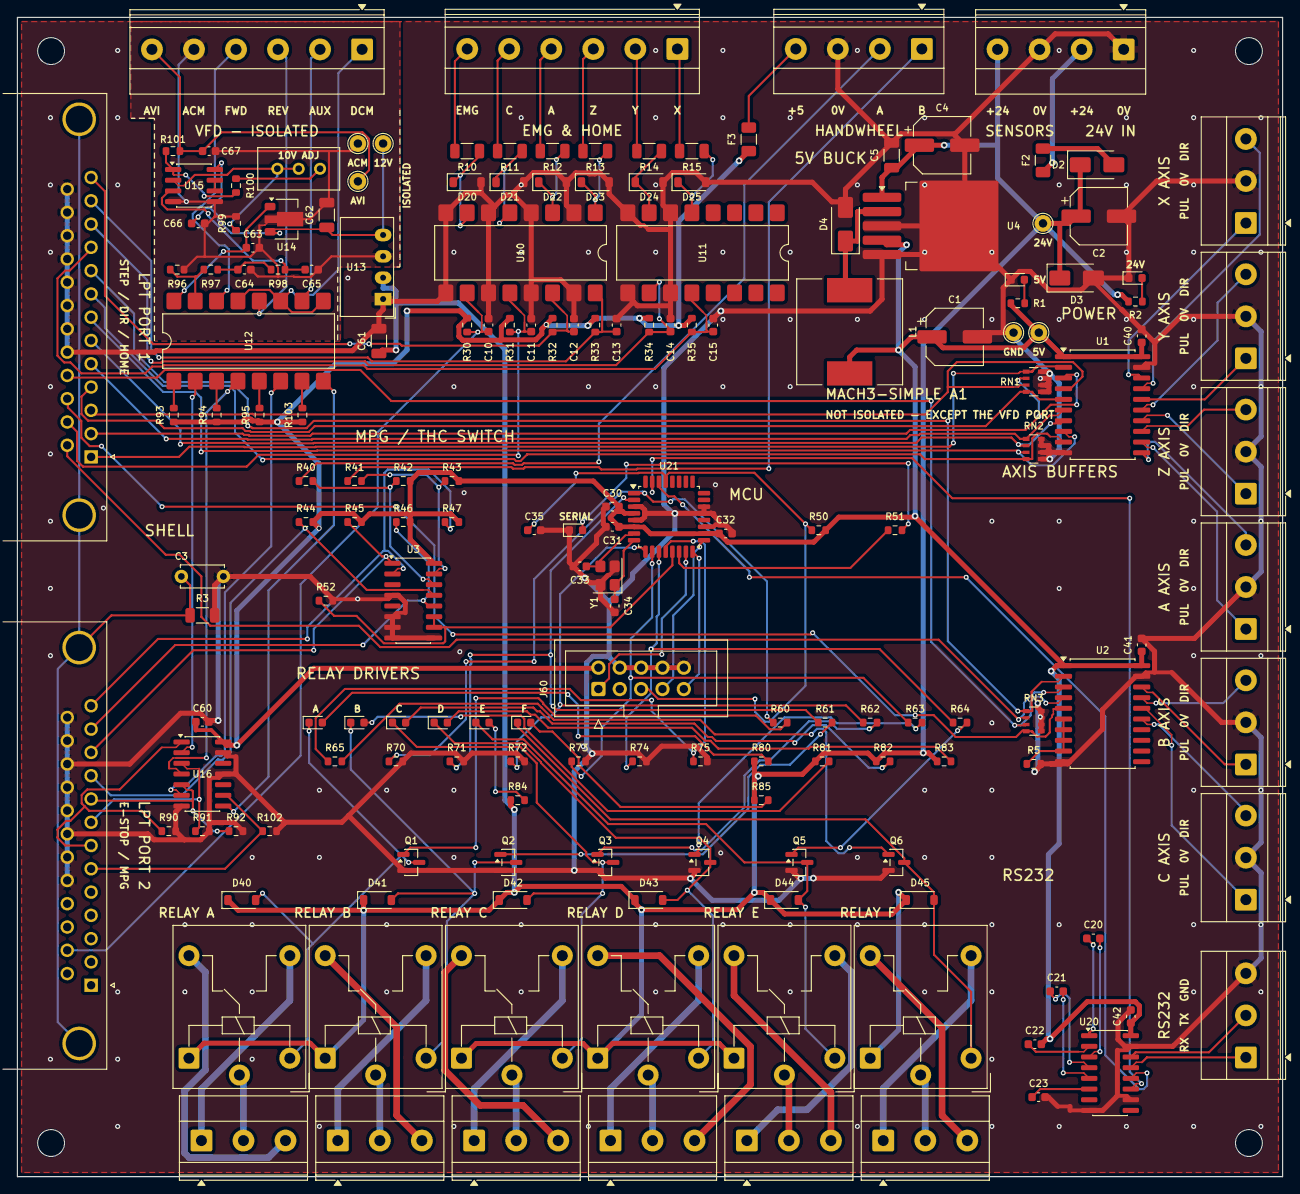
[picture p44: board MACH3SIMPLE.kicad_pcb from above]

Board: 2 copper layers, 150.5 x 137.9 mm, 178 parts (0 on the bottom side), 149 nets.
