moein98/heimdall/(commit log)

2026-09-24 Import MACH3-SIMPLE A0 as received
    The KiCad 10 project, firmware, tools and fab outputs exactly as uploaded,
    so the A1 changes that follow show as a diff against it.
    Claude-Session: https://claude.ai/code/session_01MByiLT2xCcbGPkgCYQy33q
    [01_power.kicad_sch, 02_outputs.kicad_sch, 03_inputs.kicad_sch, 04_relays.kicad_sch, BOM.csv, MACH3SIMPLE-BOM.csv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]
2026-09-24 MACH3-SIMPLE A1: on-board 5 V, isolated VFD port, four A0 fixes
    Power: the 5 V input terminal is gone. An LM2596S-5.0 buck makes +5V from
    V24, and the whole supply sits in the top-right corner beside the 24 V
    terminal, away from the MCU crystal and the port lines.
    Spindle: new J5 (AVI ACM FWD REV DCM). Port 2 pins 7/8/9 go through a
    74HC14 to a PC847; the VFD side runs from a B2412S isolated module with a
    78L05 reference, a two-pole RC filter and an LM358 trimmed to 10.0 V. It
    has its own SP_ACM pour, and the board is routed in two passes so no
    board-side copper enters it; autoroute.py barrier checks that and fab.sh
    refuses Gerbers without it.
    Fixes to A0:
    - Q1-Q6 had drain and source swap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
    [01_power.kicad_sch, 02_outputs.kicad_sch, 03_inputs.kicad_sch, 04_relays.kicad_sch, 05_spindle.kicad_sch, BOM.csv, MACH3SIMPLE-BOM.csv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]
2026-09-25 MACH3-SIMPLE A1: design-review fixes and options
    - Relay terminals labelled: RELAY A-F and NO/COM/NC per screw on the back
    silkscreen, RELAY A-F on the front (were on F.Fab only, not printed).
    - R80-R85 4k7 -> 10k: 103 mW in a 100 mW 0603 on 24 V.
    - Axis buffers fitted as 74AC245 (same pads) for opto-input drivers.
    - J4 is 4-way: fused +24/0V for the sensors beside +24/0V in.
    - C2 47 uF 50 V: 100 uF 50 V is not made in 6.3 x 7.7.
    - Function labels (5V, 24V, SERIAL, A-F, 10V ADJ), test points GND/5V/24V
    and ACM/12V/AVI, dashed ISOLATED line round the VFD side, MCU heading
    moved beside the MCU.
    - Buck switch node hand-drawn and locked: 14 mm top layer, no vias.
    - F3 200 mA PTC on the han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
    [01_power.kicad_sch, 02_outputs.kicad_sch, 03_inputs.kicad_sch, 04_relays.kicad_sch, 05_spindle.kicad_sch, BOM.csv, MACH3SIMPLE-BOM.csv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]
2026-09-25 MACH3-SIMPLE-ETH draft 0: architecture, 8-axis pin map, grblHAL build
    Start the Ethernet successor to MACH3-SIMPLE: an RP2350B runs grblHAL on the
    board (8 independent coordinated axes, W5500 Ethernet), replacing both LPT
    ports, the ATmega328P and RS232. Keeps A1's 24 V supply, opto inputs,
    relays and isolated VFD port; adds RS485 Modbus, SD card and a web UI.
    - docs/SPEC.md: design, all-48-GPIO pin map, circuit notes (3.3 V logic
    needs 74ACT245/74HCT14, logic-level relay FETs), licences, next steps.
    - firmware/grblHAL: board map, my_machine.h patch, and build.sh that
    builds the pinned grblHAL RP2040/RP2350 driver. Verified in the build:
    N_MOTORS 8, MPG on UART1 (GP42/43), Modbus on U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
2026-09-25 MACH3-SIMPLE-ETH: schematic ETH-0, checked against the grblHAL pin map
    Eight generated sheets (tools/build_project.py, A1's schgen/kilib):
    power (A1 24 V input and buck, AP7361C 3.3 V, USB VBUS), RP2350B core
    (internal regulator, 12 MHz, W25Q128, USB-C, SWD, microSD), W5500 with
    HR911105A magjack, 3x 74ACT245 for 8 axes + enable, 15 PC847 inputs,
    MCP23017 + six A1 relays, the A1 isolated VFD block behind a 74HCT14, and
    RS485 + a 3.3 V ATmega328P for the MPG pendant. 337 parts, 291 nets.
    RP2350/W5500 circuits follow WIZnet's W5500-EVB-Pico2 reference and the
    Raspberry Pi minimal design; RP23CNC was read for the 3.3 V-to-ACT approach.
    tools/validate.sh: ERC 0 errors, with "multiple net names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
    [01_power.kicad_sch, 02_mcu.kicad_sch, 03_ethernet.kicad_sch, 04_outputs.kicad_sch, 05_inputs.kicad_sch, 06_relays.kicad_sch, 07_spindle.kicad_sch, 08_comms.kicad_sch]
2026-09-25 MACH3-SIMPLE-ETH: grblHAL simulator tests for 8 axes, over TCP
    grblHAL Simulator built with N_AXIS=8, driven over its TCP port as a UI
    would be. run_tests.py: 12/12 in three runs - [AXS:8:XYZABCUV], per-axis
    settings for all 8, one coordinated block on all 8 axes (worst progress
    spread 0.025 %), G2 arc with A/U riding along, $J= jog on U/V, malformed
    line refused, feed hold/resume, a 135-line streamed program.
    hold_test.py: after feed hold and resume, the non-dominant axis ends 1-3
    steps short in 8 of 12 runs; a 3-axis build does the same, so it is not the
    8-axis configuration. Core or simulator stepper emulation - to be checked on
    hardware by counting STEP pulses. Documented in firmware/si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
2026-09-25 MACH3-SIMPLE-ETH: board placement and two-pass routing tools
    build_pcb.py (pcbnew): 210 x 155 mm, 4 layers (In1.Cu a GND plane layer),
    screw terminals on the edges as A1, RJ45/USB/SD on the left, hand-placed
    ICs and connectors, every other part auto-placed on a spiral round the pads
    it connects to. The isolated VFD corner is a zone with 1.5 mm barrier
    strips; a pad-level check proves every VFD-side pad is inside and every
    other pad 1.5 mm clear (U703's own pin pitch excepted). Footprints carry
    their library id and symbol path: schematic parity 0.
    autoroute.py: pass 1 routes the board with the corner kept out and the
    VFD pads unnetted; pass 2 routes the VFD side fenced by the barrier; silk
    p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
2026-09-25 MACH3-SIMPLE-ETH: placed board (unrouted), placement DRC report
    Placement only: 337 footprints, no courtyard overlaps, barrier clean,
    schematic parity 0. Routing in progress.
    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
    [MACH3SIMPLEETH.kicad_pcb]
2026-09-25 MACH3-SIMPLE-ETH: 0.3 mm class for 3.3/1.1 V rails, keepout clear of U703
    First pass-1 route stalled at 165 unrouted with 185 constant violations:
    +3V3/+1V1 were in a 0.6 mm class that cannot land on the RP2350B's 0.2 mm
    QFN pads, and the pass-1 keepout covered U703's V24 pin. Supply rails that
    end on fine-pitch pads now get their own 0.3 mm / 0.15 mm class; the
    keepout is split round U703.
    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
    [MACH3SIMPLEETH.kicad_pcb]
2026-09-25 MACH3-SIMPLE-ETH: bypass caps under the RP2350B/W5500 on the back, 2 mm clear ring
    The previous route stalled at 110 unrouted: the auto-placer had put the
    fine-pitch chips' bypass capacitors against their pins on the top, walling
    in the GPIO. Those capacitors now go on the back under the chip, nothing
    on the top comes within 2 mm of U201/U301, and the 24 V input chain is
    fixed in line under J101.
    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
    [MACH3SIMPLEETH.kicad_pcb]
2026-09-25 MACH3-SIMPLE-ETH: routing pass 1 imported and filled
    Freerouting pass 1 (board nets, VFD corner kept out): 1 h 40 min, 40
    passes. After the zone fill 44 connections remain: 29 on the VFD side
    (pass 2's job) and 15 others - 7 GND pins inside the RP2350B/W5500 fanout,
    3 CHASSIS, 3 VBUS, 2 +3V3. Most of the 91 Freerouting reported were GND
    pads that reach the ground pours once they are filled.
    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
    [MACH3SIMPLEETH.kicad_pcb]
2026-09-25 MACH3-SIMPLE-ETH: bare mounting holes, VBUS/CHASSIS parts moved to their connectors
    After pass 2, 16 connections were left. Three were CHASSIS between the
    corner mounting holes, which needed a track round the whole board edge:
    the holes are bare now, as on A1, and the shield bond is at the magjack and
    USB. Three were VBUS, because the auto-placer had put D104 in the middle
    of the board. tools/autoroute.py fixup brings the routed board up to the
    regenerated schematic (paths, holes), moves D104/C108/R104 next to the pads
    they serve, clears the tracks they now sit on, and adds In2 ground pours so
    stitching vias can land in ground on every layer. Parity 0.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
    [01_power.kicad_sch, 02_mcu.kicad_sch, 03_ethernet.kicad_sch, 04_outputs.kicad_sch, 05_inputs.kicad_sch, 06_relays.kicad_sch, 07_spindle.kicad_sch, 08_comms.kicad_sch]
2026-09-25 MACH3-SIMPLE-ETH: routing pass 3 imported; point-to-point repair router
    Pass 3 (leftovers, existing tracks locked) leaves 12 open connections:
    6 GND (mostly pour islands, for stitching), 3 VBUS at the USB-C, 2 +3V3,
    1 SP_FB. Parity 0. tools/route_one.py (not yet run): grid A* on F/In2/B
    between the exact two items DRC names for each open connection.
    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
    [MACH3SIMPLEETH.kicad_pcb]
2026-09-25 MACH3-SIMPLE-ETH: repair router - GND pins may drop a via to In1; 0.15 mm clearance
    The first repair run left four fine-pitch pins open. GND pins now finish
    by dropping a via into the In1 plane; repairs use 0.2 mm track and 0.15 mm
    clearance (Power class clearance 0.2 -> 0.15; JLC 4-layer is 0.09).
    The earlier run's edits were never saved: the KiCad container runs as a
    non-root user by default and could not write the board; it now runs as root.
    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
    [build_pcb.py, route_one.py]
2026-09-25 MACH3-SIMPLE-ETH: repair run closes 5 more (saved this time)
    +3V3 10.6 mm, U301 pin 3 GND via to In1, RV701 SP_FB, VBUS J201 A4-A9 and
    D104-J201. Left: U201 pins 29 (+3V3) and 62 (GND), U203 pin 5 (VBUS).
    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
    [MACH3SIMPLEETH.kicad_pcb]
2026-09-25 MACH3-SIMPLE-ETH: repair router falls back to any unjoined copper of the net
    When the item DRC names is out of reach, aim at any copper of the same net
    that is not already joined to the source (flood fill over touching items),
    e.g. another IOVDD pin or the exposed pad through the free ring inside a
    QFN's pad rows.
    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
2026-09-25 MACH3-SIMPLE-ETH: ignore KiCad lock files
    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
2026-09-25 MACH3-SIMPLE-ETH: repair router starts at the pin; cleanup of stray vias
    Two GND repairs had started from the already-connected end and dropped a
    via next to copper that was on the plane already, leaving the pin open.
    Repairs now start at the U/J pin; holes get 0.1 mm more margin; duplicate
    and dangling vias are removed; the VBUS repair too close to J201's hole is
    taken up to be routed again.
    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
    [MACH3SIMPLEETH.kicad_pcb]
2026-09-25 MACH3-SIMPLE-ETH: route_one keeps removed items referenced (segfault fix)
    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
    [route_one.py]
2026-09-25 MACH3-SIMPLE-ETH: rip-up mode for the three pins the A* cannot escape
    Straight hand routes inside the U201/U301 pad rings were tried and shorted
    (+3V3 to Y_LIM and B_DIR3, GND to ETH_RXN and SPI_SCK): Freerouting had
    already used that space. They are removed; the board is back to 9 open
    connections, no shorts, parity 0. route_one.py ripup takes up other nets'
    F.Cu segments within 1 mm of U201.29, U201.62 and U301.3, routes the pin,
    and leaves the ripped nets for the next normal run.
    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
    [route_one.py]
2026-09-25 MACH3-SIMPLE-ETH: board snapshot during the rip-up repair run (intermediate)
    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
    [MACH3SIMPLEETH.kicad_pcb]
